fshanhuan/Rsic-v-IM/syn/上板改造说明.md

# v9 上板改造说明（可综合化 / 时序 / 约束）

> 本文档面向「把 v9 真正放到 FPGA 板上跑起来」这一目标。
>
> **状态更新（本次改造后）**：P0 存储时序、P1 时序化 MDU 接入、P2 复位同步释放、
> P3 程序载入、P4 上板可观测性 **都已在 RTL 与 `board/` 里落地**，
> 并用 `sim/` 的 iverilog 回归（`prog` 35/35、`prog_mul` 34/34、`prog_div` 34/34，
> 加 `+no_wbu_force +raw_rf` 同样全过）+ D-Cache 单元测试作为护栏。
> 逐模块 I/O、关键信号与改造清单见 [`../docs/模块说明.md`](../docs/模块说明.md)。
> **仍未完成（本机无条件）**：真实综合/实现（LUT/FF/BRAM/DSP、WNS/TNS/Fmax）、
> BRAM IP 推断、板级实测、以及原 `cdp-tests` 的 47 条全指令表 difftest（缺 verilator/make）。
> 本文 §1 保留改造前的实测数据与踩坑记录，§3 每节都标了现在的状态。

---

## 1. 已完成的改造

### 1.1 综合与时序瓶颈定位

原 `v9/rtl/MDU.sv` 把 RV32M 的乘除法全部实现为**单拍纯组合**逻辑：

- 乘法：3 个 32×32 乘法器各自展开；
- 除法：32 级「左移-试减-回写」恢复余数法组合链。

实测（Yosys + Xilinx 7 系列映射，见 `syn/synth_report.md`）：

| 实现 | LC 估算 | CARRY4 | DSP48E1 | FF |
| --- | --- | --- | --- | --- |
| 原组合版 MDU | **2150** | **419** | 12 | 0 |
| 时序化版 MDU（`experimental/MDU_pipelined.sv`） | **407** | **81** | 12 | 235 |

也就是说：**只改 MDU 一个模块，就把它的逻辑规模压到约 1/5，进位链长度压到约 1/5**。
这是整机时序收敛里性价比最高的一刀。

### 1.2 已交付的工程件

| 文件 | 作用 |
| --- | --- |
| `syn/synth_core.ys` | 厂商无关综合 + 资源报告脚本（Yosys），一条命令出数 |
| `syn/v9.xdc` | Vivado 时序约束模板（主时钟 20ns=50MHz / 复位 / 调试口） |
| `syn/v9.sdc` | 通用 SDC 约束模板（Quartus 等），与 xdc 同为 20ns=50MHz |
| `syn/timing_sweep.tcl` | 时钟周期扫描脚本，用于测出「实际能跑到多少 MHz」 |
| `syn/vivado_50mhz_实测.md` | **Vivado 2025.2 真实综合/实现实测**（资源、WNS、踩坑记录） |
| `syn/ila_使用说明.md` | **ILA 上板调试方案**：EES-331 引脚表、13 根探针、Hardware Manager 用法、实测坑记录 |
| `syn/工程打开是黑的_排查与正确用法.md` | **为什么工程在 GUI 里是灰的**：工程模式 / 非工程模式混用的后果，以及正确用法 |
| `syn/上板验证判据.md` | **上板时怎么判定"正常"**：`prog.hex` 14 条指令的预期写回值表、LED 心跳灯判读、四个单点必查、症状 → 根因速查 |
| `board/board_top_vivado.sv` | Vivado 顶层外壳（引脚引出方案，**已废弃**）：4 个 32 位计数器截成 8 位，省 96 个引脚 |
| `board/board_top_ila.sv` | 上板顶层（MMCM 100→50MHz + CPU + 存储器），引出 3 个引脚和 13 个调试口 |
| `E:\FPGA\v9_vivado_ila\project_src\board_top_gui.sv` | **工程模式顶层**：例化 `board_top_ila` + 标准 ILA IP `u_ila_0` |
| `syn/synth_report.md` | 实测资源报告（本机 Yosys 输出） |
| `experimental/MDU_pipelined.sv` | 时序化 MDU（模块级 4968 向量已验证，**已接入 `EXU`**） |
| `board/sync_mem.sv` / `board/reset_sync.sv` / `board/board_top.sv` | 同步 BRAM 模型（1 拍读延迟）、复位同步释放、上板顶层 |
| `sim/` | 自包含 iverilog 测试台 + 三个程序 + 单元测试（本机唯一可跑的回归） |
| `docs/模块阅读文档.md` | 逐模块 I/O / 关键信号 / 模块间联系 / 改造清单 |

### 1.3 一个已知的仿真陷阱（已在本工程中踩到并修复）

原 `rtl/MDU.sv` 中若写成「在同一个 `always_ff` 里先给 `op_a` 赋值、再用
`op_a` 派生出的连线去装载另一个寄存器」：

```systemverilog
op_a <= d1;
r_rem <= a_abs;      // a_abs = f(op_a) —— 这里读到的是 op_a 的旧值！
```

综合结果本身没错（工具会正确解析），但**仿真会静默出错**。
凡是「同一个时序块内，用刚被赋值的寄存器去驱动另一个寄存器」，都必须改成
直接用输入端口或重新计算。这一条在后续任何改造里都要留意。

---

## 2. 实测综合数据（本机复现）

环境：Yosys 0.33（Ubuntu 包，无需 root，`apt-get download yosys yosys-abc` 解包即可），
映射目标 `synth_xilinx -family xc7`，**未使用器件专用 BRAM/DSP 推断选项**。

```
v9 整机（myCPU，xc7 代表工艺）
  LUT      : 8218
  MUXF7/8  : 1463
  FF       : 5589
  CARRY4   : 521
  DSP48E1  : 12
  RAM 原语 : 128
```

> 说明：这些是**厂商无关的规模估算**，不等于 Vivado/Quartus 的最终数字
> （真实工具会做 BRAM/DSP 推断与更好的资源共享，数字通常更小）。
> 它的价值在于：**可复现、可对比**，用于判断一次 RTL 改动是让设计变大还是变小。

`CARRY4 = 521` 与 `DSP48E1 = 12` 提示两个方向：
- 进位链数量偏高，主要来自 IDU 的立即数/地址加法与 CSR 比较；
- 12 个 DSP 来自 MDU 的 3 个 32×32 乘法器（每个约占 3~4 个 DSP48）。

---

## 3. 上板待办清单（按优先级）

### P0：存储时序（最大的拦路虎）—— **已完成**

**改造前现状**：整机的 IROM 与 DRAM 都假设**零延迟组合读**。

- `rtl/ICache.sv` / `rtl/DCache.sv` 在 miss 时直接「旁路」外部读数据：
  ```systemverilog
  assign cpu_rdata = hit ? data[index] : mem_rdata;   // 假设 mem_rdata 同拍有效
  ```
- `mySoC/miniRV_SoC.v` 里 `IROM` 是 `$readmemh` 组合 ROM，`dram_driver.sv`
  也是组合读。
- `IFU` 的 `valid` 恒为 1，没有任何「等存储」的暂停通路。

**为什么上板必炸**：FPGA 的 Block RAM 是**同步读**（地址打一拍、数据下一拍才出），
分布式 RAM 也至少一拍。也就是说真实存储器不可能同拍返回数据。

**改造完成情况**（对照原步骤）：

1. ✅ `ICache`/`DCache` 改成**同步读握手**：
   - `ICache`：`resp_valid_r`（响应有效）`addr_same_r`（地址仍是当前请求）
     `fetch_align`（本拍返回结果是否属于当前请求）`hold = ~fetch_align | miss`；
   - `DCache`：同样握手 + store 请求寄存成**单拍写脉冲**（一次 store 只写一次，
     否则同步 DRAM 保持使能多拍会重复写）+ MMIO/uncacheable 地址**不经缓存直通**
     （否则读不到外设副作用、写不进外设）；
   - 未命中时返回 `` `NOP `` 并拉高 `hold`，前端/LSU 停拍重试。
2. ✅ miss/hold 引出为暂停请求并**合并**：
   - `myCPU.IFU_stall = IFU_stall_ctrl | icache_hold | dcache_hold`（冻 PC 与 IDU）；
   - `myCPU.IFU_mem_stall = icache_hold | dcache_hold`（参与 `IFU.valid` 与 `EXU_inst_clear`）；
   - `LSU.lsu_freeze = mem_hold | mdu_busy`（整条访存流水**同步冻结**，否则
     `mem_ren_reg_pipe` 会被推走、`DCache.cpu_en` 组合来源随之变化，hold 自己把自己解掉）。
3. ✅ `board/sync_mem.sv` 提供一拍读延迟的同步 BRAM 行为模型，`board_top.sv` 用它
   例化 IROM/DRAM；上板时替换成 `xpm_memory_*`/IP 即可。
4. ✅ 护栏换成 `sim/` 的 iverilog 回归（47 条 difftest 需要 verilator/make，本机没有）。

**改造中暴露并修掉的 4 个真实 RTL 缺陷**（都是"仿真-friendly 假设"的产物，2 态工具看不到）：

| # | 现象 | 根因 | 修法 |
|---|---|---|---|
| 1 | `lw` 后紧跟的 `add` 得到 `0x1005`（= 地址 + 5） | EXU 级若是 load，`EX_result` 是**地址**；`Data_hazard.exu_hit` 只看 `R_Wen`/`rd` 且优先级最高 | `exu_hit` 加 `~EXU_mem_ren`；load 的数据只在 LSU **第三级**（`forward_val_wb`）才是数据 |
| 2 | 第一次重定向后整机死循环（`ecall` 永远到不了 WB） | `bp_mispredict` 是电平信号，EXU 被存储 hold 冻住时会**连环重定向**；且 EXU 的 `valid` 与控制寄存器是两个 `always_ff`，`valid=0` 时残留的 `jump_flag/pred_*` 还在产生重定向 | 加 `bp_redirect_pending` 做**一次性脉冲**；控制事实全部用 `EXU_valid` 限定 |
| 3 | `ecall` 不产生异常（`mepc/mcause` 恒 0） | `EXU_inst_clear` 里含 `system_redirect`，会在 `ecall` 被收下的同一拍把它的 `csr_wen` 清 0 | 从 `EXU_inst_clear` 去掉 `system_redirect`：ecall/mret/fence.i 必须自己流到 WB，只冲掉排在它们**后面**的错路径指令（由 `dnpc_flag`→IDU `flush` 完成） |
| 4 | `add x7,x6,x2` 算出正确的 `0x11` 却写不进 x7 | EXU 的 `valid_next` 在**下游未就绪**（`~ready_next`，即 `lsu_freeze`）那一拍走了最后的 `else` 被清 0，而数据/控制寄存器是冻结保持的 → 指令带着 `valid=0` 进 LSU，写回被 `WBU.R_wen_next = R_wen_reg & valid_reg` 掐掉 | `valid_next` 更新条件里把 `mdu_stall` 改成 `mdu_stall | ~ready_next`（与数据寄存器同口径冻结） |

> 另修两个"4 态仿真才暴露"的问题：`myCPU` 里 `WBU` 的 `.stall` **悬空**
> （`z` → `if(!stall)` 判成 x → 写回永不发生）、`RegisterFile` **没有复位分支**
> （`rf[0]`(x0) 初值为 `x`）。

### P1：把时序化 MDU 接入整机 —— **已完成**

`experimental/MDU_pipelined.sv` 已通过 **4968 条向量**的模块级验证
（边界值 968 条 + 随机 4000 条，覆盖除零、INT_MIN/-1 溢出、符号回正），
并且**已经接到 `EXU` 里**（`alu_opcode_reg[4]` 选择 `mdu_res_reg`）。
实测：`prog_mul`（8 次乘法）与 `prog_div`（4 次除法）在 iverilog 回归里全过 ——
乘法 1 拍完成、`stall=0`；除法多拍由 `mdu_busy` 冻结前端与访存流水。

接入时的关键（本工程实测踩过的坑）：

- **乘法路径天然对齐**：单拍完成，与 ALU 结果同拍，不需要暂停。
- **除法路径需要三件事同时做**，缺一就会出现
  「`debug_wb_pc` 正确但 `debug_wb_value` 慢一拍 / 错位 / 为 0」：
  1. `EXU` 在 `mdu_busy` 期间**冻结自身寄存器**（含 `valid`）；
  2. `LSU` 流水寄存器在 `mdu_busy` 期间**同步冻结**（否则会把 EXU 保持的
     陈旧值一级级推下去）；
  3. `EXU.valid_next` 只在**结果窗口**（`mdu_done`）那一拍放行，且该分支必须
     放在 `always_ff` 的**最前面** —— 因为 `mdu_busy` 期间 `exu_ready` 恒为 0，
     放在后面会被 `EXU_inst_clear` 分支挡住，导致 valid 永远为 0（整机卡死）。
- `Control` 中需要把 `mdu_busy` 并入 `IFU_stall`，并在忙期间屏蔽分支/跳转判定
  （此时 EX 级寄存的是刚发射的 M 指令，其残留标志不可信）。
- ⚠️ 本次补充：`mdu_busy` 只能并进 `IFU_stall`，**不能**并进给 IDU 灌气泡的那一路
  （`load_use_stall`）——后者会打断 M 指令自己的向后 `valid`，乘除结果直接丢失
  （实测 `prog_mul` 从全过变成 1 处不符）。

### P2：复位与时钟 —— **代码已就绪**

**现状**：所有模块使用 `always_ff @(posedge clock) if (reset) ...` 的**同步复位**。
对 FPGA 来说这是好习惯，但需要确认：

- 板卡按键复位是异步的 → 必须**先同步释放**（推荐「异步置位、同步释放」两级同步器），
  否则会出现跨时钟/亚稳态与部分寄存器先复位的问题；
  ✅ 已提供 `board/reset_sync.sv`（`rst_n_async` → `rst_sync`），`board_top` 已例化。
- 若使用全局复位网络，注意复位树 fanout 与布线资源。

**时钟**：整机单时钟域即可，无需跨时钟域处理。上板建议先从 **50MHz** 起，
确认功能后按 `syn/timing_sweep.tcl` 逐步收紧到 100/150MHz。
（本机无 Vivado/yosys，实际 WNS/Fmax 需要你在有工具的机器上测。）

> **已实测（Vivado 2025.2 / xc7z020clg484-1）**：
> - 引脚引出方案（已废弃，工程已删）：`WNS = +5.283ns`、失败端点 0，**Fmax ≈ 67.95MHz**。
> - **当前 ILA 方案**（工程 `E:\FPGA\v9_vivado_ila\v9_ila\v9_ila.xpr`）：
>   `WNS = +4.162ns`、`WHS = +0.011ns`、失败端点 **0 / 27564**，
>   **Fmax ≈ 63.14MHz**（ILA 要采样 288 位调试总线，比无 ILA 版低约 4.8MHz）。
>   50MHz 下余量 4.162ns / 20ns ≈ **26%**。
> - 100MHz 目前收敛不了（存在 >10ns 组合通路，且瓶颈是布线不是逻辑）。
>
> 详见 [`ila_使用说明.md`](../docs/vivado/ila_使用说明.md) §7（当前方案）；
> 引脚方案的历史数据见 [`vivado_50mhz_实测.md`](../docs/vivado/vivado_50mhz_实测.md)。

### P3：启动与程序加载 —— **代码已就绪**

**现状**：程序由 `$readmemh`/`meminit.bin` 在仿真开始时塞进 RAM。

**上板方案**：
- ✅ 最小方案已实现：`board/sync_mem.sv` 支持 `$readmemh` 初值（`board_top` 里对
  IROM/DRAM 各传一个 hex），Vivado 会把 `initial` 推断成 BRAM 初值，复位后从 0 起跑；
  本机回归用的程序就是 `sim/prog*.hex`。
- ⏳ 进阶方案（未做）：Boot ROM + UART 下载器 / SPI Flash 启动，实现在板更新程序。

### P4：可观测性（上板替代波形）—— **骨架已就绪**

仿真里靠 VCD 看结果，上板必须换成：

- ✅ `board_top.sv` 已经把 `debug_wb_have_inst/debug_wb_pc/debug_wb_ena/debug_wb_reg/
  debug_wb_value` 以及 `debug_icache_hit_cnt/miss_cnt`、`debug_dcache_hit_cnt/miss_cnt`
  引出到端口，直接接 7 段数码管/LED 即可；
- ⏳ 未做：具体板卡的 7 段译码模块与 UART 打印模块（需要按板卡引脚写，属于工程层）。

### P5：Cache 一致性策略复核 —— **维持现状（单核无问题）**

`DCache` 目前是**写直达 + 写不分配**，并且对 MMIO/uncacheable 区间**直通不缓存**。
上板后若加入 DMA/多主设备，需要重新评估一致性；当前单核场景没问题。

---

## 4. 建议的实施顺序（状态对照）

```
[已完成] 基线回归（原始 v9 在作者机器上 47/47；本机无 verilator/make，见下方说明）
[已完成] 综合脚本 + 约束模板 + 资源报告
[已完成] 时序化 MDU 模块级验证（4968 向量）
   ↓
1. [已完成] 同步 BRAM 化：ICache/DCache + board/sync_mem.sv，护栏用 sim/ 的 iverilog 回归
2. [已完成] 接入时序化 MDU 的乘法路径（单拍，无侵入）
3. [已完成] 接入除法多周期握手（按 §3 P1 三条），prog_mul/prog_div 全过
4. [部分完成] 板级工程：board/ 的复位同步器 + 调试观测口已就绪；
   引脚约束、数码管/UART 需要按你的板卡补
5. [待你在有工具链的机器上做] 时序收敛：50MHz → 100MHz → 150MHz，记录 WNS 与资源
6. [待补] cdp-tests 47 条全指令表 difftest（本机缺 verilator + make）
```

本机实际跑到的验证（可复现，命令在 `sim/README_iverilog.md`）：

```
[prog]     PASS 35/35     (算术 / mul / store+load / load-use 冒险 / 分支 / jal / ecall)
[prog_mul] PASS 34/34     (8 次乘法)
[prog_div] PASS 34/34     (4 次除法，MDU 多拍)
加 +no_wbu_force +raw_rf（不用测试台兜底）→ 同样 103/103 全过
tb_dcache_unit: miss->fill / 二次命中 / MMIO 不缓存 / 外设副作用  全 PASS
```
