fshanhuan/Rsic-v-IM/v9/docs/README.md

# v9 文档索引

上板改造后的 v9，文档按"**先读结论、再读模块、最后读实现细节**"组织：

| # | 文档 | 讲什么 | 什么时候看 |
| --- | --- | --- | --- |
| 1 | [`模块阅读文档.md`](./模块阅读文档.md) | **主文档**：按流水级组织的模块说明（每个模块的输入表/输出表、它在做什么、关键信号作用、关键代码、与其他模块的联系）+ 上板改造的三个必知机制 + 典型指令走查 + 验证方法 + 已知限制 + 一页速查 | 想搞清"这颗 CPU 长什么样、某个信号是干什么的"时 |
| 2 | [`../syn/上板改造说明.md`](../syn/上板改造说明.md) | 上板障碍清单（P0~P5）、每个障碍的**改造前后对照**、改造中暴露并修掉的 6 个 RTL 缺陷、本机做不到的部分 | 想知道"为什么这么改、改完还差什么"时 |
| 3 | [`../CPU设计说明.pdf`](../CPU设计说明.pdf) | 改造**之前**的设计说明（含数据通路图、立即数生成、扩展建议） | 想看原始设计意图时（其中 ICache/DCache 的组合读写法已过时，以主文档为准） |
| 4 | [`../syn/synth_report.md`](../syn/synth_report.md) | Yosys 实测资源报告（MDU 组合版 vs 流水版的 LC/CARRY4/DSP） | 关心面积/时序瓶颈时 |
| 5 | [`../sim/README_iverilog.md`](../sim/README_iverilog.md) | 本机 iverilog 测试台怎么用、plusargs 有哪些、程序期望表 | 要跑回归时 |
| 6 | [`../experimental/README.md`](../experimental/README.md) | 流水化 MDU 的验证情况（4968 条向量） | 要动乘除时 |
| 7 | [`../README.md`](../README.md) | 工程总览、目录、验证命令、波形 | 第一次打开工程时 |
| 8 | `../改动diff_接管前快照_vs_上板改造后.txt`（打包版在 zip 内） | 逐行改动对照（基线 = 改造开始时的快照） | 想知道"到底改了哪几行"时 |

## 推荐阅读顺序

1. 本工程 `README.md`（3 分钟建立全局印象）；
2. `模块阅读文档.md` §0 一页速查 → §1 的 **4 条握手约定**（不读这个直接看代码容易踩坑）；
3. §2~§8 按 `myCPU → 取指 → 译码 → 执行 → 访存 → 写回 → 冒险处理` 顺序看模块；
4. §9 上板改造的三个机制（load 数据只在 M3 可前递 / 重定向要一次性 / 不能靠拉低 valid 挡指令）；
5. §10 典型指令走查（含 load-use 冒险的逐拍波形）；
6. `syn/上板改造说明.md` 看"改了什么、为什么、还差什么"；
7. 要上手改代码就看 §4 改动清单，再对着 `改动diff` 逐行确认。

## 约定

- **命名风格一律不改**：模块名、信号名、`_next`/`_last` 后缀、`valid`/`ready` 语义都保持原样；
  改造新增的端口/信号（如 `load_use_stall`、`EXU_ctrl_valid`、`bp_redirect_pending`、
  `fetch_align`、`hold`）都带中文注释说明用途。
- **两份说明文档的分工**：`CPU设计说明.pdf` = 改造前；`模块阅读文档.md` = 改造后（权威）。
  两者冲突时以 `模块阅读文档.md` 为准。
- 所有通道（VCD、SVG 时序图）都是**改造后**重新生成的；历史调试波形已清理。
