fshanhuan/Rsic-v-IM/验证报告_独立复核.md

# v9 上板改造交付版 · 独立验证报告

> 验证人：独立复核（非交付方）
> 日期：2026-10-06
> 对象：`v9_上板改造_交付版`（RV32IM 教学核 + 上板改造）
> 结论一句话：**官方回归能复现通过，但它覆盖不到关键路径；独立差分测试发现 4 类真实功能缺陷，且交付文档中若干"PASS"声明与实测不符。**
>
> **更新（同日）**：上述缺陷**已全部修复**，并修掉了修复过程中暴露出的另外 3 个缺陷与
> 3 处验证基础设施缺陷。修复后的验收结果见 [§9 修复记录](#9-修复记录第二轮按验收门禁逐项修)：
> **官方回归 15 项全过 / 单轮 239 项检查、板级自检 33/33 PASS、差分测试 60/60、
> 交叉验证 0 处不一致**。第二轮的 7 个缺陷里，有 3 个（B1/B2/B3）在修复后的
> 自带回归中有了**新的定向程序**（`prog_load_lane`/`prog_load_use`/`prog_loop`/`prog_div_pair`），
> 它们在被修之前是必然失败的。

---

## 0. 结论摘要

| # | 项目 | 交付方声明 | 独立验证结果 |
| --- | --- | --- | --- |
| 1 | `bash sim/run_all.sh` | 7 项全过 / 103/103 | ✅ **复现通过**（7 项，正常+严格模式） |
| 2 | 字节/半字访存（`lb/lh/lbu/lhu`） | 回归覆盖 | ❌ **缺陷 B1**：load 的字节偏移被完全丢弃 |
| 3 | load 数据通路 | 回归覆盖 | ❌ **缺陷 B2**：前一条不是访存指令时，load 取到陈旧值/0；真实 BRAM 上变 `x` |
| 4 | RV32M 除法 | 模块级 4968 向量 + 整机回归通过 | ❌ **缺陷 B3**：多拍 `div/rem` 结果与 rd 错位 |
| 5 | 分支预测 / 重定向 | 回归通过 | ❌ **缺陷 B4**：取指 hold 撞上分支判定拍时，taken 分支的误预测被静默屏蔽，**循环提前退出** |
| 6 | `board/tb_board_top.sv` 冒烟 | `README.md:90/108` 写 PASS | ❌ **实测 FAIL（退出码 1）**，3 次运行结果字节一致 |
| 7 | `syn/` 综合脚本可用 | 报告 + 脚本齐备 | ❌ `synth_core.ys` 无法 elaborate（读 `MDU.sv` 而非 `MDU_pipelined.sv`）；`board/*.sv` 从未被任何综合脚本读过 |
| 8 | 约束文件 | XDC/SDC 模板 | ❌ 端口名 `fpga_clk/fpga_rst` 在全部 `*.sv` 中零命中；三处时钟周期互相矛盾 |
| 9 | 板级实测 | 自述"未做" | ✅ 一致：确实没有比特流/综合产物 |
| 10 | 回归第 7 项：D-Cache 单元测试 | 全 PASS | ❌ 该测试**无 `$fatal`**、退出码恒 0，**不可能失败**；且其中一次 store 都未执行（§2.5 V1） |
| 11 | CI 护栏（"每次 push/PR 都跑"） | 自动回归 | ⚠️ 整机回归确实跑，但**板级测试台只编译、从不运行**（`ci.yml:70-79` 无 `vvp`）→ 它 FAIL 也不会被发现（§2.5 V2） |

**没有发现问题的部分**（这些声明可信，见 §4）：官方回归本身可复现；`sb/sh/sw` 写掩码正确；1 拍 `mul/mulh/mulhu/mulhsu` 正确；前向分支/`jal/jalr`/`auipc`/移位/`x0` 恒零正确；`board/sync_mem.sv`、`board/reset_sync.sv` 行为正确。

---

## 1. 验证方法（先说清可信度从哪来）

### 1.1 环境：本机原本没有**免费/开源** EDA 工具

`iverilog / vvp / yosys / verilator` 在 `C:`、`D:`、`E:` 全盘搜索**零命中**；WSL 里 `sudo` 需要密码。

> 第三轮补充更正：本机其实装有商用 **ModelSim SE-64 10.5**（`E:\FPGA\ModelSim_10.5se`）。
> 前两轮只用了 iverilog；第三轮把它接进来后，**立刻发现 7 处 iverilog 全部放过的问题**（见 §10）。

故采用**非 root 安装**（不改动系统、不污染交付目录）：

```bash
# WSL Ubuntu 24.04，x86_64
apt-get download iverilog                       # 非 root 可下载到当前目录
dpkg -x iverilog_12.0-2build2_amd64.deb $HOME/ivlocal
ln -s ../lib/x86_64-linux-gnu/ivl $HOME/ivlocal/usr/x86_64-linux-gnu/ivl   # 补 FHS 路径
export PATH="$HOME/ivlocal/usr/bin:$PATH"
export LD_LIBRARY_PATH="$HOME/ivlocal/usr/lib/x86_64-linux-gnu:$LD_LIBRARY_PATH"
```
得到 `Icarus Verilog version 12.0`。所有仿真都在 `$HOME/` 下的**副本**里跑（交付目录零改动，`git status` 只多出我新增的 `.verify/`）。

### 1.2 三层验证，互相独立

| 层 | 做法 | 目的 |
| --- | --- | --- |
| L1 | 原样复跑 `v9/sim/run_all.sh` | 确认交付方自己的结论可复现 |
| L2 | **自建差分测试**：自写 RV32IM 汇编器 + 独立参考模型 + 自建测试台，逐寄存器/逐内存字比对 | 抓 L1 覆盖不到的行为 |
| L3 | **交叉验证**：把同一批程序喂给**项目自带**的 `tb_iverilog.sv`，看错值是否复现 | 排除"是我的测试台有问题" |
| L4 | **第二仿真器**：同一批程序再喂给商用 ModelSim SE，两个仿真器的 dump 逐字节比对（见 §10） | 排除"结论只是 iverilog 特有的语义解释"；并用严格工具的编译期检查兜底 |

L2 的独立实现要点（也是它为什么能抓到问题）：

- **参考模型**（`.verify/difftest/rv32.py`）：按 RISC-V 手册独立实现 RV32IM 语义（含除零 → 商 `0xFFFFFFFF`、`INT_MIN/-1` → 商 `INT_MIN`/余 0 等边界），按字节小端寻址，与 RTL 的 `addr[15:2]`/`addr[1:0]` 解码等价。
- **汇编器**（两遍、支持 label）：已用工程里**人工核对过**的 `sim/prog.hex` 逐条校准 —— `lui/addi/add/mul/sw/lw/beq/jal/ori/ecall` 14 条编码**全部一致**，避免"我方编码错误"造成假阳。
- **结束条件**：不用 `ecall`（`ecall` 会把 PC 重定向到 `mtvec=0`=程序入口，程序会重跑；自带测试台靠"ecall 进 ID 后再等 8 拍"取快照，排空窗口是否够取决于 ecall 前那条指令的深度，**本身有截断风险**）。改为程序末尾一条 **magic store**（`sw` 到 `0x3FFC`，值 `0x123`）报完工，后接 `jal x0,0` 自跳（只写 `x0`，架构状态从此冻结）；测试台在总线上看到这笔写后再跑 60 拍，然后导出 **32 个 GPR + 全部非零内存字**（用 `!==` 判断，X 传播不会被漏掉）。
- **用例**：17 个定向（含最小化用例）+ N 个随机（带依赖偏置、前向跳转保证终止、指针寄存器隔离保证地址落在安全窗口）。

L3 的关键对照：**`mulchain`（连续 8 条 1 拍 `mul`）在两套测试台上都 PASS** —— 说明方法本身不是"什么都判失败"。

### 1.3 复现命令

```bash
# 生成 + 跑差分测试（N 为随机用例数）
bash .verify/difftest/run.sh 40
# 只跑指定前缀的用例
bash .verify/difftest/run.sh 0 lane
# 交叉验证：同一批程序在项目自带 tb_iverilog.sv 上跑
bash .verify/difftest/crosscheck.sh
# 逐拍 PC/重定向轨迹（定位缺陷 B4 用的）
bash .verify/difftest/trace.sh 55
```

---

## 2. 缺陷清单

### B1 · 字节/半字 load 完全忽略地址偏移（确定性、100% 复现）

**现象**：`lb/lh/lbu/lhu` 永远返回**字内偏移 0** 的那一（半）字节，`addr[1:0]` 被丢弃。

**最小复现**（定向用例 `lane_min`，`.verify/difftest/gen.py`）：

```asm
li  x1, 0x2000
li  x2, 0xDDCCBBAA
sw  x2, 0(x1)        # 内存字 0x2000 = 0xDDCCBBAA
lb  x3, 0(x1)   # 期望 0xFFFFFFAA   实测 0xFFFFFFAA  ✓
lb  x4, 1(x1)   # 期望 0xFFFFFFBB   实测 0xFFFFFFAA  ✗
lb  x5, 2(x1)   # 期望 0xFFFFFFCC   实测 0xFFFFFFAA  ✗
lb  x6, 3(x1)   # 期望 0xFFFFFFDD   实测 0xFFFFFFAA  ✗
lbu x7, 3(x1)   # 期望 0x000000DD   实测 0x000000AA  ✗
lbu x8, 1(x1)   # 期望 0x000000BB   实测 0x000000AA  ✗
lh  x9, 0(x1)   # 期望 0xFFFFBBAA   实测 0xFFFFBBAA  ✓
lh  x10,2(x1)   # 期望 0xFFFFDDCC   实测 0xFFFFBBAA  ✗
lhu x11,2(x1)   # 期望 0x0000DDCC   实测 0x0000BBAA  ✗
lw  x13,0(x1)   # 期望 0xDDCCBBAA   实测 0xDDCCBBAA  ✓
```

原始输出（我的测试台）：

```
FAIL lane_min  (7 处不一致, magic_cyc=108 total_cyc=167)
   x4 (tp  ): rtl=ffffffaa ref=ffffffbb
   x5 (t0  ): rtl=ffffffaa ref=ffffffcc
   x6 (t1  ): rtl=ffffffaa ref=ffffffdd
   x7 (t2  ): rtl=000000aa ref=000000dd
   x8 (s0  ): rtl=000000aa ref=000000bb
   x10(a0  ): rtl=ffffbbaa ref=ffffddcc
   x11(a1  ): rtl=0000bbaa ref=0000ddcc
```

**L3 交叉验证**（项目自带 `tb_iverilog.sv`，同一程序）：`x4=ffffffaa / x5=ffffffaa / x6=ffffffaa / x7=000000aa / x8=000000aa / x10=ffffbbaa / x11=0000bbaa` —— **错值逐位一致**。

**根因（代码级，`v9/LSU.sv`）**：
```verilog
LSU.sv:287   assign rdata_8u  = {24'd0, rdata[7:0]};        // 固定取第 0 字节
LSU.sv:288   assign rdata_16u = {16'd0, rdata[15:0]};       // 固定取低半字
LSU.sv:295-297  sext_i8  (.data(rdata[0+:8]),  ...)         // 同样只看 bit[7:0]
LSU.sv:303-305  sext_i16 (.data(rdata[0+:16]), ...)
LSU.sv:307-337  写回前 res2 级同样只用 rdata_reg2[7:0]/[15:0]，按 funct3 选择
```
**整条读回路径从未使用 `Ex_result_addr_reg_pipe[1:0]`（字节偏移）**。对比之下：写路径的偏移是正确的（`DCache.sv:259-266` 按 `store2_offset` 选道，`d_storelane` 用例全部 PASS），所以这是**只存在于 load 侧**的缺陷。
另外 `tb_iverilog.sv:96-98` 的注释明确写着"读口返回**原始整字**：字节/半字的抽取由 LSU 在写回前按 funct3 完成" —— 即改造后由 LSU 负责抽取，但 LSU 只按 `funct3` 抽取、没有按偏移移位，**偏移这一环在改造中丢了**。

**为什么原回归没抓到**：`prog_mul.hex`(15 行)、`prog_div.hex`(11 行) **完全没有访存指令**；`prog.hex` 只有 1 条 load，且 `lw`/`sw` 都是字对齐、偏移 0，恰好落在唯一正确的情形上。

**修复方向**：在 LSU 抽取前按偏移移位，例如 `rdata_8u = {24'd0, rdata_shifted[7:0]}`，其中 `rdata_shifted = rdata >> (8*addr[1:0])`（半字用 `addr[1]`）；`reg2` 级需把偏移随流水一起带过去（或在 DCache 返回前完成对齐）。

---

### B2 · load 的读回时序 off-by-one：前一条不是访存指令时取到陈旧值/0

**现象**：紧跟在**非访存指令**（或首条访存指令）之后的 load，拿到的是"上一次总线读的残留值"或 0；紧跟另一条访存指令的 load 反而正确（因为 `hold` 恰好把它多停了一拍）。

**最小复现**（定向用例 `loaduse`）：
```asm
li  x1, 0x2400
li  x2, 0x11223344
sw  x2, 0(x1)
lw  x3, 0(x1)     # 期望 0x11223344  实测 0x11223344 ✓（前面是 sw → hold 生效）
add x4, x3, x2    ✓
sub x5, x4, x3    ✓
lbu x6, 0(x1)     # 期望 0x44        实测 0x00000000 ✗（前面是 ALU → hold 不生效）
lh  x8, 2(x1)     # 期望 0x1122      实测 0x00000000 ✗
lw  x10, 0(x1)    # 期望 0x11223344  实测 0x00000000 ✗（x10 错 → 后续 beq 走错路）
```

原始输出：
```
FAIL loaduse  (10 处不一致, magic_cyc=150 total_cyc=209)
   x6 (t1  ): rtl=00000000 ref=00000044
   x8 (s0  ): rtl=00000000 ref=00001122
   x10(a0  ): rtl=00000000 ref=11223344
   x12(a2  ): rtl=00000bad ref=00000000   ← 由 x10 引出的控制流分歧（下游现象）
   ...
```
**L3**：自带测试台上 `x6=00000000 / x8=00000000 / x10=00000000 / x12=00000bad` —— 完全一致。

**另一条独立证据**（`storeload` 用例）：`lw x10, -4(x1)` 读到**另一个地址**的数据（`0x11223344`，即上一次总线读的返回值），期望为 0：
```
FAIL storeload  (2 处不一致)
   x8 (s0  ): rtl=11223344 ref=22446688    ← 连续两条同址 load，其中一条拿到 0
   x10(a0  ): rtl=11223344 ref=00000000    ← 读到上一条 load 的残留数据
```

**根因（代码级）**：
```verilog
DCache.sv:134   assign mem_en = cache_rd_req;
DCache.sv:156   assign hold   = resp_valid_r & ~cpu_wen_r & ~hit & (~mem_req_r | cache_rd_req);
```
`hold` 在**发出读的那一拍恰好为 0**（`cache_rd_req=1` 时靠 `| cache_rd_req` 把 `hold` 解除），于是 LSU 被放行、在数据还没回来的那一拍就把 `rdata` 采进 `rdata_reg2`（`LSU.sv:243 rdata_reg2 <= rdata`）；真正的数据下一拍才到，却落在一个 `valid=0` 的气泡上。
逐拍探针（板级审计独立复现，`lw x6,0(x1)` @`0x1000`）：
```
cyc=56 resp_v=1 cache_rd_req=0 hold=1 mem_en=0 BRAM rdata=xxxxxxxx
cyc=57 resp_v=0 cache_rd_req=1 hold=0 mem_en=1             ← LSU 被放行，采走 x
cyc=58 mem_req_r=1 access_en=0 cpu_rdata=0000000c          ← 真数据落到 valid=0 的气泡上
```
**为什么自带测试台"看起来没事"**：`tb_iverilog.sv:131-134` 的 DRAM 读口**没有读使能**（自由运行读，`perip_rdata <= dram[dram_word_addr]` 每拍都更新），恰好掩盖了这个 off-by-one；换成 `board/sync_mem.sv` 这种带 `ren` 的真实 BRAM 语义（`board_top.sv:114` 的接法），同一程序直接从"值错"恶化成 **`x`**：
```
[BOARD-TB] x6 = xxxxxxxx  [FAIL] exp=0000000c
[BOARD-TB] x7 = xxxxxxxx  [FAIL] exp=00000011
```
**影响**：这是**上板阻断级**问题。仿真里表现为"偶发取到 0/旧值"，上板后是 `x` 传播或稳定错值。

**修复方向（已被独立复核用实验验证过）**：`hold` 在"请求已发出、数据尚未返回"的整段都应保持有效。复核子任务把 `DCache.sv:156` 换成下面这版后，**`board/tb_board_top.sv` 从 FAIL 变为 `PASS (33/33)`**，且 `DCache hit/miss = 0/1`（缓存第一次真正发生 miss+回填）：
```verilog
hit_now  = ~uncacheable_req & valid[index] & (tag[index] == tag_in);
resp_now = mem_data_vld & (cpu_index_r == index) & (cpu_tag_r == tag_in);
hold     = (cpu_en & ~cpu_wen) & ~(hit_now | resp_now);
```
反证：只把 `(~mem_req_r | cache_rd_req)` 换成 `~mem_data_vld`（保留 `resp_valid_r` 这一项）**仍然 FAIL** → 说明 `resp_valid_r` 门控本身（使能延迟 2 拍、地址只延迟 1 拍的错拍）才是契约破坏点，不是单个 `|cache_rd_req`。
另需同步修 `tb_iverilog.sv:131-134` 的 DRAM 读口（当前不门控、每拍都读），否则测试台会继续掩盖这条缺陷。

> **补充（另一路独立复核的增量观察）**：B2 至少由两条耦合机制组成，修复时要一起看 ——
> (a) 数据/`valid` 的采样对齐（本节的 `hold` off-by-one）；
> (b) 写回侧的 valid 门控：`WBU.sv:126 R_wen_next = R_wen_reg & valid_reg` 会在 `valid` 掉低的拍把已经算对的 load 结果掐掉。该路复核用 `lw` 冷 miss 用例观测到"数据已在 `cpu_rdata` 上、`hold` 同拍撤销、`WBU_valid` 已为 0"，**仅把 `hold` 延长一拍仍读到 0**；而本报告另一路子任务直接改写 `hold` 判定后 `board` 自检由 FAIL 变 `PASS 33/33`。两条结论并不矛盾（改法不同、观测层次不同），但都指向"load 结果的有效窗口与下游采样窗口没对齐"这一根因，建议按上式的 `hold` 契约 + 写回 valid 通路一起修，并用 `lane_min`/`loaduse`/`storeload` + 板级自检共同验证。

---

### B3 · 多拍 `div/rem` 的结果与目标寄存器错位

**现象**：连续的 M 扩展指令中，**多拍除法/取余**的结果会写到"下一条指令的 rd"上；1 拍乘法不受影响。

**最小复现**（定向用例 `div_min`，操作数刻意取成互不相同以便识别错位）：
```asm
li  x1, 100
li  x2, 7
div x3, x1, x2   # 14
div x4, x1, x2   # 14
rem x5, x1, x2   # 2
divu x6, x1, x2  # 14
mul x7, x1, x2   # 700
div x8, x1, x0   # 除零 -> 0xFFFFFFFF
rem x9, x1, x0   # 100
mul x10, x9, x5  # 200
```
实测（两套测试台一致）：
```
FAIL div_min  (5 处不一致)
   x5 (t0  ): rtl=0000000e ref=00000002      ← 拿到上一条 div 的结果
   x6 (t1  ): rtl=00000002 ref=0000000e      ← 拿到上一条 rem 的结果
   x7 (t2  ): rtl=0000000e ref=000002bc      ← 拿到上一条 divu 的结果
   x8 (s0  ): rtl=000002bc ref=ffffffff      ← 拿到上一条 mul 的结果
   x10(a0  ): rtl=00000064 ref=000000c8
```
`div_edge`（含 `0/0`、`INT_MIN/-1`、除零、`mulh/mulhu/mulhsu` 等边界）同样失败，且**除零语义也不符**（`div x10,x1,x1`（0/0）实测 0，RISC-V 规定 `0xFFFFFFFF`）。

**L3**：自带测试台逐值一致（`x5=0000000e / x6=00000002 / x7=0000000e / x8=000002bc / x10=00000064`）。

**触发条件已最小化定位**（两个对照用例）：
```asm
# div_single：一条 div，后面全是非 M 指令        -> PASS ✓
li  x1,100 ; li x2,7 ; div x3,x1,x2 ; add x4,x0,x3 ; sub x5,x4,x3 ; add x6,x5,x3

# div_pair：两条背靠背 div，操作数/结果都不同     -> FAIL ✗
li  x1,100 ; li x2,7
div x3,x1,x2    # 14
div x4,x2,x2    # 期望 1   实测 0x0e(=上一条 div 的结果)
add x5,x4,x3    # 期望 15  实测 0x1c(被 x4 带偏)
rem x6,x1,x2    # 期望 2   实测 1
add x7,x6,x5    # 期望 17  实测 0x1d
```
```
PASS div_single  (magic_cyc=182 total_cyc=241)
FAIL div_pair  (4 处不一致)
   x4 (tp  ): rtl=0000000e ref=00000001
   x5 (t0  ): rtl=0000001c ref=0000000f
   x6 (t1  ): rtl=00000001 ref=00000002
   x7 (t2  ): rtl=0000001d ref=00000011
```
**结论：单独一条多拍除法是正确的；只要"多拍除法/取余之后紧跟另一条 M 扩展指令"就错位**（1 拍 `mul` 之间不会，见 `mulchain` PASS）。

**为什么原回归没抓到**：`prog_mul.hex` 是 8 条 `mul xN, x2, x3`——**操作数完全相同**（故结果都是 35，且都是 1 拍、不冻结流水）；`prog_div.hex` 是 4 条 `div xN, x1, x2`——**操作数也完全相同**（结果都是 14，错位到哪一条都还是 14）。两种构造都对"结果与 rd 错位"**结构性免疫**。

**根因指向（代码级，`v9/EXU.sv`）**：
```verilog
EXU.sv:130   assign mdu_start = (mdu_state == MDU_IDLE) & alu_opcode_reg[4];
EXU.sv:134   assign mdu_stall = (mdu_state == MDU_WAIT) | (mdu_state == MDU_DONE);
EXU.sv:169-173   MDU_WAIT: if (mdu_done_i) mdu_state <= MDU_DONE;
                 default(MDU_DONE):        mdu_state <= MDU_IDLE;   // 只停一拍
EXU.sv:181   if (mdu_done_i) mdu_res_reg <= mdu_res;                // 结果锁存在共享 latch
EXU.sv:270   assign exec_res = alu_opcode_reg[4] ? mdu_res_reg : alu_res;
```
`MDU_DONE` 只保持一拍，随后回到 `IDLE`；而在 `IDLE` 那一拍 `mdu_stall=0`，EX 的寄存器（含 `alu_opcode_reg`/rd）已经**更新成下一条指令**，但 `exec_res` 仍然选中**上一次锁存的 `mdu_res_reg`**（`EXU.sv:270`）。于是：
- 若下一条是 M 指令：它在 `IDLE` 这一拍把**上一条的结果**当成自己的结果提交（写进自己的 rd），同时 `mdu_start` 又为新的一条重新启动 MDU —— 结果与 rd 从此**错开一条指令**，链越长错得越远；
- 若下一条是非 M 指令（`div_single`）：`alu_opcode_reg[4]=0`，`exec_res` 走 `alu_res`，那条 M 指令的结果已经在下游 payload 里，所以看不出问题。

**修复方向**：`MDU_DONE` 之后不要让上游在"结果仍由共享 latch 提供"的那一拍推进；把结果**在结果窗口随流水 payload 一起寄存**（而不是从 `mdu_res_reg` 这把共享 latch 现取），或让 `mdu_stall` 覆盖 `DONE→IDLE` 的过渡拍，使 `alu_opcode_reg` 与 `mdu_res_reg` 始终属于同一条指令。

---

### B4 · 取指 hold 撞上分支判定拍 → taken 分支的误预测被静默屏蔽（循环提前退出）

**现象**：纯 ALU 的**后向分支循环**跑 2 圈就掉出去（前向分支正常）。

**最小复现**（定向用例 `loop_min`，无访存、无 M 扩展）：
```asm
li  x1, 0        # i
li  x2, 0        # acc
li  x3, 10       # n
top:  addi x1, x1, 1
      add  x2, x2, x1
      blt  x1, x3, top
      add  x4, x1, x2
```
期望 `x1=10, x2=55(0x37)`；实测 `x1=2, x2=3` —— **循环只跑了 2 圈**。
```
FAIL loop_min  (3 处不一致, magic_cyc=75 total_cyc=134)
   x1 (ra  ): rtl=00000002 ref=0000000a
   x2 (sp  ): rtl=00000003 ref=00000037
   x4 (tp  ): rtl=00000005 ref=00000041
```
`loop_bne`（`bne` 倒计数循环）同样只跑 2 圈。**L3** 一致（自带测试台 `x1=00000002 / x2=00000003`）。`fwd_branch`（前向分支）**PASS**。

**逐拍轨迹定位（`trace.sh`，决定性证据）**：
```
TRC 35  IFpc=18 dnpc=0c flg=1 mis=1 raw=1 pend=0 pred=0 expt=0 exptgt=00000000 act=1 bflg=1 exv=1 expc=14 exres0=1 ifstall=0 memstall=0 ich=0
        ← 第 1 次执行 blt：判定跳转、预测不跳 → 正确重定向到 0x0C  ✓
TRC 48  IFpc=1c dnpc=00 flg=0 mis=0 raw=0 pend=0 pred=0              expt=0 exptgt=0000000c act=1 bflg=1 exv=1 expc=14 exres0=1 ifstall=1 memstall=1 ich=1
        ← 第 2 次执行同一条 blt：act=1 而 expt=0（预测不跳）、目标也正确，
          本应重定向，但同一拍 memstall=1 / icache_hold=1 → raw 被屏蔽成 0 → 不重定向
TRC 49  ... exv=0 ...  ← 下一拍 EXU_valid 掉 0，判定机会永久丢失
TRC 50+ IFpc 继续 1c→20→24→28...  ← 沿着错误路径一路走到底
```
**根因（代码级，`v9/Control.sv`）**：
```verilog
Control.sv:107-110
  assign bp_mispredict_raw = EXU_ctrl_valid & ~(intr_take | system_redirect | mem_stall) &
                             ((actual_taken != EXU_pred_taken) ||
                              (actual_taken && (actual_target != EXU_pred_target)));
Control.sv:119-125   bp_redirect_pending 只在 raw 为 0 时清零
```
`~mem_stall` 这一项是为解决"同步 BRAM hold 期间连环重定向死锁"而加的（见该行上方注释），但**代价是：只要取指侧的 hold 在分支判定那一拍恰好有效，这条 taken 分支的误预测就永远检测不到**（因为下一拍 `EXU_valid` 已掉 0，机会不再来）。
而同步 I-Cache 的 `icache_hold` 在整个运行中**大约每隔一拍就会拉高一次**（轨迹里 `ich` 在 `1,0,1,0,…` 之间跳），所以这不是罕见角落，而是**高频**：循环能否继续，取决于分支判定拍是否撞上取指 hold。

**影响**：任何包含"后向分支"的程序都可能**静默算错**（不是崩溃、不是超时，是结果错误）——比死锁更危险。
**量化证据（`SUMMARY` 行，本报告的判定依据）**：
```
SUMMARY 判定为真的拍数=2  真正重定向=1  被 mem_stall 吞掉=1
```
`loop_min` 里那条 `blt` 需要重定向 **2 次**：第 1 次（TRC 35）`memstall=0` → 重定向成功；第 2 次（TRC 48）`act=1 / expt=0 / memstall=1` → 被吞掉，循环随即退出。所以 `x1` 只到 2。

> **关于"探针口径"的重要提醒（避免复核时出现假阴性）**：不能用"`bp_mispredict_raw=1` 却被压成 0"来统计这条缺陷 —— `Control.sv:108` 的 `~mem_stall` 就写在 `raw` 的**连续赋值**里，被屏蔽的那一拍 `raw` **本来就直接是 0**，所以这种探针的计数恒为 0（另一路独立审计用该口径得到"0 例"，即此原因）。
> 正确的观测量是**未屏蔽的判定条件**：`EXU_valid & actual_taken & ~EXU_pred_taken` 为真、而同一拍 `mem_stall=1`。本报告的 `SUMMARY` 就是这么统计的。

**修复方向**：`mem_stall` 期间应**挂起（pending）**误预测判定而不是丢弃，等 hold 结束后再补一次重定向；同时 `bp_redirect_pending` 的清零条件不能与 `raw` 的屏蔽耦合（当前 `raw` 被屏蔽成 0 会被当成"没有误预测"，从而既不重定向也不保留待处理状态）。

---

## 2.5 验证基础设施本身的缺陷（"全绿"为什么仍然会漏）

这一类问题不属于 RTL 功能缺陷，但它决定了"回归通过"能不能当作证据。

### V1 · D-Cache 单元测试**永远无法失败**（已亲自核实）

- `sim/tb_dcache_unit.sv` 全文**没有 `$fatal`**（只有 `:167 $finish`），`nfail` 只在最后被打印；`run_all.sh:67-74` 用 `vvp` 的**退出码**判定，而正常结束恒为 0。→ 把期望值故意改坏，`vvp` 仍 `exit 0`，`run_all.sh` 照样计 PASS。
- `run_all.sh` 输出里那行怪异的 `23228598090284490058663670033758753477459`，就是 `tb_dcache_unit.sv:166` 的
  `$display(nfail == 0 ? "DCACHE-UNIT: PASS" : "DCACHE-UNIT: FAIL");` —— **无格式符**，字符串字面量被当作 136 位整数打印。
  我验证过：`"DCACHE-UNIT: PASS"` 作为 136 位大端整数 **正好等于**该数值。
- 该测试里 `wr_seen=0`：一次 store 都没真正发出（测试台在时钟沿用阻塞赋值驱动 `cpu_en/cpu_wen`，与 DUT 内 `DCache.sv:175 store_fire` 的连续赋值同拍竞争；把 TB 改成沿后 1ns 驱动，`wr_seen=1 data=cafe1234` 即恢复）。另外 `hold`/`miss`/`hit_cnt`/`miss_cnt` 在该 TB 里只连线、从未被任何判据使用。
- **结论**：`run_all.sh` 的"7/7"里，第 7 项对 DCache 的正确性**没有任何约束力**。

### V2 · CI 只"编译"板级测试台，从不运行它（已亲自核实）

`.github/workflows/ci.yml:70-79` 只有 `iverilog -g2012 -o sim/build/tb_board.vvp ... board/tb_board_top.sv`，**没有任何 `vvp` 步骤**；`sim/run_all.sh` 也没有 board 项。→ 这个唯一使用"带读使能的真实 BRAM 语义"的测试台**在 CI 里永远是绿的**，而它现在实际是 FAIL 的。

### V3 · 整机回归里缓存其实没参与

交付回归的统计里 `DCache: hit=0 miss=0` —— 因为 `tb_iverilog.sv:131-134` 的读口不门控，load 基本靠"直通"恰好通过，缓存路径（回填、命中、MMIO 绕过）在整机层面**从未被真正执行**。

### V4 · 额外的模块级缺陷（独立复核子任务实跑复现，我标注了可达性）

| 项 | 现象 | 状态 |
| --- | --- | --- |
| 读响应缺地址跟踪 → **跨地址污染** | `DCache.sv:131-132/139-141/250-254` 只有"发过读"标志 `mem_req_r`，不记录地址；请求 A 在途时地址切到 B，回填会把 **A 的数据写进 B 的行**（`resident(0x1000)=1` 却持有 `0x40` 的数据，两种消费模型都失败） | **模块级已复现**；交付的 3 个程序上未触发（`access_en` 全程为 0） |
| 背靠背 store 丢第二个 | `DCache.sv:220-227` 的状态机只看"请求是否存在"，无法区分"同一次 store 被 stall 保持"与"下一条 store" | 模块级已复现（2 次写只出 1 个脉冲）；整机实测两次脉冲相隔 5 拍，**未触发** → 隐患 |
| 一次 MMIO load 读外设 **2 次** | 与"保护外设副作用"的初衷相悖（交付日志 `peripheral reads = 6` 即同源放大） | 模块级已复现 |
| 每个请求起始都多发一次 `mem_en`（命中也会发） | 多花一拍 BRAM 读；地址是当前地址，不会误触 MMIO | 模块级已复现 |

### V5 · ICache/IFU 的性能与文档描述不符（不影响架构状态）

板级模型下 `prog.hex`（13 条指令）跑了 97 拍：`IFU.valid` 共 53 拍，其中 **32 拍交付的是 NOP**；`icache_hold` 占 41 拍。即"`IFU.valid` 等价于本拍命中并交付"（`IFU.sv:53-54` 的注释与 `docs/模块阅读文档.md`）被实测证伪，实际约 **7.5 拍/指令**。好消息是这些 NOP 与 `hold=1` 同拍、且 `IDU.sv:113` 只在 `ready_next && !stall` 时锁存，**提交指令数 = 13 = 程序长度**，没有污染架构状态。

> 说明：V4/V5 属于"模块级/性能"层面的独立复核发现，其中 V1/V2 的关键结论（无 `$fatal`、CI 无 `vvp`、大数=字符串）我已亲自逐条核实。

---

## 3. 交叉验证汇总（同一批程序、两套测试台）

| 用例 | 内容 | 我的测试台 | 项目自带 `tb_iverilog.sv` | 判定 |
| --- | --- | --- | --- | --- |
| `lane_min` | 各宽度/偏移 load | FAIL 7 处 | FAIL 7 处，**值完全相同** | 缺陷 B1 |
| `loaduse` | load-use + 非访存后 load | FAIL 10 处 | FAIL 10 处，值相同 | 缺陷 B2 |
| `storeload` | 相邻 store/load 同址 | FAIL 2 处 | FAIL 2 处，值相同 | 缺陷 B2 |
| `div_min` | 连续 div/rem | FAIL 5 处 | FAIL 5 处，值相同 | 缺陷 B3 |
| `loop_min` / `loop` | 后向分支循环 | FAIL | FAIL，值相同 | 缺陷 B4 |
| `mulchain` | 连续 8 条 1 拍 `mul` | **PASS** | **PASS** | 负对照（方法可信） |
| `storelane` | 只写单字节/半字再整字读 | **PASS** | — | 写路径正确 |
| `auipc` / `shift` / `x0` / `fwd_branch` | — | **PASS** | — | 这些路径正确 |

> 交叉验证的意义：错值在**交付方自己的测试台**上以**逐位相同**的形式复现，因此缺陷在 RTL 中，与我的测试台无关。

### 3.1 随机差分回归（40 用例）统计

```bash
bash .verify/difftest/run.sh 40
# => 差分测试结果: PASS=21  FAIL=36
#    （17 个定向 + 40 个随机 = 57 个用例）
```
- 随机用例单独看：**26/40 与参考模型不一致**（65%）。
- 定向用例：8 通过（`mulchain / x0 / auipc / shift / storelane / fwd_branch` 等）／9 失败。
- 失败原因全部可归入 B1~B4 四类（或它们的下游后果）。

**额外症状：存在不终止的用例。** `rnd008` 在 `+max=20000` 拍内**从未到达结束标记**：
```
DIFFTEST_NO_MAGIC after 20000 cycles
```
机制：分支/跳转被判错方向后，`jabs`（`lui+addi+jalr`）算出的目标地址落在数据区，取指进入全零的 IROM 区域当 NOP 一路走，撞到 16 KB IROM 边界后回卷到 0 重跑程序；此时寄存器初值已变，控制流走成另一条路，于是**永远到不了结尾**。即：同源缺陷在整机层面表现为"静默算错"，在另一部分种子下表现为"跑不完"。这两类都属于"回归跑不出来就以为是环境问题"的高风险形态。

---

## 4. 通过 / 可信的部分（避免"一边倒"）

- **官方回归可复现**：`bash sim/run_all.sh` → `7 项通过, 0 项失败`；`prog` 35/35、`prog_mul` 34/34、`prog_div` 34/34，严格模式 `+no_wbu_force +raw_rf` 同样通过。测试台的 `write-once`、`fetch-align` 两项上板专项断言也 PASS。
- **`sb/sh/sw` 的字节通道与掩码正确**（`storelane` PASS；`board/sync_mem.sv` 的 mask 单元测试全 PASS）。
- **1 拍乘法正确**（`mulchain`、`mul`/`mulh`/`mulhu`/`mulhsu` 大量随机用例）。
- **`x0` 恒零**（`Reg_Stack.sv:49` 把 `rd==0` 的写数据钳成 0；`x0` 用例 PASS）。
- **前向分支、`jal`/`jalr`（含 `lui+addi+jalr` 绝对跳转、带非零立即数）、`auipc`、全部移位/比较/逻辑运算**：定向 + 随机用例中未发现错误。
- **`board/sync_mem.sv` 行为正确**：读延迟恰 1 拍、`ren` 撤销后保持、按 mask 写、同拍同址读写返回**旧值**、无组合读路径 —— 单元测试全 PASS。
- **`board/reset_sync.sv`** 是标准"异步置位/同步释放"，未发现错误。
- 交付方文档里关于**"未做真实综合/未做板级实测/无比特流"**的自述与产物一致（`find` 搜 `*.bit/*.dcp/*.xpr/*.rpt` 零命中）。

---

## 5. 文档与交付物一致性核查

| 位置 | 声明 | 核查结果 |
| --- | --- | --- |
| `README.md:90` | 上板件"✅ 仿真冒烟通过" | ❌ `board/tb_board_top.sv` 实测 **FAIL**（退出码 1，3 次运行 md5 相同） |
| `README.md:108` | "板级顶层冒烟 … PASS" | ❌ 同上 |
| `README.md:9` | "本机 iverilog 回归 103/103 全过" | ✅ 可复现；但**覆盖不足**（三项程序合计仅 1 条 load、0 条字节/半字访存、0 个后向分支循环） |
| `README.md:85` | "RV32M 乘除法 ✅ 模块级 4968 向量 + 整机回归" | ❌ 整机层面 `div/rem` 错位（B3）；模块级向量的构造需复核（见 §2 B3） |
| `交付说明.md:59-60` | write-once / fetch-align 专项检查 PASS | ✅ 可复现（但这两条断言覆盖不到 B1/B2/B3/B4） |
| `syn/synth_core.ys` | 综合脚本 | ❌ 文件清单（`:7-10`）读的是 `MDU.sv`，而 `EXU.sv:302` 例化的是 `MDU_pipelined` → `hierarchy -top myCPU -check` 必失败。**我按该清单逐字复现**：`EXU.sv:302: error: Unknown module type: MDU_pipelined` / `These modules were missing:` / `rc=2`（`bash .verify/syncheck.sh`）。且清单中**从未出现** `board/*.sv` 与 `experimental/MDU_pipelined.sv` |
| `syn/v9.xdc:12,16`、`syn/v9.sdc:7,10`、`syn/timing_sweep.tcl:20` | 时钟/复位约束 | ❌ 端口名 `fpga_clk`/`fpga_rst` 在全部 `*.sv` 中零命中（真名 `sys_clk`/`btn_rst_n`）→ 时钟根本没约束上 |
| `syn/v9.xdc:12` vs `syn/v9.sdc:6-7` | 时钟周期 | ❌ 10 ns(100 MHz) vs 20 ns(50 MHz) 自相矛盾 |
| `README.md:96` | 修掉 6 个真实 RTL 缺陷 | ⚠️ 逐项回退实验（独立复核）：**#4（写回被 valid 掐掉）、#5（WBU `.stall` 悬空）、#6（RegisterFile 无复位）三项回退后确实复现故障，声明成立**；**#1（load 后紧跟指令拿到地址）、#3（`ecall` 无异常）两项回退后无法复现**，声明描述的现象不成立（#3 的因果链在当前架构不成立：`ecall` 的 CSR 写入在译码级 `CSR.sv:137/147` 用 IDU 的 pc，不经过 EXU）；#2 机制部分成立但触发条件与描述不同。**且其中一项（重定向去抖）引入了新缺陷 B4** |
| `README.md:107` | "D-Cache 单元测试 … 全 PASS" | ❌ 该测试**没有 `$fatal`**，退出码恒 0，**不可能失败**；且其中一次 store 都没执行（§2.5 V1） |
| `README.md:113`、`ci.yml:3` | "CI 里每次都跑（严格模式）" | ⚠️ 整机回归确实跑；但**板级测试台在 CI 里只编译、从不运行**（`ci.yml:70-79` 无 `vvp`），所以它 FAIL 也不会被 CI 发现（§2.5 V2） |

---

## 6. 回归覆盖缺口（这是"103/103 全过"却仍有 4 个缺陷的根本原因）

1. **访存指令几乎为零**：`prog.hex` 1 条 load；`prog_mul.hex`、`prog_div.hex` **0 条访存**。
2. **没有任何字节/半字访存**：`lb/lh/lbu/lhu/sb/sh` 全未被覆盖 → B1 隐藏。
3. **没有"首条/非访存后"的 load**：`sim/tb_dcache_unit.sv:93-103` 用 `wait_access` 把 `cpu_en` 长期拉高，不产生"请求刚出现那一拍" → B2 隐藏。
4. **没有后向分支循环**：唯一分支是 `prog.hex` 里一条**不跳**的 `beq` 和一条 `jal` → B4 隐藏。
5. **除法用例操作数全同**（4 条 div 都是 100/7）→ 结果错位不可见 → B3 隐藏。
6. **DRAM 模型与上板语义不一致**：`tb_iverilog.sv` 的读口无读使能（自由运行），掩盖了 DCache 的 off-by-one（B2）。
7. **`board/tb_board_top.sv` 是更接近真实 BRAM 的测试，但它 FAIL 了，而 README 却写 PASS** ——若把它的结论当真，会以为板级路径没问题。

**建议补的用例（最小集）**：
- 全宽度访存矩阵：`{sb,sh,sw} × {lb,lh,lw,lbu,lhu}`，偏移覆盖 0/1/2/3，含**前一条不是访存**的场景；
- 相邻同址 `store→load`、连续 `load→load`（同址与异址）；
- 操作数互不相同的连续 `div/divu/rem/remu`，含除零与 `INT_MIN/-1`；
- 后向分支循环（`blt/bne/bge` 各一），循环体内无访存（隔离控制流）；
- 与参考模型做**随机差分**（本次已提供可复用夹具）。

---

## 7. 附录

### 7.1 交付目录改动情况
本次验证**未修改交付物任何文件**：所有仿真在 `$HOME/` 副本中进行。
最终核对（`git status --porcelain` + 顶层列举）：
```
?? .verify/                                    ← 我新增的验证夹具（可删）
?? 验证报告_独立复核.md                          ← 本报告
```
顶层条目仅：`.git .github .verify v9 .gitattributes .gitignore CONTRIBUTING.md README.md 验证报告_独立复核.md`。
> 排查过一处卫生疑点：有复核过程报告"交付目录里存在误建的 `C:Users14000/board_audit/` 副本"。**实测不成立** —— 该路径在交付目录内不存在（顶层列举无此项，工作区内也没有含 `:` 的条目），应是清理前的过期观察。建议评审前仍按上面两条 `??` 核对一次。

### 7.2 新增文件（全部在 `.verify/` 下）
| 文件 | 作用 |
| --- | --- |
| `.verify/difftest/rv32.py` | RV32IM 汇编器（已用 `prog.hex` 校准）+ 独立参考模型 |
| `.verify/difftest/gen.py` | 定向（17 个）+ 随机用例生成器，输出 `.hex` 与期望 `.exp` |
| `.verify/difftest/tb_difftest.sv` | 自建差分测试台（magic-store 结束条件，导出全量 GPR + 非零内存） |
| `.verify/difftest/compare.py` | 逐寄存器/逐内存字比对 |
| `.verify/difftest/run.sh` | 差分测试驱动（编译一次、跑全部用例） |
| `.verify/difftest/crosscheck.sh` / `crosscheck.py` | 在**项目自带** `tb_iverilog.sv` 上交叉验证 |
| `.verify/difftest/tb_trace.sv` / `trace.sh` | 逐拍 PC/重定向/MDU/分支内部信号轨迹（定位 B4 用） |
| `.verify/install_iverilog.sh` | 非 root 安装 iverilog（可复现环境） |

### 7.3 最小复现清单（按缺陷）
| 缺陷 | 复现命令 | 关键观测 |
| --- | --- | --- |
| B1 | `bash .verify/difftest/run.sh 0 lane_min` | `x4..x8, x10, x11` 全取到偏移 0 的数据 |
| B2 | `bash .verify/difftest/run.sh 0 loaduse` | `x6/x8/x10 = 0`（应为 `0x44/0x1122/0x11223344`） |
| B3 | `bash .verify/difftest/run.sh 0 div_min`；对照 `... 0 div_` | `x5=0x0e`（应为 2）等错位；`div_single` PASS / `div_pair` FAIL 划出触发边界 |
| B4 | `bash .verify/difftest/run.sh 0 loop_min` + `bash .verify/difftest/trace.sh 55` | 循环 2 圈即掉出；TRC 48 `act=1 expt=0 memstall=1 raw=0` |
| 全部交叉验证 | `bash .verify/difftest/crosscheck.sh` | 自带测试台上错值逐位一致 |

---

## 8. 结论与建议

**正确性结论：当前交付版不能认为功能正确。** 官方回归的可复现性没问题，但它验证的是一条极窄的路径：3 个程序合计只有 1 条 load、0 条字节/半字访存、0 个后向分支循环、0 组操作数不同的连续除法 —— 上述 4 类缺陷恰好全部落在盲区里。

**建议的处理顺序**（按"上板阻断程度"）：
1. **B2**（load 读回时序 / 真实 BRAM 上变 `x`）—— 直接阻断上板；同时修正 `tb_iverilog.sv` 的 DRAM 读口使其与 `sync_mem` 语义一致，否则测试台会继续掩盖它。
2. **B4**（taken 分支误预测被屏蔽）—— 静默算错，最危险；把 `mem_stall` 期间的判定改成挂起补发。
3. **B1**（字节/半字 load 偏移）—— 影响面直接、修复局部。
4. **B3**（多拍除法错位）—— 需同时复核 `MDU_pipelined` 的接口契约（是否要求操作数/启动保持、结果有效拍）与 `EXU` 的冻结窗口。
5. 修正 `README.md:90/108` 的 PASS 声明；修 `syn/` 的模块清单与约束端口名；补 §6 的回归用例后再重跑。

> 说明：本报告的每一条"缺陷"都经过**两套独立测试台交叉确认**（我的差分夹具 + 项目自带 `tb_iverilog.sv`），并给出了代码级根因位置；`mulchain` 等 PASS 用例作为负对照，用于证明比对方法本身可靠。

---

## 9. 修复记录（第二轮，按验收门禁逐项修）

### 9.1 验收门禁

修复过程全程用同一套门禁，**四项必须同时通过**：

```bash
bash .verify/verify_all.sh 40     # 1) 官方回归 2) 板级自检 3) 差分测试 4) 交叉验证
```

| 门禁 | 修复前 | 修复后 |
| --- | --- | --- |
| ① 官方回归 `sim/run_all.sh` | 7 项通过（覆盖极窄） | **15 项通过**，单轮 **239/239 项检查**（严格模式同样全过） |
| ② 板级自检 `board/tb_board_top.sv` | **FAIL**（x6/x7 = `x`） | **PASS 33/33**（`DCache hit/miss = 3/1`，说明缓存回填真的发生了） |
| ③ 差分测试（自建参考模型） | PASS 22 / FAIL 37 | **PASS 60 / FAIL 0** |
| ④ 交叉验证（自带测试台逐位比对） | 31 处不一致 | **0 处不一致** |

### 9.2 修掉的 7 个 RTL 缺陷与改动位置

| # | 缺陷 | 改动文件与要点 |
| --- | --- | --- |
| B1 | 字节/半字 load 丢弃地址偏移 | `LSU.sv`（reg/reg2 两级都按 `addr[1:0]` 选道，半字按 `addr[1]`）、`WBU.sv`（新增 `offset_in`，写回拍同样选道）、`myCPU.sv`（把偏移随流水引到 WBU） |
| B2 | DCache 读握手 off-by-one | `DCache.sv`：`hit_now`（当前地址组合命中）+ `resp_for_now`（本拍返回的是当前地址的读），`hold = (cpu_en&~cpu_wen) & ~(hit_now\|resp_for_now)`；计数器口径同步更新 |
| B5 | `lw→sw` 数据相关时 store 写旧值 | `Data_hazard.sv`：`mem_hit/pipe_hit` 补 `valid` 检查、把 load 排除出 MEM/MEM_PIPE 级（load 数据固定在 MEM2 前递）、`Control.sv` 补 `MEM_PIPE_mem_ren` 端口 |
| B4 | 后向分支循环提前退出/失控 | `Control.sv`（判定挂起 `bp_misp_pend` + 方向/目标一起锁存 + 挂起优先 + 去抖清零条件改为"判定彻底消失" + `EXU_inst_clear` 的 `mem_stall` 项不再作用于分支/跳转 + 新增 `bp_hold_exu`）、`IFU.sv`（真实重定向不再用 `inst_valid` 门控；投机拨 PC 与"本拍确实接收"同一条件）、`EXU.sv`（新增 `bp_pend`，挂起期间不接收新指令）、`myCPU.sv`（连线） |
| B3 | 背靠背 `div/rem` 结果与 rd 错位 | `EXU.sv`：MDU 握手改为"每条 M 指令只发射一次"（`mdu_issued`）+ 冻结条件改为"EX 级是 M 指令且自己的结果未锁存"（`mdu_res_vld`）+ 状态机简化为 IDLE/WAIT + `mdu_busy = mdu_stall`（让 LSU 与 EXU 同口径冻结） |
| B6 | EXU 级前递对 jump/CSR 取错值 | `Control.sv`（新增 `EXU_forward_val` 输入）、`myCPU.sv`（`(jump_flag\|csr_wen) ? rd_value : Ex_result`） |
| B7 | 补发重定向当拍错路径指令已提交 | `Control.sv` 的 `bp_hold_exu` + `EXU.sv` 在两个接受点（控制寄存器、数据/载荷寄存器）都加 `~bp_pend` |

### 9.3 修掉的 3 处验证基础设施缺陷

| 缺陷 | 改动 |
| --- | --- |
| 回归测试台的 DRAM 读口**没有读使能**（自由运行读），掩盖了 B2 | 给 `myCPU` 增加顶层端口 `perip_ren`（= DCache 的 `mem_en`）；`sim/tb_iverilog.sv`、`board/board_top.sv`、差分测试台都改成**按 `ren` 门控**的同步读（与 `board/sync_mem.sv` 同语义）；`board_top` 不再用层次化引用穿进 `myCPU` |
| D-Cache 单元测试**没有 `$fatal`**，退出码恒 0 → **永远不可能失败**；且 `$display` 直接打印字符串字面量（日志里的 `23228598090284490058663670033758753477459` 就是 `"DCACHE-UNIT: PASS"` 当 136 位整数）；测试台在时钟沿用阻塞赋值驱动，导致**一次 store 都没发出去**（`wr_seen=0`） | `sim/tb_dcache_unit.sv`：加 `$fatal`、改成明确打印、store 激励改为**沿后 1ns** 驱动，并把"写直达落盘""store 后读回"两条升级为**真正的判据** |
| CI **只编译**板级测试台、从不运行 → 它 FAIL 也不会被发现 | `.github/workflows/ci.yml`：新增"运行板级顶层自检"步骤（`vvp sim/build/tb_board.vvp +prog=sim/prog.hex`） |

### 9.4 新增的回归程序（自带测试台）

| 程序 | 覆盖 | 修复前 |
| --- | --- | --- |
| `sim/prog_load_lane.hex` | `lb/lh/lbu/lhu` 在偏移 0/1/2/3 上选道 | 7 处错值 |
| `sim/prog_load_use.hex` | load-use 冒险、非访存指令后的 load、`lw→sw` 数据相关 | 10 处错值 |
| `sim/prog_loop.hex` | 后向分支循环（`blt` 累加 1..10） | 循环只跑 2 圈 |
| `sim/prog_div_pair.hex` | 背靠背 `div/div/rem`（操作数与结果互不相同） | 4 处错位 |

期望值由独立参考模型算出（不是一个个人手算），`sim/run_all.sh` 里 4 个程序各跑正常/严格两种模式。

### 9.5 同步修正的文档/脚本/约束

- `README.md`：回归项数与检查数（7 项/103 → **15 项/239**）、上板件状态、新增第二轮 7 个缺陷的对照表。
- `v9/sim/README_iverilog.md`、`v9/docs/模块阅读文档.md`（新增 §9.2b 机制说明与 §11 验证表）、`v9/sim/run_iverilog.sh`/`.bat`（新程序的 `prog_id` 映射）。
- `v9/syn/synth_core.ys`：模块清单从 `MDU.sv` 改为 `experimental/MDU_pipelined.sv`（否则 `hierarchy -check` 直接报 `Unknown module type`），并把 `board/*.sv` 纳入、`-top` 改为 `board_top`。
- `v9/syn/v9.xdc` / `v9.sdc`：端口名改为真实端口 `sys_clk`/`btn_rst_n`（原来写的 `fpga_clk`/`fpga_rst` 在全工程 `*.sv` 里零命中 → 时钟根本没约束上）、统一时钟周期为 10ns、补齐 4 个性能计数器的 `false_path`。

### 9.6 复现方式

```bash
# 全部四道门禁（推荐）
bash .verify/verify_all.sh 40
# 单看缺陷复现（修复前的判据）：每个用例都能单独跑
bash .verify/difftest/run.sh 0 lane_min     # B1
bash .verify/difftest/run.sh 0 loaduse      # B2/B5
bash .verify/difftest/run.sh 0 loop_min     # B4
bash .verify/difftest/run.sh 0 div_pair     # B3
# 逐指令与参考模型比对（定位分歧点）
bash .verify/difftest/rtldiff.sh rnd034
```

> 遗留（未在本次修复范围内，见 §2.5 V4/V5）：DCache 读响应缺地址跟踪导致的跨地址污染、
> 背靠背 store 只发一个脉冲（模块级复现、整机未触发）、一次 MMIO load 触发多次外设读
> （与测试台长时间保持请求有关）、IFU 交付的 `valid` 拍里有较多 NOP（性能，7.5 拍/指令）。
> 这几项已定位但没有改，避免在缺少整机触发用例的情况下引入新风险。

---

## 10. 第三轮：接入 ModelSim —— 严格性核查与第二仿真器交叉验证

### 10.1 动机

前两轮的**全部**结论都建立在 iverilog 上。iverilog 是宽容的：它对 Verilog 的
隐式网络（implicit net）规则不报错。而商用工具的编译期规则严格得多。
本机装有 `ModelSim SE-64 10.5`（`E:\FPGA\ModelSim_10.5se`），于是接进来当**第二仿真器**。

### 10.2 结果：ModelSim 直接拒绝编译这份 RTL（5 处硬错误）

`vlog` 对 19 个 RTL 文件报出 5 处 `vlog-2730 Undefined variable`，并且**不可压制**
（实测 `-suppress 2730` 返回 `Cannot suppress or change severity level of message number 2730`）。
也就是说：**在修掉之前，这份 RTL 在 ModelSim 上一行都跑不起来。**

根因全部是同一类：**先用后声明**。按 Verilog 隐式网络规则，被使用时尚未声明的标识符
会先被当成 **1 位隐式 wire** 建网；随后同一作用域里的显式声明就成了"重复声明"
（`vlog-2388`，可压制）：

| # | 位置（首次使用） | 标识符 | 声明处 | 位宽 | 影响面 |
| --- | --- | --- | --- | --- | --- |
| C1 | `myCPU.sv:152` | `icache_hold` / `dcache_hold` | 183 / 196 | 1 | IFU 停拍请求合流 |
| C2 | `IDU.sv:174` | `is_SYS` | 193 | 1 | CSR 写使能位图 |
| **C3** | **`EXU.sv:206`** | **`mdu_res`** | **291** | **32** | **乘除法结果总线** |
| C4 | `DCache.sv:128` | `mem_req_r` | 130 | 1 | 读请求一次性判据（正是 B2 的修复点） |
| C5 | `Control.sv:129` | `system_redirect` | 192 | 1 | 误预测判定 |
| C6 | `sim/tb_iverilog.sv:147` | `dram` 被 `always_ff` 与 `initial` 双重驱动 | — | — | 官方回归测试台 |
| C7 | `.verify/difftest/tb_difftest.sv:85` | 同上（同一写法） | — | — | 差分测试台 |
| C8 | `Control.sv:141` | `bp_mispredict_raw` | **从未声明** | 1 | 误预测判定（**ModelSim 也没报**，见下） |

**C8 是"门禁 0"抓出来的，ModelSim 并没有报它** —— 因为一个从未声明的标识符一旦出现在
连续赋值（`assign`）左边，Verilog 就**合法地**为它创建一个隐式网并驱动它，所以工具
不会认为有错。但它的宽度仍然由工具决定（这里是 1 位），性质与 C1–C5 相同：
代码的正确性依赖于"隐式网络的默认规则"，而不是显式的声明。C8 已补上显式声明。

**C3 是最需要警惕的一处。** 它是 32 位的乘除法结果，却先被当作 1 位隐式 wire 使用。
iverilog 宽容地把两者合并成了同一个 32 位对象（所以此前 mul/div 全部通过 —— 也正因如此
它**不会**在上板前暴露），但这是**依赖工具宽容度**的行为：语义正确性取决于编译器的
实现细节而不是代码本身。换成严格工具、或按 LRM 处理的综合工具，乘除法结果会整体失真。

### 10.3 修法（零逻辑改动）

只调整声明顺序，把 5 个标识符的声明移到首次使用之前；两个测试台的 `dram` 写口把
`always_ff` 改为 `always @(posedge clk)`（`dram` 还要在 `initial` 里清零，而 SV LRM
禁止 `always_ff` 驱动过的变量再被其它进程驱动）。

### 10.4 一个值得记住的坑：vlog 报 Error 的模块**不会入库**

C6 的 `vlog-7061` 是 **Error 级**。vlog 虽然打印了 `-- Compiling module tb_difftest`，
却**没有把它写进 `work` 库**，于是 `vsim` 报：

```
** Error: (vopt-13130) Failed to find design unit tb_difftest.
```

现象是"编译日志说编好了，仿真说找不到模块"——很容易被误判成环境/路径问题。
正确的排查手段是 `vdir -lib work` 列出库里**实际**有什么；这一步才看出
`tb_difftest` 根本不在列表里（18 个 RTL 模块都在，只有它被丢掉了）。

### 10.5 第五道门禁：`run_modelsim.sh`

把同一套差分测试同时喂给两个仿真器，做三方比对：

```bash
bash .verify/difftest/run_modelsim.sh 40
```

实测结果（60 用例 = 20 定向 + 40 随机）：

| 比对 | 结果 |
| --- | --- |
| ModelSim 编译（严格） | `vlog rc=0`，硬错误 0、可压制 0、警告 0 |
| (a) ModelSim vs 独立参考模型 | **PASS 60 / FAIL 0** |
| (b) iverilog vs 独立参考模型 | **PASS 60 / FAIL 0** |
| (c) 两仿真器 dump 逐字节（32 GPR + 全部非零内存字 + 周期数） | **60/60 一致，0 处分歧** |

(c) 的意义在于：此前的功能结论**与仿真器无关**，不是 iverilog 语义的产物。

### 10.6 门禁 0：把这一类问题变成 iverilog 也能抓的硬错误

只靠 ModelSim 有个现实问题：CI（GitHub Actions）跑不了商用工具。所以补了一道
**不依赖 ModelSim 的等价检查** —— `.verify/netcheck.sh`：

> 把交付目录的每个 `.sv` 复制一份，在最顶上插入 `` `default_nettype none ``，
> 再用 iverilog 编译。任何"未声明就使用"的标识符都会变成硬错误。

因为 ModelSim 默认逐文件编译，所以指令要加在**每一个**文件上（脚本用
`find -name '*.sv'` 自动做）。实测结果：

| 编译集合 | 结果 |
| --- | --- |
| 核心 RTL + 官方回归测试台 | `[OK]` |
| 核心 RTL + 差分测试台 | `[OK]` |
| 板级顶层 + 板级自检台 | `[OK]` |
| D-Cache 单元测试台 | `[OK]` |

这道检查已作为**门禁 0** 接入 `verify_all.sh`（详见 `.verify/README.md`），
从此 C1–C8 这一类问题在 iverilog 上就会直接编译失败，不再依赖"有没有装商用工具"。

### 10.7 结论

**ModelSim 对这次验证是有效的，而且 C1–C7 只能靠它发现。** 更深一层的教训是：
一份"在免费仿真器上全绿"的设计，未必在主流商用工具下能编译 ——
iverilog 的宽容度本身就是一个盲区，这次只是恰好被第二个仿真器照出来了。

ModelSim 还能做 iverilog **完全不支持**的两件事（本轮未做，建议后续补上）：

- **SystemVerilog 断言（SVA）**：把握手契约写成硬性检查，例如
  "`MEM_valid` 拉高后 N 拍内必须出现 `MEM_ready`"。§2.5 V4 里那些"整机没触发、
  只能靠推理"的模块级疑点，正好适合用断言穷举。
- **功能覆盖率（`covergroup`）**：量化"测试到底覆盖了没有"。本次"官方回归全绿却漏掉
  4 类缺陷"的根因就是覆盖率缺口（§6），而覆盖率正是回答这个问题的标准工具。
