fshanhuan/Rsic-v-IM/docs/地址表.md

# SoC 地址表

> **自动生成，不要手改。** 来源 `rtl/soc_map.sv`，生成脚本 `tools/gen_soc_map.py`。
> `_diag/regress.ps1` 里的 `socmap` 用例会用 `--check` 比对这份文件与头文件。

## 数据口地址空间（哈佛：取指口另有一套）

| 名字 | 值 | 说明 |
|---|---|---|
| `SOC_DRAM_BASE` | `32'h0000_0000` |  |
| `SOC_DRAM_BYTES` | `32'h0002_0000` | 128 KB |
| `SOC_CODEWIN_BASE` | `32'h0002_0000` |  |
| `SOC_CODEWIN_BYTES` | `32'h0001_0000` | 64 KB |
| `SOC_MMIO_BASE` | `32'h1000_0000` |  |
| `SOC_MMIO_BYTES` | `32'h0000_8000` | 32 KB |
| `SOC_CODE_BASE` | `32'h0000_0000` | 取指口 |
| `SOC_CODE_BYTES` | `32'h0001_0000` | 64 KB |
| `SOC_IMEM_WORDS` | `16384` |  |
| `SOC_DRAM_WORDS` | `32768` |  |
| `SOC_IRQ_UART_RX` | `0` | RX FIFO 非空（电平） |
| `SOC_IRQ_UART_OVF` | `1` | RX 溢出（电平） |
| `SOC_IRQ_TIMER` | `2` | 定时器（A3 接 CLINT） |
| `SOC_IRQ_SW` | `3` | 软件自触发（写 0x1000_002C） |
| `SOC_IRQ_PS` | `4` | PS 发来的事件（AXI 控制寄存器 bit1，电平） |

## MMIO 寄存器（基址 `SOC_MMIO_BASE` + idx×4）

| 地址 | 名字 | 说明 |
|---|---|---|
| `0x10000000` | `SOC_MMIO_IDX_TXDATA` | 0x00 WO  写 → 串口发送 |
| `0x10000004` | `SOC_MMIO_IDX_TXSTAT` | 0x04 RO  bit0 = 发送器忙 |
| `0x10000008` | `SOC_MMIO_IDX_RXDATA` | 0x08 RO  队头字节（不弹） |
| `0x1000000C` | `SOC_MMIO_IDX_RXSTAT` | 0x0C RO  bit0 = FIFO 非空, bit1 = 溢出过 |
| `0x10000010` | `SOC_MMIO_IDX_LED` | 0x10 RW  低 7 位驱动 LED |
| `0x10000014` | `SOC_MMIO_IDX_BOOTREQ` | 0x14 WO  写 1 → 重新引导 |
| `0x10000018` | `SOC_MMIO_IDX_RXPOP` | 0x18 WO  写 1 → 弹出队头 |
| `0x1000001C` | `SOC_MMIO_IDX_CTL` | 0x1C RW  控制（见上：无效/irq_ps/alive） |
| `0x10000020` | `SOC_MMIO_IDX_IRQPEND` | 0x20 RW  读=待处理位图；写 1s = claim（清位） |
| `0x10000024` | `SOC_MMIO_IDX_IRQEN` | 0x24 RW  使能位图 |
| `0x10000028` | `SOC_MMIO_IDX_IRQID` | 0x28 RO  最高优先级的待处理源号（0 = 无） |
| `0x1000002C` | `SOC_MMIO_IDX_IRQSW` | 0x2C WO  写 1 → 触发软件中断源（src[3]，自测用） |
| `0x10000030` | `SOC_MMIO_IDX_MTIME` | 0x30 RW  mtime 低 32 位 |
| `0x10000034` | `SOC_MMIO_IDX_MTIMEH` | 0x34 RO  恒 0（本设计 mtime 只有 32 位） |
| `0x10000038` | `SOC_MMIO_IDX_MTIMECMP` | 0x38 RW  mtimecmp 低 32 位 |
| `0x1000003C` | `SOC_MMIO_IDX_MTIMECMPH` | 0x3C RO  恒 0（写忽略） |
