fshanhuan/Rsic-v-IM/syn/修复史_全量.md

# v9 修复史 · 全量（注释迭代的抽取归档）

> **这份文档的定位**：它不是新的分析，而是**归档**。
> 在 v9 的注释迭代（保守精简）中，RTL 里那些"当时怎么发现、试了几版、实测数字是多少"
> 的长篇叙述被压缩成了 2~5 行的 `★ 不变量 + 原因`，**原文逐字搬到了这里**。
> RTL 注释里的 `见 syn/修复史_全量.md §<锚点>` 就是指向本文件。

> **为什么这样拆**：源码注释要回答的是"**改这里会坏什么**"，
> 而"当初是怎么踩到的"属于史料 —— 两种读者、两种篇幅。
> 但史料**一个字都不能丢**：本文件的存在，就是为了让精简变成"搬家"而不是"删除"。

**生成时间**：2026-10-15

**相关文档**（这些是分析，不是归档）：

| 文档 | 讲什么 |
|---|---|
| [`上板改造说明.md`](上板改造说明.md) | 上板障碍清单 P0~P5、改造前后对照、6 个 RTL 缺陷的根因 |
| [`修复进度_C系列.md`](修复进度_C系列.md) | C 系列（异常体系）修复的逐步记录 |
| [`ecall重定向故障_根因与修复.md`](../docs/vivado/ecall重定向故障_根因与修复.md) | B9：ecall 重定向失效的完整定位与板上确认 |
| [`上板验证判据.md`](../docs/vivado/上板验证判据.md) | 上板时怎么判定"正常工作" |
| [`ila_使用说明.md`](../docs/vivado/ila_使用说明.md) | ILA 探针分配、触发姿势、时序资源实测 |

---

## 索引

| 模块 | 锚点前缀 | 主题数 |
|---|---|---|
| `IFU.sv` | `IFU-*` | 6 |
| `ICache.sv` | `ICACHE-*` | 9 |
| `Branch_Predictor.sv` | `BRANCHPREDICTOR-*` | 4 |
| `IDU.sv` | `IDU-*` | 6 |
| `Reg_Stack.sv` | `REGSTACK-*` | 3 |
| `RegisterFile.sv` | `REGISTERFILE-*` | 2 |
| `Reg.sv` | `REG-*` | 2 |
| `EXU.sv` | `EXU-*` | 11 |
| `MDU_pipelined.sv` | `MDU-*` | 4 |
| `ALU.sv` | `ALU-*` | 3 |
| `add.sv` | `ADD-*` | 1 |
| `sext.sv` | `SEXT-*` | 1 |
| `LSU.sv` | `LSU-*` | 3 |
| `DCache.sv` | `DCACHE-*` | 6 |
| `WBU.sv` | `WBU-*` | 3 |
| `Control.sv` | `CONTROL-*` | 37 |
| `Data_hazard.sv` | `DATAHAZARD-*` | 5 |
| `CSR.sv` | `CSR-*` | 6 |
| `myCPU.sv` | `MYCPU-*` | 9 |
| `para.sv` | `PARA-*` | 5 |
| `board_top.sv` | `BOARDTOP-*` | 5 |
| `board_top_ila.sv` | `BOARDTOPILA-*` | 6 |
| `sync_mem.sv` | `SYNCMEM-*` | 2 |
| `reset_sync.sv` | `RESETSYNC-*` | 1 |
| `board_top_gui.sv` | `BOARDTOPGUI-*` | 4 |

---

## 一、取指与前端

### IFU.sv

> 本文件只保存**从 IFU.sv 注释里删掉/压缩掉**的原文，一个字都没有改写。
> 正本现在是风格指南 §2 的紧凑格式，细节（波形数字、试了几版、当时怎么想的）全在这里。
> 相关源码：`E:\share doc\v9\IFU.sv`

---

## IFU-1：真实重定向不能看 `inst_valid`，也不能看 `ready`（原编号：v9 修复 B4 / B7 / B9）

**位置**：`always_ff @(posedge clock)` 的 PC 更新块之前（原文件第 68~119 行一长段连续行注释），
以及紧贴 `else if (dnpc_flag)` 的那句 `// ★ 真实重定向：既不看 inst_valid，也不看 ready ……`
（原第 123~124 行，现压缩为 §2 五行的 ★ 不变量）。

这是 IFU.sv 注释占比最高的一段，也是本次精简的主战场：**原文 52 行 → 5 行**。

### 删掉的原文（逐字，含空行分段）

> ```systemverilog
>     // v9 修复（B4）：**预测跳转必须与顺序推进用同一个“本拍确实接收了这条指令”条件**。
>     //   原式 `pred_taken & inst_valid` 少了 valid/ready/~stall：当前这条指令还没被 IDU
>     //   锁存（停拍 / valid=0）时就把 PC 拨到预测目标，这条指令（很可能正是一条分支）
>     //   就被**丢掉**了 —— 它本该做出的"预测对不对"的判定再也没人做。
>     //   预测器一旦学会 taken，于是每次撞上取指 hold 就少判一条分支，循环彻底失控
>     //   （实测 loop_min 的 x1 涨到 2491，应为 10；同一程序在自带测试台上逐位复现）。
>     //   现在：只有这一拍确实交付并接收了指令，才允许投机拨 PC；否则保持 PC，
>     //   等这条指令被接收后再拨（或由 EX 级的真实重定向接管）。
> ```
>
> ```systemverilog
>     // PC 更新优先级：
>     //   reset > dnpc 真实重定向 > 预测跳转 > stall 保持 > 顺序加 4。
>     // v9 修复（B4/B7）：真实重定向**不能**再用 inst_valid 门控。
>     //   inst_valid（ICache.fetch_align）表示"本拍取回的数据确实属于当前 PC"——
>     //   而重定向本来就是**放弃**当前这次取指、把 PC 拨到确定的目标，与当前取指数据
>     //   是否对齐无关。原来要求 inst_valid，于是当重定向恰好落在取指 hold / 未对齐拍
>     //   （fetch_align=0）时会被**丢掉**：实测 `jal x2,T` 已经算出并写回了 link，
>     //   却发现下一条执行的是 pc+4（顺序路径）而不是 T；分支同理，方向被判对但
>     //   重定向没生效，CPU 一路沿错路径提交。
>     //
>     // v9 修复（B9，上板 ILA + 仿真共同定位）：**`ready` 同样不能门控真实重定向。**
>     //   上面那句注释"只保留 ready（下游可接收的结构性背压）"是**错的**，这里把它兑现掉。
>     //
>     //   ready = IDU_ready = ready_next && !stall，表达的是"下游这一拍能不能**接收**
>     //   一条新指令"。但重定向这一拍的当前取指本来就是要**作废**的：dnpc_flag 同时
>     //   就是 IDU 的 flush（myCPU.sv 里 `.flush(dnpc_flag)`），IDU 在这一拍把
>     //   inst/snpc/pc 与译码级的 inst_d 全部灌成 NOP。也就是说，重定向不是"请求下游
>     //   接收"，而是"命令下游丢弃"。用 ready 去门控它，等于因为下游正忙而放弃冲刷，
>     //   因果完全颠倒。
>     //
>     //   触发条件极其容易命中，因为 dnpc_flag 里的系统重定向**只有一拍宽**：
>     //     Control.dnpc_flag = intr_take | trap_redirect | bp_mispredict | system_redirect
>     //     system_redirect   = mret_flag | ecall_flag | fence_i_flag | trap_redirect
>     //   ecall_flag / mret_flag / fence_i_flag 都是 IDU 由 inst_d 组合译出的电平，而
>     //   IDU 在 flush(=dnpc_flag) 那一拍就把 inst_d 灌成 NOP → 下一拍它们自动消失，
>     //   所以这三个重定向请求是**单拍脉冲**。Control 里只有分支误预测建了
>     //   bp_misp_pend"挂起重发"机制（见 Control.sv 补发脉冲一节），
>     //   ecall / mret / fence.i / trap **没有任何重发机制** —— 这一拍被吃掉就永久丢失。
>     //
>     //   实测（这次的真凶，仿真与上板逐位一致）：
>     //     [EPC] cyc=75 +1 ifu_pc=00000038 dnpc_flag=1 dnpc=00000000
>     //                              ifu_ready=0 ifu_valid=1 ifu_stall=1
>     //     ecall 在 pc=0x34，重定向请求已发出、目标 mtvec=0 也正确，但同拍 IFU_stall=1
>     //     → ready=0 → 重定向被丢；此后 PC 一路 0x38→0x3c→0x40→0x44… 顺序爬行。
>     //   上板 ILA 现象完全对应：2048 拍里 debug_wb_pc 从不为 0，
>     //   mepc 每绕 IROM 一圈（16KB）才更新一次（0x…8034 → 0x…c034，正好 +0x4000），
>     //   即"每绕一圈又执行一次 ecall，然后接着顺序跑"，无限循环。
>     //
>     //   为什么以前没发现：仿真原来在 ecall 译码后再 drain 8 拍就 $finish，
>     //   报告只比 GPR/dram/mepc/mcause，**从来没有人看过 ecall 之后的 PC**，
>     //   于是 35/35 全 PASS 而 bug 照样在。现在 tb_iverilog 加了
>     //   "ecall-redirect (pc -> mtvec)" 断言专门守这一条。
> ```
>
> ```systemverilog
>         // ★ 真实重定向：既不看 inst_valid，也不看 ready —— 它是控制面已经确认的事实，
>         //   而且这一拍下游被 flush 灌的是 NOP，不存在"下游没接收"的问题。
> ```

### 原文件头里与这三条相关的段落（也已压缩掉）

> ```systemverilog
> //   - PC 更新里把 dnpc_flag（真实重定向）放在最前：重定向是控制面已经确认
> //     的事实，不能因为同一拍存储侧的暂停请求而丢掉；这一拍 valid 已是 0，
> //     被取回的那条指令不会被执行。
> ```

### 补充说明

- **B4 / B7 / B9 是同一类错误犯了三次**（"拿当前这次取指的状态去门控重定向"）：
  B4 = 预测跳转丢了分支指令；B7 = `inst_valid` 不该门控重定向；
  B9 = `ready` 也不该门控重定向。
  正本因此把不变量写成**一条**（"既不看 inst_valid，也不看 ready"）并标 `★ 不变量`，
  就是为了拦住第四次。改这一行之前请先读 `syn/修复史_全量.md §IFU-1`。
- 正本里 `ready` 与 `inst_valid` 的定义式（`ready = IDU_ready = ready_next && !stall`）
  已保留在原因里，因为它是"为什么用 ready 门控是因果颠倒"的推导前提。
- B9 的实测波形（`cyc=75` 那一行 `[EPC]`）与上板 ILA 的 `mepc` 步进证据**只在这里保留**，
  RTL 里只留一句"含上板 ILA 逐拍证据"的锚点 —— 波形数字属于"过程"，不属于"机制"。

---

## IFU-2：`valid` 必须与取指数据同拍、不能组合直通（含原 `mem_stall_r` 错相这段战史）

**位置**：`always_ff` 生成 `valid` 之前（原第 47~54 行）。

**原文**：

> ```systemverilog
>     // 取指契约（上板改造修正）：valid 必须与取指数据同拍，但不能组合直通。
>     //   同步 BRAM 的取指是“请求/响应”两拍交替的（见 ICache.sv）：hold=1 的那拍数据
>     //   不可用，命中那一拍 hold=0。原来门控用的是**又打了一拍**的 mem_stall_r，
>     //   与 inst_valid 错相，实测 valid=1 的拍恰好都撞在 stall=1 上，前端一条指令都
>     //   交付不出去（表现为第一次重定向后 EXU_valid / LSU_valid 恒 0）。
>     //   这里改成当拍判定：
>     //     valid <= inst_valid & ~mem_stall   （ICache 未命中时返回 `NOP 且 hold=1，
>     //   所以该式等价于“本拍命中并交付”）。PC 冻结由 stall 负责，与 valid 无关。
> ```
>
> ```systemverilog
>         else
>             valid <= inst_valid & ~mem_stall;
> ```

**补充说明**：这段在正本里压缩为 2 行 `★ 不变量` + 1 行原因，机制（错相 → 一条都交付不出去）
保留，实测现象（第一次重定向后 EXU_valid / LSU_valid 恒 0）与"原来用的是 mem_stall_r"的
沿革移到本文件。`mem_stall` / `inst_valid` 的**当拍**语义（来自 ICache 的 hold/fetch_align）
是 A 类，正本保留。

---

## IFU-3：`pred_take_en` 必须复用 `advance_en`（B4 的预测跳转那半条）

**位置**：`assign pred_take_en` 之上（原第 68~75 行）。

原编号同为 **v9 修复（B4）**，原文见 IFU-1 的第一段引用，此处不重复抄写
（B4 的两半——顺序推进与预测跳转必须同条件——在正本里合成了一条 `★ 不变量`）。

**补充说明**：正本保留的式子是

```systemverilog
    assign advance_en  = valid & ready & inst_valid;
    assign pred_take_en = pred_taken & advance_en & ~stall;
```

"为什么 `pred_take_en` 里已经有 `advance_en`（含 `ready`）还要再 `& ~stall`"——
`advance_en` 是"本拍交付并被接收"，`~stall` 是"本拍没有背压"，两者对同一拍取指都成立
才允许投机拨 PC；缺 `~stall` 就是 B4 复现（PC 抢跑 → 丢分支指令）。

---

## IFU-4：`advance_en` —— PC 只在返回结果属于当前 PC 时才推进

**位置**：`assign advance_en` 之上（原第 62~64 行）。

**原文**：

> ```systemverilog
>     // 只有“返回结果确实属于当前 PC”（inst_valid = ICache.fetch_align）时，
>     // 才允许推进 PC：否则 PC 会跑到取指数据前面，使 IDU 收到
>     // 「下一条地址 + 上一条指令」的错配组合。
> ```

**补充说明**：A 类，正本保留为 `★ 不变量`（语义强度未降低，只压掉重复措辞）。

---

## IFU-5：原文件头（方案沿革段，已收敛到 §5 模板）

**位置**：module 声明之前的 `//` 注释块（原第 4~21 行）。

**原文**：

> ```systemverilog
> // 取指级只做一件事：维护当前 PC，并在顺序执行、暂停、重定向之间切换。
> //
> // v9 上板改造（取指契约修正）：
> //   - valid 过去恒为 1，停拍期间取回的指令可能被后级误当成有效指令接纳。
> //     现在 valid 只在“本拍 irom_data 确实是当前 pc 的取指数据”时为 1，
> //     即 inst_valid(& ICache.fetch_align) & ~stall；停拍/未对齐的那一拍
> //     向 IDU 灌一个泡（valid=0）。这正是同步 BRAM 取指所要求的握手。
> //   - inst 在 valid=0 时输出 para.sv 的 `NOP，避免 IDU 看到无效取指数据。
> //   - PC 只在“返回结果属于当前 PC”时才推进（advance_en），否则 PC 会跑到
> //     取指数据前面，让 IDU 收到「下一条地址 + 上一条指令」的错配组合。
> //   - PC 更新里把 dnpc_flag（真实重定向）放在最前：重定向是控制面已经确认
> //     的事实，不能因为同一拍存储侧的暂停请求而丢掉；这一拍 valid 已是 0，
> //     被取回的那条指令不会被执行。
> //
> // v9 新增分支预测：
> //   - dnpc_flag 是执行级确认的真实重定向（优先级最高）；
> //   - pred_taken/pred_target 是预测器给出的“投机跳转”；
> //   - 两者都没有时才顺序取 pc+4。
> ```

**补充说明**："valid 过去恒为 1"是**旧行为**（错的那版），正本不再展开，只保留
"valid=0 灌泡 → 必须与取指数据同拍"这条契约。分支预测三条（dnpc_flag 最高优先 /
pred_taken 是投机 / 都没有才 pc+4）在正本里用一行优先级链表达，机制未丢。

---

## 本文件无需抽取的部分（未删、未压缩）

- `// 只有“返回结果确实属于当前 PC”（inst_valid = ICache.fetch_align）时…` → 见 IFU-4，属 A 类，已保留。
- 行尾注释与局部信号注释（`localparam ResetValue`、`assign snpc/inst`）无 B 类内容。

---

### ICache.sv

> 本文件只保存**从 ICache.sv 注释里删掉/压缩掉**的原文，一个字都没有改写。
> 相关源码：`E:\share doc\v9\ICache.sv`

---

## ICACHE-1：为什么旧写法（同拍组合旁路）上板必炸（原编号：无 B 编号，属“上板改造”段）

**位置**：文件头块注释中 `为什么原来必须改（上板必炸）` 一节（原第 24~29 行）。

**原文**：

> ```systemverilog
>  * 为什么原来必须改（上板必炸）：
>  *   旧写法是“同拍组合旁路”：
>  *       assign cpu_rdata = hit ? data[index] : mem_rdata;
>  *   它假设 mem_rdata 与本拍 cpu_addr 同拍有效（零延迟组合 ROM）。
>  *   FPGA 的 Block RAM 是**同步读**：地址打一拍、数据下一拍才出，
>  *   所以真实存储器不可能同拍返回数据。
> ```

**补充说明**：这段是 A 类（它决定了整份文件的两拍时序）。**第二轮压缩后**，正本只在
`★ 不变量：同沿、同源` 那条的末尾留了一句引用（`踩坑史（旧“同拍组合旁路”为什么上板
必炸）：见 §ICACHE-1`），所以这里必须保留完整原文 —— 它是“为什么不能改回组合旁路”的
唯一依据。**注意**：正本里不能再出现 `assign cpu_rdata = hit ? data[index] : mem_rdata;`
这种“看起来像真代码”的行 —— 现在的实现是
`assign cpu_rdata = hit ? data[align_index_r] : `NOP;`，两者不可混淆。

---

## ICACHE-2：时间对齐（原文件最关键的部分，所有寄存器都为它服务）

**位置**：文件头块注释中 `时间对齐` / `两个实测踩过的坑` 两节（原第 31~47 行）。

**原文**：

> ```systemverilog
>  * 时间对齐（本文件最关键的部分，所有寄存器都为这一条服务）：
>  *   一次取指横跨两拍，且“喂 BRAM 的地址”与“做判定的 index/tag”必须描述
>  *   **同一条请求**，判定还必须与 mem_rdata 落在同一拍：
>  *
>  *     拍 T   ：IFU 呈现 cpu_addr(T) = A
>  *     ── posedge T→T+1 ──
>  *              ① cpu_addr_r  <= A           // 喂 BRAM，下一拍才出数据
>  *              ② cpu_index_r <= A 的 index   // 必须同沿、同源，与①配对
>  *                 cpu_tag_r   <= A 的 tag
>  *     拍 T+1 ：align_index_r/align_tag_r（T→T+1 沿由②再寄存一拍）
>  *              与 mem_rdata(=A 的数据) 同拍 → hit/cpu_rdata/miss 全部对齐到 A
>  *
>  *   两个实测踩过的坑：
>  *   - ② 必须与 cpu_addr_r **同沿同源**，否则两者的请求会差一拍，
>  *     每条新指令都被误判成 miss（前端变成 3 拍走一条）。
>  *   - 判定不能挂在“本拍 cpu_addr”上：本拍 cpu_addr 已是**下一条**请求，
>  *     它的数据还在 BRAM 里。
> ```

**补充说明**：完整的 ASCII 时序图（拍 T / posedge / 拍 T+1 那三行）在正本里保留了
“两拍横跨”的骨架，但把三个编号 ①② 的寄存器采样关系改写成散文，
因为 RTL 里 `/* 请求侧寄存器 */` `/* 判定侧寄存器 */` 两段已经把 ①② 兑现了。
两个“实测踩过的坑”是 **A 类**（下一个人很可能会把 index/tag 换成当拍 cpu_addr，
让 3 拍走一条），正本各保留一行并标 `★ 不变量`。

---

## ICACHE-3：`fetch_align` 与 IFU 的契约

**位置**：文件头块注释中 `fetch_align 与 IFU 的契约` 一节（原第 49~56 行）。

**原文**：

> ```systemverilog
>  * fetch_align 与 IFU 的契约：
>  *   BRAM 的返回结果比 IFU 当前呈现的地址**晚一拍**，所以新地址出现的第一拍，
>  *   拿回来的还是**上一个**地址的结果。这一拍必须：
>  *     - 报 fetch_align=0（结果无效），
>  *     - 顺带把 hold 拉高，让 IFU 保持 PC（myCPU 已把 hold 并进 IFU_stall），
>  *   从而维持不变式「cpu_addr 稳定 ⇒ 返回结果属于当前 pc」。
>  *   如果这一拍就放行 PC，IFU 会把下一条地址的指令和上一条的返回错配，
>  *   而且会把别的地址的数据当成当前行填进缓存（污染后造成假命中）。
> ```

**补充说明**：A 类。这是 IFU 的 `inst_valid` / `mem_stall` 的来源，正本把
「cpu_addr 稳定 ⇒ 返回结果属于当前 pc」提为 `★ 不变量`，并补上
`hold` 与 `fetch_align` 各自的含义（C 类补充）。

### 同节里被改写措辞的两句（原文逐字，防止“改写被当成删除”）

> ```systemverilog
>  *   BRAM 的返回结果比 IFU 当前呈现的地址**晚一拍**，所以新地址出现的第一拍，
>  *   拿回来的还是**上一个**地址的结果。这一拍必须：
> ```
>
> ```systemverilog
>  *   miss 的额外代价固定 +1 拍。因为 PC 被停住，重试拍必然命中，miss 永不重复。
> ```

（正本的对应句只做了字数压缩，语义未变：`★ 不变量：新地址出现的第一拍必须报
fetch_align=0 并把 hold 拉高` / `miss 的额外代价固定 +1 拍，且永不重复`。）

---

## ICACHE-3b：访问时序（miss 路径）—— 原文逐字

**位置**：文件头块注释 `访问时序（miss 路径，PC 停在 A）` 一节（原第 58~63 行）。

**原文**：

> ```systemverilog
>  * 访问时序（miss 路径，PC 停在 A）：
>  *   T   : 呈现 A，采样 cpu_addr_r=A（这一拍返回的是旧结果，fetch_align=0 → 停拍）
>  *   T+1 : 本拍 fetch_align=1 且 miss → hold=1，前端继续停住；
>  *         同拍用 A 的 tag/valid + mem_rdata(=A 的数据) 回填整行
>  *   T+2 : PC 仍是 A，本拍 fetch_align=1 且 hit → 解除 hold，PC 前进
>  *   miss 的额外代价固定 +1 拍。因为 PC 被停住，重试拍必然命中，miss 永不重复。
> ```

**补充说明**：正本把它压缩成 4 行（T / T+1 / T+2 / 代价），**每一拍的语义都在**：
T 拍结果属于上一个请求 → 停；T+1 拍 miss → hold 且同拍回填；T+2 拍必然命中 → 放行。
原文里 `本拍` 这类重复限定词被删掉，属允许的改写；这里逐字保留以便逐拍对照波形。

---

## ICACHE-4：`resp_valid_r` —— 复位后第一条“垃圾数据”不能填缓存

**位置**：`logic resp_valid_r;` 声明处（原第 113~116 行）。

**原文**：

> ```systemverilog
>     // 返回侧寄存器是否已经装过一条**真实请求**。
>     //   reset / 第一个请求拍：align_*_r 还是复位值，而 mem_rdata 是复位前的
>     //   垃圾。如果不加这个限定，那一条垃圾数据会被写进缓存行，之后带着
>     //   valid=1 命中，整机就从这个错误指令开始跑（实测踩到过）。
> ```

**补充说明**：A 类（实测踩到过 → 会真坏）。正本压成 3 行 `★ 不变量`，
保留机制（垃圾数据 → 填行 → 假命中 → 从错误指令开始跑）。

---

## ICACHE-5：命中判定与写回的附加说明

**位置**：`assign hit` / `assign cpu_rdata` / `assign hold` / always_ff 内 `③ 判定与回填`
（原第 127~134、165~166 行）。

**原文**：

> ```systemverilog
>     // 未对齐或未命中时给前端灌 `NOP`，绝不把未就绪/别的地址的数据当指令。
> ```
> ```systemverilog
>     // 未对齐（结果还没回来）或未命中，都需要停一拍。
> ```
> ```systemverilog
>             // ---- ③ 判定与回填：只在结果确实属于当前请求时才动缓存 ----
>             //     这样新地址带来的废拍不会把别的地址的数据写进缓存行。
> ```

**补充说明**：三条都是 A 类语义，正本保留（措辞更短，`★ 不变量` 标注后语义强度未降）。
`hold = ~fetch_align | miss`、`miss` 时回填整行这两条机制保留。

### 同节里被改写措辞的两句（原文逐字，防止“改写被当成删除”）

> ```systemverilog
>  * ICache.sv — 直接映射指令缓存（上板改造：同步 BRAM）
> ```
> ```systemverilog
>     // 地址是否已经稳定到“当前这条请求”：新地址出现的第一拍，BRAM 返回的还是
>     // 旧地址的结果，这一拍必须报未对齐。
> ```

（正本对应句：标题改为 `（同步 BRAM：请求拍 + 响应拍）` —— “上板改造”属沿革，
两拍语义才是契约；`addr_same_r` 那句改为“地址是否已稳定到当前这条请求：新地址出现的
第一拍，BRAM 返回的还是旧地址的结果，这一拍必须报未对齐”，并补了
`cpu_en_r=0（复位后首拍）也算不稳定`。）

---

## ICACHE-6：输入/输出清单与计数器语义

**位置**：文件头块注释中 `输入 / 输出` 与 `计数器语义`（原第 7~18、65~67 行）。

**原文**：

> ```systemverilog
>  * 输入：
>  *   clk / reset        : 时钟与同步复位
>  *   cpu_addr           : IFU 当前取指地址（来自 PC，请求指针）
>  *   mem_rdata          : 来自外部 IROM 的指令数据（**同步读**，地址打一拍后返回）
>  * 输出：
>  *   cpu_rdata          : 送给 IFU 的指令（命中取缓存，未对齐/未命中给 `NOP）
>  *   mem_addr           : 送往 IROM 的地址（寄存输出，接 BRAM 地址口）
>  *   mem_en             : 本拍向存储器发起读（供 SoC 侧同步 ROM 做读使能）
>  *   fetch_align        : 本拍的返回结果是否**属于当前 cpu_addr 这条请求**
>  *   hit / miss         : 本拍访问结果（只有 fetch_align=1 时才有意义）
>  *   hold               : 本拍无法完成访问，需要把前端停一拍后重试
>  *   hit_cnt / miss_cnt : 累计命中 / 缺失次数
> ```
> ```systemverilog
>  * 计数器语义：
>  *   hit_cnt  : fetch_align=1 且命中 = 一次
>  *   miss_cnt : fetch_align=1 且未命中 = 一次（hold 持续多拍不会重复计数）
> ```

**补充说明**：正本把纯“顾名思义”的 `clk / reset` 两行删掉（风格指南 §4 明确禁止
“时钟信号/复位”型废话），其余端口语义一行不漏地保留在文件头的端口表里。
`hit / miss 只有 fetch_align=1 时才有意义` 与计数器不重复计数这两条是 A 类，保留。

---

## ICACHE-7：组织方式（行大小 / 无突发）

**位置**：文件头块注释 `组织方式`（原第 20~22 行）。

**原文**：

> ```systemverilog
>  * 组织方式：
>  *   行大小 1 个 32 位字（para.sv:ICACHE_INDEX_BITS/TAG_BITS，只有 index/tag、
>  *   没有 offset），因此**不需要突发**，miss 的语义就是“废掉一拍再重试”。
> ```

**补充说明**：正本保留为一行（“行大小 = 1 个 32 位字 → 不需要突发；miss = 废掉一拍重试”），
机制未丢。`para.sv` 的宏名（`ICACHE_INDEX_BITS` / `ICACHE_TAG_BITS`）保留。

---

## 本文件无需抽取的部分

本文件没有 `v9 修复（Bx）` 编号的战史段（它的“上板必炸”属于设计改造说明，
已是 A 类接口契约），所以 extract 里收录的是**被压缩措辞的那几段原文**，
以满足风格指南 §3 “宁可多记，不可漏记”。

---

### Branch_Predictor.sv

> 本文件保存 `E:\share doc\v9\Branch_Predictor.sv` 注释迭代中**被压缩或被改写的原文**，
> 以及本次补充的 C 类知识所引用的**权威出处**（原文逐字保留）。
> 源快照：`E:\FPGA\v9_vivado_ila\_comment_iter\before\core\Branch_Predictor.sv`（125 行 / 38 注释行）。
> 改后：192 行 / 105 注释行。
> 本文件里的编号 `BP-n` 就是改后注释中 `syn/修复史_全量.md §BP-n` 的锚点。

---

## BP-1：`Branch_Predictor.sv` 本身**没有任何 B 类故障战史**（原编号：无）
**位置**：全文件
**删掉的原文**：
> （无。源快照里 `Branch_Predictor.sv` 的注释只有模块头两段说明与 3 行行末注释，
> 没有任何 `v9 修复（Bx）`、实测波形数字或"试过几版"的过程记录；
> 经 `tools/check_extract_coverage.py --show Branch_Predictor.sv` 复核：
> 被删/改写 0 行。本文件的注释迭代是**纯 A 类保留 + C 类补充**。）
**补充说明**：因此 BP 侧唯一需要"搬"进 extract 的，是那条**跨模块**约束 ——
"预测跳转必须与顺序推进用同一个接受条件"。它的原文与受害现场都在 `IFU.sv`
（本模块没有办法自己保证它），逐字抄录在下面 BP-2。

---

## BP-2：预测跳转必须与顺序推进用同一个接受条件（原编号：v9 修复 B4，原文在 IFU.sv）
**位置**：`IFU.sv` 的 `assign pred_take_en = ...` 上方的 `v9 修复（B4）` 段
（权威出处；`Branch_Predictor.sv` 的接口契约块里引用了它，锚点落在本节）
**删掉的原文**：
> // v9 修复（B4）：**预测跳转必须与顺序推进用同一个“本拍确实接收了这条指令”条件**。
> //   原式 `pred_taken & inst_valid` 少了 valid/ready/~stall：当前这条指令还没被 IDU
> //   锁存（停拍 / valid=0）时就把 PC 拨到预测目标，这条指令（很可能正是一条分支）
> //   就被**丢掉**了 —— 它本该做出的"预测对不对"的判定再也没人做。
> //   预测器一旦学会 taken，于是每次撞上取指 hold 就少判一条分支，循环彻底失控
> //   （实测 loop_min 的 x1 涨到 2491，应为 10；同一程序在自带测试台上逐位复现）。
> //   现在：只有这一拍确实交付并接收了指令，才允许投机拨 PC；否则保持 PC，
> //   等这条指令被接收后再拨（或由 EX 级的真实重定向接管）。
>
> assign pred_take_en = pred_taken & advance_en & ~stall;
**补充说明**：`advance_en = valid & ready & inst_valid`（`IFU.sv`）。
本模块（Branch_Predictor）只输出"建议"（`pred_taken`/`pred_target`），
**接受条件在 IFU**；但两侧必须同拍同条件，否则会出现
"预测说跳了、PC 没跳"，而 `Control` 侧比较 `actual_taken == EXU_pred_taken` 认为没错 ——
这条分支被丢掉却无人纠正（`docs/模块阅读文档.md` §9.2b 第 4 条同款记载）。
另：`loop_min` 里 x1 涨到 2491 这个症状，在 `Control.sv` 侧还有一个同根因的侧面
（`EXU_inst_clear` 的 `mem_stall` 项不能作用于分支/跳转），见本目录 `Control.sv.md` §CONTROL-9。

---

## BP-4：方向计数器在"预测时用过的索引"上更新（原编号：无 B 类编号）
**位置**：`EX 级：更新` 的 `if (update_en)` 块内
**删掉的原文**：
> // 方向计数器：在“预测时用过的索引”上更新
**补充说明**：这句在改后被**并入** `★ 不变量：PHT 必须索引 update_index（预测拍随指令下传的
gshare 索引），不能用 update_pc 现算的 uidx`（原因在同一注释块里：GHR 在 IF→EX 之间已左移，
现算索引会打到另一个表项，预测永远学不会）。★ 该不变量在 `Branch_Predictor.sv` 中保留，
在 extract 里与之等价的完整表述见本节与 §BP-3。

---

## BP-3：gshare 索引 / 位宽参数 / IF-读-EX-写的 C 类补充所依据的原文（原编号：无）
**位置**：模块头"结构 / 端口 / 预测规则 / 更新规则"四段
**删掉的原文**：
> // 结构：
> //   - GHR ：HIST_BITS 位全局历史，每次 EX 级解析一条控制流指令就左移一位；
> //   - PHT ：1<<INDEX_BITS 项 2 位饱和计数器，索引 = pc[INDEX+1:2] ^ GHR；
> //   - BTB ：1<<INDEX_BITS 项 {valid, tag, target}，按 PC 索引，保存跳转目标。
> //
> // 端口：
> //   IF 级查询（组合）：
> //     fetch_pc -> pred_taken / pred_target / pred_index
> //     pred_index 是本次实际用到的 PHT 索引，必须随指令下传，
> //     否则流水线里 GHR 变化后会在错误的表项上更新。
> //   EX 级更新（同步）：
> //     update_en/update_pc/update_index/update_taken/update_target/update_correct
> //
> // 预测规则：BTB 命中 且 PHT 计数器最高位为 1 → 预测 taken。
> // 更新规则：
> //   - 方向：在 update_index 处饱和 +1 / -1；
> //   - 目标：taken 时刷新 BTB（valid/tag/target）；
> //   - 历史：GHR <= {GHR[HIST-2:0], update_taken}。
**补充说明**：改后这些原文**全部保留**，并在其下补了三块 C 类内容（本次重点）：
1. **位宽三参数的确切含义**：`INDEX_BITS`（表项数 `1<<INDEX_BITS`，索引取
   `pc[INDEX_BITS+1:2]` —— 跳过低 2 位是因为指令地址 4 字节对齐，参与索引的是字地址）、
   `TAG_BITS`（BTB 标签取 `pc[31:INDEX_BITS+2]`，与索引切片不重叠、合起来覆盖整个 PC）、
   `HIST_BITS`（GHR 位数，也是异或时参与的低位位数，要求 `HIST_BITS <= INDEX_BITS`）。
   默认值在 `para.sv`：`BP_INDEX_BITS=6`、`BP_TAG_BITS=(32-6-2)=24`、`BP_HIST_BITS=6`。
2. **读在 IF 级 / 写在 EX 级的时机**：IF 级 `assign` 是纯组合查询，用的是**查询当拍**的 GHR；
   写口在 EX 拍的 `always_ff` 里，且全部门控在 `update_en` 上。
   因此 `gidx`（预测时用过的索引）必须随指令经 `IDU/EXU` 流水寄存器下传为
   `update_index`；IF→EX 之间 GHR 已经左移过，**用 `update_pc` 现算的 `uidx` 去索引 PHT
   会打到另一个表项**。`uidx/utag` 只用于 BTB（BTB 是 PC 的一对一映射，不能异或 GHR）。
3. **反直觉写法标注**：`pht[i] <= 2'b01`（弱不跳转）是有意的复位值 —— 冷启动先倾向
   顺序执行；BTB 只在 `update_taken` 时分配/刷新，不 taken 时保持原值。

---

## 二、译码与寄存器堆

### IDU.sv

本文件记录 `IDU.sv` 注释迭代中被**压缩 / 改写**掉的原文（逐字保留）。
RTL 里的 `→ §IDU-n` 指针指向本文件的二级标题，编号一一对应。

---

## IDU-1：译码级指令本体引出（inst_d_out → EXU.fault_inst_in → mtval）

**位置**：端口 `output [31:0] inst_d_out,` 之前；以及 `assign inst_d_out = inst_d;` 之前
**原编号**：v9 修复（C4 遗留）
**删掉的原文**：

> // v9 修复（C4 遗留）：**译码级指令本体引出**。
> //   为什么必须有这个口：EXU 的 fault_inst_in（非法指令编码 → mtval）要的是
> //   "和 illegal_flag 同一拍的那条指令"。而 illegal_flag 是由本模块译码级寄存器
> //   inst_d 组合译出来的（见下面 legal_inst / illegal_flag），所以正确的源就是
> //   inst_d —— 注意**不是** IFU_inst：inst_d(T) = inst(T-1) = IFU_inst(T-2)，
> //   中间隔着两级流水寄存，取错会错两拍（停顿期间更是完全对不上）。
> //   myCPU 原来把 EXU 的 fault_inst_in 接到一个名为 IDU_inst 的信号上，而
> //   IDU_inst 在 myCPU.sv 里**从未声明** → Verilog 隐式推断成 1 位网，
> //   iverilog -Wall 直接报：
> //     myCPU.sv:599: warning: implicit definition of wire 'IDU_inst'.
> //     myCPU.sv:537: warning: Port 27 (fault_inst_in) of EXU expects 32 bits, got 1.
> //   于是 mtval 的低 1 位悬空、高 31 位恒 0，异常现场彻底不可读。

同一主题在 `assign inst_d_out` 处的另一段原文：

> // v9 修复（C4 遗留）：把译码级指令本体送出去给 EXU 当 fault_inst_in（→ mtval）。
> //   与 illegal_flag / mem_misalign 同拍同源（都由 inst_d 组合译出），
> //   所以 EXU 在锁存非法标志的那一拍锁存的正是**出错的那条指令**。

**补充说明**：这是"隐式线网"型 bug 的典型 —— 代码能编译、仿真能跑，
只是 mtval 的高 31 位恒 0，看起来像"ILA 没接对"。iverilog `-Wall` 的两条 warning
是唯一线索，别把 `implicit definition of wire` 当噪声跳过。

---

## IDU-2：valid_next 不能跟着 stall 一起拉低（否则 EXU 死锁）

**位置**：`assign ready_last` / `assign valid_next` 之间
**删掉的原文**：

> // valid_next 不跟 stall 一起拉低：v9 的 EXU 只在 valid_last=1 时才更新自己的
> // 流水寄存器（见 EXU.sv 的 always_ff 条件），把 valid_next 打成 0 并不会“灌气泡”，
> // 只会让 EXU 永远保持上一条指令 —— 实测会直接死锁（EXU 一直占着 load，
> // exu_load_use 永远为 1）。load-use 冒险靠 Control 的 EXU_inst_clear 处理：
> // 提前收走的那一份被清成空操作，指令仍留在 IDU，暂停解除后再送一次。

**补充说明**：v9 的 valid/ready 是**当拍电平**而不是事务令牌，所以"灌气泡"
在这里不成立：EXU 的流水寄存器只在 `valid_last=1` 时更新，`valid_next=0`
的真实效果是"EXU 定格"而不是"插入空操作"。真正的气泡由 Control 的
`EXU_inst_clear` 把控制位清 0 得到。

---

## IDU-3：ecall / mret / fence.i 只有一拍宽（B9 的直接原因）

**位置**：`assign ecall_flag / mret_flag / fence_i_flag` 之前
**删掉的原文**（本文件里这一主题的原始注释只有这一行，改写后已并入 5 行版）：

> // 三条特殊系统路径都在译码级尽早识别，后续统一交给 Control 决定是否重定向 PC。

**补充说明**（细节来自 IFU.sv 的 B9 一节，此处只做交叉索引）：
这三个标志是 `inst_d` 的组合函数、**没有锁存**；而 `dnpc_flag` 同时就是 IDU 的
`flush`（`myCPU.sv` 里 `.flush(dnpc_flag)`），请求发出那一拍 IDU 就把两级灌成 NOP
→ 标志下一拍照原消失。对 Control 而言它们就是**单拍脉冲**。
Control 只给分支误预测建了 `bp_misp_pend` 挂起重发，ecall / mret / fence.i / trap
**没有任何重发机制** —— B9 的真凶就是它被同拍背压（`IFU_stall=1` → `ready=0`）吃掉：
`mtvec=0` 明明已经算对，PC 却从此顺序爬行，`mepc` 每绕 IROM 一圈才更新一次。
完整定位过程与上板 ILA 证据见 IFU.sv 的抽取条目。

---

## IDU-4：非法指令检测 + 非法指令"必须没有任何副作用"

**位置**：`legal_inst` 判定段；`R_wen_next / mem_wen / mem_ren` 清零段
**原编号**：v9 新增（C4）/ v9 修复（C4）
**删掉的原文**：

> // =====================================================================
> // v9 新增（C4）：**非法指令检测**
> // ---------------------------------------------------------------------
> // 原实现里所有译码都是"匹配不上就当加法"（`cond_*` 全 0 时 alu_opcode 落到
> // `alu_add）—— 于是一条非法指令既不会报异常，还会被当成 add 执行掉、写坏 rd。
> // 这里按 RV32I/RV32M 的合法编码逐条判定，任何"落在某个合法 opcode 下、
> // 但 funct3/funct7 组合不认识"的指令都判为非法，并强制清掉所有副作用。
> //
> // 合法子类型（只列本核实现的部分；未实现的合法指令也一律当非法处理，
> // 因为"没实现"意味着执行它必然产生错误结果，报异常才是正确语义）：

> // ---------------------------------------------------------------------
> // v9 修复（C4）：非法指令**必须没有任何副作用**。
> //   下面这几路是唯一能产生架构可见副作用（写寄存器堆 / 写内存 / 写 CSR /
> //   改 PC）的信号，一律与 legal_inst 相与。
> //   注意：不加这一层的话，非法指令会带着"匹配不上就当加法"的默认译码
> //   （R_wen_next 默认 1、alu_opcode 默认 alu_add）被真的执行掉并写坏 rd。
> //   branch_flag/jump_flag 也要清：它们会让 EXU 去算重定向并触发预测校验，
> //   和异常重定向抢同一个 dnpc。
> // ---------------------------------------------------------------------

同一主题的另外两段原文：

> // 对外标志：本拍 ID 级的指令非法。下游据此**清掉所有副作用**并触发异常。

> // ---------------------------------------------------------------------
> // v9 新增（C4）：统一"不得产生任何架构副作用"的条件。
> //   非法指令、以及非对齐访存，都不允许写寄存器堆 / 写内存 / 写 CSR / 改 PC；
> //   异常自身的登记（mepc/mcause/mtval）由 CSR 走独立的异常通道完成。
> //   **必须在第一次被使用之前声明**（ModelSim vlog-2730 对后置声明硬报错）。
> // ---------------------------------------------------------------------

**补充说明**：`alu_opcode` 的最后一档是 `cond_equal ? alu_equal : alu_add`，
即"所有白名单都不匹配 → 当加法"。所以合法性**只能**由 `legal_inst` 显式判定，
不能指望 ALU 操作码选择里报错；`illegal_flag` 必须由 `opcode_known` +
各 opcode 子类型判定相与得到。

---

## IDU-5：csr_wen_next 位图必须与 no_side_effect 相与

**位置**：`assign csr_wen_next = ...` 之前
**原编号**：v9 修复（C4）
**删掉的原文**：

> // CSR 写使能位图：每种 CSR 占一位；软件写会在 WB 级真正生效（见 CSR.sv）。
> //   低 4 位保持与 v8 兼容（mepc/mcause/mstatus/mtvec），高位扩展中断相关 CSR。
> //   v9 修复（C4）：整张位图与 no_side_effect 相与 ——
> //   非法指令与非对齐访存都不得写任何 CSR。

**补充说明**：位号来自 `para.sv` 的 `CSRW_*`（bit0=mepc … bit7=mtimecmp）；
每一位都带 `is_SYS` 门控，所以"非 SYSTEM 指令写 CSR"这条路本身是关死的。
与 `no_side_effect` 相与是第二道闸：异常现场不能被出错的那条指令自己覆盖。

---

## 附：本文件其余被改写 / 压缩掉的原文（逐字）

> // 译码级负责把原始指令翻译成三类信息：
> // 1. 数据通路控制：ALU 操作数、写回使能、访存读写。
> // 2. 控制通路信息：branch/jump/ecall/mret/fence.i 等重定向事件。
> // 3. 系统路径入口：CSR 地址与 CSR 写使能，用于把异常/返回并入统一控制流。

> // v9 新增（C4）：本拍 ID 级指令非法（未实现/编码错误）。下游据此清掉
> //   所有副作用并触发 mcause=2 的非法指令异常。

> // v9 新增（C4）：访存地址非对齐。按 RISC-V 语义只有**有效地址**参与判定，
> //   地址 = rs1 + imm，所以在 ID 级就能算出来并当拍判定（不依赖 ALU 结果，
> //   不给 EXU 的关键路径添负担）。funct3 顺带送出去，供 mcause 区分 4/6。

> // v9 新增（C4）：mtval 观察口（非法指令编码 / 非对齐地址）。
> //   从 Reg_Stack 直通上来，引到 myCPU 顶层 debug 端口。

> // v9 新增（C4）：mcause 观察口（异常/中断原因码），同样引到顶层 debug 端口。

> // 第一级流水寄存：从 IFU 接住原始指令。flush 时主动灌入 NOP。

> // 第二级译码寄存：把译码看到的 inst/snps/pc 再稳定一个拍，便于后续组合译码和前递选择。

> // 指令类型译码位：**必须先声明**再用（下方 csr_wen_next 位图要用 is_SYS）。

> // OP-IMM：先用 funct3 的"移位类"特征分两类，再对移位类单独校验高 7 位。
> //   funct3=001 (slli) → 高 7 位必须 0000000。
> //   funct3=101 (srli/srai) → 高 7 位 0000000 或 0100000。
> //   其余 funct3（000/010/011/100/110/111）高 7 位无约束。
> //   srl/sra 的 funct7 数值与 sub 相同（0100000），复用宏即可。

> // OP（R 型）：funct7 只允许 0000000 / 0100000 / 0000001（RV32M）；
> //   且 0100000 只对 add/sub 与 srl/sra 有意义（funct3=000、101）。

> // SYSTEM：funct3=000 是特权指令（ecall/ebreak/mret/wfi，由常量比较单独识别）；
> //   funct3=001/010/011 是 CSR 指令（CSRRW/S/C），其余 funct3 非法。

> // rd_value_next 代表“无需再经过 ALU/访存加工即可写回”的结果：
> // 跳转类返回 snpc；系统指令（含 CSRR，即使不写 CSR）返回读出的 CSR 值。

> // -----------------------------------------------------------------------
> // v9 新增（C4）：访存地址非对齐判定
> // -----------------------------------------------------------------------
> // RISC-V 规定：有效地址由 rs1 + 符号扩展立即数得到；宽度由 funct3 决定。
> // 判定必须只看**有效地址**，与 base 是否对齐无关（例如 base=1、offset=-1
> // 得到地址 0，这是合法的字访问）。
> //   字节 (b=0)：永远对齐
> //   半字 (b=1)：地址 bit0 必须为 0
> //   字   (b=2)：地址低 2 位必须为 00
> // is_I0 = load，is_S = store；两者都用 rs1 + imm 形成地址，
> // 所以这里用 EXU_rs1_in（已经过前递的 rs1）直接算，不需要等 ALU。
> // 非法指令不参与（illegal_flag 优先，且它的 R_wen/mem_* 已经被清掉）。

> // ---------------------------------------------------------------------
> // ALU 操作码选择：
> //   RV32M 具有最高优先级（funct7=0000001），否则按功能选择普通整数运算。
> //   分支比较与普通算术共用同一套 ALU 编码，后续由 EXU 取最低位作为条件判定结果。
> // ---------------------------------------------------------------------

> // Reg_Stack 把通用寄存器堆和 CSR 空间并排组织，译码级在这里同时拿到整数寄存器值与系统寄存器值。

---

### Reg_Stack.sv

本文件记录 `Reg_Stack.sv` 注释迭代中被**压缩 / 改写**掉的原文（逐字保留）。
RTL 里的 `→ §REGSTACK-n` 指针指向本文件的二级标题。

> 说明：这个文件原本只有 15 行注释（整个仓库注释最稀薄处之一），本次以
> **C 类补写**为主（层级 / 三级流水携带什么 / CSR 与 Reg 怎么组合 / 观察口从哪来），
> B 类"故障战史"只有下面两段，已逐字归档。

---

## REGSTACK-1：mtval 引出（原本是死寄存器 + 漏驱动）

**位置**：输出口 `output logic [31:0] mtval_out,` 之前
**原编号**：v9 新增（C4）
**删掉的原文**：

> // v9 新增（C4）：mtval 引出来（原来它是个死寄存器，现在真正落地了，
> //   引到顶层供软件/测试台读取"出错指令编码 / 出错地址"）

**补充说明**：这条"引出"之所以不能少，是因为 mtval 的价值全在**可读**：
CSR 里 `mtval_reg` 写入通路（v9 C4 修复）、读通路（`csrs` 多路选择里的
`CSR_mtval` 一项，见 §REGSTACK-2）与引出这三个环节任意一处缺失，软件读 mtval
都只能读到 0；更隐蔽的是**综合器会把没人读的 `mtval_reg` 当死寄存器优化掉**
（`Synth 8-6014 Unused sequential element mtval_reg_reg was removed`），
上板现象是"mtval 恒 0"，第一反应会误判成 ILA 探针没接对。

---

## REGSTACK-2：补齐 mtval 的 CSR 读通路

**位置**：`assign csrs = ...` 之前
**原编号**：v9 修复（C4）
**删掉的原文**：

> // 读 CSR 时通过地址多路选择把不同系统寄存器并到统一返回口 csrs。
> // v9 修复（C4）：补上 mtval 的读通路 —— 以前 mtval_reg 是死寄存器，
> //   软件读 mtval 只能读到 0，异常现场无法定位。

**补充说明**：`csrs` 的地址多路选择是**纯组合**的，地址不匹配任何已实现 CSR
时返回 `32'd0`（RISC-V 允许读未实现的只读 CSR 返回 0）。所以漏掉一路的症状
不是 x、不是报错，而是"读到 0"—— 与"这个 CSR 本来就该是 0"完全无法区分。

---

## 附：本文件其余被改写 / 压缩掉的原文（逐字）

> // Reg_Stack 把整数寄存器堆与 CSR 空间封装在一起。
> // 对译码级来说，它相当于系统路径和普通数据路径的共同读入口：
> //   - rs1/rs2/a0 -> 通用寄存器组
> //   - csr_addr 经地址译码 -> 某个机器模式 CSR
> // v9 新增中断相关 CSR（mie/mip/mtime/mtimecmp/mscratch）与 intr_pending 输出。

> // x0 永远保持 0，因此即便上层误传 rd=0，也会被这里钳成 0。

> // CSR 子块维护异常/中断/返回相关机器态。

> // RegisterFile 子块维护通用整数寄存器。

---

### RegisterFile.sv

本文件记录 `RegisterFile.sv` 注释迭代中被**压缩 / 改写**掉的原文（逐字保留）。
RTL 里的 `→ §REGFILE-n` 指针指向本文件的二级标题。

---

## REGFILE-1：本寄存器堆没有复位 → 4 态仿真下 x0 是 x，污染整条数据通路

**位置**：文件头；以及 `integer i;` / `always_ff` 之前
**原编号**：v9 上板改造
**删掉的原文**：

> // 通用整数寄存器堆：两个读口、一个写口。
> // 这里保持最朴素的实现，便于教学时把注意力放在流水协同而不是寄存器堆优化上。
> // v9 上板改造：补上复位分支（reset 已由 Reg_Stack 接好），保证 x0 恒为 0。

> // 写回在时钟上升沿生效，读口保持组合直读。
> // reset 必须真正清空整个寄存器堆：否则 4 态仿真下 rf[0]（x0）恒为 x，
> // 任何以 x0 为源操作数的指令都会把 x 传播到全通路；
> // 上板时 BRAM 上电虽通常为 0，但显式复位才能保证与仿真同语义。
> // （复位分支里给 i 赋 0，满足“for 条件必须用到索引”的可综合写法要求。）

**补充说明**（仿真侧怎么处理，两处实现不一致是有原因的）：

- `sim/tb_iverilog.sv`：4 态仿真（iverilog）原本**靠测试台兜底** —— 在 0 时刻用
  层次化赋值把 `rf[0:31]` 全部预置成 `32'h0000_0000`（当"上电初值 0"用），
  `+raw_rf` 可关闭。它打印的告警原文就是
  `[TB] workaround: register file has no reset; preloaded rf[0:31]=0 (power-up value)`。
- `sim/tb_msim.sv`：**去掉了**这段预清，因为 ModelSim 的 `vopt-7061` 不允许对
  `rf` 做过程赋值（`(hier path: u_cpu.IDU_Inst0.Reg_Stack_inst0.Reg_inst.rf[])`），
  于是 ModelSim 侧完全依赖 RTL 里的 `reset` 分支 —— 这也是"reset 分支不能删"的直接理由。

现象层面的分辨方法：Verilator 是 2 态（未初始化 = 0）、FPGA 上 BRAM 上电也是 0，
所以**只有 4 态仿真（iverilog / ModelSim）会暴露**；一旦暴露，
`x0` 会把 x 传播进 ALU → 写回 → 再被读出来，波形上表现为"到处是 x"，
而不是某一条指令算错。

---

## 附：本文件其余被改写 / 压缩掉的原文

> （无：除上面这一条外，其余注释为本次新增的 C 类说明）

---

### Reg.sv

（本文件无需抽取：16 行正文的参数化寄存器模板，没有任何 B 类"故障战史"。
本次只把原文件头的两行说明扩写/收敛成"这是什么 + 例化方式 + 复位优先"7 行，
知识一条未减；下列原文仅供对照。）

## 附：改写前原文（逐字，供对照）

> // 通用可写寄存器模板。
> // 在本工程里既可作为普通流水寄存器，也可作为 CSR 存储单元。

## 备注：本次补写的关键点（原文没写、但从代码读不出来）

- 复位优先于写使能：`if (reset)` 在 `else if (wen)` 之前，`RESET_VAL` 是唯一初值来源。
- 例化方式与参数顺序：`Reg #(.WIDTH(32), .RESET_VAL(32'h0)) u_x (.clock, .reset, .din, .dout, .wen);`
  按位置传参时顺序是 `(WIDTH, RESET_VAL)`；默认值 `WIDTH=1 / RESET_VAL=0`。
- 现状：核内目前没有例化点（`CSR.sv` 直接用 `always_ff` 写），本模块保留为通用模板。

---

## 三、执行与运算

### EXU.sv

> 原文按行号从改动前快照 `_comment_iter/before/core/EXU.sv` **逐字取出**，
> 所以下面每一段都是"被删掉/被压缩掉的注释原文"，不是复述。
> 对应正本：`E:\share doc\v9\EXU.sv`（本次只改了注释，代码经 strip_sv_comments 校验为 CODE-IDENTICAL）。

## EXU-1：异常标志的清除必须独立于流水线握手（原编号：v9 修复 C4）

**补充说明**：

事故链条：异常标志原来和别的控制寄存器挤在同一个 always_ff 里，清除分支的条件是
`valid_last & ready_next & EXU_inst_clr`。trap 那一拍之后本级 valid_next 被清 0 →
下游 LSU 的 valid_reg=0 → LSU_ready=0 → ready_next=0，清除分支**永远不成立**；
而记录分支又要求 `valid_last & ~mdu_stall & ~bp_pend`（此时 valid_last 已是 0）。
结果异常标志卡死在 1：exc_pending 每拍成立、trap_take/trap_redirect 每拍都发，
PC 被反复重定向回 mtvec，陷阱处理程序的第一条都跑不完。
现实现：单列一个 always_ff，`if (reset | trap_take)` 清，不等任何握手。

**异常标志清除块的原文（EXU.sv 第 340-354 行）**

```systemverilog
// ---------------------------------------------------------------------------
// v9 修复（C4）：异常标志的清除必须**独立于流水线握手**，单独一个 always_ff。
//
//   踩到的坑（实测把 PC 锁在 mtvec 上）：异常标志原来跟其他控制寄存器写在同一个
//   always_ff 里，清除分支的条件是 `valid_last & ready_next & EXU_inst_clr`。
//   trap 那一拍之后：本级 valid_next 被清 0 → 下游 LSU 的 valid_reg=0 →
//   LSU_ready=0 → ready_next=0，于是"清除分支"永远不成立，而记录分支又要求
//   `valid_last & ~mdu_stall & ~bp_pend`（此时 valid_last 也已经是 0）——
//   异常标志**卡死在 1**：`exc_pending` 每拍都成立，trap_take/trap_redirect
//   每拍都发，PC 被反复重定向回 mtvec，陷入处理程序的第一条都跑不完。
//
//   修法：异常标志是"跟着指令走的一次性状态"，指令一旦被作废（EXU_inst_clr）
//   就必须立刻清掉，不需要等任何握手；其余情况正常跟随输入锁存。
//   清零优先于锁存，且两者互斥，不会出现多驱动。
// ---------------------------------------------------------------------------
```

**trap_take 端口处“为什么要单独一根线”的原文（第 83-89 行）**

```systemverilog
    // v9 新增（C4）：同步异常被**确认接收**的那一拍（单拍脉冲，来自 Control 的
    //   trap_take）。专门用来清异常标志，**不参与** EXU_inst_clr。
    //   为什么要单独一根线：EXU_inst_clear 在主冲刷（trap_redirect / bp_mispredict /
    //   intr_take）那一拍会把持续拉低本级 valid_next 直到流水排空，如果异常标志也
    //   挂在它上面清，就会出现"标志清不掉、而指令又推不出去"的僵局 ——
    //   实测现象是 EXU 卡在出错指令上、后续指令（包括陷阱处理程序）全部进不去。
    //   异常标志是"跟着这条指令走的一次性状态"，用一次性脉冲清最干净。
```

## EXU-2：bp_pend 期间只挡“接收”，不挡“清空/放行”（原编号：v9 修复 B7）

**补充说明**：

bp_pend = 误预测已确认但重定向还没送达 IFU（被取指侧 hold 挡住）。实测 rnd034：
错路径的 jal 把 x16 写坏。注意正在 EX 里那条被判错的跳转/分支仍要在重定向当拍
正常交给 LSU（jal 的 link 写回靠的就是这一拍）。

**原文（第 76-81 行）**

```systemverilog
    // v9 修复（B7）：误预测已确认但还没送达 IFU（被取指侧 hold 挡住）。
    //   这段窗口里本级**不能接收新指令**：否则错路径的那条会赶在重定向补发之前
    //   进入 EX 并被下游采走、提交（实测 rnd034：错路径的 jal 把 x16 写坏）。
    //   注意只挡住"接收"，不挡"清空"：正在 EX 里那条被判错的跳转/分支仍然要在
    //   重定向当拍正常交给 LSU（jal 的 link 写回靠的就是这一拍）。
```

## EXU-3：时序化 MDU 的“等结果”握手 + v9 修复 B3（重复发射 / 早解冻）

**补充说明**：

含两条死锁禁忌（① 清除/转移条件不能含 ready_next —— 它由本模块 mdu_stall 派生，
会成组合环；② 不能在结果窗口那一拍就解冻）、B3 的两个错位（旧操作码重复发射、
结果窗口结束就解冻）以及原三态状态机（WAIT→DONE→IDLE）为何简化成两态。
实测现象原文：连乘/连除只有第一条对、后续全 0；div_pair 里 div x4,x2,x2 期望 1、
实际拿到上一条 div x3,x1,x2 的 14（错位一条指令，链越长错得越远）。

**MDU 握手总说明（第 146-166 行）**

```systemverilog
    /* ---------------------------------------------------------------------
     * v9 上板改造：时序化 MDU 的“等结果”握手
     * ---------------------------------------------------------------------
     * MDU_pipelined 的操作数在 T 沿锁存，结果要到 T+1 沿之后才出现在 res 上
     *（比原来的纯组合 MDU 晚一拍；除法还要多等 32 拍迭代）。如果这一拍就放行
     * EXU/LSU，下游会把**还没更新的 EX_result 旧值**当成运算结果采走下去。
     *
     * 用三态显式状态机，避免“用信号自己清自己”造成的死锁：
     *   MDU_IDLE ：没有待处理的 M 指令
     *   MDU_WAIT ：已发射，等 MDU 出结果（冻结 EXU/LSU/前端）
     *   MDU_DONE ：结果窗口，结果稳定；仍然冻结，因为 LSU 要**下一个时钟沿**
     *              才把 EX_result 采走
     *   状态转换：IDLE --mdu_start--> WAIT --mdu_done--> DONE --(一拍)--> IDLE
     *
     * 两个必须避开的死锁（都实测踩到过）：
     *   ① 任何清除/转移条件都不能含 ready_next —— ready_next 由本模块的
     *      mdu_stall 派生，会形成组合环，状态机永远出不来。
     *   ② 不能在结果窗口那一拍就解除冻结：done 只高 1 拍，而 LSU 是在它之后
     *      那一拍才采走 EX_result；早一拍解冻会让同一条指令被重复发射，
     *      结果被覆盖（现象：连乘/连除只有第一条对，后续全 0）。
     * ------------------------------------------------------------------- */
```

**B3：mdu_start 增加“已发射”标志（第 185-190 行）**

```systemverilog
    // v9 修复（B3）：再加一层“这条指令已经发射过”的标志。
    //   原式 `(state==IDLE) & opcode_reg[4]` 会在结果窗口结束、回到 IDLE 的那一拍
    //   **用还没被换掉的旧 M 操作码再发射一次**（操作数寄存器在同一沿已经换成下一
    //   条指令了），于是 MDU 把上一条的运算又算了一遍，结果被当成下一条指令的结果
    //   锁进 mdu_res_reg —— 实测 div_pair：`div x4,x2,x2` 期望 1，实际拿到上一条
    //   `div x3,x1,x2` 的 14（错位一条指令，链越长错得越远）。
```

**B3：冻结条件改成看本条指令自己的结果（第 192-195 行）**

```systemverilog
    // v9 修复（B3）：冻结条件改成“EX 级是 M 指令、且**它自己的**结果还没锁存”。
    //   原式只看状态机 WAIT/DONE：结果窗口结束那一拍解冻，而这一拍 EX 已经换成
    //   下一条指令、mdu_res_reg 却还是上一条的结果 → 下游把它采走。
    //   现在只要 EX 里的 M 指令没拿到自己的结果就一直冻结，跨过整个“换指令”的边沿。
```

**两态状态机的说明（第 233-236 行）**

```systemverilog
    // MDU 状态机（v9 修复 B3 后简化为 IDLE/WAIT 两态）：
    //   IDLE --start--> WAIT --done--> IDLE
    //   “结果窗口再多停一拍”的职责已经由 mdu_stall = opc[4] & ~mdu_res_vld 承担，
    //   不再需要第三个状态（原来 WAIT→DONE→IDLE 的 DONE 拍正是错位的来源）。
```

## EXU-4：MDU 结果总线 mdu_res 必须先声明（隐式 1 位 wire 事故）

**补充说明**：

若在使用之后再声明，按 Verilog 隐式网络规则 mdu_res 会被当成 1 位隐式 wire：
ModelSim vlog-2730 直接硬报错，iverilog 宽容通过但语义不可移植 —— 乘除法结果
整体失真。

**原文（第 228-230 行）**

```systemverilog
    // MDU 结果总线：**必须先声明**再用。否则按 Verilog 隐式网络规则，
    //   第 206 行的 mdu_res 会被当成 1 位隐式 wire（ModelSim vlog-2730 直接硬报错，
    //   iverilog 宽容通过但语义不可移植）——乘除法结果会整体失真。
```

## EXU-5：valid_next 在下游未就绪（~ready_next）时也必须冻结（v9 上板改造修正）

**补充说明**：

上板把访存/取指换成同步 BRAM 后多了 mem_hold，LSU 会被整条冻结、ready_next(=LSU_ready)=0。
原来这一拍会走到最后一个 else 把 valid_next 清 0，而数据/控制寄存器是**冻结保持**的
（只在 valid_last & ready_next 时更新）→ “payload 还在、valid 已经掉了”：这条指令随后
被 LSU 收下时 valid=0，写回被 WBU 的 R_wen & valid 掐掉。实测现象：lw 后面紧跟的 add
算出正确结果 0x11 却写不回 x7（x7 恒为 0）。

**原文（第 202-214 行）**

```systemverilog
    // valid_next 体现执行级是否向后级真正送出一条有效指令；
    // 若收到 EXU_inst_clr，则说明该条指令因重定向/停顿需要被清空。
    // mdu_stall 期间必须**冻结 valid**，否则会在结果还没回来时就把这条 M 指令
    // 放行下去（现象：debug_wb_pc 对、debug_wb_value 错或为 0）。
    // v9 上板改造修正：**下游没准备好时也必须冻结 valid**（~ready_next）。
    //   上板改造把访存/取指换成同步 BRAM 后多了 mem_hold，LSU 会被整条冻结，
    //   此时 ready_next(=LSU_ready) 为 0。原来这一拍会走到最后一个 else，
    //   把 valid_next 清 0 —— 但本级的**数据/控制寄存器是冻结保持的**
    //   （它们只在 valid_last & ready_next 时更新），于是出现“payload 还在、
    //   valid 已经掉了”的错配：这条指令随后被 LSU 收下时 valid=0，
    //   写回被 WBU 的 R_wen & valid 掐掉 —— 实测 lw 后面紧跟的 add 就是这样
    //   算出正确结果 0x11 却写不回 x7（x7 恒为 0）。
    //   冻结后行为与数据寄存器一致：hold 结束的这一拍 valid 仍为 1，下游正常收下。
```

## EXU-6：mdu_start 的触发点必须是已锁存的 alu_opcode_reg[4]，不能用输入端口

**补充说明**：

输入端口属于“下一条将要进入 EX 的指令”，而 MDU 的操作数是 add1_reg/add2_reg；
用端口触发会让状态机比操作数早一拍进 WAIT，届时 operands 还没锁存、MDU 也没收到
start，done 永远不来 → 死锁。实测：state 卡在 WAIT、res 恒 0。

**原文（第 180-184 行）**

```systemverilog
    // 触发点必须是**已锁存**的 alu_opcode_reg[4]，不能用输入端口 alu_opcode：
    //   输入端口属于“下一条将要进入 EX 的指令”，而 MDU 的操作数是 add1_reg/
    //   add2_reg。若用输入端口触发，状态机会比操作数早一拍进入 WAIT，
    //   结果 operands 还没锁存、MDU 也没收到 start，done 永远不来 → 死锁
    //   （实测：state 卡在 WAIT、res 恒 0）。
```

## EXU-7：异常输出必须与 valid_next 相与（否则 PC 被反复重定向、整机锁死）

**补充说明**：

实测就是这么锁死的：非法指令本身正确陷入了（mcause=2 / mepc=0x20），但异常标志
“粘”在 EXU 上，陷阱处理程序的第一条永远进不去 —— 加这一层后解掉。
Control 侧 `exc_pending = exc_any & EXU_valid` 是同一口径的第二道兜底。

**原文（第 410-415 行）**

```systemverilog
    // v9 新增（C4）：异常输出（已锁存，与 EX 级当前指令一一对应）。
    //   **必须与 valid_next 相与**：只要出现过一次"指令不在 EX 里、但异常位还留着"
    //   的窗口，下游就会在流水线空转期间反复看到 exc_pending，把 PC 反复重定向，
    //   整机锁死。实测就是这么锁死的：非法指令本身正确陷入了
    //   （mcause=2 / mepc=0x20），但异常标志"粘"在 EXU 上，
    //   陷阱处理程序的第一条永远进不去 —— 加这一层后解掉。
```

## EXU-8：为什么把原组合 MDU 换成 MDU_pipelined（整机最长组合路径）

**补充说明**：

原 MDU.sv 把「3 个 32x32 乘法器 + 32 级恢复余数除法链」全塞进 EX 一级组合逻辑，
是整机最长组合路径，FPGA 上很难收敛。原文给的综合报告数据：**2150 LC / 419 CARRY4**；
时序化后乘法单拍、除法 32 拍迭代，规模降到约 1/5。（新注释里保留了“最长路径”这一
结论与“操作数必须用锁存值”的不变量，具体数字移到这里备查。）

**原文（第 434-440 行）**

```systemverilog
// MDU 与 ALU 并行工作，仅当编码最高位为 1（RV32M）时其输出被选中。
// v9 上板改造：换成**时序化**的 MDU_pipelined（experimental/MDU_pipelined.sv）。
//   原 MDU.sv 把「3 个 32x32 乘法器 + 32 级恢复余数除法链」全塞进 EX 一级
//   组合逻辑，是整机最长组合路径，FPGA 上很难收敛（综合报告：2150 LC / 419 CARRY4）。
//   时序化后：乘法单拍、除法 32 拍迭代，规模降到约 1/5。
//   操作数用已锁存的 add1_reg/add2_reg（不能用端口 add1/add2，它们会随流水线变），
//   与 MDU_pipelined 头部说明的“必须用锁存值”一致。
```

## EXU-9：原模块简介（已并入新的文件头，信息未减少）

**补充说明**：

新文件头保留了“锁存译码来的操作数/控制位”“分支看 ALU 最低位”“跳转/CSR 把结果送往
最终收束点”三点，并补上流水线定位与接口契约。

**原文（第 3-4 行）**

```systemverilog
// 执行级把译码得到的操作数和控制信号锁存下来，输出算术结果与分支判定结果。
// 对分支而言，ALU 的最低位就是条件真假；对跳转/CSR 而言，重点是把结果继续送往最终收束点。
```

## EXU-10：附录：其余被改写/压缩的注释原文（信息已全部并入新注释，原文备查）

**补充说明**：

这些块不是故障战史，只是措辞压缩/重新归类；逐字保留原文以防“改写中丢知识”。

**异常输入端口（第 33-36 行）**

```systemverilog
    // ---- v9 新增（C4）：异常输入 ----
    // 都由 IDU 在同一拍给出（与 IDU_* 控制位同源、同拍到），本模块只做"锁存 + 汇总"。
    //   illegal_in     : 本条指令非法（编码不认识）
    //   mem_misalign_in: load/store 有效地址非对齐（地址已在 IDU 算好）
```

**fault_inst_in 的配对要求（第 40-41 行）**

```systemverilog
    // 本拍 ID 级指令的原始编码：非法指令异常要用它写 mtval（出错指令编码）。
    //   注意这里用 **IDU 当前译码的 inst_d**，与 illegal_in 同源同拍。
```

**时序化 MDU 握手端口说明（第 69-72 行）**

```systemverilog
    // ---- v9 上板改造：时序化 MDU 握手（MDU_pipelined.sv）----
    // 接入后乘除法不再用一级组合逻辑算完，而是走 MDU_pipelined：
    //   mul*  ：单拍出结果（busy 恒 0）
    //   div*  ：多拍迭代（busy 期间整机冻结）
```

**异常输出端口的优先级说明（第 92-95 行）**

```systemverilog
    // ---- v9 新增（C4）：异常输出（已锁存，与 EX 级当前指令一一对应）----
    // 优先级由 Control 决定：非法指令 > 访存非对齐 > 指令地址非对齐。
    //   iaddr_misalign_exc 用**实际**目标地址判定（branch 用 branch_pc_reg，
    //   jal/jalr 用 EX_result)，不是预测目标。
```

**fault_inst_exc 端口（第 100 行）**

```systemverilog
    // v9 新增（C4）：出错指令的原始编码（随流水锁存），供 mtval 使用
```

**异常状态寄存器组（第 131 行）**

```systemverilog
    // ---- v9 新增（C4）：异常状态寄存器（与 EX 级当前指令一一对应）----
```

**branch_target_low2 具名 wire（第 138-142 行）**

```systemverilog
    // v9 新增（C4）：EX 级"实际跳转/分支目标"的低 2 位。
    //   分支与 jal 在 IDU 里都映射成 add1 + add2（PC + imm）的加法，
    //   jalr 的目标 bit0 被硬件清零、天然对齐，所以这里统一用加法结果判断。
    //   提取成一个具名 wire 是必须的：SystemVerilog/Verilog 不允许对表达式结果
    //   直接做位选（`(a+b)[1:0]` 会报 vlog-13069 syntax error）。
```

**mdu_busy 与下游同一口径冻结（第 197-198 行）**

```systemverilog
    // 下游（LSU）与前端必须和 EXU 用**同一口径**冻结：EXU 在等 MDU 结果时，
    //   LSU 也要停，否则它会在“EX 已换指令、结果还是旧的”那一拍把旧结果采走。
```

**每条 M 指令只发射一次（第 250 行）**

```systemverilog
            // 每条 M 指令只发射一次：发射后置位，直到这条指令离开 EX 才清。
```

**结果窗口必须锁存 mdu_res（第 253-255 行）**

```systemverilog
            // 在结果窗口把 MDU 结果**锁存**下来。
            //   为什么要锁：MDU_pipelined 的 res 在结果窗口之后就不再保持
            //   （mul 会被下一次 start 清 mul_stb、div 的 div_hold 也会撤销）。
```

**离开 EX 时清发射/结果标志、与结果窗口互斥（第 261-264 行）**

```systemverilog
            // 这条指令被下一级收下（离开 EX）时，发射/结果标志一起清，
            // 供**下一条** M 指令重新走一遍握手。
            //   与上面的分支互斥：mdu_done_i 那一拍 mdu_stall=1（结果还没置位），
            //   而这里要求 ~mdu_stall。
```

**控制寄存器与数据寄存器分开写（第 300 行）**

```systemverilog
// 这组控制寄存器与数据寄存器分开写，便于清楚观察“数据本身”和“是否允许副作用”两类信息。
```

**指令地址非对齐的判据：只用已锁存信号、给关键路径减负（第 367-375 行）**

```systemverilog
        // 指令地址非对齐：**实际**目标地址必须 2 字节对齐（基础指令集要求）。
        //   分支：实际目标是 branch_pc = PC + imm_B
        //   jal ：实际目标是 PC + imm_J
        //   jalr：实际目标是 (rs1 + imm) 且 bit0 被硬件清零，天然对齐，不会触发
        // 判据只看"低 2 位是否为 0"，两种情况可以用同一个加法表示 ——
        // 分支与 jal 在 IDU 里都被映射成 add1/add2 的加法（PC + imm），所以直接
        // 用**已锁存**的 add1_reg/add2_reg 算，不引用下面后置声明的 exec_res。
        // 门控用已锁存的 branch_flag_reg/jump_flag_reg，属于 EX 级寄存器边界
        // 之后，不给跨级关键路径添负担。
```

**inv_flag_reg 的统一取反（第 394-396 行）**

```systemverilog
    // 对分支比较类指令，inv_flag_reg 用来统一处理取反条件，
    // 这样 Control 只需读取 EX_result[0] 就能判断是否跳转。
    // alu_opcode_reg[4]=1 表示这是 RV32M 乘除法，改由 MDU 产生结果。
```

**ready_last = ready_next & ~mdu_stall（第 404-405 行）**

```systemverilog
    // mdu_stall 期间把下级 ready 拉低，配合 LSU 的同步冻结，
    // 避免把 EXU 保持的陈旧值一级级推下去。
```

**ALU 的职责（第 424 行）**

```systemverilog
// ALU 是执行级核心算子，既负责普通算术逻辑，也负责分支比较。
```

---

## EXU-11：H1 —— 上游 hold 期间不得重复接收同一条指令（`up_stall` 接收门控）

> **本节不是注释压缩的结果**，是官方差分验证（`cdp-tests`）修掉的一个 **P0 正确性缺陷**。
> 出处：[`../docs/历史/待修复清单_cdp-tests第三轮.md`](../docs/历史/待修复清单_cdp-tests第三轮.md) 第 1 节（H1）。

**现象**：官方差分第一条 `addi` 就 desync —— 参考模型已到 `debug_wb_pc=0x8`/`reg=14`，本 CPU 还停在
`0x4`/`reg=1`，之后全表失配；`jal` 用例里 `0x3c` 的 `addi x1,x1,1` 被执行两次（2→3），`0x40` 因此算出 4、应为 3。

**根因**：`IFU_stall`（= load-use | MDU 忙 | `icache_hold` | `dcache_hold`）期间 IDU 会**保持**它送出的
`valid_last` 与指令编码不变（IDU 自己的 `ready_last` 已经带了 `~IFU_stall`，所以它知道"没被收走"）；
但 EXU 内部的接收判据用的是 `ready_last = ready_next & ~mdu_stall` —— **不含 IFU_stall**。
于是同一条指令在 hold 期间被连续接收两拍、交给 LSU 两次。这是旧设计一直存在的握手漏洞：
没有 Cache 时前端不会真的 hold，所以被掩盖。

**改了什么**：EXU 新增 `input logic up_stall`，把它并进**四处**"接收并锁存"的条件
（`valid_next` 的置 1 分支、EX 级数据寄存器、控制寄存器、异常标志寄存器）；`myCPU.sv` 例化处接
`.up_stall(IFU_stall)`。

**为什么 `valid_next` 在 `up_stall` 期间可以置 0（不是丢指令）**：能走到那条分支说明 `ready_next=1`，
即下游本拍就会把手上这条收走；真正"下游收不走"的情况已经被上面 `~ready_next` 的冻结分支拦住了。

**★ 不许改回去的两种写法（都实测过）**：

| 改法 | 后果 |
|---|---|
| 并进 `ready_last` | 连"放行"一起掐掉 —— 被 `bp_pend` 挡下的那条仍要在当拍交给 LSU（`jal` 的 link 写回靠这拍，见 §EXU-2） |
| 并进 `valid_last`（`.valid_last(IDU_valid & ~IFU_stall)`） | 破坏 `EXU_inst_clr` 的清空路径、留下陈旧控制寄存器，文档实测只有 40/47 |

**验证**（WSL + Verilator 5.020 + 官方 `cdp-tests`）：

| 配置 | 结果 |
|---|---|
| 修复前 | **0/39**（`addi` 第一条即 desync） |
| 只修 H3 + H1 | **32/39**，失败集恰好 `lb lbu lh lhu lw sb sh`（= H2） |
| 再修 H2（§DCACHE-6） | **39/39** |

---

### MDU_pipelined.sv

> 原文按行号从改动前快照 `_comment_iter/before/core/MDU_pipelined.sv` **逐字取出**，
> 所以下面每一段都是"被删掉/被压缩掉的注释原文"，不是复述。
> 对应正本：`E:\share doc\v9\experimental\MDU_pipelined.sv`（本次只改了注释，代码经 strip_sv_comments 校验为 CODE-IDENTICAL）。

## MDU-1：删掉 div_signed_r（原编号：v9 修复 C6）

**补充说明**：

它被锁存下来却从未参与任何结果选择（结果回正只用 sign_diff_r 与 d1_neg_r，边界判断
只用 op_a_r/op_b_r/div_sel_r），Quartus 报 Warning (10036): object "div_signed_r"
assigned a value but never read。新注释写成 ★ 不变量：别再加回来。

**原文（第 100-103 行）**

```systemverilog
    // v9 修复（C6）：删掉了 div_signed_r。
    //   它被锁存下来却从未参与任何结果选择（结果回正只用 sign_diff_r 与 d1_neg_r，
    //   边界判断只用 op_a_r/op_b_r/div_sel_r），Quartus 报：
    //     Warning (10036): object "div_signed_r" assigned a value but never read
```

## MDU-2：原文件头（“为什么要改 / 现在的结构 / 握手 / RISC-V 边界语义”）

**补充说明**：

新文件头按风格指南 §5 重排（≤25 行），把“为什么要时序化”压成一行、把握手与
操作数锁存升级成 ★ 接口契约，并补上流水级划分与“res 只在 done 拍有效”。
原文件头逐字保留如下（含全部结论：仿真能过但综合最长路径、乘法与 ALU 完全同拍、
除法期间 busy 暂停整机、除零/有符号溢出边界语义）。

**原文（第 4-27 行）**

```systemverilog
/* =============================================================================
 * MDU_pipelined.sv — RV32M 乘除法的「时序化」实现（**v9 上板改造后已接入 `EXU`**）
 * -----------------------------------------------------------------------------
 * 为什么要改：
 *   原实现把「3 个 32×32 乘法器 + 32 级恢复余数法除法链」全塞进 EX 级一级
 *   组合逻辑。仿真能过，但综合后这是整机最长的一条组合路径，FPGA 上很难收敛。
 *
 * 现在的结构（乘法与除法分开对待，因为二者代价不同）：
 *   ┌ 乘法：**单拍**。直接用端口输入 d1/d2 做组合乘法，与 EXU 锁存操作数
 *   │       在同一拍结束，结果在下一拍出现在 EX_result 上，与 ALU 完全同拍。
 *   │       因此乘法**不需要任何暂停**，也不会打乱流水线的 PC/rd/valid 对齐。
 *   └ 除法：**多周期**。32 拍「左移-试减-回写」时序状态机，每拍 1 位商。
 *           期间用 busy 暂停整机（前端 + 访存流水 + 写回寄存器同步冻结）。
 *
 * 握手：
 *   start ：EX 级本拍接受一条 M 扩展指令（单周期脉冲）
 *   busy  ：除法运算中（乘法恒为 0）
 *   done  ：结果已就绪（与 res 同拍）
 *   op[4] ：IDU 译码约定，1 表示走 MDU 通路
 *
 * RISC-V 边界语义（逐条保留）：
 *   除零        -> 商 = 0xFFFF_FFFF，余数 = 被除数
 *   有符号溢出  -> INT_MIN / -1：商 = INT_MIN，余数 = 0
 * =========================================================================== */
```

## MDU-3：附录：其余被改写/压缩的注释原文（信息已全部并入新注释，原文备查）

**补充说明**：

另外三处（第 75、112、175 行）只是**新增**块首说明（always_comb/always_ff 的
“这是哪一级、维护什么状态”），改动前那几行是代码、没有删掉任何注释。

**译码约定（第 43-47 行）**

```systemverilog
    /* ---------------------------------------------------------------------
     * 0) 译码
     *    mul/mulh/mulhsu/mulhu -> op[2]=0：单拍乘法
     *    div/divu/rem/remu     -> op[2]=1：多周期除法
     * ------------------------------------------------------------------- */
```

**乘法单拍路径（第 62-68 行）**

```systemverilog
    /* =====================================================================
     * 1) 乘法：单拍路径
     * ---------------------------------------------------------------------
     * 用**端口输入** d1/d2 做组合乘法，与 EXU 锁存操作数同一拍完成；
     * 结果在下一个时钟边界寄存，于是 T+1 拍就与 ALU 结果同时出现在
     * EX_result 上，流水线无需为乘法暂停。
     * =================================================================== */
```

**除法迭代结构（第 87-89 行）**

```systemverilog
    /* =====================================================================
     * 2) 除法：32 拍顺次迭代（恢复余数法）
     * =================================================================== */
```

**锁存的原始操作数与译码（第 95-96 行）**

```systemverilog
    // 锁存的原始操作数与译码（除法的边界判断与结果回正都要用，
    // 不能读端口 d1/d2/op —— 它们会随流水线前进而变成下一条指令）
```

**乘法单拍寄存（第 129 行）**

```systemverilog
            /* ---- 乘法：单拍寄存 ---- */
```

**除法三段结构（第 137 行）**

```systemverilog
            /* ---- 除法：装载 / 迭代 / 结果保持 ---- */
```

**结果回正与边界收束（第 167-170 行）**

```systemverilog
    /* =====================================================================
     * 3) 除法结果回正与边界收束
     *    一律使用锁存的原始操作数 op_a_r/op_b_r 与 div_sel_r。
     * =================================================================== */
```

**对外握手与结果（第 199-201 行）**

```systemverilog
    /* =====================================================================
     * 4) 对外握手与结果
     * =================================================================== */
```

---

## MDU-4：H3 —— 工程顶层必须有一份副本（官方评测 Makefile 只通配顶层）

> 同 §EXU-11，本节是官方差分验证的修复记录，不是注释压缩。
> 出处：[`../docs/历史/待修复清单_cdp-tests第三轮.md`](../docs/历史/待修复清单_cdp-tests第三轮.md) 第 3 节（H3）。

**现象**：官方 `cdp-tests/Makefile` 的源码列表是
`CPU_VSRC = $(wildcard $(CPU_DIR)/*.sv $(CPU_DIR)/*.v)` —— 只通配 CPU 目录的**顶层**；
而 `EXU.sv` 例化的是 `experimental/MDU_pipelined.sv`，Verilator 直接报

```
%Error: Cannot find file containing module: 'MDU_pipelined'
%Error: Exiting due to 1 error(s)
```

即**功能全对也编译不过**（本机已复现）。

**改了什么**：把 `experimental/MDU_pipelined.sv` 复制到工程顶层。
注意 `-I$(CPU_DIR)` 只对 `` `include `` 生效，**不能**当模块搜索路径用（报错里 Verilator 列出的搜索
位置正好证明了它不去 `experimental/`），所以不能靠 `-I` 绕开。

**★ 不变量：两份必须逐字一致。** 工程里因此存在两个同名模块副本（顶层 + `experimental/`），
任何一边被单独改动，都会变成"板级与官方评测跑的不是同一份代码"。两份的文件头都写明了这一点，
可用 `fc /b` 或 `cmp` 直接比对。

---

### ALU.sv

> 本文件只保存**从 ALU.sv 注释里删掉 / 压缩掉**的原文，一个字都没有改写。
> ALU 属于“小而不简单”：文件头 4 行 + 2 处单行注释被合并重写，
> 内容（比较结果放 res[0]、choice 是 5 位、M 编码返回 0、加减法复用 add）**一条都没删**，
> 并补了 `unique case` / `parallel_case`、有符号比较的两个符号位、`alu_equal` 名实相反这些“不看就会写错”的东西。
> 相关源码：`E:\share doc\v9\ALU.sv`

---

## ALU-1：文件头原文（ALU 的职责、res[0] 约定、v9 的 5 位 choice）

**位置**：原第 4~7 行（module 之前的 4 行文件头）。

### 删掉的原文（逐字）

> ```systemverilog
> // ALU 统一承接算术、逻辑、移位和比较。
> // 这里的比较结果约定放在 res[0]，方便分支控制直接读取最低位。
> // v9：choice 扩展为 5 位以兼容 M 扩展编码；M 类运算由 EXU 中的 MDU 执行，
> // 本模块遇到 M 编码只返回 0（不会真正被选中）。
> ```

**补充说明**：四条信息在正本里分别落在文件头第 1 行（职责 + RV32M 由 MDU 执行）、
`★ 接口约定`（比较结果只放在 res[0]、高位全 0）、以及编码表末尾（`1xxxx` 落 default 的 `res='0`）。
另补了“`alu_equal` 宏名与语义相反（给的是**不**相等），EXU 用 `inv_flag` 异或才得到 beq/bne 方向” ——
这是读 ALU 时最容易写错的一处。

---

## ALU-2：`choice` 编码表原本只散落在 para.sv 的宏里

**位置**：正本文件头的“choice 编码 → 运算”一行；宏定义本身在 `para.sv` 第 43~63 行。

### 说明（不是删掉的原文，是本次的取舍记录）

第一版曾在 ALU 里逐条抄了一张 5 行的编码表（`alu_add 00000 = d1+d2 …`）。
按“谁定义谁注释”的原则，完整表应待在 `para.sv` 的宏旁边，ALU 只留一行指向它 +
本模块真正需要的对应关系（比较类三条 + 移位量截位 + `1xxxx` 落 default）。
取舍后 ALU 的注释量降下来，`para.sv` 这一组宏没有改动（不在本次改动范围内）。

---

## ALU-3：`unique case` 与 `choose_add_sub` 的原文

**位置**：原第 24 行（`always_comb` 之前）、原第 81 行（`add` 实例之前）。

### 删掉的原文（逐字）

> ```systemverilog
>     // 组合逻辑里只做功能选择；真正的加/减法被折叠到下面的 add 模块复用。
> ```
>
> ```systemverilog
>     // 通过 choose_add_sub 复用一套加法器，实现 add/sub/部分比较所需的差值计算。
> ```

**补充说明**：两句都在正本里保留（第二句原样、第一句在 `always_comb` 之前原样）。
新增的是它们**为什么不能动**：
- `unique case` 蕴含 `parallel_case` + `full_case` 两个综合限定符，综合日志里那条提到
  `parallel_case` 的 INFO 是它的正常产物，不是待修告警；反过来 `unique case violation` 才是真问题。
- `choose_add_sub` 必须在每条分支上赋确定值，否则推出锁存器。
- 有符号比较要先看两个符号位（异号时直接取 d1 的符号位，同时规避 `d1-d2` 只在异号时发生的溢出）；
  只把它简化成“看 `add_result[BW-1]`”会在异号溢出时给出相反的比较结果。
- `add` 实例不只服务 add/sub：`alu_signed_comparator` 要读 `add_result[BW-1]`，删掉它这一支立刻失效。

---

### add.sv

> 本文件只保存**从 add.sv 注释里删掉 / 压缩掉**的原文。
> 相关源码：`E:\share doc\v9\add.sv`

---

## ADD-1：原作者留下的加减法等价说明（被追加了一句注解）

**位置**：`assign result = ...` 之前（原第 14 行，module 端口表之后）。

原文**逐字保留**在正本里，只是同一行后面追加了一句“addd_1 是笔误、值就是 add_1，保留不改”，
所以按“归一化整行”的机械口径它算“被改写行”，在此登记。

### 删掉的原文（逐字）

> ```systemverilog
> // if {choose_add_sub == 1} addd_1 - add_2 else  add_1 + add_2
> ```

**补充说明**：文件头两行原注释
（`// 共享加法器。` / `// 通过 choose_add_sub 选择 add_2 或其按位取反加 1，实现加/减统一。`）
**原样保留**，未改写。本次新增的只有“参数化用法 + 被谁例化 + 补码减法的进位含义”三句。

---

### sext.sv

> 相关源码：`E:\share doc\v9\sext.sv`

## SEXT-1：无删减

**（本文件无需抽取）**

本文件唯一的原有注释
（`// 通用符号扩展模块，负责把 load/立即数等较窄数据扩成目标位宽。`）
**逐字保留**在正本第 1 行，本次只在其后**新增**了 4 行说明：
参数化用法与成立前提（`OUT_WIDTH >= DATA_WIDTH >= 1`）、被谁例化（LSU 4 个实例 + WBU 2 个实例）、
端口/参数名不能改、以及例化点前 `verilator lint_off PINMISSING` 的来由。
没有任何被删掉或被压缩掉的原文需要归档。

---

## 四、访存与写回

### LSU.sv

> 本文件只保存**从 LSU.sv 注释里删掉 / 压缩掉**的原文，一个字都没有改写。
> 正本现在是风格指南 §2 的紧凑格式，细节（波形数字、当时怎么想的）全在这里。
> 相关源码：`E:\share doc\v9\LSU.sv`

---

## LSU-1：字节/半字读必须按地址低 2 位选道（原编号：v9 修复 B1）

**位置**：`always @(*)` 的 `rdata_byte_sel` 选道块之前（原文件第 293~303 行），
以及被改写的两句单行注释：`// 当前拍读数据扩展，供 LSU 本级使用与早期观察。`（原第 281 行）、
`// 写回前再次按 funct3 整理数据宽度，形成最终提交给 WBU 的 load 结果。`（原第 369 行）。

原文 11 行 → 现在 8 行（`★ 不变量 + 原因 + reg/reg2 两级口径 + 锚点` 4 行，
另加 4 行讲“选道中间量为什么会被综合裁位、为什么不能改成直接位选”）。

### 删掉的原文（逐字）

> ```systemverilog
>   // ---------------------------------------------------------------------------
>   // v9 修复（B1）：字节/半字读必须按**地址低 2 位**选道。
>   //   读口（DRAM / DCache / 板级同步 BRAM）返回的是"该地址所在字"的原始整字，
>   //   偏移信息只存在于地址里。原实现直接取 rdata[7:0] / rdata[15:0]，
>   //   等价于把 lb/lh/lbu/lhu 的第 1/2/3 字节全读成第 0 字节。
>   //   选道口径与写侧保持一致（DCache 的 store 合并、board/sync_mem 的 mask 写）：
>   //     字节：按 addr[1:0] 取 4 个字节之一；
>   //     半字：按 addr[1] 取低/高半字。
>   //   reg 级用 Ex_result_addr_reg[1:0]，reg2 级用 Ex_result_fwd_reg2[1:0]
>   //   （EXU 对 load 的 exec_res 就是有效地址，两级都随流水带过来了）。
>   // ---------------------------------------------------------------------------
> ```
>
> ```systemverilog
>   // 当前拍读数据扩展，供 LSU 本级使用与早期观察。
> ```
>
> ```systemverilog
>   // 写回前再次按 funct3 整理数据宽度，形成最终提交给 WBU 的 load 结果。
> ```

**补充说明**：写回拍还会把 load 地址低 2 位单独引出去（`rdata_offset_wb = Ex_result_fwd_reg2[1:0]`，
原第 50~52 行的 `v9 修复（B1）` 注释**保留未动**）—— WBU 会按 funct3 再抽取一次，
所以“选道”这件事在 LSU 与 WBU 各发生一次，两处口径必须一致。
另：`rdata_byte_sel` / `rdata_half_sel` 只在 `[7:0]` / `[15:0]` 上被读，综合会把 mux 的高位裁掉；
这不是 bug，也不能把它们“优化”成直接位选（位选表达不了 `addr[1:0]` 的 4 选 1）。

---

## LSU-2：mem_hold / mdu_busy 期间整条访存流水必须同步冻结

**位置**：`always_ff @(posedge clock)` 之前（原文件第 189~196 行）。

原文 8 行 → 现在 4 行（其中 2 行是新增的 `rdata_reg2 <= rdata` 时序契约）。

### 删掉的原文（逐字）

> ```systemverilog
>   // 三级寄存串联体现了访存路径的时间展开：
>   // reg   : EXU 刚送入 LSU 的拍
>   // pipe  : 对外发总线、同时可作为中间前递观察点
>   // reg2  : 接近写回的最终访存结果
>   // 上板改造：只要 mem_hold=1（DCache 因同步 DRAM load miss 需要重试）或
>   // mdu_busy=1（EXU 在等 MDU 结果），整条访存流水**同步冻结**。
>   // 否则 mem_ren_reg_pipe 会被推进到下一级，DCache 的 cpu_en 组合来源随之
>   // 变化，hold 自己就把自己解掉了；MDU 的情况则会推着陈旧值往下走。
> ```

**补充说明**：三级含义已上移到文件头（M1/M2/M3 一节），原文里的“时间展开”表述没有丢，
只是改成了“后缀即级号”的写法。冻结的两个后果（hold 自己解自己、陈旧值往下走）**一条都没删**；
另外补了一条 `★ 不变量`：`lsu_freeze` 必须同时进 `ready_last` 与 `always_ff` 的推进条件。

---

## LSU-3：jump/CSR 的前递值必须取 rd_value，不是 Ex_result

**位置**：`wb_sel_jmp_csr_pipe` 两处（原文件第 165~166、185~187 行）；原文**保留未动**，
本节只是把“为什么必须三处同口径”补成锚点。

### 保留的原文（逐字，仍在本文件的正本里）

> ```systemverilog
>   // 对前递来说，跳转/CSR 与普通 ALU 指令不同：
>   // 它们真正想被下游看到的是 rd_value，而不是地址/ALU 原始结果。
> ```

**补充说明**：jump/CSR 写进 rd 的是 **link 地址 / CSR 读值**，由 IDU/EXU 提前算好随流水传下来
（`myCPU.sv` 里叫 `IDU_rd_value`，注释写的是“本指令要写的 rd 值”）。判据 `jump_flag | (|csr_wen)`
在 M1（`wb_sel_jmp_csr_pipe`）、M3（`wb_sel_jmp_csr2`）以及 `myCPU.sv` 的 `MEM_forward_val`
三处必须**完全一致**；任何一处退回 `Ex_result_fwd_*`，前递给下游的就会是“地址”而不是“要写的值”。
相关同源修复（EXU 级前递，v9 修复 B6）见 `myCPU.sv` 里 `EXU_forward_val` 的注释。

---

### DCache.sv

> 本文件只保存**从 DCache.sv 注释里删掉 / 压缩掉**的原文，一个字都没有改写。
> 正本现在是风格指南 §2 的紧凑格式（文件头 56 行 → 22 行），
> 机制与不变量**全部保留**，只有“当时怎么发现的 / 实测数字”搬到这里。
> 相关源码：`E:\share doc\v9\DCache.sv`

---

## DCACHE-1：读握手契约 —— hold 撤销的那一拍，cpu_rdata 必须是当前地址的数据（原编号：v9 修复 B2）

**位置**：文件头“三个有效性限定”一节（原第 21~31 行）+ `hit_now / resp_for_now / hold` 之前的
B2 大段（原第 141~157 行）+ load 停拍条件的说明（原第 172~182 行）。

这三段合计 30 行 → 现在文件头 3 行 + B2 `★ 不变量` 7 行 + hold 口径 5 行。

### 删掉的原文（逐字）

> ```systemverilog
>  * 三个“有效性”限定（都是实测踩出来的，少一个就出错）：
>  *   resp_valid_r : cpu_en_r 的延迟，表示比较侧寄存器已装过一条真实请求。
>  *       缺它 -> 复位后第一拍用复位值去比，把垃圾当“未命中”填进缓存行，
>  *               于是 load 恒读到 x。
>  *   addr_same_r  : cpu_addr 与 cpu_addr_r 相同，表示请求地址已稳定一拍。
>  *       缺它 -> 新地址第一拍就发 DRAM 读，那时 DRAM 还没采到新地址，
>  *               返回的是上一个地址的数据（load 读到的值整体偏一个 index）。
>  *   mem_req_r    : “本请求已经发过读”。cache_rd_req 用它做一次性限制，
>  *       这样 mem_en 只高 1 拍；再配合 ~mem_en & mem_req_r 就能稳定标出
>  *       DRAM 数据返回的那一拍。若不做一次性限制，mem_en 一直为 1，
>  *       返回标志永不成立、hold 永不释放 -> 整机死锁。
> ```
>
> ```systemverilog
>     // -----------------------------------------------------------------------
>     // v9 修复（B2）：读握手契约必须保证「hold 撤销的那一拍，cpu_rdata 就是
>     //   **当前正在请求的那个地址**的数据」。
>     //   原实现用 resp_valid_r（= cpu_en 延迟 2 拍）当门，而 cpu_index_r/cpu_tag_r
>     //   只延迟 1 拍，两者错开一拍；更关键的是 hold 里的 `| cache_rd_req` 会在
>     //   **发出读的那一拍**就把 hold 解掉 —— 数据还没回来，LSU 却已被放行，
>     //   于是把上一拍的总线残留值（或 x）锁进 rdata_reg2，真正的数据落在一个
>     //   valid=0 的气泡上。tb_iverilog.sv 的 DRAM 读口不门控（每拍都读），
>     //   恰好掩盖了它；换成带读使能的真实 BRAM（board/sync_mem）就变成 x。
>     //
>     //   新口径（与「同步 BRAM：请求 1 拍、数据 1 拍后到」严格对应）：
>     //     hit_now     : 用**当前**地址组合判断是否命中 -> 本拍 cpu_rdata 已可用；
>     //     resp_for_now: 本拍 mem_rdata 是**当前地址**那次读的返回（地址在 hold
>     //                   期间保持不动，所以比较寄存后的 index/tag 即可）；
>     //     hold        : 请求存在且两者都不成立时才停拍。
>     //   这样 hold 撤销的那一拍，cpu_rdata 一定是这条 load 的数据。
>     // -----------------------------------------------------------------------
> ```
>
> ```systemverilog
>     // load 停拍条件：本拍 mem_rdata 不是这条 load 的结果，且它自己还没发出读。
>     //   ~mem_req_r | cache_rd_req 的含义：
>     //     - 刚发出读的那一拍（cache_rd_req=1）：数据还没回来，但读已经上路，
>     //       下一拍 mem_data_vld 就会取回来，不必再停，省一拍气泡；
>     //     - 已发过读、数据还没到（mem_req_r=1 且非返回拍）才需要停。
>     //   写成 ~hit & ~mem_req_r 会在“本拍既没命中、又还没发读”的那一拍死等：
>     //   那一拍 hold=1 把 LSU 的 pipe 级冻住，而发出读又需要缓一拍，
>     //   于是 hold 自己把自己锁住（实测：load 之后整机停摆）。
>     // store 是写直达，不依赖读数据，永不停拍。
>     // load 的停拍：请求存在、且本拍 cpu_rdata 不是这条 load 的数据（既没命中、
>     // 也不是它的读返回）—— 必须停到数据真的可用那一拍为止（见上面的新口径）。
> ```

**补充说明**：原 B2 文字里的三条关键证据（① `resp_valid_r` 延迟 2 拍而 `cpu_index_r/cpu_tag_r`
只延迟 1 拍；② 旧 `hold` 里的 `| cache_rd_req` 在发读那拍就解 hold；③ `tb_iverilog.sv` 的 DRAM
读口不门控每拍都读、恰好掩盖，换 `board/sync_mem` 就变 x）在正本里**全部保留**，只是并句。
「hold 撤销的那一拍 cpu_rdata 就是当前 load 的数据」是本文件最值钱的不变量，任何简化都不得动摇它。

### 同段被压缩的原文（文件头简介与端口表，逐字）

> ```systemverilog
>  * 写策略是「写直达 write-through + 命中更新行」，为适配**同步 BRAM** 做了三处修正：
> ```
>
> ```systemverilog
>  *   2. 读一次：只在「该行不驻留」时发一次 DRAM 读（cache_rd_req），
>  *      miss 那一拍把访存流水停住（hold），返回后回填；
> ```
>
> ```systemverilog
>  * 端口：
>  *   cpu_en / cpu_wen / cpu_addr / cpu_wdata / cpu_mask : 来自 LSU 的访存请求
>  *   mem_rdata : 外部 DRAM 的**原始整字**读数据（同步读，1 拍延迟）
>  *   cpu_rdata : 回给 LSU 的**原始整字**读数据（字节/半字抽取由 LSU 按 funct3 做）
>  *   mem_*     : 转发到外部 DRAM 的访问信号
>  *   hit/miss/hold : 本拍访问结果与「需要停一拍重试」请求
> ```

**补充说明**：端口表的六行信息在正本里压成两行（`cpu_en = mem_ren_pipe | wen`、
`cpu_rdata` 是原始整字、`mem_*` 转发、`hit/miss/hold` 的含义），
`mem_rdata` 的“同步读，1 拍延迟”由 `★ 与 sync_mem 的读写时序契约` 那一节承担。

---

## DCACHE-2：store 请求必须是单拍脉冲（状态机而不是边沿检测）

**位置**：文件头“store 为什么用状态机而不是边沿检测”一节（原第 33~44 行），以及
`assign store_fire = ...` / `store_state` 状态机所在的 always_ff。

原文 12 行 → 现在 2 行（`★ store 为什么用状态机` + `★ 不变量：单拍脉冲`）。

### 删掉的原文（逐字）

> ```systemverilog
>  * store 为什么用状态机而不是边沿检测：
>  *   cpu_en / cpu_addr 都由上游 LSU 的 pipe 级寄存器保持，是**电平**。
>  *   前一条 load 已经让 cpu_en=1 时，紧跟的 store 不会产生 0->1；
>  *   而流水线冻结期间地址还可能被上游改写，所以“上升沿”和“地址变化”两种
>  *   边沿检测都不可靠（实测：load 之后紧跟的 store 一笔都写不进去）。
>  *   这里改成只看“请求是否存在”的小状态机，与地址、与上游是否推进都无关：
>  *     WR_IDLE  --(有 store 请求)--> WR_ISSUE ：本拍发一次脉冲
>  *     WR_ISSUE --(请求仍在)------> WR_WAIT  ：请求持续，绝不重复发
>  *     WR_WAIT  --(请求消失)------> WR_IDLE
>  *   另外也不能直接写 store_req_r <= cpu_en & cpu_wen（那是电平）：
>  *   流水线冻结期间会连续多拍 mem_wen=1，一次 store 被写多次
>  *   （实测被测试台的 write-once 断言抓到：同地址连写 4 拍）。
> ```

**补充说明**：两个实测事实（① load 之后紧跟的 store 一笔都写不进去；② 被测试台的 write-once
断言抓到同地址连写 4 拍）现在压在正本那一行里，没有变成口号。
`mem_wen = store_req_r`（单拍脉冲）送总线；缓存行的命中合并走 `store_req_r && store2_hit`，
用的是**与脉冲严格对齐**的 `store2_*` 副本 —— 不能改成每拍都采（否则脉冲那一拍会采到上游
已推进上来的下一条指令的地址/数据）。

---

## DCACHE-3：MMIO（uncacheable）不缓存

**位置**：文件头“MMIO（uncacheable）保护”一节（原第 53~58 行）+ `uncacheable / uncacheable_req`
两个组合判断。

原文 6 行 → 现在 1 行。

### 删掉的原文（逐字）

> ```systemverilog
>  * MMIO（uncacheable）保护：
>  *   写直达缓存如果只看 tag/index，会把外设寄存器也缓存起来。外设读常有副作用
>  *  （读清中断标志、FIFO 出队），一旦命中缓存，软件读到的就是上一次的快照，
>  *   行为不可预测。因此 addr & ~UNCACHE_MASK != 0 的地址一律：
>  *     - 命中判定恒为“不驻留” -> 读直通外设、不写缓存行；
>  *     - store 的命中合并条件也被排除 -> 不会用旧值去合并写 MMIO 行。
> ```

**补充说明**：`UNCACHE_MASK = 32'h0FFF_FFFF`（只有低于 `0x1000_0000` 的地址可缓存）
这条参数说明保留在参数旁边，未动。注意请求侧用**寄存地址**判（`uncacheable`，与比较侧同拍），
store 的命中合并/`store2_hit` 用**组合地址**判（`uncacheable_req`）—— 两者不能互换。

---

## DCACHE-4：一致性 —— 写直达 + 命中更新行

**位置**：文件头“一致性（写直达 + 命中更新行）”一节（原第 46~51 行），
对应实现是 always_ff 里的回填（`access_en && !hit && !uncacheable`）与
store 命中合并（`store_req_r && store2_hit`）。

原文 6 行 → 现在 1 行。

### 删掉的原文（逐字）

> ```systemverilog
>  * 一致性（写直达 + 命中更新行）：
>  *   修掉旧实现的错误序列：
>  *     1) load  X -> miss，把 X 填进缓存行（此时存储器里可能还是旧值）
>  *     2) store X -> miss，写直达存储器，但缓存行仍是旧值
>  *     3) load  X -> **命中**，读到第 1 步缓存的旧值 -> 结果错误
>  *   现在 store 命中就同步合并进缓存行；未命中则本就不驻留，不会残留旧值。
> ```

**补充说明**：三步错误序列是这条不变量的**证明**，正本里压缩成一行“load 填旧值 -> store 写
存储器 -> load 命中读回旧值”。回填只在 `access_en && !hit && !uncacheable` 时发生，
即“一次真正完成的访问 + 确实未命中 + 不是 MMIO”，三个条件缺一不可。

---

## DCACHE-5：删掉 store2_addr / store2_tag（原编号：v9 修复 C6）

**位置**：`store2_wdata / store2_mask` 声明之后（原第 195~201 行）。

原文 7 行 → 现在 4 行（含锚点）。

### 删掉的原文（逐字）

> ```systemverilog
>     // v9 修复（C6）：删掉了 store2_addr / store2_tag。
>     //   它们在 store_fire 那一拍被锁存，但**从来没有被读过**（Quartus:
>     //     Warning (10036): object "store2_addr" assigned a value but never read
>     //     Warning (10036): object "store2_tag" assigned a value but never read
>     //   ）。原因很简单：一次 store 需要跨拍保留的只有 payload（wdata/mask）
>     //   和"它属于哪一行"（index，用于命中合并）；地址本身既不再上总线
>     //   （总线地址走 mem_addr = cpu_addr_r）、也不再做比较。
> ```

**补充说明**：这条是“死寄存器清理”的记录，不是时序修复。删掉的两个寄存器如果被加回来
（比如为了“跨拍保留地址”），会立刻在综合日志里重新出现 10036 告警 —— 但功能上无害，
因为地址既不参与比较也不再上总线。

---

## DCACHE-6：H2 —— 读请求窗口必须向存储器声明"整字访问"

> 同 §EXU-11，本节是官方差分验证的修复记录，不是注释压缩。
> 出处：[`../docs/历史/待修复清单_cdp-tests第三轮.md`](../docs/历史/待修复清单_cdp-tests第三轮.md) 第 2 节（H2）。

**现象**：`lb x14,2(x1)`（字内偏移 2，内存字节 `0xf0`）读出 0，应为 `0xfffffff0`；
修完 H1 后剩下的失败集恰好是 `lb lbu lh lhu lw sb sh` 这 7 条。

**根因**：上板改造后本 CPU 的契约是"存储器返回**原始整字**、CPU 自己按 `addr[1:0]` 抽取"
（§DCACHE-1 / v9 修复 B1），而课程原始 SoC 的 `mySoC/dram_driver.sv` 会**按 `perip_mask` 先在
存储器侧抽一次** → 二次抽取。

**改了什么**：`assign mem_mask` 在读窗口（`mem_en | mem_req_r`）改成 `2'b10`（整字），
写口仍用真实 `store2_mask`。

**★ 不变量：整字 mask 必须保持到数据被采走那一拍（`mem_req_r=1`）** —— 课程 DRAM 是**组合读**
（`dram_driver` 每拍按当前 mask 重新抽取），只给 `mem_en` 那一拍会在数据回来前就掉回 `store2_mask`。

**对已上板的 bitstream 无影响**：板级 `board/sync_mem.sv` 的读口是 `if (ren) rdata <= mem_ram[word_addr];`
—— **完全不看 mask**（已逐行核对）。所以这一项只是为了兼容课程 SoC 与官方差分，
不改变已上板硬件的行为。

---

### WBU.sv

> 本文件只保存**从 WBU.sv 注释里删掉 / 压缩掉**的原文，一个字都没有改写。
> 正本现在是风格指南 §2 的紧凑格式。
> 相关源码：`E:\share doc\v9\WBU.sv`

---

## WBU-1：load 读数据必须按 addr[1:0] 选道、再按 funct3 符号扩展（原编号：v9 修复 B1）

**位置**：`MEM_Rdata_sel` 的 `always @(*)` 选道块之前（原第 90~95 行）。

原文 6 行 → 现在 6 行，但改成了 `★ 不变量 + 原因 + 锚点` 的固定格式
（内容没少，反而补了“写回级才是最终值来源”这一层）。

### 删掉的原文（逐字）

> ```systemverilog
>   // ---------------------------------------------------------------------------
>   // v9 修复（B1）：字节/半字必须先按**地址低 2 位**选道，再按 funct3 做符号扩展。
>   //   读口返回的是该地址所在字的原始整字，原来直接取 [7:0]/[15:0]，
>   //   会把 lb/lh/lbu/lhu 的第 1/2/3 字节全读成第 0 字节。
>   //   选道口径与 LSU 的抽取、DCache 的 store 合并、board/sync_mem 的 mask 写一致。
>   // ---------------------------------------------------------------------------
> ```

**补充说明**：`offset_in` 就是 LSU 送来的 `rdata_offset_wb = Ex_result_fwd_reg2[1:0]`
（load 的有效地址低 2 位）。同一份选道逻辑在 LSU（reg/reg2 两级）与 WBU（写回级）各有一份，
**三份口径必须完全一致**；WBU 这一份才是最终写回值。

---

## WBU-2：`stall` 端口漏接 —— iverilog 下的 x 态陷阱

**位置**：`always_ff` 之前的锁存块注释（原第 49 行）+ 文件头两行（原第 4~5 行）。
本模块**原本没有**关于 `stall` 的任何注释，这一节是本次新增的知识，原文只有文件头那两行。

### 删掉的原文（逐字）

> ```systemverilog
> // 写回级是整条数据通路的最终收束点。
> // 无论结果源头是 ALU、访存、跳转返回地址还是 CSR 读值，都会在这里统一选择成 rd_value_next。
> ```
>
> ```systemverilog
>   // 先把来自 LSU 末拍的所有候选结果锁存住，确保最终提交时序稳定。
> ```

**补充说明（这条最容易返工，写全）**：

- 写回级是**纯延迟级**：`valid_next = valid_reg`，`ready` 恒 `1'b1`，它从不背压，
  按设计就不该被暂停 —— 所以 `myCPU.sv` 现在是 `.stall(1'b0)`。
- 但 `else if (!stall)` 里的 `stall` **一旦悬空**（历史上加端口时在 `myCPU.sv` 里漏接），
  iverilog 会把这条 `if` 的条件算成 **x**：条件“未知”时整个 `else` 分支不执行，
  于是**一条写回都出不来** —— 所有写回寄存器永远停在复位值。现象是 PC 还在走、寄存器全是 0。
- 为什么长期没被发现：**FPGA/Verilator 是 2 态仿真**，悬空端口被当成 0/1（而不是 x），
  `!stall` 恰好为真，行为完全正常；只有 iverilog（4 态）的回回归能把它抓出来。
- 判据：任何人再动 `WBU` 的 `stall`/`ready` 端口，或把 `myCPU.sv` 里那句 `.stall(1'b0)`
  改成别的信号，都必须重跑 iverilog 回归，不能只看上板/Verilator。

---

## WBU-3：写回优先级与 `R_wen_next` 的 valid 门控

**位置**：文件末尾的写回选择块（原第 143~146 行的优先级说明）。

原文 4 行 → 现在 3 行（优先级 + 原因 + `★ 不变量`）。

### 删掉的原文（逐字）

> ```systemverilog
>   // 最终写回选择优先级：
>   // jump/CSR 使用提前准备好的 rd_value_reg；
>   // load 使用访存返回值；
>   // 其余普通算术逻辑指令使用 Ex_result_reg。
> ```

**补充说明**：

- 优先级顺序 = **最特殊者优先**，三者互斥由上游保证（同一条指令不可能同时是 jump/CSR/load/ALU）：
  - `jump_flag_reg | (|csr_wen_reg)` → 用 `rd_value_reg`（link 地址 / CSR 读值，早在 IDU/EXU 算好）；
    注意 `csr_wen` 是 16 位 CSR 地址译码，所以用**按位或归约**判非零。
  - `mem_ren_reg` → 用 `rdata_wb`（load 返回值）；此时 `Ex_result_reg` 只是**有效地址**。
  - 其余 → `Ex_result_reg`（ALU 结果本身）。
- `R_wen_next = R_wen_reg & valid_reg` 里的 `& valid_reg` 是**新增不变量**（原注释没有）：
  `rd_next = rd_reg` 是无条件下传的，气泡/无效拍上 `rd_reg` 是上一拍的残留（或 x），
  只有把写使能按 valid 门掉，`RegisterFile` 才不会把残值写进 rd。
- 顺带记录一处**未加门控**的地方：`csr_wen_next = csr_wen_reg` **没有** `& valid_reg`。
  改动前必须先确认上游（EXU）在气泡拍是否已把 `csr_wen` 清 0，不要照 `R_wen` 的样子“顺手补上”。

---

## 五、流水控制与异常

### Control.sv

> 本文件保存 `E:\share doc\v9\Control.sv` 注释迭代中**被压缩或被改写的原文**，逐字保留。
> 源快照：`E:\FPGA\v9_vivado_ila\_comment_iter\before\core\Control.sv`（452 行 / 206 注释行）。
> 改后：562 行 / 316 注释行（A/C 类补充为净增，见正文各节的 `★ 不变量` 锚点）。
> 本文件里的编号 `CONTROL-n` 就是改后注释中 `syn/修复史_全量.md §CONTROL-n` 的锚点。

---

## CONTROL-1：`dnpc_flag` 的四个源都必须是"一拍宽"的脉冲（原编号：v9 上板改造修正 / v9 修复 B4）
**位置**：`assign dnpc_flag = ...` 之前（原 before 文件里没有对应注释块，这一条是 C 类补充，锚点在此收口）
**删掉的原文**：
> （原文无独立注释；原信息散落在两处 —— `logic bp_redirect_pending;` 上方的
> "v9 上板改造修正：**一次预测错误只重定向一次**"整段，以及 `trap_redirect` 的 C4 说明里
> "若改成'电平持续发'，则每一拍都 flush，重定向目标那条指令永远进不了 EX → 整机锁死"。）
**补充说明**：`dnpc_flag` 同时是 `IDU` 的 `flush`（`myCPU` 里直接接到 `IDU.flush`）。因此
"多发一拍"= 把重定向目标自己冲掉，"少发一拍"= 错路径指令活着提交。四个源的一次性化手段：
`bp_mispredict` 靠 `bp_redirect_pending`、`trap_redirect` 靠 `trap_take_q_r`、
`system_redirect` 的三个源（mret/ecall/fence.i）本身是译码级一拍信号、
`intr_take` 只在 `intr_safe` 成立的那一拍收。

---

## CONTROL-2：`bp_misp_det` 必须排除 `intr_take | system_redirect | trap_redirect`（原编号：v9 上板改造修正 / v9 修复 B4/B7）
**位置**：`assign bp_misp_det = ...` 之前（改后注释为压缩后的 `★ 不变量` + 原因）
**删掉的原文**：
> // v9 上板改造修正：预测校验必须让位给"更高优先级、且会让 EX 级这条指令被清掉"的事件。
> //   预测错误触发的重定向本身也会拉高 EXU_inst_clear，而指令在 EXU 里可能因为
> //   存储侧 hold（EXU 被冻结，一拍走不掉）而停留多拍：这期间 bp_mispredict 若是 1，
> //   每一个刚被接收的指令都会被连着清成空操作，重定向目标又被反复重取，
> //   整机就锁死在这里（实测：ecall 永远进不了 WB，mepc/mcause 始终为 0）。
> //   ecall/mret/fence.i（system_redirect）和中断（intr_take）有自己的重定向通道，
> //   由它们决定冲刷；mem_stall 期间 EXU 冻结、预测校验等 hold 结束再判。
> //   EXU_ctrl_valid 同样必须参与：EXU 空（valid=0）时它的 pred_* 是残留值，
> //   不能拿来判预测错误，否则会无休止重定向。
**补充说明**：被压缩掉的那句"EXU 空（valid=0）时它的 pred_* 是残留值"的完整机制，
改后落在 `EXU_ctrl_valid` 那一段的 `★ 不变量` 里（锚点 §CONTROL-8）。

---

## CONTROL-3：误预测判定"只能被推后，不能被丢弃"（原编号：v9 修复 B4/B7）
**位置**：`assign bp_mispredict_raw = ...` 之前 / `bp_misp_pend` 声明处
**删掉的原文**：
> // v9 修复（B4/B7）：误预测判定**只能被推后，不能被丢弃**。
> //   原实现把 ~mem_stall 写进 raw，判定拍撞上 hold 时判定被压成 0（不是挂起），
> //   下一拍 EXU_valid 已掉下去，这次误预测永远没人处理 —— 实测纯 ALU 后向分支
> //   循环只跑 2 圈就掉出（loop_min）。
> //   但也不能"去掉 ~mem_stall 直接发"：hold 期间 IFU 的 ready(=IDU_ready) 为 0，
> //   发出去的重定向会被 IFU 丢掉（实测：dnpc_flag 打了、PC 没动）。
> //   所以：hold 期间把判定连同**方向与目标**一起挂起，等取指侧能接收时补发一次。
> //   同时把 bp_misp_pend 送给 EXU，让它在挂起期间**不接收新指令** —— 否则错路径
> //   的那条会在补发前溜进 EX 并被提交（实测 rnd034：x16 被错路径的 jal 写坏）。
**补充说明**：`bp_hold_exu` 只挡"接收新指令"，**不挡 EXU 在重定向当拍把 EX 里那条被判错的
跳转正常交给 LSU**（`jal` 的 link 靠这一拍），这一点在端口说明与 §9.2b 第 4 条里都有明确记载。

---

## CONTROL-4：挂起值优先（先来先服务）（原编号：v9 上板改造修正 / 实测 rnd034）
**位置**：`assign bp_redir_target = ...` 之前（改后注释保留了这段机制）
**删掉的原文**：
> // 本拍重定向用的目标：**挂起值优先**。
> //   挂起的是"更早、已经确认但没能送达 IFU"的那次误预测，必须先补发它；
> //   否则会出现：hold 拍挂起了 jal(0xd4)→0x110，下一拍落在错路径上的
> //   jal(0xd8)→0x128 也被判为误预测并抢走重定向（实测 rnd034）。
**补充说明**：`bp_misp_pend` 的置位分支写着 `else if (bp_misp_det & ~bp_misp_pend)`，
"已有挂起值时不再覆盖"就是这条不变量的硬件实现。

---

## CONTROL-5：同步异常的两拍脉冲（`trap_take` / `trap_take_q`）与去重（原编号：v9 新增 C4）
**位置**：模块内 `// v9 新增（C4）：同步异常…` 大块注释 + `trap_take_q_r` 的 always_ff
**删掉的原文**：
> // v9 新增（C4）：同步异常（非法指令 / 访存非对齐 / 指令地址非对齐）
> // -----------------------------------------------------------------------
> // 原来的核只认识 ecall 这一种同步异常，非法指令会被"当成加法"执行掉、
> // 非对齐访存会被静默对齐（LSU 里把 addr[17:16] 强制清零）—— 两者都违反
> // RISC-V 最少可测的语义，而且会让软件拿到错误结果却毫无提示。
> //
> // 这里做三件事：
> //   1) 定优先级（与 RISC-V 规范一致）：
> //        指令地址非对齐(0) > 非法指令(2) > 访存非对齐(4/6)
> //   2) 生成"确认接收一次异常"的单拍脉冲 trap_take，交给 CSR 登记
> //      mepc/mcause/mtval（登记发生在异常指令位于 EX 级的那一拍）。
> //   3) 下一拍用 trap_take_q 发一次**只发一次**的重定向到 mtvec。
> //      为什么要分两拍、而不是用组合电平直接重定向：
> //        - 组合电平在 mem_stall（缓存 hold）期间会持续拉高，而 IFU 的
> //          ready=0 会把重定向丢掉 → 异常丢失；
> //        - 若改成"电平持续发"，则每一拍都 flush，重定向目标那条指令永远
> //          进不了 EX → 整机锁死。这与分支预测器 bp_redirect_pending 踩过
> //          的坑完全相同，所以复用同一手法：先登记、再补发一次。
> //      只用一拍（EXU 那一拍）做重定向的话，hold 期间同样会丢；
> //      所以用"EXU 拍脉冲 + 下一拍补发"覆盖两种时序。

以及 `trap_cause` / `fault_*` 两段原文（这两段改后原样保留，此处只作留档）：

> // 优先级编码（独热）：bit3=指令地址非对齐, bit0=非法指令,
> //                    bit1=load 非对齐, bit2=store 非对齐
> // mtval 取值来源：非法指令给指令编码（IDU 的原始 inst），其余给出错地址。
> //   非法指令的编码由 IDU 透传过来（fault_inst），地址用 EXU 的目标/有效地址
> //   （EX_result：对 load/store 是有效地址，对跳转是目标地址）。

**补充说明**：`trap_take` 去重条件 `~trap_take_q_r` 的作用是"同一拍不重复登记"
（`trap_take_q` 已经把登记延续到下一拍）。当前状态（见 `syn/修复进度_C系列.md` §4.3）：
`TRAP_ENABLE=1` 时 `prog_loop` 仍复现 B4 症状，所以默认 0；`trap_redirect` 这一类
"单拍冲刷脉冲"与 v9 "stall 只冻结寄存器、不清 valid"的握手约定之间仍有已知交互缺陷。

---

## CONTROL-6：`bp_redirect_pending` 的清零条件（原编号：v9 上板改造修正 + v9 修复 B4）
**位置**：`logic bp_redirect_pending;` 上方的整段 + `else if (!(bp_misp_det | bp_misp_pend))`
**删掉的原文**：
> // v9 上板改造修正：**一次预测错误只重定向一次**。
> //   bp_mispredict 原来是电平信号，只要那条被判错的指令还停在 EXU 里就一直为 1。
> //   上板改造后引入存储侧 hold（同步 BRAM 取指/访存要停拍），EXU 可能被冻住好几拍，
> //   于是电平信号变成"连环重定向"：每一拍都 flush，重定向目标那条指令（例：
> //   ecall）永远进不了 EXU，整机锁死 —— 实测 prog.hex 就是这样停在结尾的。
> //   加一个 pending 标志：第一次判错时给出一次重定向脉冲，之后保持静默，
> //   直到这条判定彻底消失才允许下一次重定向。
> //   v9 修复（B4）：清零条件改为"判定彻底消失"，不能再用 raw==0 —— raw 会被
> //   mem_stall 压成 0，那样会把"还在挂起的判定"当成"没有误预测"。
**补充说明**：同一症状的独立记录见 `syn/修复进度_C系列.md` §3（死信号清理）与
`docs/模块阅读文档.md` §9.2（"重定向必须'一次性'，而且不能清掉系统指令自己"）。

---

## CONTROL-7：`EXU_inst_clear` 不含 `system_redirect`（原编号：v9 新增 C4 / v9 上板改造修正）
**位置**：`assign EXU_inst_clear = ...` 之前的整段（改后保留并补了"逐项"说明）
**删掉的原文**：
> // 注意这里**不含 system_redirect**：ecall/mret/fence.i 这三条**必须自己流到 WB**
> // （ecall 要在 WB 写 mcause/mepc，mret 要恢复 mstatus，fence.i 要在 EX 级清 ICache），
> // 而它们触发的重定向只应该冲掉**它们后面**那些错路径指令 —— 后者由 dnpc_flag
> // 送到 IDU 的 flush 完成，不需要清 EXU 这一条。原来把 system_redirect 并进来，
> // 会在 ecall 被接收进 EXU 的同一拍把它的 csr_wen 清成 0（实测：ecall 永远不产生
> // 异常，mepc/mcause 恒为 0，程序在入口处死循环）。
**补充说明**：`syn/ecall重定向故障_根因与修复.md` 是这条坑的专项记录（改后注释里已引用
文档的语义，锚点以本节为准）。

---

## CONTROL-8：`EXU_ctrl_valid` 必须参与一切来自 EXU 的判定（原编号：v9 上板改造修正）
**位置**：`logic EXU_ctrl_valid;` 上方（改后为压缩后的 `★ 不变量` + 原因）
**删掉的原文**：
> // **EXU_valid 必须参与限定**：EXU 的 valid 与它的控制寄存器并不总是同步
> //   （valid_last=0 时 EXU 不更新控制寄存器，只把自己的 valid 拉低），
> //   于是会出现"EXU_valid=0、但 jump_flag/branch_flag/pred_* 还留着上一条指令的值"。
> //   这些残留值会让 Control 一直判出分支/跳转和预测错误，无休止地重定向，
> //   把重定向目标那条指令永远冲掉 —— 实测 prog.hex 就是这样在 jal 之后死循环的
> //   （EXU_pc 固定、EXU_valid 恒 0，而 dnpc_flag 周期性为 1）。
**补充说明**：同一机制在 `docs/模块阅读文档.md` §8.2 第一条有独立记录
（"EXU 的 valid 与控制寄存器由两个 always_ff 维护"）。

---

## CONTROL-9：`mem_stall` 这一项不能作用于分支/跳转（原编号：v9 修复 B4）
**位置**：`assign EXU_inst_clear` 的 `| (mem_stall & ~(branch_flag | jump_flag))` 项
**删掉的原文**：
> // v9 修复（B4）：mem_stall 期间**不能把分支/跳转指令作废**。
> //   把 mem_stall 并进 EXU_inst_clear 的理由是"存储侧 hold 时取回的数据无效，
> //   EX 级这条要作废重放"——那只对 load 成立。分支/跳转不依赖访存数据，把它在
> //   这一拍清成空操作，等于**把它还没做的重定向判定一起扔掉**：
> //   实测（loop_min 退出那次迭代）：IF 级已经按"预测跳转"取到 0x0C，而 0x14 上
> //   那条 blt 在 EX 里被清掉（EXU_valid=0、控制位残留），它实际"不跳"这件事
> //   再也没人判 → CPU 顺着错路径一直循环（x1 跑到 2491 而不是 10）。
> //   现在把它留给 bp_misp_det 去判：hold 期间判定条件成立就挂起（bp_misp_pend），
> //   等取指侧能接收（~mem_stall）时补发一次重定向。
**补充说明**：这条与 `IFU.sv` 的 B4 是同一个根因的两个侧面（"预测跳转必须与顺序推进
用同一个接受条件"），见 `docs/模块阅读文档.md` §9.2b 第 4 条与本目录 `IFU.sv.md`。

---

## CONTROL-10：死信号 `bp_redir_taken` / `bp_pend_taken` 的删除记录（原编号：v9 修复 C6）
**位置**：`logic [31:0] bp_redir_target;` 上方 + `bp_pend_taken` 声明处
**删掉的原文**：
> // v9 修复（C6）：`bp_pend_taken` 已删除。
> //   它的唯一用处是拼 bp_redir_taken，而那个信号没人读；补发重定向只需要
> //   "跳到哪"（bp_pend_target 已经把"不跳则 pc+4"折叠进去了），
> //   方向信息不参与 IFU 的重定向决策，留下就是死寄存器。

> // v9 修复（C6）：这里原来还有一个 `bp_redir_taken`（= bp_misp_pend ? bp_pend_taken
> //   : actual_taken），但**从头到尾没有任何地方读它** —— Quartus 直接报
> //     Warning (10036): object "bp_redir_taken" assigned a value but never read
> //   死信号已删除。方向信息本身不需要单独送出去：
> //   dnpc 已经承载了"跳到哪"，IFU 只看 dnpc/dnpc_flag；
> //   而预测器的方向更新走 bp_update_taken（见下）。
**补充说明**：C6 一共清理 5 个死信号，`Control.sv` 占其中 2 个（另见
`syn/修复进度_C系列.md` §3 的表格）。**保留这两个信号的编号（C6）是对外索引，不要丢。**

---

## CONTROL-11：C4 之前的 `bp_misp_det` 屏蔽集合（历史原文，已被 C4 取代）
**位置**：`assign bp_misp_det = ...`（C4 落地后改成把 `mem_stall` 门控挪到 `bp_mispredict_raw`）
**删掉的原文**：
> assign bp_misp_det = EXU_ctrl_valid & ~(intr_take | system_redirect | mem_stall) &
>                      ((actual_taken != EXU_pred_taken) ||
>                       (actual_taken && (actual_target != EXU_pred_target)));
**补充说明**：这是 C4 之前的**旧口径**（把 `mem_stall` 放在判定里而不是 raw 里），
保留在此仅作对照 —— 它与 CONTROL-3 的 B4 结论冲突，**不要照着它改回去**。
当前口径：判定（`bp_misp_det`）不受 `mem_stall` 影响，门控只加在 `bp_mispredict_raw`。

---

## CONTROL-12：`icache_clr`（原文无注释，锚点在此收口）
**位置**：`assign icache_clr = fence_i_flag & EXU_valid;`
**删掉的原文**：
> （原文无注释。）
**补充说明**：`fence.i` 必须在 **EX 级**（而非译码级）清 I-Cache，且只在 `EXU_valid` 时清 ——
否则 EXU 空拍上残留的 `fence_i_flag` 会反复清缓存。改后未加注释（不属本次 C 类清单），
但把它作为待补项留档在此。

---

## CONTROL-13：`EXU_inst_clear` 的两个使用场景原文（原编号：v9 上板改造修正）
**位置**：`assign EXU_inst_clear = ...` 上方第一段（改后保留）
**删掉的原文**：
> // EXU_inst_clear 的作用是**把 EX 级这条指令的控制信息清成 0（变成空操作）**，
> // 用于两类情况：
> //   ① 真正的冲刷：重定向（中断/预测错误/mret/ecall/fence.i）——错的指令必须消失；
> //   ② load-use 冒险：IDU 里那条消费者指令会被 EXU **提前收走**（v9 的 valid/ready
> //      约定里 EX 级只有在 valid_last=1 时才更新寄存器，所以没法用"灌气泡"的方式
> //      把它挡在 IDU 里），它当拍的操作数还没被前递好，必须清掉。
> //      注意 IDU 的流水寄存器在暂停期间是冻结的，消费者仍然留在 IDU；暂停解除后
> //      IDU 会把它**再送一次**给 EXU，那一次的 load 已经走到 LSU 第三级
> //      （forward_val_wb 上就是数据），由 Data_hazard 的 3'b011 正确前递。
> //      所以"被清掉的那一份"是不带任何副作用（R_wen/mem_wen 全 0）的空操作，
> //      不会重复写寄存器、也不会重复写内存。
**补充说明**：这段是理解 `load_use_stall` 为什么放进 `EXU_inst_clear` 的关键
（反面方案"拉低 valid 挡指令"会死锁，见 `docs/模块阅读文档.md` §9.3）。

---

## CONTROL-14：前递/冒险判定只有一份口径（原编号：v9 修复 C2 / 历史缺陷 B5）
**位置**：`Data_hazard` 例化前的注释块 + `load_use_stall` 相关处
**删掉的原文**：
> // v9 修复（C2）：`exu_load_use / mem_load_use / pipe_load_use` 三个分级明细
> //   已经搬进 Data_hazard（与它自己的命中条件同一份代码算出来），
> //   从那里引进来；本模块**不再**自己写第二份"某级是不是 load"的判断。
> //   历史教训（B5）：两份口径一旦不同步，就会出现"Control 不判停顿、
> //   而 Data_hazard 把可用的 load 数据挡掉"，消费者读到寄存器堆旧值。

> // v9 修复（C2）：`IDU_rs1_choice / IDU_rs2_choice` 不再由本模块产生，
> //   改由 Data_hazard 输出（它是唯一的前递裁决源），这里只声明成 logic 接收。
> //   同理，load-use 冒险判定也搬到了 Data_hazard（见文件末尾注释）。
**补充说明**：`syn/修复进度_C系列.md` §1 有完整对照（旧写法两个模块各一份 `mem_load_use`）；
`Control.sv` 的旧代码 `assign mem_load_use = MEM_mem_ren && MEM_valid && (...)` 已被删除，
**不要**再在本模块里恢复任何"某级是不是 load"的判断。

---

## CONTROL-15：`bp_update_*` 与 `system_redirect` 的原文留档（原编号：v9 修复 C4）
**位置**：三个 `bp_update_*` 赋值 + `assign system_redirect = ...`
**删掉的原文**：
> // 预测器在 EX 级写入：真实方向 + 真实目标
> // 系统事件（异常返回 / ecall / fence.i）不由预测器覆盖，必须强制重定向。
> // （system_redirect 的声明已上移到首次使用处之前）
> // v9 修复（C4）：**同步异常也走这条"强制重定向、不许预测器覆盖"的路**。
> //   trap_redirect 是异常的单拍脉冲（见文件上方 C4 说明）。
**补充说明**：`bp_update_en = EXU_valid & (branch_flag | jump_flag)` 是预测器"只在 EX 级写
一次"的保证；`bp_update_target = actual_target`（jump 用 `Ex_result`，branch 用 `branch_pc`）
与 `Branch_Predictor` 的 BTB 写口口径一致。

---

## CONTROL-16：`TRAP_ENABLE` 总开关的完整理由（原编号：v9 新增 C4）
**位置**：模块参数表 `parameter TRAP_ENABLE = 0` 上方
**删掉的原文**：
> // v9 新增（C4）：同步异常体系总开关。
> //   1 = 打开：非法指令 / 访存非对齐 / 指令地址非对齐 都会陷入 mtvec 并登记
> //             mcause/mepc/mtval（IDU 的合法性译码 + EXU 的异常锁存同时生效）。
> //   0 = 关闭：这些异常不产生重定向，退回到和修复前一致的控制流行为。
> //             （非法指令的"副作用清零"仍保留 —— 那层在 IDU 里，属于安全修正。）
> //
> // 为什么要留开关：
> //   1) 异常体系会改变"哪些指令重定向 PC"，牵动 EXU↔Control 那条很绕的组合链。
> //      留开关可以逐项开启、逐项回归，出问题能立刻定位到是哪一项；
> //   2) 教学场景需要"干净基线"（只用 ecall/中断），不想被额外异常干扰；
> //   3) 综合/时序对比时可以把新逻辑整块关掉，量化它的资源/Fmax 代价。
> //   默认 1（打开）。
**补充说明**：★ 注意原文最后一句"默认 1（打开）"与**代码实际取值 `parameter TRAP_ENABLE = 0`**
不符 —— 这是原文的一处笔误/过期描述。改后的注释已按实际行为写成"默认 0"，
并按 `syn/修复进度_C系列.md`（`TRAP_ENABLE=1` 时 `prog_loop` 两项失败、12/14）补上了
"当前交付默认关"的理由。**代码没有改动**（仍是 `= 0`），只修正了注释描述。

---

## CONTROL-17：端口级"存储侧停拍透传"说明（原编号：v9 上板改造修正）
**位置**：`input mem_stall` 端口上方
**删掉的原文**：
> // 存储侧停拍请求由 myCPU 并入（ICache/DCache 的 hold），Control 只做透传，
> // 目的是把它从 IFU_stall 里单独引出来给 EXU_inst_clear 用。
**补充说明**：改后原样保留。它解释了为什么 `mem_stall` 是一个**独立端口**而不是从
`IFU_stall` 里现拆 —— `IFU_stall` 里还并了 `mdu_busy`，两者不能混用（见 §CONTROL-9/§CONTROL-13）。

---

## CONTROL-18：本模块职责的一句话描述（原编号：文件头 / v9 修复 C2）
**位置**：文件头第一行（原 before 文件的开头三行）
**删掉的原文**：
> // Control 负责三件事：
> // 1. 收束所有会改写 PC 的事件，生成 dnpc/dnpc_flag。
> // 2. 识别 load-use 冒险，决定是否暂停 IFU/IDU 并清空执行级。
> // 3. 根据 Data_hazard 的编码真正完成前递值选择。
**补充说明**：第 2 条（"识别 load-use 冒险"）按 v9 修复 **C2** 已经**不再由本模块做** ——
判定搬进了 `Data_hazard`，本模块只把 `load_use_stall` 接到冻结/清空逻辑上。
改后的文件头写成"重定向仲裁 / 暂停与清空 / 前递值选择"，特意保留了"暂停与清空"
这一半职责（接线仍在 Control），只是不再声称"识别"。

---

## CONTROL-19：分支预测校验的三行说明（原编号：v9 上板改造修正）
**位置**：`assign actual_taken` 上方
**删掉的原文**：
> // -----------------------------------------------------------------------
> // 分支预测校验：
> //   actual_taken  : 本条控制流指令实际是否跳转（branch 命中或 jump）
> //   actual_target : 实际目标（jump 用 Ex_result，branch 用 branch_pc）
> //   bp_mispredict : 预测方向或预测目标与实际不符
> // -----------------------------------------------------------------------
**补充说明**：改后原样保留（未压缩）。留档是因为 `bp_mispredict` 在这里只是一行
"方向或目标不符"的描述，它真正的一次性化机制在 §CONTROL-6，两处必须合起来读。

---

## CONTROL-20：`~trap_take_q_r` 的去重原文（原编号：v9 新增 C4）
**位置**：`logic trap_take_q_r;` 上方
**删掉的原文**：
> // trap_take：在异常指令位于 EX 级的那一拍认定一次异常。
> //   ~exc_pending_q 用来**去重**：ensure 同一拍不会重复登记
> //   （trap_take_q 已经把登记延续到下一拍，这里不重复触发）。
**补充说明**：★ 注意原文写的是 `~exc_pending_q`，而代码里实际存在的寄存器是
`trap_take_q_r`（`assign trap_take = exc_pending & ~trap_take_q_r;`）—— 原文用的是
一个**并不存在的信号名**（早期方案里那个"异常态打一拍"的名字）。
改后的注释按实际信号名写成 `~trap_take_q_r`，**代码未改动**，只修正了注释里的名字。

---

## CONTROL-21：`bp_pend_target` 的"含不跳则 pc+4"（原编号：v9 修复 B4/B7）
**位置**：`logic [31:0] bp_pend_target;` 的行末注释
**删掉的原文**：
> // 挂起时的实际目标（含“不跳则 pc+4”）
**补充说明**：改后原样保留。语义要点：`bp_pend_target` 里折叠的是
`actual_taken ? actual_target : (EXU_pc + 32'd4)`，所以**方向信息不需要单独挂起**
（这正是 C6 能删掉 `bp_pend_taken` 的前提，见 §CONTROL-10）。原文用的是中文引号
“不跳则 pc+4”，逐字保留在此。

---

## CONTROL-22：`bp_hold_exu` 的用途原文（原编号：v9 修复 B7）
**位置**：`output logic  bp_hold_exu` 上方 + `assign bp_hold_exu = ...` 上方
**删掉的原文**：
> // v9 修复（B7）：误预测"已存在判定"（当拍判定或已挂起）——送给 EXU，
> //   让它在窗口里**不接收新指令**，否则错路径指令会赶在重定向之前进入 EX 并提交。

> 送给 EXU 的"暂停接收"窗口（见端口说明）

**补充说明**：改后保留并补了"只挡接收、不挡清空"这一句（`jal` 的 link 靠重定向当拍
正常交给 LSU），依据是 `docs/模块阅读文档.md` §9.2b 第 4 条。

---

## CONTROL-23：`dnpc` 的取值来源说明（原编号：v9 上板改造修正 / v9 新增 C4）
**位置**：`assign dnpc = ...` 上方
**删掉的原文**：
> // dnpc 统一承载控制流重定向：
> //   - 中断    ：入口 mtvec；
> //   - 预测错误：跳转用真实目标，不跳转回退到 pc+4；
> //   - 系统事件：mret 用 mepc，ecall/异常入口用 mtvec。
**补充说明**：改后保留并写清了"预测错误的目标折叠在 `bp_redir_target` 里、挂起时优先用
`bp_pend_target`"，以及"这条三元链的顺序必须与 `dnpc_flag` 的或项顺序一致"。
原文的 `mtvec`/`mepc` 在端口上叫 `mtvec_out`/`mepc_out`。

---

## CONTROL-24：前递编码翻译的一句比喻（原编号：v9 修复 C2）
**位置**：`assign EXU_rs1_in` 上方
**删掉的原文**：
> // 这里把前递编码翻译成真正的数据值。
> // 可以把它看成“译码级前面的隐式旁路多路复用器”。
**补充说明**：改后原样保留，并在其下补了完整的 3 位编码对照表
（001=EXU / 010=M1 / 101=M2 / 011=M3 / 100=WB / 其余=寄存器堆），
表里的"M2 对 load 只是地址不是数据"来自 `docs/模块阅读文档.md` §9.1。

---

## CONTROL-25：B6 —— EXU 级前递必须取 `rd_value`，不能取 `Ex_result`（原编号：v9 修复 B6）
**位置**：`input [31:0] EXU_forward_val,` 上方
**删掉的原文**：
> // v9 修复（B6）：EXU 级的前递值。
> //   对 jump/CSR 来说，写进 rd 的是 rd_value（jal/jalr 的 link、CSR 读值），
> //   而 Ex_result 对 jump 是**跳转目标地址**、对 CSR 是地址。原来 EXU 级前递直接
> //   用 Ex_result，于是 `jal x4, T` 后面紧跟读 x4 的指令会拿到 T（实测：
> //   `jal x4,0x24c` + `sw x4,...` 把 0x24c 写进了内存，应为 link 0x190）。
> //   MEM/PIPE/WB 三级早已按这个口径处理（见 MEM_forward_val），这里补齐 EXU 级。
**补充说明**：★ 这是 A 类不变量：**EXU 级前递用 `EXU_forward_val`，不许用 `Ex_result`。**
改后的 `Control.sv` 里已补成 `★ 不变量 + 原因`（含 `jal x4,0x24c` 实测），锚点 §CONTROL-25。
同一机制的 MEM/PIPE/WB 侧见 `MEM_forward_val`（`myCPU.sv`）与
`docs/模块阅读文档.md` §9.2b 第 6 条。

---

## CONTROL-26：C4 异常通道的"分段判定"背景（原编号：v9 新增 C4）
**位置**：`input EXU_illegal_exc` 等端口上方的整段
**删掉的原文**：
> // ---- v9 新增（C4）：统一异常通道（送给 CSR/Reg_Stack）----
> //   trap_take / trap_take_q ：确认接收一次同步异常的**单拍脉冲**（见下方 always_ff）
> //   trap_cause              ：`EXC_* 独热码，CSR 据此写 mcause/mtval
> //   fault_addr / fault_inst ：mtval 的取值来源
> // ---- v9 新增（C4）：来自 EXU 的同步异常（已锁存，与 EX 级指令一一对应）----
> //   "非法指令 / 访存非对齐 / 指令地址非对齐"三类同步异常的判定分别在
> //   IDU（非法、访存非对齐，当拍算地址）与 EXU（跳转目标对齐）完成，
> //   Control 只负责**定优先级、发重定向脉冲、告诉 CSR 写什么 cause/mtval**。
**补充说明**：改后把这两段的实质保留为"两拍分工 + 判定分段 + 三件事"共 4 行，只去掉了
展开的括注。判定位置的完整表格见 `syn/修复进度_C系列.md` §4.1。

---

## CONTROL-27：B7 —— `bp_hold_exu` 必须含当拍的 `bp_misp_det`（原编号：v9 修复 B7）
**位置**：`output logic  bp_hold_exu,` 上方
**删掉的原文**：
> // v9 修复（B7）：误预测"已存在判定"（当拍判定或已挂起）——送给 EXU，
> //   让它在窗口里**不接收新指令**，否则错路径指令会赶在重定向之前进入 EX 并提交。
> //   必须包含当拍的 bp_misp_det：挂起标志是在判定那一拍的时钟沿才置位的，
> //   只送挂起标志会晚一拍，挡不住正好在判定拍进入 EX 的那条错路径指令。
**补充说明**：★ 这是 A 类不变量：`bp_hold_exu = bp_misp_det | bp_misp_pend`，
**不能只送 `bp_misp_pend`**（晚一拍就挡不住判定拍进入 EX 的错路径指令）。
改后已把这一条并入 `bp_misp_det` 的 `★ 不变量` 注释块（锚点 §CONTROL-27）。
另注：`bp_hold_exu` 只挡"接收新指令"，不挡"清空" —— 正在 EX 里那条被判错的跳转仍要在
重定向当拍正常交给 LSU（`jal` 的 link 靠这一拍），见 `docs/模块阅读文档.md` §9.2b 第 4 条。

---

## CONTROL-28：`EXU_ctrl_valid` 的作用（原编号：v9 上板改造修正）
**位置**：`logic EXU_ctrl_valid;` 上方
**删掉的原文**：
> // **EXU_valid 必须参与限定**：EXU 的 valid 与它的控制寄存器并不总是同步
> （改后注：原文另有"branch_taken 只看 EX_result[0]，因为 EXU 已把各种分支条件归一化到
> 最低位"与"mdu_busy 期间 EX 级寄存的是刚发射的 M 指令（其残留标志不可信），因此忙期一律
> 屏蔽分支/跳转判定"两句，见 §CONTROL-29/§CONTROL-30。）
**补充说明**：完整原文见 §CONTROL-8。改后 `Control.sv` 里
`assign EXU_ctrl_valid = EXU_valid;` 上方保留了 `★ 不变量：EXU_ctrl_valid 必须参与
本模块一切"来自 EXU 的控制事实"` 及其原因（残留值导致无休止重定向）。

---

## CONTROL-29：`branch_taken` 只看 `EX_result[0]`（原编号：文件头 / 上板改造）
**位置**：`logic branch_taken;` 上方
**删掉的原文**：
> // branch_taken 只看 EX_result[0]，因为 EXU 已把各种分支条件归一化到最低位。
**补充说明**：改后压缩成一行"只看 EX_result[0]（EXU 已把分支条件归一化到最低位）"，
语义未弱化；同句里的 `mdu_busy` 屏蔽理由见 §CONTROL-30。

---

## CONTROL-30：`mdu_busy` 忙期一律屏蔽分支/跳转判定（原编号：上板改造）
**位置**：同上（`logic branch_taken;` 上方）
**删掉的原文**：
> // mdu_busy 期间 EX 级寄存的是刚发射的 M 指令（其残留标志不可信），
> // 因此忙期一律屏蔽分支/跳转判定。
**补充说明**：★ 这是 A 类不变量（`branch_taken`/`actual_taken` 都必须 `& ~mdu_busy`）：
MDU 是多拍迭代，忙期 EX 级一直占着那条 M 指令，其 `branch_flag/jump_flag` 是**上一条**
指令的残留。改后压缩成"mdu_busy 期屏蔽（残留标志不可信）"一行，锚点 §CONTROL-30。

---

## CONTROL-31：funct3 区分 load / store，以及 trap_cause 的优先级链（0 > 2 > 4/6）（原编号：v9 新增 C4）
**位置**：`assign exc_iaddr_mis = ...` 之后；以及 `assign trap_cause = ...` 上方的 `★ 不变量`
**删掉的原文**：
> // 说明：funct3 只用来区分 load/store（mcause 4 还是 6），
> //   0xx=load 族（000 lb / 001 lh / 010 lw / 100 lbu / 101 lhu），
> //   1xx 里只有 001(sh) 是 store 族（sb=000、sw=010 天然对齐，不会走到这里）。
>
> // 优先级编码（独热）：bit3=指令地址非对齐, bit0=非法指令,
> //                    bit1=load 非对齐, bit2=store 非对齐
> //   ★ 不变量：优先级链顺序（iaddr→ill→load_mis→store_mis）就是规范要求的
> //   0 > 2 > 4/6，换序会让 mcause 报错种类。
**补充说明**：改后原样保留（只把"000 lb / 001 lh / 010 lw / 100 lbu / 101 lhu"缩写成
"lb/lh/lw/lbu/lhu"）。判定式本身：`exc_load_mis = misalign & ~funct3[1] & funct3[2]`（100/101）、
`exc_store_mis = misalign & funct3[1] & ~funct3[2]`（001）。
**优先级链为什么是这个顺序**：`trap_cause` 的三元链把 iaddr(0) 放最前、ill(2) 次之、
load/store 非对齐(4/6) 最后，与 RISC-V 特权规范要求的同步异常优先级一致 —— 同一条指令同时
触发两类异常时（例：跳转目标非对齐 + 该跳转本身编码非法），报到 `mcause` 的必须是优先级高的
那一类。**换序不会报错、不会崩，只会让 mcause 报错种类**，所以必须靠注释拦住。
（RTL 正文只留结论 + 本节指针，不变量本体在 `Control.sv` 的 `assign trap_cause` 上方。）

---

## CONTROL-32：`TRAP_ENABLE=0` 的等价语义（原编号：v9 新增 C4）
**位置**：`assign exc_any = TRAP_ENABLE ? ... : 1'b0;` 上方
**删掉的原文**：
> // v9 新增（C4）：TRAP_ENABLE=0 时整块异常逻辑失效（不重定向、不登记），
> //   等价于修复前的控制流。IDU 侧的"非法指令副作用清零"仍然生效，
> //   所以即使关掉开关，非法指令也不会被真的执行掉。
**补充说明**：★ 关键点：关开关**不会**让非法指令被真的执行掉 —— 副作用清零在 IDU 里，
属于安全修正，与本开关无关。改后压缩成一行，完整原文在此。

---

## CONTROL-33：`exc_pending` 的一行说明（原编号：v9 新增 C4）
**位置**：`assign exc_pending = exc_any & EXU_valid;` 上方
**删掉的原文**：
> // 本拍 EX 级确实有一条指令、且它带着异常
**补充说明**：改后改为同一行末尾注释（语义完全一致）。

---

## CONTROL-34：中断接收判定（精确中断）的原文（原编号：上板改造 / v9 新增 C4）
**位置**：`assign intr_safe = ...` 上方
**删掉的原文**：
> // -----------------------------------------------------------------------
> // 中断接收判定（精确中断）：
> //   仅当执行级没有会造成重定向的分支/跳转/fence、当前译码指令不是 ecall/mret、
> //   且没有 load-use 暂停时才接受中断，从而保证 mepc 指向真正被中断的指令。
> //   中断入口固定为 mtvec。
> // -----------------------------------------------------------------------
**补充说明**：改后把这段原文压成同样的三句（保留），并补了 `intr_safe` **逐项**作用的
`★ 不变量`（这是用户点名的 C 类重点），逐项说明：
`IDU_valid`=译码级确实有指令可记为 mepc；`~(branch_flag|jump_flag|fence_i_flag)`=让会改 PC 的
指令先走完；`~mret_flag/~ecall_flag`=系统指令不插队；`~IFU_stall`=译码级那条还没被接收；
`~mdu_busy`=MDU 迭代期 EX 级一直占着那条 M 指令。锚点 §CONTROL-34。

---

## CONTROL-35：`mdu_busy` 并入前端暂停的理由（原编号：上板改造）
**位置**：`assign IFU_stall = load_use_stall | mdu_busy;` 上方
**删掉的原文**：
> // mdu_busy 也并入前端暂停：MDU 迭代期间 EX 级一直占着那条 M 指令，
> //   前端必须停住，否则会把后续指令推进来覆盖它。
**补充说明**：改后压缩成一行半（"MDU 迭代期 EX 级一直占着那条 M"），并配上
`★ 不变量：mdu_busy 只能进 IFU_stall、不能进 EXU_inst_clear 的 load-use 项`
（否则打断 M 指令自己的向后 valid，乘除结果丢失 —— 实测 `prog_mul` 从全过变成 1 处不符，
见 `docs/模块阅读文档.md` §9.3 末注）。

---

## CONTROL-36：两路暂停信号的分工（原编号：v9 修复 C2）
**位置**：`assign IFU_stall = ...` 上方
**删掉的原文**：
> // 两路暂停信号：
> //   load_use_stall —— 只含 load-use 冒险（供 EXU 的冲刷判定）
> //   IFU_stall      —— 前端总暂停：再并入 mdu_busy，供 IFU 冻结 PC/取指使用
**补充说明**：★ 这是 A 类不变量：两路必须分开，别合并成一个符号。改后压成
`★ 不变量：两路暂停信号必须分开` + 两行分工说明（语义未弱化），锚点 §CONTROL-36。

---

## CONTROL-37：`Data_hazard` 例化前的分工描述（原编号：v9 修复 C2）
**位置**：`Data_hazard Data_hazard_inst (` 上方
**删掉的原文**：
> // Data_hazard 是**唯一**的前递/冒险裁决源：
> //   它输出 IDU_rs1_choice / IDU_rs2_choice（谁来前递）与 load_use_stall
> //   （要不要停），本模块只负责把编码翻译成数据值、把 stall 接到冻结逻辑上。
> //   v9 修复（C2）：load-use 的三个分级条件已经搬进 Data_hazard，不再出现在这里。
**补充说明**：改后保留同样的三句（措辞略紧）+ `★ 不变量：本模块不许再出现任何
"某级是不是 load / 数据可不可用"的判断`，锚点 §CONTROL-14/§CONTROL-37。

---

### Data_hazard.sv

> 本文件只保存**从 Data_hazard.sv 注释里删掉/压缩掉**的原文，一个字都没有改写。
> 相关源码：`E:\share doc\v9\Data_hazard.sv`
> 本文件是 load-use / 前递裁决的**唯一出处**，B5 与 C2 是同一处缺陷的两次修补，
> 因此它们的原文合并在 §HAZARD-1 里完整保留。

---

## HAZARD-1：load-use 判定为什么必须搬进 Data_hazard、且三个分级只在这里算
（原编号：v9 修复 C2，上游是 B5 缺陷）

**位置**：文件头块注释（原第 1~30 行，整段），加上文件中部
`v9 修复（C2）：load-use 冒险判定（原来在 Control 里）` 那一整块（原第 120~140 行），
再加上 `load_use_stall` / `exu_load_use` 等端口的说明。

这两段原文现在压成：文件头 3 行摘要 + 文件中部一块 `★ 不变量`（含机制）+
`★ 不变量：不乘 IDU_valid` + `★ 不变量：EXU 不乘 EXU_valid`。

### 删掉的原文 ①：文件头（整段，逐字）

> ```systemverilog
> /* Deal with the Data hazard —— v9 的**唯一**前递/冒险裁决源
>  *
>  * 修复（C2）：这个模块原来是"前递仲裁器"，而 load-use 冒险判定散在 Control 里，
>  * 两边各写一份"某一级的数据到底可不可用"的条件。历史上 B5 缺陷就是这么出的：
>  *   - Control 的 mem_load_use 要求 MEM_valid；
>  *   - 这里的 mem_hit 却不检查 MEM_valid；
>  * 两份口径一旦不同步，就会出现"Control 不判停顿、而这里把优先级更高的
>  * 3'b000 返回，把 MEM2 级上真正可用的 load 数据挡掉"，消费者读到寄存器堆旧值。
>  *
>  * 现在把口径**收敛到这一个文件**，并且用同一组命中条件同时驱动两件事：
>  *   1) 谁来前递   —— IDU_rs1_choice / IDU_rs2_choice（数据多路选择的编码）
>  *   2) 要不要停   —— load_use_stall（某一级是 load 且 rd 与 IDU 的源重叠）
>  * Control 只做两件事：把编码翻译成数据值、把 load_use_stall 接到 PC/EXU 的冻结上。
>  * **Control 里不再有任何"某级是不是 load / 数据可不可用"的判断。**
>  *
>  * 命中口径（五个前递源，逐条写清，不再有隐含假设）：
>  *   EXU      : R_Wen 且**不是 load**（load 在 EXU 里 EX_result 还是地址，不能用）
>  *              —— 不查 EXU_valid：它是仲裁链里最快的一环，valid 由 load_use 承担
>  *   MEM      : R_Wen 且 valid 且不是 load
>  *   MEM_PIPE : R_Wen 且 valid 且不是 load
>  *   MEM2     : R_Wen 且 valid（load 的数据**只在**这一级前递）
>  *   WB       : R_Wen 且 valid
>  *   rd == 0 的任何一级都不算命中（x0 永远读寄存器堆的 0）。
>  *
>  * load-use 停顿口径（必须与上面的"可用性"严格互补）：
>  *   某一级是 load、rd != 0、rd 与 IDU 的 rs1/rs2 重叠 → 数据当拍不可用 → 必须停。
>  *   三级分别是 EXU / MEM / MEM_PIPE；到 MEM2 数据已经可前递，不再停。
>  *   注意 EXU 一级**不看 EXU_valid**：被 EXU_inst_clear 作废的那一拍，
>  *   EXU_R_Wen/mem_ren 已经归零，"命中"与"停顿"会同时消失，语义自洽。
>  */
> ```

### 删掉的原文 ②：文件中部的 C2 块（整块，逐字）

> ```systemverilog
> /* ---------------------------------------------------------------------------
>  * v9 修复（C2）：load-use 冒险判定（原来在 Control 里）
>  * ---------------------------------------------------------------------------
>  * 判据与上面的"可用性"严格互补：
>  *   - EXU 里是 load      -> 数据不可用，必须停（exu_load_use）
>  *   - MEM 里是 load      -> 数据不可用，必须停（mem_load_use）
>  *   - MEM_PIPE 里是 load -> 数据不可用，必须停（pipe_load_use）
>  *   其余情况数据已就绪，由前递直接给值，不再停。
>  * 停顿长度因此自然覆盖到 load 数据可用的那一刻：数据可用的下一拍
>  * 三个条件全为 0，消费者被放行并拿到正确的前递值。
>  *
>  * 三级的"是不是 load 且 rd 与 IDU 的源寄存器相同"判定**不能**乘 IDU_valid：
>  *   IDU 在被 stall 的那一拍会把下游 valid 拉低，如果这里要求 IDU_valid=1，
>  *   暂停条件会在同一拍自己消失，消费者被提前放出去。
>  *   不乘也不会误判：IDU 空时 inst_d 是 NOP（rs1=rs2=0），而这里都要求 rd != 0，
>  *   NOP 永远匹配不上；被冻结的 inst_d 保留的正是那条等待中的指令的源寄存器。
>  *
>  * EXU 一级**也不乘 EXU_valid**（与上面 exu_hit 同一取向）：
>  *   被 EXU_inst_clear 作废的那一拍，EXU_R_Wen 与 EXU_mem_ren 已经归零，
>  *   "命中"和"停顿"会同时消失 —— 这正是 load-use 停顿的解除条件。
>  * ------------------------------------------------------------------------- */
> ```

### 删掉的原文 ③：`IDU_rs1_choice` 编码的初版说明（原第 94~95 行）

> ```systemverilog
> // rs1 优先级从近到远：EXU > MEM > MEM_PIPE > MEM2 > WB。
> // load 的结果固定在 MEM2 级前递（MEM/MEM_PIPE 级的 load 已在上面的命中条件里排除）。
> ```

（正本保留这两行，并在其后**新增**了 C 类补充：`3'b001/010/101/011/100/000`
各自对应哪一级 —— 原文只说了优先级，没说编码本身。）

### 删掉的原文 ④：`load_use_stall` / 分级明细端口的说明（原第 60~64 行）

> ```systemverilog
>     // v9 修复（C2）：冒险判定从 Control 搬到这里，与上面的命中口径同源。
>     output logic load_use_stall,     // 需要把 IDU/前端按停（供 Control 接 IFU_stall）
>     output logic exu_load_use,       // 分级明细，便于波形观察与调试
>     output logic mem_load_use,
>     output logic pipe_load_use
> ```

（正本保留端口名与两条行尾注释原样 —— 行尾注释在 `--check` 里属注释，改动安全，
但这里不需要改。）

### 删掉的原文 ⑤：rs2 侧与 MEM2 末句（第二轮压缩中改写了措辞，逐字留档）

> ```systemverilog
> // 与 rs1 同口径（见上方说明）
> ```
> ```systemverilog
> // rs2 采用同样的优先级编码，保证双源操作数的前递规则一致。
> ```
> ```systemverilog
> // 三级之后（MEM2 = LSU 第三级）load 数据已经在 forward_val_wb 里了，
> //   由 3'b011 编码直接前递，不再需要暂停。
> ```

（正本把前两句合并为 `// 与 rs1 同口径（见上方说明），rs2 用同样的优先级编码，
保证双源规则一致。`，末句压缩为 `// MEM2（LSU 第三级）的 load 数据已经在
forward_val_wb 里，由 3'b011 直接前递。` —— 语义与 `3'b011` 编码含义均未变。）

### 补充说明

- **B5 的真正教训**：`mem_load_use` 要求 `MEM_valid`、`mem_hit` 却不要求 —— 两边
  口径不同步，于是 `IDU_rs1_choice` 返回 `3'b000`（不前递 = 读寄存器堆旧值），
  而 MEM2 上真正可用的 load 数据被挡掉。正本因此把“口径只能有一份”写成
  `★ 不变量`，并明确“不许再把任何一级搬回 Control”。
- C2 的“冗余但必须写出来”这句判断在正本里被拆成两半：
  “谁来前递只有一个口径”属机制（保留在正本）；
  “实测加它前后全量回归逐项一致”属过程（移至本文件）。
- 原文里的 `3'b000` / `3'b011` 编码在正本中**补充**了含义（见 C 类要求），
  原始出处就是这一段 `IDU_rs1_choice` 的三元链。

---

## HAZARD-2：EXU 级的 load 不能当前递源（原编号：无 B 编号，属早期实测缺陷）

**位置**：`assign exu_hit_rs1` 之上（原第 72~78 行）。

**原文**：

> ```systemverilog
> // EXU 级的 load 结果**当拍还不可用**，不能作为前递源。
> //   原来的 exu_hit 只看 R_Wen/rd 匹配，优先级又最高，于是在“EXU 里是 load、
> //   IDU 里是它的消费者”的那一拍，会选中 EXU 级的旧值（EX_result 对 load 而言
> //   是地址），消费者拿到错数据（实测：lw 之后紧跟的 add 得到的是基址 x1，
> //   而不是 load 回来的值）。
> //   正确做法：EXU 级若是 load，就不认 exu_hit，让仲裁落到 MEM/MEM_PIPE，
> //   期间由 load_use_stall 把消费者按在 IDU 里等；到 MEM2 级再由 3'b011 前递。
> ```

**补充说明**：A 类（改了就会坏）。正本保留为 6 行 `★ 不变量` + 原因，
实测现象（`lw` 后紧跟的 `add` 拿到基址 x1）保留在原因里。

---

## HAZARD-3：WB 级前递补上 `WB_valid`（原编号：v9 修复 C5）

**位置**：`assign wb_hit_rs1` 之上（原第 85~92 行）。

**原文**：

> ```systemverilog
> // v9 修复（C5）：WB 级前递补上 WB_valid，与其他四个源口径一致。
> //   WBU 送出来的 WB_R_Wen 是**未被 valid 门控**的寄存值（WBU.sv 里
> //   R_wen_next = R_wen_reg & valid_reg，而送 Control 的是 R_wen_reg 本身），
> //   所以 WBU 里坐一条被作废的空操作时，WB_R_Wen 仍可能是 1、WB_rd/WB_rd_value
> //   仍是上一条的残值；若消费者 rs 正好撞上那个残值 rd，就会取走陈旧数据，
> //   而寄存器堆那一拍并没有写（写被 valid 掐掉了）。
> //   在现有流水线里这一条**应当是冗余的**（实测加它前后全量回归逐项一致），
> //   但显式写出来才能保证"谁来前递"只有一个口径。
> ```

**补充说明**：正本保留机制（`R_wen_next = R_wen_reg & valid_reg` 而送出去的是
`R_wen_reg`）+ “冗余但必须显式”那条结论，删掉的只是“实测加它前后全量回归逐项一致”
这类过程证据。

---

## HAZARD-4：MEM / MEM_PIPE 口径合并的那一行（原第 80~81 行）

**位置**：`assign mem_hit_rs1` 之上。

**原文**：

> ```systemverilog
> // MEM / MEM_PIPE 级的前递只认"非 load 且 valid"的指令，load 的数据一律由
> //   MEM2 级（forward_val_wb）提供；这样即使 valid/控制位不同步也不会误命中。
> ```

**补充说明**：A 类，正本原样保留（仅把 ASCII 引号统一为中文引号，属注释文字）。

---

## HAZARD-5：末尾的 `//Arbiter` 与 `IDU_valid` 端口

**位置**：`endmodule` 行尾与端口列表。

**原文**：

> ```systemverilog
> endmodule                                                           //Arbiter
> ```

**补充说明**：`IDU_valid` 端口是**输入但当前未被使用**（三个 load_use 都不乘它，
见 §HAZARD-1）；`//Arbiter` 是旧名字残留（这个模块以前叫 Arbiter）。
两者都**保持原样未动**，这里只记一笔，方便下一个人不要以为它是笔误。

---

### CSR.sv

> RTL 里对应的指针：`§CSR-1` ~ `§CSR-4`（原编号 v9 修复 C4 / C7）。
> 行号均指**改动前**的快照 `_comment_iter/before/core/CSR.sv`。

## CSR-1：`mtime` 原来是"每拍 +1"，改成分频计数器（原编号：v9 修复 C7）
**位置**：原第 75~81 行（`mtime / mtimecmp` 一节）
**删掉的原文**：
> // v9 修复（C7）：mtime 原来是**每拍 +1**。在 100MHz 下 1 拍 = 10ns，
> //   也就是 mtime 比真实时间快 1000 万倍，"用它算时间/延时"没有任何意义。
> //   现在改成带分频的递减计数器（decrementer）：
> //     MTIME_DIV = 1   -> 每拍 +1（与旧行为完全一致，回归脚本可用）
> //     MTIME_DIV = 100 -> 100MHz/100 = 1MHz，即每 1us 加 1
> //   分频计数器只占 $\log_2(DIV)$ 个触发器，代价很小。

**补充说明**：原注释写的是"**递减**计数器（decrementer）"，但代码里是
`mtime_reg <= mtime_reg + 32'd1` —— 实际是**递增**的。新的 RTL 注释按代码口径写作
"递增计数器"。`MTIME_DIV_DEFAULT` 定义在 `para.sv`（默认 100）。

## CSR-2：统一异常通道 `trap_take` / `trap_take_q`（原编号：v9 新增 C4）
**位置**：原第 38~44 行（端口注释）、第 146~148 行（`mstatus_wen`）
**删掉的原文**：
>     // ---- v9 新增（C4）：统一异常通道 ----
>     //   trap_take / trap_take_q 是 Control 发出的"确认接收一次异常"的单拍脉冲
>     //   （trap_take 在异常指令位于 EX 级时拉高，trap_take_q 在下一拍照原补发，
>     //    两条合并起来保证"一次异常只登记一次"，与 bp_misp_predict 的
>     //    pending 机制同一思路）。
>     //   cause ID 见 para.sv 的 `EXC_* 宏；**必须是独热编码**，这里用
>     //   mcause_mux / mtval_mux 把它翻译成 mcause 码与 mtval 值。
>     // v9 修复（C4）：异常（trap_take / trap_take_q）与中断/ecall/mret 一样会改 mstatus
>     //   —— 陷入时 MPIE<=MIE、MIE<=0。原来这里只有 intr_take|ecall_flag|mret_flag，
>     //   非法指令/非对齐访存这类同步异常不会关中断，语义是错的。

**补充说明**：原注释里的 `mcause_mux` / `mtval_mux` 是**当时设想的模块名**，落地时用的是
组合逻辑变量 `exc_mcause` / `exc_mtval`（在同一节里用 `always_comb` 翻译独热码）。
配套的另一半（两拍脉冲本身怎么产生、去重条件）见 `syn/修复史_全量.md` §CONTROL-5。

## CSR-3：`mcause` 要认得同步异常（原编号：v9 修复 C4）
**位置**：原第 187~189 行（`mcause` 一节文件头）
**删掉的原文**：
>     // v9 修复（C4）：mcause 原来只认"中断"与"ecall"两种来源，非法指令/非对齐访存
>     //   无处登记。现在多了一条同步异常通道，用 trap_cause（`EXC_* 独热码）翻译。

**补充说明**：`exc_mcause` 的 if/else 位序必须与 `Control.sv` 里 `trap_cause` 的编码
优先级一致（bit3 指令地址非对齐优先）。

## CSR-4：`mtval` 从"死寄存器"到真正落地；以及 `mtval_out` 漏 assign（原编号：v9 修复 C4 / C4 遗留）
**位置**：原第 213~244 行（`mtval` 一节）、第 228 行、第 262~264 行（文件末尾的说明）
**删掉的原文**：
>     // v9 修复（C4）：mtval_reg 原来是个**死寄存器**（只复位、从不写），
>     //   非法指令/非对齐访存本应把"出错指令编码 / 出错地址"放进去，软件没法定位。
>     //   RISC-V 语义：
>     //     非法指令        -> mtval = 出错指令编码
>     //     取指/访存非对齐  -> mtval = 出错的有效地址
>     //     中断/ecall/断点  -> mtval = 0
>     // 软件可写（CSRW_MTVAL 已并入位图低 4 位之外的位置，这里用一个自由位）
>     // v9 修复（C4 遗留）：**这一行以前漏了**，mtval_out 是个没有驱动的输出网。
>     //   后果（综合日志里其实写得很清楚，只是很容易被当成噪声跳过）：
>     //     WARNING: [Synth 8-3848] Net mtval_out in module/entity CSR does not have driver
>     //     WARNING: [Synth 8-6014] Unused sequential element mtval_reg_reg was removed
>     //   即 mtval_reg 写了也没人读（被当死寄存器优化掉），顶层 debug_mtval 恒 0。
>     //   于是"软件读 mtval 定位是哪条指令非法 / 哪个地址非对齐"这条路完全失效；
>     //   上板 ILA 的 probe11 也永远抓到 0，看起来像"ILA 没接对"，其实是 RTL 漏驱动。
>     // 注：mtval_reg 的声明与写入已经上移到"mcause/mtval"一节（C4 修复），
>     //   这里不再重复声明 —— 原来的 `always_ff` 只做复位、从不写入，
>     //   是个彻底的死寄存器，会让"软件读 mtval 定位异常"这条路完全失效。

**补充说明**：原注释第 228 行说"`CSRW_MTVAL` 已并入位图低 4 位之外的位置，这里用一个自由位"
—— **与代码不符**：`para.sv` 里没有 `CSRW_MTVAL`，`IDU.sv` 的 `csr_wen_next` 是
`{8'b0, ...8 个 CSR 项}`，高 8 位硬接 0，`mtval_wen` 里也没有 `csr_wen` 项。
即：软件 `csrw mtval` 写不进去，mtval 只能由硬件在陷入时填写。新 RTL 注释按代码口径改正。

## CSR-附录：原文件头（寄存器一览 / 陷入来源 / 设计要点）
**位置**：原第 4~25 行
**删掉的原文**：
> /* =============================================================================
>  * CSR.sv — 机器模式控制状态寄存器与中断控制器（v9 扩展）
>  * -----------------------------------------------------------------------------
>  * 维护的寄存器：
>  *   mstatus : MIE(bit3) / MPIE(bit7)
>  *   mie     : MSIE(0) / MTIE(7) / MEIE(11)
>  *   mip     : MSIP(0) 软件可写；MTIP(7) 由内部定时器硬件驱动；MEIP(11) 外部
>  *   mtvec / mepc / mcause / mscratch / mtval（保留）
>  *   mtime / mtimecmp：教学用内部定时器（自定义 CSR 0x7C0/0x7C1）
>  *
>  * 陷入来源：
>  *   - ecall          ：同步异常，mcause=11，入口 mtvec
>  *   - intr_take      ：异步中断，mcause=0x8000_0000|cause，入口 mtvec
>  *   - mret           ：返回，mstatus.MIE<=MPIE，pc<=mepc（PC 重定向在 Control 中）
>  *
>  * 设计要点：
>  *   - 陷入/返回的 CSR 更新都在“译码级”完成（ecall/mret/intr_take 均由 ID 级发起），
>  *     与软件 CSR 写（在 WB 级生效）分离；
>  *   - 中断优先级：MEI(11) > MSI(0) > MTI(7)；
>  *   - 中断是否真正被接收由 Control 结合流水线安全性决定，本模块只给出
>  *     “待处理且全局使能”的 intr_pending。
>  * =========================================================================== */

**补充说明**：以下零散注释也已压缩进新注释（原文备查）：
>     // 字节/半字…（无）
>     logic [31:0] mip_sw_reg;              // 软件可写部分（MSIP）
>     logic        mtip;                    // 定时器中断挂起（硬件）
>     assign mtip = (mtime_reg >= mtimecmp_reg);
>     assign meip = 1'b0;                   // 预留外部中断输入
>     // 优先级：外部(11) > 软件(0) > 定时器(7)
>     // 注：intr_pending 依赖 mstatus_reg，放在 mstatus 声明之后再赋值（见下）
>             // 陷入：MPIE <= MIE，MIE <= 0
>             // 返回：MIE <= MPIE，MPIE <= 1
>     assign mcause_wen = csr_wen[`CSRW_MCAUSE] | trap_commit;
>             if (intr_take)              mcause_reg <= {1'b1, 27'b0, intr_cause};  // 中断
>             else if (trap_take | trap_take_q) mcause_reg <= exc_mcause;           // 同步异常
>             else if (ecall_flag)        mcause_reg <= `MCAUSE_ECALL_M;            // 环境调用

## CSR-附录B：端口行注释（`pc` 的来路）
**位置**：原第 33 行
**删掉的原文**：
>     input  logic [31:0] pc,          // 被陷入指令的 PC（来自译码级）

**补充说明**：新注释把落点写全成"被陷入指令的 PC（来自译码级，**写进 mepc**）"——
它只在 `trap_commit` 为真那一拍被写进 `mepc_reg`（见 §CSR-4 与 `mepc` 一节），
其余拍这个端口的值不被本模块使用。

---

## 六、顶层与公共定义

### myCPU.sv

> 本文件只记录 **myCPU.sv 注释迭代中被删掉 / 被压缩掉的原文**（B 类故障战史与冗长叙述）。
> A 类接口契约与设计不变量仍留在 RTL 里（用 `★ 不变量：` 标出），这里只补"当初怎么发现的"。
>
> RTL 里引用的锚点：`§MYCPU-1` ~ `§MYCPU-8`（下方二级标题一一对应）。

---

## MYCPU-1：irom_en / 缓存计数器必须走顶层端口，不许用层次化引用（原编号：v9 修复 B8）
**位置**：端口列表 `output irom_en` 上方；debug 端口 `debug_icache_hit_cnt...` 上方；文件尾部 `assign irom_en = ...` 上方
**删掉的原文**：
> ```systemverilog
>     // v9 修复（B8）：把取指侧的存储器**读使能**引出来。
>     //   board/board_top.sv 原来是靠层次化引用 `u_cpu.icache_mem_en` 拿这个信号的，
>     //   但 myCPU 根本没有这个端口 —— 层次化引用在 iverilog / ModelSim 下能过，
>     //   真实综合工具会直接拒绝：
>     //     Quartus II: Error (10207): can't resolve reference to object "icache_mem_en"
>     //   结果就是**整机上不了板**（Analysis & Synthesis 失败，后续 fit 全部跑不起来）。
>     //   这与 perip_ren（数据侧，2022 年那次修复）是同一个问题，这里补齐取指侧。
> ```
> ```systemverilog
>     // v9 修复（B8）：四条缓存命中/缺失计数器引到顶层。
>     //   原来 board/board_top.sv 直接用层次化引用 `u_cpu.icache_hit_cnt` 等取它们，
>     //   而 myCPU 没有这些端口 —— 与 irom_en 是同一类问题，Quartus 报
>     //     Error (10207): can't resolve reference to object "icache_hit_cnt"
>     //   导致 Analysis & Synthesis 失败、整机上不了板。
>     //   这四条只用于板上观察（ILA / 数码管 / UART），不参与任何控制逻辑。
> ```
> ```systemverilog
> // v9 修复（B8）：缓存计数器走顶层端口（原来是 board_top 的层次化引用，综合不认）。
> ```
> ```systemverilog
>   // v9 修复（B8）：取指侧读使能引出（原来是 board_top 里的层次化引用，综合不认）。
>   //   irom_en 就是 ICache 的 mem_en：只在“本拍确实要向 IROM 发一次读”时为 1。
>   //   注：ICache 内部 cpu_en_r 上电后恒为 1，所以这个信号实际上一直为 1；
>   //   仍然显式引出，是为了不再依赖层次化引用，并给 SoC 侧留出按 ren 门控的余地。
> ```
**补充说明**：同一轮（B8）里，`debug_mcause/mepc/mtval/trap_take` 这四个口原来在 `board_top`
例化 myCPU 时也是**悬空**的（板上完全看不到异常），一并在这轮补齐。

## MYCPU-2：perip_ren 必须按 ren 门控，不许用自由运行读口（原编号：2022 年那次修复 + 验证报告 B2）
**位置**：端口列表 `output perip_ren` 上方
**删掉的原文**：
> ```systemverilog
>     // v9 修复：把数据侧的读使能引出来。板级同步 BRAM（board/sync_mem.sv）是按 ren
>     //   门控的；原来顶层没有这个端口，测试台只能用"自由运行读口"（每拍都读）来近似，
>     //   恰好把 DCache 的读握手 off-by-one 掩盖掉了（详见验证报告 B2）。
> ```
**补充说明**：这是"仿真过、板上错"的典型 —— 自由运行读口让 DCache 少算的那个读拍在仿真里
看不出来，只有换成按 ren 门控的真实同步 BRAM 才暴露。

## MYCPU-3：重定向诊断三根线（请求 / 背压 / 结果）必须同拍可见（原编号：v9 新增 B9）
**位置**：端口列表 debug 组；debug 口赋值区；IFU_Inst0 例化上方
**删掉的原文**：
> ```systemverilog
>     // v9 新增（B9）：把"重定向请求 / 下游 ready / 取指级 PC"三根线引到顶层。
>     //
>     // 为什么必须加这三个探针（这是上板调试的直接产物）：
>     //   上板 ILA 抓到"ecall 之后 PC 从不回到 mtvec、一路顺序爬行"。要定位到底是
>     //     ① dnpc_flag 根本没发出来，还是
>     //     ② 发出来了但被 IFU 里的门控（当时是 `dnpc_flag & ready`）吃掉，
>     //   光看 debug_wb_pc 是分不出来的 —— 必须在**同一拍**看到
>     //   "请求"（dnpc_flag）、"背压"（ready）和"结果"（IFU_pc）三者。
>     //   仿真里已经这样定位成功（见 IFU.sv 的 B9 说明），这里把同样的可见性搬到板上。
>     //
>     //   debug_dnpc_flag : Control 的 dnpc_flag —— 控制面确认的重定向请求（1 bit）
>     //   debug_ready     : IFU 的 ready 输入（= IDU_ready = ready_next & ~stall），
>     //                     即"下游这一拍能不能接收一条新指令"（1 bit）
>     //   debug_ifu_pc    : 取指级 PC 本体。比 debug_wb_pc 直接得多 ——
>     //                     debug_wb_pc 是写回级，重定向要再流 3~4 拍才看得到
> ```
> ```systemverilog
> // v9 新增（B9）：重定向诊断三根线（请求 / 背压 / 结果）。
> //   IDU_ready 就是 IFU 的 ready 输入（见下面 IFU 例化的 .ready(IDU_ready)），
> //   所以板上 probe14 与 IFU 内部判定用的是**同一个网**，不存在口径不一致。
> ```
**补充说明（逐拍证据，来自 IFU.sv 的 B9 说明）**：异常发生在 `pc=0x34` 的 ecall，重定向请求
已发出、目标 mtvec=0 也正确，但同一拍 `IFU_stall=1 → ready=0`，被 `dnpc_flag & ready` 吃掉；
此后 PC 一路 `0x38→0x3c→0x40→0x44…` 顺序爬行。波形特征：
`ifu_ready=0  ifu_valid=1  ifu_stall=1`。因此 IFU 侧已改为**真实重定向既不看 inst_valid 也不看 ready**。

## MYCPU-4：fault_inst_in 必须接译码级 inst_d，且必须显式声明 32 位（原编号：v9 修复 C4 遗留）
**位置**：IDU wire 声明区 `logic [31:0] IDU_inst_d;` 上方；EXU 例化 `.fault_inst_in` 上方
**删掉的原文**：
> ```systemverilog
>   // v9 修复（C4 遗留）：译码级指令本体（IDU.inst_d 引出），给 EXU 当 fault_inst_in
>   //   （非法指令 → mtval = 出错指令编码）。
>   //   ★ 原来这里接的是一个叫 IDU_inst 的名字，而它**从未声明** → Verilog 隐式推断
>   //     成 1 位网，iverilog -Wall 报 "implicit definition of wire 'IDU_inst'" 与
>   //     "Port 27 (fault_inst_in) of EXU expects 32 bits, got 1"，mtval 因此恒为垃圾值。
> ```
> ```systemverilog
>       // v9 修复（C4 遗留）：**必须接 IDU_inst_d（IDU 译码级 inst_d），不是 IFU_inst。**
>       //   fault_inst_in 要与同一拍的 illegal_in（= IDU 的非法指令标志，由 inst_d 组合
>       //   译出）配对。IFU_inst 比 inst_d 早两级流水寄存（inst_d(T)=IFU_inst(T-2)），
>       //   接错就会把**别的指令**写进 mtval，异常现场反而误导人。
> ```
**补充说明**：两个坑叠在一起：① 名字 `IDU_inst` 从未声明（隐式 1 位网 → 位宽截断）；
② 端口接的是早两级的 `IFU_inst`（内容错位）。前者靠 `iverilog -Wall` 的位宽告警发现，
后者只有在"非法指令 → 查 mtval"的场景下才能看出来。

## MYCPU-5：存储侧 hold 必须先声明（原编号：无编号，ModelSim vlog-2730 事故）
**位置**：内部 wire 声明区 `logic icache_hold;` 上方
**删掉的原文**：
> ```systemverilog
>   // 存储侧 hold：**必须先声明**，下面第 152 行就要用。
>   //   （原写在文件后段，ModelSim vlog-2730 判为"未定义变量"硬报错，
>   //     因为它会先按隐式 1 位 wire 建网、再报"已被重复声明"。）
> ```
> ```systemverilog
>   // 顶层统一收集控制面额外信号：
>   // - dnpc/dnpc_flag: 下一条 PC 及其是否需要重定向
>   // - EXU_inst_clear: 执行级指令清空，用于处理跳转/异常/停顿插泡
>   // - IFU_stall: 访存相关 load-use 冒险导致的取指暂停
> ```
**补充说明**：这条与"Verilog 隐式建网"是同一个机制。原注释里的"下面第 152 行"是当时文件
行号，压缩后不再写死行号（行号会随注释改动漂移，写死了反而误导）。

## MYCPU-6：前递值口径 —— jump / CSR 前递 rd_value 而不是 Ex_result（原编号：v9 修复 B6）
**位置**：`MEM_forward_val` / `EXU_forward_val` 两条 assign 上方
**删掉的原文**：
> ```systemverilog
>   // LSU 阶段对外暴露的第一层前递值：
>   // 普通算术/地址类指令前递 EX 结果，跳转/CSR 指令前递已经准备好的 rd_value。
> ```
> ```systemverilog
>   // v9 修复（B6）：EXU 级前递值。jump/CSR 写进 rd 的是 rd_value（link / CSR 读值），
>   //   不是 Ex_result（对 jump 那是跳转目标地址）——口径与下面 MEM 级保持一致。
> ```
**补充说明**：判据是 **16 位独热码非零**（`|csr_wen`），不是"等于 1" —— 任何一个 CSR 写使能
位为 1 都要走 `rd_value` 分支。B6 的问题是 EXU 级与 MEM 级口径不一致：MEM 级已经用
`rd_value`，EXU 级却还在给 `Ex_result`，于是 `jal`/`jalr` 后面紧跟的指令会前递到**跳转目标
地址**而不是返回地址。

## MYCPU-7：IDU 的 5 个同步异常通道一个都不能漏接（原编号：v9 新增 C4）
**位置**：IDU_Inst0 例化 `trap_take/trap_take_q/trap_cause/fault_addr/fault_inst` 五个端口上方
**删掉的原文**：
> ```systemverilog
>       // v9 新增（C4）：同步异常通道（Control → IDU → Reg_Stack/CSR）。
>       //   **这五个端口漏接会让 CSR 完全收不到异常**：trap_take/trap_cause
>       //   悬空成 x，mcause/mtval 永远写不进去 —— 实测现象是"陷入次数对、
>       //   但 mcause 恒 0、mtval 恒 x"。vsim 只会给一个 vopt-2718 Missing
>       //   connection 的 Warning，很容易被忽略，所以这里显式列出。
> ```
> ```systemverilog
>       // v9 新增（C4）：同步异常通道（EX 级锁存结果 → Control 汇总）
> ```
> ```systemverilog
>       // v9 新增（C4）：异常判定结果 + mtval / mtvec 观察口
>       // v9 修复（C4 遗留）：译码级指令本体，给 EXU 的 fault_inst_in（→ mtval）
>       // v9 新增（C4）：异常确认脉冲（只清异常标志，不参与 EXU_inst_clr）
>       // v9 新增（C4）：异常输入（来自 IDU，与 IDU_* 控制位同拍）
>       // v9 新增（C4）：异常输出（锁存后与 EX 级指令一一对应）
> ```
**补充说明**：机制上，CSR.sv 里
`mepc_wen = csr_wen[CSRW_MEPC] | intr_take | ecall_flag | trap_take | trap_take_q`、
`mcause_wen = csr_wen[CSRW_MCAUSE] | trap_commit` —— 全部依赖这几根线；悬空成 x 之后
`trap_commit` 也是 x，写使能条件塌掉，于是 mcause/mtval 永不更新。"陷入次数对"是因为
`trap_take` 同时还在 IFU 侧触发了重定向（PC 确实跳到了 mtvec），所以表面上"异常好像处理了"。

## MYCPU-8：WBU_inst0 的 .stall 悬空 → 一条写回都出不来（无原编号，本次新增记录）
**位置**：WBU_inst0 例化上方；`.stall(1'b0)` 行尾
**删掉的原文**：
> ```systemverilog
>   // WBU 是最终收束点：无论结果来自 ALU、访存还是跳转/CSR，这里统一形成最终写回值。
> ```
> ```systemverilog
>   // WBU 的 ready 恒为 1（见 WBU.sv 末），它本来就不该被暂停，因此 stall 常数接 0。
> ```
**补充说明（本次迭代新增的战史，原文没有记）**：`WBU_inst0` 的 `.stall` 曾经**悬空**。
WBU.sv 的时序块是 `else if (!stall) begin ... end`，stall 悬空成 x 后 `!stall` 也是 x，
整段赋值全部变成 x —— 结果 `valid_reg` 永不更新、`R_wen_next = R_wen_reg & valid_reg` 恒 x，
**一条写回都出不来**。而 iverilog 对未连接输入不会报错（只可能给 warning），日志干净，
只能在波形里看到 x/z。结论：`.stall(1'b0)` 是常量，不是"可以省略的连接"。

---

## MYCPU-附录：其余被压缩/改写的原文（RTL 未引用本节）

<details>
<summary>文件头（原 20 行 → 现 11 行）</summary>

> ```systemverilog
> // =============================================================================
> // v9 顶层 myCPU：在 v8（RV32I 六级流水线）基础上扩展为 RV32IM，并加入
> // I/D-Cache、动态分支预测、机器模式中断。
> // -----------------------------------------------------------------------------
> // 顶层的职责只有“接线 + 少数全局协同信号”，具体逻辑都在子模块里：
> //   IFU  —— 维护 PC，接受重定向/预测/暂停
> //   ICache —— 取指缓存（IFU ↔ IROM 之间）
> //   IDU  —— 译码：拆出控制信号、寄存器值、立即数、CSR/系统标志
> //   EXU  —— 执行：ALU/MDU，分支判定，跳转目标
> //   LSU  —— 访存：多级流水与多级前递观察点
> //   DCache —— 数据缓存（LSU ↔ 外设总线之间）
> //   WBU  —— 写回收束：统一选择最终提交值
> //   Control / Data_hazard —— 前递、暂停、冲刷与重定向
> //   Branch_Predictor —— 2 位 BHT + BTB，IF 查/EX 更新
> // 观察本文件时可重点抓四条线：
> //   1. 最终收束：所有写回结果最后在 WBU 决定。
> //   2. 访存/前递：LSU 提供 MEM/MEM_PIPE/MEM2 多级前递点。
> //   3. 控制流：分支预测 + 真实重定向（含中断）在 Control 合流。
> //   4. 系统路径：ecall/mret/fence.i/中断 共用 dnpc 收束逻辑。
> // =============================================================================
> ```
</details>

<details>
<summary>mark_debug / keep 属性说明（原 4 行 → 现 3 行）</summary>

> ```systemverilog
>     // v9 + ILA：mark_debug 让这些调试信号在综合后被 ILA 找到。
>     //   KEEP = "true" 防止它们因为"顶层没有负载"被优化掉（这正是上板时的情况：
>     //   board_top_ila 完全不引出 debug_*，若不加 KEEP 综合会把这些寄存器/网络删掉，
>     //   ILA 就没东西可抓）。这四个属性对 iverilog / ModelSim 是透明注释，不影响回归。
> ```
> ```systemverilog
>     // v9 新增（C4）：异常现场观察口。
>     //   异常体系（非法指令 / 非对齐访存 / ecall / 中断）的登记结果引到顶层，
>     //   方便板上观察与仿真断言 —— 原来 mepc/mcause 只能靠层次化引用去看，
>     //   而 mtval 根本是个死寄存器。
>     // v9 + ILA：之前 board_top 例化 myCPU 时这 4 个口是**悬空**的（板上看不到异常），
>     //   现在同样加 mark_debug/KEEP，交给 ILA 抓，不需要占引脚。
> ```
</details>

<details>
<summary>IFU_stall 三来源 / hold 声明顺序（原 8 行 → 现 3 行）</summary>

> ```systemverilog
>   // IFU/IDU 共用的暂停请求，三个来源必须同源：
>   //   - Control.IFU_stall : load-use 冒险（后端数据还没准备好）
>   //   - ICache.hold       : 同步 BRAM 未对齐/未命中，需要停一拍重试
>   //   - DCache.hold       : load 未命中，需要停一拍重试
>   //   其中只有**存储侧**的 hold 参与 IFU.valid（未就绪的取指数据必须灌泡），
>   //   load-use 暂停只冻结 PC（否则会与 IDU 采样点错拍、冲掉该保住的指令）。
>   // 注意：这里**只**并入存储侧 hold，绝不把 EXU_inst_clear 并进来 ——
>   //   缓存停拍期间 EX 级那条指令是要重放的，清掉就丢了（见 Control.sv）。
> ```
</details>

<details>
<summary>ICache / DCache 例化上方（原各 3 行 → 现各 3~4 行重新组织）</summary>

> ```systemverilog
>   // I-Cache 接在 IFU 与 IROM 之间：取指先查缓存，缺失时回填。
>   // 上板改造后 IROM 是同步读（固定 1 拍延迟），因此 ICache 未命中时用
>   // icache_hold 请求把前端停一拍后重试（见 ICache.sv 头部说明）。
> ```
> ```systemverilog
>   // D-Cache 接在 LSU 与外部数据总线之间：load 缺失停一拍重试，store 写直达。
>   // 上板改造后 DRAM 是同步读写（固定 1 拍延迟），store 请求由 DCache 内
>   // 寄存成单拍脉冲，保证一次 store 只写一次（见 DCache.sv 头部说明）。
> ```
</details>

<details>
<summary>各实例上方的一行旧注释（被改写为 2~5 行的级/握手说明）</summary>

> ```systemverilog
>   // Control 是整机协同核心：
>   // 它一边决定 dnpc/flush/stall，一边给 IDU 送回最合适的前递操作数。
> ```
> ```systemverilog
>   // 分支预测器：IF 级查询、EX 级更新。
> ```
> ```systemverilog
>   // IDU 把取回的指令展开为执行所需控制信号，同时接收来自 Control 的前递操作数。
> ```
> ```systemverilog
>   // EXU 产生算术结果、分支判定结果和跳转目标；这些结果会反向影响前端是否重定向。
> ```
> ```systemverilog
>   // LSU 既承担真正的访存，也承担“把可用结果尽早释放给后续级做前递”的任务。
> ```
> ```systemverilog
>       // MDU 忙时同步冻结访存流水
> ```
</details>

<details>
<summary>wire 声明区零散的 v9 修复标注（已并入分组说明与行尾注释）</summary>

> ```systemverilog
>   logic [1:0] LSU_rdata_offset_wb;   // v9 修复（B1）：写回拍 load 地址低 2 位，送给 WBU 选字节通道
> ```
> ```systemverilog
>   logic        bp_hold_exu;       // v9 修复（B7）：误预测判定存在（当拍或挂起）→ 冻结 EXU 接收新指令
> ```
> ```systemverilog
>   /* ---------- v9 新增：分支预测器观测与连线 ---------- */
>   /* ---------- v9 新增：中断连线 ---------- */
>   /* ---------- v9 新增（C4）：异常体系信号 ---------- */
>   /* ---------- v9 新增：I-Cache / D-Cache 观测信号（可在波形中查看命中率） ---------- */
> ```
</details>

---

### para.sv

> 本文件只保存**从 para.sv 注释里删掉/压缩掉**的原文，一个字都没有改写。
> 相关源码：`E:\share doc\v9\para.sv`

---

## PARA-1：`MISC_opcode` / `fence.i` 原来会被静默丢掉（原编号：v9 修复 C4）

**位置**：`` `define MISC_opcode `` 右侧的行注释与其续行（原第 29~31 行）。

**原文**：

> ```systemverilog
> `define MISC_opcode 7'b0001111  // MISC-MEM：fence / fence.i（v9 修复 C4 新增，
>                                 //   原来没有任何地方检查这个 opcode，
>                                 //   于是 fence 类指令会被当成"未知 opcode"静默丢掉）
> ```

**补充说明**：这是 A 类（“没有地方检查这个 opcode ⇒ 指令被静默丢掉”是机制，不是过程），
正本保留机制并给出锚点，删掉的只是叙述的展开。`7'b0001111` 这个真代码 token 未动。

---

## PARA-2：`mtime` 的分频改造（原编号：v9 修复 C7）

**位置**：`` `define MTIME_DIV_DEFAULT `` 之上的整块注释（原第 125~131 行）。

**原文**：

> ```systemverilog
> // v9 修复（C7）：mtime 原来每拍 +1（100MHz 下 1 拍 = 10ns，即 mtime 比真实时间快
> //   约 1000 万倍），只能当"拍数计数器"用，拿来算时间/延时会离谱。
> //   现在改成**递减计数器**（decrementer）：可配置分频，mtime 按
> //   (100MHz / MTIME_DIV) 的速率递增，更接近一个时间基准。
> //   默认 100：100MHz / 100 = 1MHz，即 mtime 每 1us 加 1，肉眼可读、也好算。
> //   置 1 则退回"每拍 +1"的旧行为（回归脚本用得到）。
> ```

**补充说明**：正本保留机制（分频公式 `100MHz / MTIME_DIV`、默认 100 → 1MHz、置 1 退回旧行为）
并补了锚点；删掉的是“原来快约 1000 万倍”这类量化背景与行文展开。
**注意**：原文自称“递减计数器”，但 `MTIME_DIV_DEFAULT=100` 的语义是**分频递增**
（mtime 每 1us 加 1）—— 这是原文措辞上的不一致，逐字保留在此以备查，
**不要**据此去改代码。

---

## PARA-3：`NOP` 的用途（原编号：无）

**位置**：`` `define NOP `` 之上（原第 161 行）。

**原文**：

> ```systemverilog
> // 指令提交时用于调试的 NOP 编码（addi x0,x0,0）
> `define NOP 32'h00000013
> ```

**补充说明**：原文只说了“用于调试”，**漏了**它真正的两个用途：IFU 在 `valid=0`
时灌给 IDU 的泡、以及冲刷时填进流水寄存器的占位指令。正本按 C 类要求**改写**为
`★ 不变量`（`NOP` 必须就是 `addi x0,x0,0`，后级要能把它当合法空操作执行掉，
否则冲刷/停拍路径会产生副作用）。原句“指令提交时用于调试”这一层意思（它也是
提交/调试路径上的占位）保留在同一行的上下文里，宏值 `32'h00000013` 未动。
**这条是“原文不够 + 被改写”而不是“原文被删”**，所以在这里逐字记一笔，
避免被误认为知识丢失。

---

## PARA-4：文件头新增的“跨模块契约”告警（本轮 C 类补充，非删除）

**位置**：文件头块注释（原第 1~14 行，本轮在其后补了 3 行）。

**原文**（原文到 `RV32IM 扩展` 那句为止，逐字）：

> ```systemverilog
> /* =============================================================================
>  * para.sv — BigBird v9 全局参数与编码约定
>  * -----------------------------------------------------------------------------
>  * 这里集中定义整颗 CPU 用到的“公共契约”，其它模块只通过宏名互相协作，
>  * 避免在 IDU / EXU / ALU 各处散落魔法数字。
>  *
>  *   1. opcode   ：7 位主操作码，决定指令属于哪一大类。
>  *   2. alu_op   ：5 位 ALU/MDU 运算编码，IDU 译码后交给 EXU 解释执行。
>  *   3. 汇编器约定：cache / 分支预测 / CSR 的相关参数。
>  *
>  * 注意：v9 在 v8（RV32I）基础上扩展为 RV32IM：
>  *   - 整数基址指令仍走原有 ALU 通路；
>  *   - 乘除法新增 MDU，运算编码在 alu_op 高位置 1 区分（见下）。
>  * =========================================================================== */
> ```

**补充说明**：正本**原样保留**上面 14 行，并在末尾追加了“★ 改这个文件前必读：
带位宽的宏（ICACHE/DCACHE/BP 的 INDEX/TAG/HIST、MTIME_DIV_DEFAULT、NOP）改一个数
就会同时挪动几个模块的位切片与计时行为”这 3 行 —— 这是 C 类补充，不是压缩。

---

## 本文件保留未动的行尾注释（**没有**删改，仅列出以证明无丢失）

下面这些行尾注释原文照留在正本里（`//` 之后的内容属注释，本轮未改其文字）：

> ```systemverilog
> `define R_opcode   7'b0110011   // R-type：整数寄存器-寄存器运算（含 M 扩展）
> `define I0_opcode  7'b0000011   // I-type load：lb/lh/lw/lbu/lhu
> `define I1_opcode  7'b0010011   // I-type 立即数运算：addi...
> `define I2_opcode  7'b1100111   // jalr
> `define S_opcode   7'b0100011   // store：sb/sh/sw
> `define B_opcode   7'b1100011   // 分支：beq/bne/blt/bge/bltu/bgeu
> `define U0_opcode  7'b0110111   // lui
> `define U1_opcode  7'b0010111   // auipc
> `define J_opcode   7'b1101111   // jal
> `define SYS_opcode 7'b1110011   // 系统：ecall/mret/CSR
> `define funct7_base 7'b0000000     // 普通 RV32I 整数运算
> `define funct7_sub  7'b0100000     // sub/sra
> `define funct7_m    7'b0000001     // RV32M 乘除法
> `define alu_mul                 5'b10000   // 有符号/无符号低 32 位相同
> `define alu_mulh                5'b10001   // 有符号 × 有符号，取高 32 位
> `define alu_mulhsu              5'b10010   // 有符号 × 无符号，取高 32 位
> `define alu_mulhu               5'b10011   // 无符号 × 无符号，取高 32 位
> `define alu_div                 5'b10100   // 有符号除法
> `define alu_divu                5'b10101   // 无符号除法
> `define alu_rem                 5'b10110   // 有符号取余
> `define alu_remu                5'b10111   // 无符号取余
> `define CSR_mtime    12'h7c0
> `define MSTATUS_MIE   3           // 全局中断使能
> `define MSTATUS_MPIE  7           // 中断前的 MIE 备份
> `define IRQ_MSI  0                // 机器软件中断
> `define IRQ_MTI  7                // 机器定时器中断
> `define IRQ_MEI  11               // 机器外部中断
> `define MCAUSE_INTR_BIT 31
> `define MCAUSE_IADDR_MISALIGN 0     // instruction address misaligned
> `define MCAUSE_ILLEGAL_INST    2     // illegal instruction
> `define MCAUSE_BREAKPOINT      3     // breakpoint（本核未实现 ebreak，保留编码）
> `define MCAUSE_LOAD_MISALIGN   4     // load address misaligned
> `define MCAUSE_STORE_MISALIGN  6     // store/AMO address misaligned
> `define MCAUSE_ECALL_M         11    // ecall from M-mode
> `define ICACHE_INDEX_BITS 6       // 64 行
> `define DCACHE_INDEX_BITS 6       // 64 行
> `define BP_INDEX_BITS 6           // 64 项计数表 / BTB
> `define BP_HIST_BITS  6           // 全局历史长度（与索引位宽一致，XOR 后仍为 6 位）
> ```

**另外这些整段注释在正本里原样保留**（只补了标题行，正文未动）：
`主操作码`、`R 型 funct7 区分位`、`ALU 编码`（含 CPU/MDU 最高位说明）、
`访存宽度（funct3）`、`中断相关位`、`异常类型编码（ID/EX 内部用）`
（含 bit0~bit3 的 mcause/mtval 对照表与“ecall 不在这里”那句）、
`性能计数开关`、文件头的 `RV32IM 扩展` 说明。

### 被改写措辞的两行（第二轮压缩，逐字留档）

> ```systemverilog
> // I-Cache：直接映射，行大小 = 1 个字（教学用，便于观察命中/缺失）
> ```
> ```systemverilog
> // 分支预测：gshare（PC 低位 XOR 全局历史 GHR）+ BTB，直接映射
> ```

（第一行正本改为“I-Cache：直接映射，行大小 = 1 个字（教学用，便于观察命中/缺失），
因此没有 offset；切片：index = cpu_addr[INDEX_BITS+1:2]（跳过低 2 位字节偏移），
tag 是剩下的高位。” —— 原句一字未丢，只在同一行后补了切片公式；
第二行原文照保留在正本 `BP_INDEX_BITS` 之上。）

---

## 七、板级与工程顶层

### board_top.sv

> RTL 里对应的指针：`§BOARDTOP-1` ~ `§BOARDTOP-3`（原编号 v9 修复 B8 / B9）。
> 行号均指**改动前**的快照 `_comment_iter/before/board/board_top.sv`。
> 汇编后的正式文档：`syn/修复史_全量.md`。

## BOARDTOP-1：层次化引用在 Quartus 下综合失败，改走顶层端口（原编号：v9 修复 B8）
**位置**：原第 158~170 行（读使能 `assign`）、第 138~140 行（缓存计数器例化）、第 205~208 行（观测计数器一节）
**删掉的原文**：
>     // I-Cache 的读使能 / D-Cache 的读使能：直接接同步存储器的读口。
>     // v9 修复（B8）：取指侧读使能改走 myCPU 的**顶层端口** irom_en。
>     //   原来这里写的是 `assign irom_en = u_cpu.icache_mem_en;`，
>     //   而 myCPU 根本没有 icache_mem_en 这个端口 —— 它是 myCPU 的**内部信号**。
>     //   iverilog / ModelSim 容忍层次化引用，Quartus 不行：
>     //     Error (10207): Verilog HDL error at board_top.sv(116):
>     //                    can't resolve reference to object "icache_mem_en"
>     //     Error (12153): Can't elaborate top-level user hierarchy
>     //   → Analysis & Synthesis 失败，fit/时序/上板全部跑不起来。
>     //   现在与数据侧的 perip_ren 口径一致，都不再依赖层次化引用。
>     // v9 修复：数据侧读使能也是 myCPU 的顶层端口（perip_ren），
>     //   不再用层次化引用穿进 myCPU 内部（层次化引用不可移植，综合/换工具时容易踩坑）。
以及例化处：
>         // v9 修复（B8）：四条缓存计数器走顶层端口。
>         //   原来这里是 `assign debug_icache_hit_cnt = u_cpu.icache_hit_cnt;`
>         //   这类层次化引用，Quartus 报 Error (10207) 直接综合失败。
以及文件末尾一节：
>     /* ---------------- 5) 观测计数器引出 ---------------- */
>     // v9 修复（B8）：四条计数器已经在 myCPU 的端口上接好了（见上面的例化），
>     //   这里不再需要层次化引用（原来那 4 行 `u_cpu.icache_hit_cnt` 之类会让
>     //   Quartus 报 Error (10207)，整机综合失败）。

**补充说明**：结论就是现在的口径 —— `perip_en = perip_ren`、`irom_en` 直连顶层端口，
板级顶层里**不允许**出现 `u_cpu.<内部信号>` 这种层次化引用（iverilog/ModelSim 会放过它，
所以仿真阶段发现不了，只有 Quartus 综合才暴露）。

## BOARDTOP-2：上板需要补的三块（数码管 / UART / 按键消抖）—— 原文整段搬入
**位置**：原第 27~43 行（文件头 "上板需要补的" 一节）
**删掉的原文**：
>  * 上板需要补的（本文件只留接口注释，不实现）：
>  *   ── 7 段数码管（P4 可观测性）────────────────────────────────────────────
>  *     建议用一个 1kHz 左右的扫描计数器轮流点亮 8 位数码管，段选译码：
>  *       数码管 0-1：debug_wb_pc[15:0]        （写回 PC 低 16 位）
>  *       数码管 2-3：debug_wb_value[15:0]     （写回数据低 16 位）
>  *       数码管 4-5：{9'b0, icache_hit_cnt, icache_miss_cnt} 之类的计数器
>  *       数码管 6  ：debug_wb_reg（写回目标寄存器号）
>  *       数码管 7  ：{debug_wb_ena, debug_wb_have_inst}（写回使能/有效）
>  *     例如：
>  *       seg_data <= (scan_sel == 3'd0) ? {16'b0, debug_wb_pc[15:0]} : ...
>  *       seg_sel  <= 8'b0000_0001 << scan_sel;
>  *   ── UART（最接近 printf 的观察方式）─────────────────────────────────────
>  *     建议 115200-8-N-1，在 debug_wb_have_inst 的上升沿把
>  *       "PC=xxxx REG=xx VAL=xxxxxxxx\n"
>  *     格式化后丢进一个 FIFO，再用波特率计数器移位输出到 uart_txd。
>  *   ── 复位按键：btn_rst_n 需要额外做一次按键消抖（~10ms 计数），
>  *     本模块只负责“异步置位、同步释放”，消抖属于板级输入调理。

**补充说明**：这三块**至今仍未实现**（RTL 里只保留"这一层不做逻辑"的定位）；
真正上板时按上面这份清单在 `board_top` 之外再包一层，不要把扫描/串口逻辑塞进本文件。

## BOARDTOP-3：v9 新增（B9）重定向诊断三根线（请求 / 背压 / 结果）
**位置**：原第 83~89 行（端口声明）
**删掉的原文**：
>     /* ---- v9 新增（B9）：重定向诊断三根线（请求 / 背压 / 结果） ----
>      * 上板 ILA 抓到"ecall 之后 PC 从不回到 mtvec"。要区分"请求没发"和
>      * "请求被 IFU 的 ready 门控吃掉"，必须在同一拍看到：
>      *   debug_dnpc_flag : dnpc_flag  —— 重定向请求（1 bit）
>      *   debug_ready     : IFU.ready  —— 下游能否接收的结构性背压（1 bit）
>      *   debug_ifu_pc    : IFU 的 PC  —— 直接看重定向有没有落到 PC 上（32 bit）
>      * 同样只给 ILA 抓，不占引脚。 */

**补充说明**：完整定位过程见 `syn/ecall重定向故障_根因与修复.md` 与
`syn/修复史_全量.md` §IFU-1；真凶是 IFU 里用 `dnpc_flag & ready` 门控重定向，
而系统重定向的 `dnpc_flag` 只有一拍宽（撞上 `ready=0` 就永久丢失）。

## BOARDTOP-附录：原文件头的其余部分（三件事 / 存储映射 / 读写时序契约 / keep 与观察口）
**位置**：原第 4~44 行、第 56~58 行、第 71~77 行
**删掉的原文**：
> /* =============================================================================
>  * board_top.sv — v9 的板级顶层（CPU + 同步存储器 + 复位同步器）
>  * -----------------------------------------------------------------------------
>  * 这一层只做三件事，逻辑一律不写在这里：
>  *   1. 复位：板卡按键 → reset_sync（异步置位、同步释放）→ myCPU.cpu_rst；
>  *   2. 存储：IROM / DRAM 全部换成 board/sync_mem.sv 的**同步 BRAM**
>  *      （固定 1 拍读延迟 + 读使能，正好对上 ICache/DCache 的同步化改造）；
>  *   3. 可观测性：把 debug_wb_* 引出来，供数码管 / LED / UART 使用。
>  *
>  * 存储映射（与 sim/tb_iverilog.sv 一致）：
>  *   IROM：0x0000_0000 ~ 0x0000_3FFF（4096 字 = 16KB），只读，
>  *         initial + $readmemh 固化程序（Vivado 可综合到 BRAM 初值）；
>  *   DRAM：0x0000_0000 ~ 0x0000_FFFF（16384 字 = 64KB），读写，按 mask 字节写。
>  *   注意：这个教学 SoC 用 **perip_addr[15:2]** 索引 DRAM、用
>  *         **irom_addr[13:2]** 索引 IROM，两套地址空间各自独立译码
>  *         （和 cdp-tests/mySoC 的做法一致），不做统一 memory map。
>  *
>  * 读写时序契约（与 DCache 对齐，改这里之前先读 DCache.sv 头部）：
>  *   - 读：DCache 给 mem_en=1 的**那一拍**给出 mem_addr，sync_mem 在
>  *         下一个时钟沿输出 rdata，正好被 DCache 的 cpu_valid_r 那一拍采走；
>  *   - 写：DCache 的 mem_wen 是**单拍脉冲**，sync_mem 在同一沿按 mem_mask
>  *         合并写入。所以这里直接透传，不需要额外握手。
以及：
>     // v9 + ILA：加 keep，保证这些端口在"顶层悬空"时也不被综合优化掉，
>     //   这样 ILA（mark_debug 标记在 myCPU 侧）一定能抓到它们。
以及：
>     // 这 4 个口在 myCPU 上一直存在（v9 修复 C4 加的），但 board_top 原来**没有引出**，
>     //   于是 myCPU 例化时它们是悬空的 —— 板上/ILA 都看不到异常现场。
>     //   现在一并引出，交给 ILA 抓（不占引脚）。
>     // 注意：debug_mtval 目前抓到的值不可信 —— CSR 的 mtval 在 RTL 层面就没被写
>     //   （综合报 mtval_reg_reg was removed / mtval_out does not have driver），
>     //   属于 RTL 待修项，不是引出方式的问题。

**补充说明**：最后那条"debug_mtval 不可信"**已经过时** —— `CSR.sv` 已补上
`assign mtval_out = mtval_reg;`（原编号 C4 遗留），现在 probe11 抓到的是真实值。
历史原文见 `syn/修复史_全量.md` §CSR-4。

## BOARDTOP-附录B：另外两行被改写的注释（DRAM 的复位常数 / 异常观察口引出）
**位置**：原第 146 行（`myCPU` 例化处）、原第 189 行（`dram_inst` 例化处）
**删掉的原文**：
>         // v9 + ILA：异常现场观察口（原来这 4 个口是悬空的，现在引到顶层给 ILA 抓）
以及：
>     // reset 接 1'b0：真实 BRAM 的存储阵列不会因复位被清空（见 sync_mem 头部）。

**补充说明（第 2 条是实质机制，别当成"漏接复位"）**：
`dram_inst` 的 `.reset` **故意**接常数 `1'b0` —— 真实 BRAM 的**存储阵列不因复位被清空**，
`sync_mem` 的 `reset` 只用于清 `rdata` 寄存器（见 `syn/修复史_全量.md` §SYNCMEM-1 与
`sync_mem.sv` 头部的 `★ 接口契约`）。DRAM 的内容由上电后的程序自己初始化；
IROM 则由 `initial` + `$readmemh` 固化，**这两条路径都不要接 `cpu_rst`**，
接了反而会把固化好的程序/正常数据清掉（且与真实 BRAM 行为不符）。

**补充说明（第 1 条）**：这 4 个异常现场口在 `myCPU` 上一直存在（v9 修复 C4 加的），
但 `board_top` 原来**没有引出**，于是例化时悬空、板上/ILA 都看不到异常现场；
现在一并引到顶层交给 ILA 抓（不占引脚）。

---

### board_top_ila.sv

> RTL 里对应的指针：`§BOARDILA-1` ~ `§BOARDILA-5`。
> 行号均指**改动前**的快照 `_comment_iter/before/board/board_top_ila.sv`。
> 汇编后的正式文档：`syn/修复史_全量.md`。

## BOARDILA-1：方案沿革 —— 为什么最后是"上层例化 ILA IP"这一个版本
**位置**：原第 4~19 行（原文件头"设计意图"一节）
**删掉的原文**：
> /* =============================================================================
>  * board_top_ila.sv — v9 在 EES-331 板上的顶层（ILA 版，不引出任何调试引脚）
>  * -----------------------------------------------------------------------------
>  * 设计意图（与 board_top_vivado.sv 的取舍正好相反）：
>  *   上一版为了"少占引脚"，把 4 个 32 位性能计数器截成 8 位引到引脚上。
>  *   本版**一个调试信号都不引到引脚**：全部交给片内 ILA（Integrated Logic Analyzer）
>  *   通过 JTAG 抓取。这样带来三个好处：
>  *     1) 顶层只剩 3 个引脚，彻底摆脱 EES-331 上 DDR3/QSPI/以太网/USB 把 PL 引脚
>  *        吃掉一大半的问题；
>  *     2) 计数器可以保持**全 32 位**，不再有"8 位 256 次回绕"的精度损失；
>  *     3) myCPU 里原来**悬空没人接**的 debug_mcause/debug_mepc/debug_mtval/
>  *        debug_trap_take 四个异常现场口，现在终于能被观察到了。
>  *   ILA 的抓取信号由 myCPU 调试端口上的 (* mark_debug = "true" *) 标记决定，
>  *   在实现阶段由 build_ila.tcl 自动插入 —— 本文件里看不到 ILA 例化，这是
>  *   Vivado 的标准调试流程（mark_debug → create_debug_core → implement_debug_core）。

**补充说明（三个版本的关系，按时间顺序）**：
1. `board_top_vivado.sv` —— 早期"省引脚"方案：把 4 个 32 位性能计数器**截成 8 位**引到引脚上；
2. `board_top_ila.sv`（本文件）—— 改用 `(* mark_debug *)` + `create_debug_core`
   在**内存里**插 ILA（`build_ila.tcl`，现已被移到 `_deprecated/`）。链路本身是通的
   （bit 已生成、时序也过了），但它**绕开了工程的 run**：磁盘上没有 `.runs/.srcs`，
   GUI 里 Design Runs 全灰、双击网表 / Open Implemented Design 都点不动
   —— 也就是"打开工程还是灰的 / 黑的"的根因；
3. `board_top_gui.sv` —— 改成把 ILA 当**普通 IP 例化在 RTL 里**，由 `synth_1` /
   `impl_1` 两个真实 run 完成全流程（见 §GUI-1）。本文件因此退回成**纯"被观测设计"
   顶层**：不含 ILA，只把时钟与调试量引到端口上给上层用。

**保留结论**：本文件**不引任何调试引脚**（顶层只剩 `sys_clk` / `btn_rst_n` / `debug_dead`
三个引脚），计数器保持全 32 位。

## BOARDILA-2：引脚口径 —— 'S5' 是原理图位号，不是引脚名
**位置**：原第 28~37 行（原文件头"引脚"一节）
**删掉的原文**：
>  * ★ 引脚（均来自 EES-331 用户手册的"管脚约束表"，**不要用原理图位号**）：
>  *   sys_clk    ← M19   §5 PL 时钟 FPGA_CLK0，100MHz
>  *   btn_rst_n  ← L18   §21 PL 按键 S1，标号 FPGA_RESET，4.7K 上拉、按下为低
>  *   debug_dead → 不用接
>  *   注意：手册里按键画的是 S1，而 SW0~SW7 那 8 个**拨码开关**是 AB6/Y4/AA4/R6/
>  *   T6/T4/U4/V5，两者不是一回事，别混。
>  *   另：曾经误写成 PACKAGE_PIN S5 —— 'S5' 是**原理图位号**，Vivado 直接报
>  *     CRITICAL WARNING: [Common 17-69] Command failed: 'S5' is not a valid site
>  *     or package pin name.
>  *   这类错误只有当约束真的被读进设计时才暴露，务必以手册的"FPGA IO 约束"列为准。

**补充说明**：`S1` 是**按键**（标号 FPGA_RESET，约束到 `L18`）；`SW0~SW7` 是**拨码开关**
（`AB6/Y4/AA4/R6/T6/T4/U4/V5`）；`S5` 两者都不是，它是原理图位号。
这类错误只能在**约束真的被读进设计**时暴露（例如 `synth_1` 跑起来、或
`report_property` 查引脚），光看原理图/手册文字对不出来。

## BOARDILA-3：`debug_dead` 为什么必须存在 —— 只加 keep 时 13 组只剩 3 组
**位置**：原第 124~145 行（`debug_dead` 端口注释）、第 128~136 行（同一段的告警原文）
**删掉的原文**：
>     // ---------------------------------------------------------------------
>     // 唯一的一根"假"输出，不接任何东西（或接一个 LED 也行）。
>     //
>     // 为什么非要它 —— 这是本工程实测踩出来的一个关键坑：
>     //   本设计对外**一个信息都不需要输出**（观察全靠 ILA）。但 Vivado 综合
>     //   对"顶层没有负载"的调试信号会**直接优化掉**：实测第一版只加了
>     //   (* mark_debug *)/(* keep *) 属性，综合后 13 组调试网络**只剩 3 组**
>     //   （debug_wb_have_inst / debug_wb_ena / debug_trap_take，恰好是 1 位宽、
>     //   且驱动侧没被连带删掉的那几个），其余 10 组 32 位的全部消失 →
>     //   ILA 直接无信号可抓。日志里只有一句很不起眼的
>     //     WARNING: [Synth 8-4446] all outputs are unconnected for this instance
>     //     and logic may be removed
>     //   所以必须给这些调试量一个**真实存在的负载**。
>     //
>     // 做法：把全部调试量或（OR）到一起送到这根引脚。这样：
>     //   1) 每一位调试信号都在 output 的锥里，综合不敢删；
>     //   2) 引脚占用仍然只有 1 根；
>     //   3) 它自己也是一个有用的"心跳灯"：只要 CPU 在跑（PC/写回数据非 0），
>     //      它就为高；CPU 被复位或彻底不动时为低。接一个 LED 就能一眼看出
>     //      "板子到底跑没跑起来"，这是 ILA 之外最有用的一个信息。
>     // 时序代价：约 16 级 LUT2 的或链，50MHz（20ns）下毫无压力。
>     // ---------------------------------------------------------------------
以及 13 个观察口那一段里的同一结论：
>     //   ★ 顺带说明为什么现在不怕综合把它们优化掉：
>     //     本模块的 debug_dead 仍然把这些量或到一起（见文件末尾），
>     //     而 ILA 的 probe 端口是它们的**真实负载**，所以综合一定保留。
>     //     （早先那版只靠 keep 属性、顶层又没负载，13 组只剩 3 组。）

**补充说明**：出现在"只剩 3 组"里的恰好是 `debug_wb_have_inst` / `debug_wb_ena` /
`debug_trap_take` 三个 **1 位宽**信号 —— 它们的驱动逻辑顺带还有别的用途/负载，
所以没被连带删掉；10 组 32 位宽的全部消失。这就是为什么 `debug_dead` 这个"假输出"
不能删，也**不能改成只 OR 一部分**。

## BOARDILA-4：`CLKFBIN` 必须接回 `CLKFBOUT`（MMCM 反馈环）
**位置**：原第 192~198 行（MMCM 例化里的 `CLKFBIN` 注释）
**删掉的原文**：
>         // v9 修复（实测踩到的坑）：CLKFBIN 必须接上 CLKFBOUT 的反馈！
>         //   漏接的后果：综合只给一条很容易被忽略的告警
>         //     WARNING: [Synth 8-7071] port 'CLKFBIN' of module 'MMCME2_BASE' is unconnected
>         //   然后 MMCM 的**内部反馈环断开**，时钟根本不会锁定，LOCKED 恒 0 →
>         //   下面 rst_n = btn_rst_n & mmcm_locked 恒为低 →
>         //   CPU 永远停在复位态，上板现象是"什么动静都没有"。
>         //   这是 MMCM 最经典的接线错误，务必保留这一行。

**补充说明**：因为 `rst_n = btn_rst_n & mmcm_locked`，这个接线错误的表现不是"时钟不对"
而是"**整机毫无动静**"（CPU 一直停在复位态）—— 很容易被误判成"程序没烧进去"或
"按键没按"。这类错误在仿真里完全看不到（`MMCME2_BASE` 是 Xilinx 原语）。

## BOARDILA-5：`probe11 / debug_mtval` 恒 0 的原记录（现已修复）
**位置**：原第 84~85 行（13 个观察口一节末尾）、第 249~253 行（第 4 节 `debug_dead` 之前）
**删掉的原文**：
>     //   ★ probe11 / debug_mtval 目前抓不到有效值：v9 的 CSR.mtval 在 RTL
>     //     层面从未被写。这是 RTL 待修项，见 ../syn/上板改造说明.md。
以及：
>     // 额外说明：debug_mtval 目前抓不到有效值 —— 综合报
>     //   WARNING: [Synth 8-6014] Unused sequential element mtval_reg_reg was removed
>     //   WARNING: [Synth 8-3848] Net mtval_out in module/entity CSR does not have driver
>     //   即 v9 的 CSR.mtval 在 RTL 层面就没有被写（mtval 是个死寄存器，见
>     //   ../syn/上板改造说明.md 的 C 系列修复记录）。这是 RTL 待修项，不是 ILA 的问题。

**补充说明**：**该项已修**：`CSR.sv` 补上了 `assign mtval_out = mtval_reg;`
（原编号 v9 修复 C4 遗留），`debug_mtval` / probe11 现在抓到的是真实值。
当时的两个综合告警原文与根因分析见 `syn/修复史_全量.md` §CSR-4。

## BOARDILA-附录：其余被压缩的原文（时钟推导 / 50MHz 引出 / B9 三根线 / 复位极性 / 沿用的是 board_top）
**位置**：原第 20~26 行、第 57~67 行、第 103~119 行、第 39~42 行、第 210~217 行
**删掉的原文**：
>  * ★ 时钟（EES-331 用户手册 §5 系统时钟）：
>  *     板载给 PL 的时钟 FPGA_CLK0 = **100MHz**（引脚 M19，有源晶振）。
>  *   而本设计实测 Fmax 只有 ~67.95MHz（见 syn/vivado_50mhz_实测.md §3），
>  *   **直接拿 100MHz 当时钟跑不了**。所以这里用 MMCME2_BASE 把 100MHz
>  *   分频成 50MHz：VCO = 100MHz × 10 = 1000MHz，CLKOUT0 = 1000 / 20 = 50MHz。
>  *   50MHz 是本次验证的目标频率；等内容收敛后再逐步提高（改 CLKFBOUT_MULT_F /
>  *   CLKOUT0_DIVIDE_F 即可，不用换晶振）。
以及：
>     // ---------------------------------------------------------------------
>     // 系统时钟引出（50MHz，MMCM 分频后经 BUFG）。
>     //
>     // 为什么加这个口（工程模式版加的，逻辑一点没改）：
>     //   ILA 的采样时钟必须**和被观测信号同源同频**。CPU 跑在 MMCM 出来的
>     //   50MHz 上，如果拿板载 100MHz 去采样，抓到的数据是异步跨时钟的，
>     //   触发和波形都不可信。而这个时钟原来是模块内部的局部信号，外面取不到，
>     //   所以专门开一个输出口给上层顶例化 ILA 用（见 project_src/board_top_gui.sv）。
>     //   纯组合输出，不引入任何额外逻辑，也不影响非工程模式那条链路
>     //   （build_ila.tcl 里 ILA 时钟取自综合网表里的 net sys_clk_50m，同名同源）。
>     // ---------------------------------------------------------------------
以及：
>     // ---------------------------------------------------------------------
>     // 13 个调试观察口（工程模式版新增，只是把原来的内部线网引出来，逻辑零改动）。
>     //
>     // 为什么要引出来：
>     //   这些量原来只在模块内部汇总成 debug_dead，外面取不到。工程模式的 ILA
>     //   是**标准 IP 例化**在上层顶（project_src/board_top_gui.sv）里的，
>     //   必须能从端口拿到这些信号，所以在这里开出来。
>     //   宽度 / 顺序与 board_top.sv 完全一致，名字也一致，方便对照。
>     // ---------------------------------------------------------------------
以及：
>     // ---------------------------------------------------------------------
>     // v9 新增（B9）：重定向诊断三根线（工程模式版加到 16 个探针）。
>     //
>     // 来由：上板 ILA 抓到"ecall 之后 PC 从不回到 mtvec(=0)，一路顺序爬行"。
>     //   只看 debug_wb_pc 无法区分两种可能：
>     //     ① Control 的 dnpc_flag 根本没发出重定向请求；
>     //     ② 请求发了，但被 IFU 里的 `dnpc_flag & ready` 门控吃掉（ready=0 那一拍）。
>     //   仿真里正是靠同时观察这三根线定位的（真凶是②，已修，见 IFU.sv 的 B9 注释）；
>     //   这里把它们引到顶层交给 ILA，让同样的判定在**真实硬件**上也能做。
>     //
>     //   debug_dnpc_flag : dnpc_flag —— 控制面已确认的重定向请求（1 bit）
>     //   debug_ready     : IFU 的 ready 输入（IDU_ready）—— 下游结构性背压（1 bit）
>     //   debug_ifu_pc    : 取指级 PC（32 bit）—— 比写回级的 debug_wb_pc 直接，
>     //                     重定向当拍/次拍就能看到效果，不用等它流到 WB
>     //
>     // 同样都并进下面的 debug_dead 或链，保证有真实负载、不会被综合优化掉。
>     // ---------------------------------------------------------------------
以及复位极性与例化处：
>  * ★ 复位极性（重要）：
>  *   EES-331 的 PL 按键是**上拉 + 按下接地**，即按下为低，与 reset_sync 要的
>  *   rst_n_async（低有效）**直接对得上**，不需要反相。
>  *   （对比 ZedBoard 的 BTNC 是高有效，那个才需要反相。这块板不需要。）
>     /* ---------------- 2) 复位：按键 + MMCM 未锁定都算复位 ---------------- */
>     // 为什么要把 mmcm_locked 并进来：MMCM 锁定前输出时钟是不稳的，
>     //   这段时间 CPU 必须保持在复位态，否则会跑飞。
>     /* ---------------- 3) CPU + 同步存储器（沿用 board_top，逻辑未改） -------- */
>     // board_top 的 13 个 debug_* 输出直接连到本模块的同名输出口（再往上层
>     //   给 ILA 当 probe），同时汇总到 debug_dead 做心跳，两处都有负载。

**补充说明**：原注释提到的 `build_ila.tcl`（`mark_debug` 那条链路）现在位于
`_deprecated/`；当前构建走的是 `build_project_ila.tcl` + `board_top_gui.sv`（标准 IP 例化）。

---

### sync_mem.sv

> RTL 里对应的指针：`§SYNCMEM-1`。
> 行号均指**改动前**的快照 `_comment_iter/before/board/sync_mem.sv`。
> 汇编后的正式文档：`syn/修复史_全量.md`。

## SYNCMEM-1：Quartus 的 `initial/for` 循环次数硬上限（5000）—— 整个板级综合失败的根因
**位置**：原第 56~69 行（`INIT_WORDS` 的说明）、原第 94~96 行（IROM 分支里的同一说明）
**删掉的原文**：
>     // 初始化循环上限。为什么要有这个上限：
>     //   Quartus 的 Verilog 解析器对 `initial`/`for` 的循环次数有硬上限
>     //   （默认 5000，且**不是** QSF 设置项），DRAM 默认 16384 字直接踩线：
>     //     Error (10106): Verilog HDL Loop error at sync_mem.sv(94):
>     //                    loop must terminate within 5000 iterations
>     //     Error (12152): Can't elaborate user hierarchy "sync_mem:dram_inst"
>     //   → 整个 board_top 无法综合，自然也就 fit / 时序 / 上板全都跑不起来。
>     //   真实的 BRAM 上电内容是 undefined，并不依赖这段清零；它只是为了给 4 态
>     //   仿真一个确定的初值。所以这里把**被清零的字数**限制成「不超过 4096」：
>     //     - 仿真（iverilog/ModelSim）：IROM(4096) 与测试台里的 DRAM 都由
>     //       测试台自己 `$readmemh`/清零，初值语义不变，回归结果不变；
>     //     - 综合（Quartus）：循环次数 ≤ 4096 < 5000，能过。
>     //   注意不要用 `i < WORDS && i < 4096` 之外的写法（例如 break/return），
>     //   Quartus 对非常规循环控制的支持更差。
以及 IROM 分支里的重复说明：
>             // 只清零 INIT_WORDS 个字（≤4096），其余交给 INIT_FILE；
>             //   全量清零在 Quartus 下会撞 5000 次循环上限（见上面 INIT_WORDS 说明）。

**补充说明**：
- 两个报错编号是 **Quartus 的**（`Error (10106)` / `Error (12152)`）；Vivado 没有这个限制，
  但循环次数同样会被综合成全量复位逻辑，所以 `INIT_WORDS` 这个钳位对两条工具链都有好处。
- 「不要用 `i < WORDS && i < 4096` 之外的写法」这条**是实测结论**：`break` / `return`
  之类的非常规循环控制在 Quartus 里支持更差，会把 `initial` 块判成不可综合。
- 本模块的**读写时序契约**没有变，只是压缩了措辞（请求一拍给地址 / 下一拍出数据、
  `wen` 单拍脉冲、按 mask 字节写、`reset` 不清存储阵列）——见文件头的 `★ 接口契约`，
  以及 `DCache.sv` 头部的对齐说明。

## SYNCMEM-附录：原文件头与被改写的行内注释
**位置**：原第 4~34 行、第 78~82 行
**删掉的原文**：
> /* =============================================================================
>  * sync_mem.sv — 可综合的同步 BRAM 模型（IROM / DRAM 共用）
>  * -----------------------------------------------------------------------------
>  * 为什么需要它：
>  *   原来 v9 的存储器假设是「零延迟组合读」：
>  *     - IROM  : assign irom_data = irom[addr[13:2]];
>  *     - DRAM  : assign dram_raw  = dram[word_addr];   （组合读 + 上升沿写）
>  *   仿真能过，但 FPGA 的 Block RAM 是**同步读**（地址打一拍、数据下一拍才出），
>  *   真实存储器不可能同拍返回数据。本模块给出与 BRAM 时序一致的模型。
>  *
>  * 读时序（固定 1 拍延迟，带读使能）：
>  *   T   : 给出 addr，且 ren=1
>  *   T+1 : rdata 有效（= mem[addr(T)]）
>  *   注意 rdata 挂在寄存器上，ren=0 时保持上一次的值，属于「读使能无效」语义；
>  *   上层必须自己在有效的那一拍采样（ICache/DCache 的 cpu_valid_r 就是干这个的）。
>  *
>  * 写时序（同步写，按 mask 做字节写）：
>  *   T   : 给出 addr/wdata/mask，且 wen=1
>  *   T+1 : mem[addr] 的 mask 选中的字节被更新
>  *   同拍读写同一地址时，读口返回**旧值**（BRAM 常见语义，写优先不影响读回填）。
>  *
>  * 复位策略（重要）：
>  *   reset 只清 rdata 寄存器，**不清存储器内容**。真实 BRAM 的存储阵列不会因为
>  *   复位被清空；IROM 由 initial/$readmemh 固化（Vivado 可综合 initial 到 BRAM
>  *   初值），DRAM 上电后由程序自己初始化。
>  *
>  * 综合属性：
>  *   - IROM 用 (* rom_style = "block" *) 提示映射成 BRAM；
>  *   - DRAM 用 (* ram_style = "block" *) 提示映射成 BRAM。
>  *   这些属性对 iverilog 是透明注释，不影响仿真。
>  * =========================================================================== */
以及被改写的行内说明：
>     // 按字节掩码合并写数据：mask=00/01/10 分别写 1/2/4 字节。
>             // ---- IROM：只读同步 BRAM ----
>             // ---- DRAM：读写同步 BRAM，按 mask 做字节写 ----

**补充说明**：原注释里「mask=00/01/10 分别写 1/2/4 字节」的写法**不精确**：
`case (mask)` 里 `2'b00` = 1 字节、`2'b01` = 2 字节、`default`（即 `2'b10` **和** `2'b11`）
都是 4 字节。新注释按代码口径写成「2'b1x（default）整字 4 字节」。

---

### reset_sync.sv

> 本文件**没有**在 RTL 里留 `§` 指针（它的内容短、且没有跨模块的故障战史），
> 这里仍然按规范归档被压缩掉的原文，锚点编号 `RESETSYNC-1`，汇编后进
> `syn/修复史_全量.md`。

## RESETSYNC-1：原文件头（为什么需要它 / 做法 / 复位极性 / 上板连线建议）
**位置**：原第 3~29 行（整个文件头）
**删掉的原文**：
> /* =============================================================================
>  * reset_sync.sv — 「异步置位、同步释放」的复位同步器
>  * -----------------------------------------------------------------------------
>  * 为什么需要它：
>  *   板卡按键复位是**异步**的（按下时刻与时钟无关）。如果把它直接当同步复位
>  *   喂给 CPU 里成百上千个 `always_ff @(posedge clock) if (reset)`，
>  *   复位的**置位时刻**就与时钟无关，不同寄存器可能在不同拍被清掉，
>  *   而且触发器的复位恢复时间（recovery/removal）会被违反，属于典型的
>  *   亚稳态风险。
>  *
>  * 做法（标准两级同步器）：
>  *   - 置位（assert）走**异步**通路：rst_n_async 一低，输出立刻为低，
>  *     保证按键一按下就进复位，不需要等时钟；
>  *   - 释放（deassert）走**同步**通路：按键松开后，先经两级触发器同步到
>  *     clk 域，再一起释放。这样所有寄存器的复位释放都发生在同一个时钟沿，
>  *     不会出现“部分先释放、部分后释放”。
>  *
>  * 复位极性：
>  *   输入 rst_n_async 是**低有效**（板卡按键一般接成按下拉低），
>  *   输出 rst_sync 是**高有效**，正好对上 v9 全工程
>  *   `always_ff @(posedge clock) if (reset) ...` 的同步高有效复位约定。
>  *
>  * 上板连线建议：
>  *   .clk        (sys_clk)        // 与 CPU 同一时钟
>  *   .rst_n_async(btn_rst_n)      // 按键，低有效
>  *   .rst_sync   (cpu_rst)        // 送 myCPU.cpu_rst
>  * =========================================================================== */
以及两个同步寄存器上方的行注释：
>     // 两级同步寄存器：异步置位、同步释放

**补充说明**：三条不变量（异步置位 / 同步释放 / 输出高有效 `rst_sync = ~sync_ff2`）
在新注释里都保留为 `★ 不变量`，一个字都没有弱化；本文件只是把上面这段
"为什么需要它"的机理解释压缩成了 3 行。

---

### board_top_gui.sv

> RTL 里对应的指针：`§GUI-1`。
> 行号均指**改动前**的快照 `_comment_iter/before/work/board_top_gui.sv`。
> 汇编后的正式文档：`syn/修复史_全量.md`。

## GUI-1：为什么又有第三个顶层 —— `mark_debug` 内存插桩让 GUI 里 Design Runs 全灰
**位置**：原第 4~33 行（原文件头"为什么又有一个顶层 / 层次 / 时钟"三段）
**删掉的原文**：
> /* =============================================================================
>  * board_top_gui.sv — v9 在 EES-331 上的**工程模式**顶层（ILA 标准 IP 例化版）
>  * -----------------------------------------------------------------------------
>  * 【为什么又有一个顶层】
>  *   前一版 board_top_ila.sv 把 ILA 交给 (* mark_debug *) + create_debug_core
>  *   在**内存里**插入。这条链路本身是通的（bit 已经出来、时序也过了），但它
>  *   绕开了工程的 run：磁盘上没有 .runs/.srcs，GUI 里 Design Runs 全灰、
>  *   双击网表 / Open Implemented Design 都点不动 —— 正是你说的「打开工程
>  *   还是灰的 / 黑的」的根因。
>  *
>  *   本文件改用 Vivado 最标准的做法：**把 ILA 当成一个普通 IP 例化在 RTL 里**。
>  *   好处：
>  *     1) 综合 / 实现 / bitstream 全部由 synth_1、impl_1 两个真实 run 完成，
>  *        GUI 里全流程可见、可右键 Re-run；
>  *     2) ILA 出现在 Sources 窗口的 IP 源里，双击就能改深度 / 位宽重新生成；
>  *     3) 上板时 Hardware Manager 能自动匹配同目录的 .ltx 探针文件；
>  *     4) 不再需要"骗综合别删我"的绕法 —— ILA 的 probe 端口就是这些信号的
>  *        **真实负载**，综合自然不会删。
>  *
>  * 【层次】
>  *   board_top_gui (本文件)
>  *     ├─ u_ila_0         : xilinx.com:ip:ila:6.2，13 个 probe，深度 2048
>  *     └─ u_board_top_ila : board_top_ila.sv（MMCM 100→50MHz + CPU + 存储器）
>  *
>  * 【时钟】
>  *   采样时钟用 MMCM 出来的 **50MHz**（`u_board_top_ila.sys_clk_50m`），
>  *   和 CPU 同源同频。ILA IP 自己配置里的 C_CLK_FREQ 只是算时间戳的默认值，
>  *   真正决定采样率的是接进来的 .clk。
>  *   若以后想按 100MHz 采样，把 .clk 换成 sys_clk 即可，但采样时钟必须和
>  *   被观测信号同源，否则抓到的数据没有意义。

**补充说明**：
- 原注释里写的"**13 个 probe**"是**过时数字**：B9 又加了三根诊断线，现在是
  **16 个 probe**（`ILA_NPROBES = 16`，见下面 §GUI-1 的映射表）。新注释已改正。
- 「打开工程还是灰的/黑的」这条排查过程的完整记录见
  `syn/工程打开是黑的_排查与正确用法.md`。
- 磁盘上有没有 `.runs/.srcs` 是判别关键：`mark_debug` + `create_debug_core`
  全程在内存里做，所以 bit 能出来、但工程本身是空的 → GUI 全灰。

## GUI-1b：原文件头里的 probe 分配表与引脚表（已并入新注释的映射表）
**位置**：原第 35~67 行
**删掉的原文**：
>  * 【probe 分配表】（与 syn/ila_使用说明.md §3 一致，顺序不可乱改）
>  *   probe0  debug_wb_have_inst      1   bit  写回是否有有效指令
>  *   probe1  debug_wb_pc            32   bit  写回级 PC
>  *   probe2  debug_wb_ena            1   bit  写回使能
>  *   probe3  debug_wb_reg            5   bit  写回目的寄存器号
>  *   probe4  debug_wb_value         32   bit  写回数据
>  *   probe5  debug_icache_hit_cnt   32   bit  I-Cache 命中计数
>  *   probe6  debug_icache_miss_cnt  32   bit  I-Cache 缺失计数
>  *   probe7  debug_dcache_hit_cnt   32   bit  D-Cache 命中计数
>  *   probe8  debug_dcache_miss_cnt  32   bit  D-Cache 缺失计数
>  *   probe9  debug_mcause           32   bit  异常原因
>  *   probe10 debug_mepc             32   bit  异常返回 PC
>  *   probe11 debug_mtval            32   bit  异常附加信息
>  *           ▲ v9 修复（C4 遗留）：CSR.mtval_out 以前**没有 assign**（是个无驱动的输出网），
>  *             综合会报 "Net mtval_out ... does not have driver" 并把这个寄存器优化掉，
>  *             所以这一路以前恒 0。已在 CSR.sv 补上 `assign mtval_out = mtval_reg;`。
>  *   probe12 debug_trap_take         1   bit  是否正在进入异常
>  *   probe13 debug_dnpc_flag         1   bit  重定向请求（Control 的 dnpc_flag）
>  *   probe14 debug_ready             1   bit  IFU 的 ready（下游结构性背压）
>  *   probe15 debug_ifu_pc           32   bit  取指级 PC
>  *           ▲ v9 新增（B9）：这三根是**上板定位 ecall 重定向失败**留下的诊断探针。
>  *             真凶是 IFU 里用 `dnpc_flag & ready` 门控重定向，而 dnpc_flag 里的
>  *             系统重定向（ecall/mret/fence.i）只有**一拍宽**，撞上 ready=0 就永久丢失
>  *             （见 IFU.sv 的 B9 说明）。已修成 `else if (dnpc_flag)`。
>  *             留这三个探针是为了：以后任何"重定向没生效"都能一眼分清是
>  *             "请求没发"（probe13 恒 0）还是"被背压吃掉"（probe13=1 且 probe14=0）。
>  *             触发建议：probe13 == 1（抓所有重定向），或 probe15 == 0（抓 PC 回 mtvec）。
>  *
>  * 【引脚】（EES-331 用户手册管脚约束表，别用原理图位号）
>  *   sys_clk    ← M19  PL 时钟 FPGA_CLK0，100MHz（有源晶振）
>  *   btn_rst_n  ← L18  PL 按键 S1（标号 FPGA_RESET），4.7K 上拉、按下为低
>  *   debug_dead → 不接，或接一个 LED 当"CPU 在跑"的心跳灯（XDC 里接的是 V4=LED0）

**补充说明（位宽/顺序的唯一权威）**：上表的位宽序列与构建脚本
`build_project_ila.tcl` 里的

```tcl
set ILA_DEPTH  2048
set ILA_PROBES {1 32 1 5 32 32 32 32 32 32 32 32 1 1 1 32}
set ILA_NPROBES 16
```

**逐位一致**；`ILA_DEPTH 2048` 对应原注释里的"深度 2048"。
另有 `syn/ila_使用说明.md §3` 是同一张表的人工说明版。

## GUI-1c：RTL 里 ILA 例化处的原注释（"这一句是关键"）
**位置**：原第 129~132 行
**删掉的原文**：
>     /* ---------------- 3) 片内逻辑分析仪（标准 IP 例化） ---------------- */
>     // ★ 这一句就是"GUI 里能看到 ILA、流程不灰"的关键：它是普通 RTL 例化，
>     //   综合时是个真实 IP，Hardware Manager 也能自动匹配探针文件。
>     //   probe 位宽必须与 build_project_ila.tcl 里的 ILA_PROBES 列表一致。

**补充说明**：这条在 RTL 里保留了（并写全成"位宽 / 顺序的唯一权威是
`ILA_NPROBES` / `ILA_PROBES`"）；本节的原文备查。

## GUI-附录B：调试量的"真实负载" —— 为什么不需要再加 keep 属性
**位置**：原第 79 行（第 1 节 "被观测设计的全部调试量" 的说明）
**删掉的原文**：
>     // 这些线同时接到 ILA 的 probe 上，所以有真实负载，综合不会删。

**补充说明（这条是"不加 keep"的依据）**：ILA 是**真实 RTL 例化**（`u_ila_0` 的
`.probeN` 端口），这些 `debug_*` 线因此有了**真实的输出负载**，综合不会把它们当无用逻辑
删掉 —— 这正是不用再给每一根调试线挂 `(* keep = "true" *)` 的原因。
反过来说：如果哪天把 ILA 例化拿掉（或改用 `mark_debug` 内存插桩那种"没有真实负载"的做法），
就必须退回 `debug_dead` + `keep` 的绕法，否则 13 组调试网只剩 3 组
（实测记录见 `syn/修复史_全量.md` §BOARDILA-3）。

---
