fshanhuan/Rsic-v-IM/docs/IMPLEMENTATION_v10.md

# v10 改造实施报告：前端解耦 / MDU radix‑4 / 异常体系 / 实现策略

本文是 `docs/CPU优化评审_汇总.md`（评审）的**实施篇**：那篇列了 13 项优化，本文只记录
本轮**确定动手的 5 项**——每一项都给出「问题（带 file:line）→ 改法 → 实测证据」，
以及**没做什么、为什么**。所有数字都是本仓库里跑出来的，可复现命令见文末 §7。

> 一句话结论：7 个整机程序**全部通过**，周期数从 84/88/253/215/242/288/330 降到
> 36/42/94/55/83/110/97（**几何平均 2.80×**，IPC 0.14~0.20 → 0.33~0.75）；
> 3 个异常专项程序从"一项都过不了"变成 **20/20 全过**；整机零回归。
>
> **v10.1 补充**：本节 5 项改动后来又在 WSL 下用 **Verilator 5.020** 做了一轮独立验证
> （交叉仿真 / 覆盖率 / 随机差分对拍黄金模型 / 变异测试），五项全部通过，并**顺带测出一个
> 真实功能缺陷**（DCache 背靠背 store 丢数据，见 §10）。验证报告单独成文：
> `docs/验证报告_v10_Verilator交叉仿真.md`。
>
> **v10.2 补充（§11）**：把那轮验证"点名说从来没跑过"的系统指令区补上（CSR 六种形式 /
> 中断 / `fence.i` / `ebreak`），**又抓出 4 个真缺陷并修掉**，用例从 18 项扩到 22 项，
> 交叉验证仍 22/22 等价、随机差分仍 1000 程序 0 失败、7 个定向变异全部被抓到。
> 面积 **+134 LUT / +28 FF**；WNS 3.553 → 2.203 ns，但**关键路径换成了 MDU 的
> `|a|·|b|` 归一链（本轮一行没动）**，两轮实现的同一条路径差 0.83 ns —— 归因与
> "下一步怎么改"见 §11.9。

---

## 0. 一览表

| # | 项 | 位置 | 结果 |
|---|---|---|---|
| 1 | **前端解耦**（取指队列 + ICache 全流水） | `rtl/IFU.sv`（重写）`rtl/ICache.sv`（重写）`rtl/myCPU.sv` | 取指节拍 **3 拍/条 → 1 拍/条**；`IFU_stall` 在 `prog_loop` 上 110→0 |
| 2 | **IROM 读使能门控** | `rtl/ICache.sv` 的 `mem_en` | `irom_en` 占空比 **≈100% → 24~96%（均值 68%）**，且计数器不再重复计 |
| 3 | **MDU：乘法器合一 + 除法 radix‑4** | `rtl/MDU_pipelined.sv`（+ `experimental/` 同步） | 32×32 乘法器 **3 → 1**（DSP 12→4）；除法 busy **33 拍 → 17 拍** |
| 4 | **异常体系补全** | `rtl/Control.sv` `CSR.sv` `EXU.sv` `Reg_Stack.sv` `IDU.sv` `myCPU.sv` | `TRAP_ENABLE` 默认 **0→1**；`tb_exc` **3/3 程序、20/20 断言全过**（原来 0 项过） |
| 5 | **布局约束 / 实现策略** | `build_project_ila.tcl` | directive + `phys_opt` + 可选 Pblock，全部开关化；见 §6 |

---

## 1. 前端解耦（本次最大收益项）

### 1.1 问题：不是"预测器不准"，是取指前端被结构限速在 3 拍/条

旧 `ICache` 的地址是**再寄存一拍**的（`mem_addr = cpu_addr_r`），然后用
`addr_same_r = (cpu_addr == cpu_addr_r)` 去判「返回的数据属不属于当前请求」。
同步 BRAM 本来就是"请求拍给地址、下一拍出数据"，再加这一拍寄存，实际延迟变成 2 拍，
于是 PC 必须**连续稳定 2 拍**才敢交付一条指令：

```
新 PC 出现 → 第 1 拍 hold（addr_same_r=0）→ 第 2 拍仍在途 → 第 3 拍才交付
            ⇒ 稳态 3 拍/条，0.33 IPC 上限
```

实测（改造前，本仓库 `_diag/tb_base.sv` + `_baseline_v9/rtl`）：

| 程序 | 周期 | 交付条数 | 交付占拍比 | `IFU_stall` 拍数 |
|---|---|---|---|---|
| `prog` | 84 | 12 | 14% | 36 |
| `prog_loop` | 288 | 58 | 20% | **110** |
| `prog_load_lane` | 215 | 40 | 19% | 87 |

`prog_loop` 的 110 拍停拍**全部来自 `icache_hold`**（load-use 0 拍、MDU 忙 0 拍）——
即前端自己卡自己，和后端一点关系都没有。

### 1.2 改法：地址组合直通 + 未命中旁路 + 4 项取指队列

`rtl/ICache.sv` 重写成**全流水、无停顿**：

* `mem_addr = cpu_addr`（**组合直通** BRAM）：BRAM 在 `cpu_req` 那拍采地址，下一拍
  `mem_rdata` 就是 `mem[addr(T)]`，**1 级延迟**。地址来自 IFU 的 PC 寄存器，本来
  就有一整拍余量，那额外一拍纯属自找。
* `resp_valid(T+1) = cpu_req(T)`；`idx_r/tag_r` 与 BRAM 地址**同一沿、同一源**采样，
  所以"返回的数据"和"做比较的 index/tag"结构上不可能错相。
* **未命中不停顿**：miss 那拍数据已经在 `mem_rdata` 上，直接**旁路**出去，同一沿把行填好
  ⇒ miss 的时序代价 **0 拍**。旧的 `hold`/重试机制整体删除（它正是 3 拍节拍的成因）。
* 计数器语义修正：`hit_cnt + miss_cnt` 现在**恰好等于取指次数**（旧实现在 PC 冻结的
  多拍里会重复计数）。

`rtl/IFU.sv` 重写成「PC 生成器 + 4 项队列」：

```
pc ──组合──> ICache（1 拍）──> [4 项队列] ──> IDU
 ▲                                 │
 └── pred / dnpc 决定下一拍 ────────┘（只在队列有空间时才发请求）
```

* **生产者**：队列有空间就每拍发一次请求，PC 每拍 `+4` 或跳预测目标。**不再看
  `ready`/`stall`** —— 这是解耦的全部意义。
* **消费者**：`valid = 队头有效`，`pop = valid & ready`（`ready` 里已含 `~stall`），
  和旧 IFU 的 `advance_en` 语义一一对应。
* **`pred_*` 跟着指令走**：`pred_taken/pred_target/pred_index` 与 `pc` 一起入队出队。
  这一条是**硬不变量**：旧结构里 IDU 是"在出队那拍现查预测器"，前端流水化后
  `fetch_pc` 早已是两条指令之后的地址，现查就会把别人的预测当成这条指令的
  （静默错，无任何报错）。所以 `Branch_Predictor.fetch_pc` 改接 `IFU.fetch_pc`，
  IDU 的 `pred_*_in` 改接 `IFU.pred_*_out`。
* **重定向**：`dnpc_flag` 当拍清空队列 + 清空在途请求 + `pc <= dnpc`，**不看
  `ready`/`valid`/队列深度**（旧 §IFU-1 不变量保留原样）。因为队列是缓冲，
  "发出即被接收"，预测跳转可以在发请求那拍就改 PC —— 旧的不变量在新结构下由构造保证。
* 队列深度取 **4**：够吸收 load-use(1 拍)/D-Cache 未命中(2 拍)的抖动；
  实测 `qmax` 在 `prog_loop` 只到 **1**（后端根本追得上前端了），
  在 `prog`/`prog_div` 这类短程序到 4（流量小、靠预取填）。

`rtl/myCPU.sv` 相应改动：

* `IFU_stall = IFU_stall_ctrl | dcache_hold`（**`icache_hold` 这根线整体消失**）；
  `IFU_mem_stall = dcache_hold`。
* `ICache.cpu_addr/cpu_req` 接 `IFU.ic_addr/ic_req`；`resp_valid` 接 `IFU.inst_valid`；
  `clr` 接 `icache_clr`（**这一根以前是悬空的**：`Control.icache_clr` 有输出、
  `myCPU` 也声明了网，但没接到 ICache —— fence.i 从来没清过 I-Cache，属于顺手修掉的漏接）。
* `Branch_Predictor.fetch_pc` / `IDU.pred_*_in` 改接 IFU 的对应输出（见上）。

### 1.3 实测

同一套测试台、同一批程序（改造后）：

| 程序 | 周期 | 交付条数 | 交付占拍比 | `IFU_stall` | 队列最大深度 |
|---|---|---|---|---|---|
| `prog` | 36 | 23 | 64% | 7 | 4 |
| `prog_mul` | 42 | 22 | 52% | 16 | 4 |
| `prog_div` | 94 | 18 | 19% | 72 | 4 |
| `prog_load_lane` | 55 | 48 | **87%** | 3 | 4 |
| `prog_load_use` | 83 | 55 | 66% | 22 | 4 |
| `prog_loop` | 110 | 90 | **82%** | **0** | 1 |
| `prog_div_pair` | 97 | 39 | 40% | 54 | 4 |

`prog_loop` 的 `IFU_stall` 从 110 降到 **0**，交付占拍比 20% → 82%。
剩下的停拍只有 `prog_div`/`prog_div_pair` 的 **MDU 多拍忙**（72/54 拍）——
那已经是另一项（§3）的账。

---

## 2. IROM 读使能门控（省电 + 修计数器）

**问题**：旧 `ICache` 把 `mem_en` 直接接 `cpu_en_r`，而 `cpu_en_r` 复位后恒为 1
（`ICache.sv` 原文 `cpu_en_r <= 1'b1;`），所以板上 `sync_mem` 的 `ren` **一直是 1**：
* 每拍都读一次 BRAM（PC 冻结、重定向、空转时照读）→ 白烧动态功耗；
* 同一次取指在 PC 冻结的多拍里被 `hit_cnt`/`miss_cnt` 重复累加 → 命中率统计不可信。

**改法**：`mem_en = cpu_req`（`ICache.sv`）。`cpu_req` 只在 IFU 真发一次取指那拍为 1；
队列满、重定向、复位期间都是 0。`sync_mem` 的契约本来就是「`ren=0` 时 `rdata` 保持
旧值」，因此消费侧必须只看 `resp_valid=1` 的拍 —— 新 ICache 正好就是这么写的。

**实测 `irom_en` 占空比**（`irom_en=1` 拍数 / 总周期）：

| 程序 | 改造前 | 改造后 |
|---|---|---|
| `prog` | 99% | 81% |
| `prog_mul` | 99% | 64% |
| `prog_div` | 100% | **24%** |
| `prog_load_lane` | 100% | 96% |
| `prog_load_use` | 100% | 76% |
| `prog_loop` | 100% | 92% |
| `prog_div_pair` | 100% | **45%** |

**诚实结论**：占空比均值 ≈ **68%**，省的是 **BRAM 读动态功耗的约 1/3**，不是数量级。
真正的价值在**第二半**：计数器现在一次取指只记一次，命中率/缺失率终于可用了
（`hit_cnt + miss_cnt == 取指次数`）。占用率高的用例（`prog_load_lane` 96%）说明
"每拍都发请求"本来就是高效前端的常态 —— 门控省的是**空转那部分**，不是常态那部分。

---

## 3. MDU：乘法器合一 + 除法 radix‑4

### 3.1 乘法器 3 → 1

旧实现为了"三种带符号组合都能选"，同时算三个 32×32 积（`prod_ss/prod_su/prod_uu`）：
* 32×32 无符号乘在 7 系列上一只要 4 个 DSP48E1 ⇒ **12 个 DSP**。

改法：只用**一个**无符号 32×32 乘，加符号修正：
```
mul_a/mul_b = 按 op_sel 选幅值（mul/mulhu 原值；mulh 双 abs；mulhsu 只 abs(d1)）
mul_neg     = 结果的符号（mulh: d1[31]^d2[31]；mulhsu: d1[31]；其余 0）
prod_mag    = {32'b0,mul_a} * {32'b0,mul_b}
prod_signed = mul_neg ? (~prod_mag + 64'd1) : prod_mag
```
正确性靠"64 位截断 + 取反恒等于真二补数积"：`|a|≤2^31`、`|b|≤2^32-1` ⇒ 积 < 2^63，
不溢出；`abs32(INT_MIN)=0x8000_0000` 恰好就是幅值 2^31，`INT_MIN*INT_MIN=2^62` 也不溢出。

**DSP 12 → 4**，代价是 2 个 32 位 abs 取负器 + 1 个 64 位条件取负器 + 两组 32 位输入
二选一（约 +230 LUT 量级）。

### 3.2 除法 radix‑4（一位商/拍 → 两位商/拍）

旧实现是 32 拍「左移-试减-回写」恢复余数法 + 1 拍结果窗口 = **33 拍 busy**。
改法：**两级 radix‑2 组合展开**（每个时钟做两位商），迭代 16 拍 + 1 拍窗口：

```
shifted1 = {r_rem[30:0], r_a[31]}      → rem1, ge1
shifted2 = {rem1[30:0], r_a[30]}       → rem2, ge2
q_nxt    = {r_q[29:0], ge1, ge2}
r_a     <= {r_a[29:0], 2'b00}
```
只改迭代支路那三行；`abs32` 幅值化、`sign_diff_r`/`d1_neg_r` 回正、
`div_res` 的除零/`INT_MIN÷-1` 边界 `unique case`、`busy=div_run|div_hold`、
`done=mul_stb|div_hold`、`res=div_active?div_res:mul_res_reg`、唯一 `always_ff`、
14 个状态寄存器的复位覆盖 —— 全部逐字保留。

**busy 拍数：33 → 17**（含发射拍 34 → 18）；6059 次除法全部恰好 17 拍。

代价：迭代组合深度从 1 个 32 位减法变成 **2 个串联的 32 位减法 + 2 个比较器**
（radix‑4 展开的固有代价）。这是 MDU 内部新的最长路径，上板看时序时值得单独确认。

### 3.3 验证

`_diag/mdu_verify/`（独立自检台，只编 `rtl/MDU_pipelined.sv` + `para.sv`，与整机 RTL 解耦）：
* 金标准在 TB 里用 64 位算术自算，除零与 `INT_MIN/-1` 显式特判（不依赖 Verilog `/` 的
  未定义行为）；negedge 采样避 NBA 竞争。
* **12107 条检查（mul 6048 / div 6059），errors=0**。5 个相位：8 操作 × 10×10 边界；
  3000 随机轮转；乘法角点 4×32×32；除法角点 4×32×32；back-to-back 连发 19 条
  （对应整机 `prog_div_pair`）。
* **变异测试**：注入 8 个典型 bug（mulh 取无符号高字 / mulhsu 符号反 / 缺 64 位取负 /
  `abs32(INT_MIN)` 错 / radix‑4 第 2 级丢被除数位 / 余数不回正 / 只迭代 15 拍 /
  `div_hold` 不置位）→ **8/8 全被检出**，证明测试台不是空转。
* 整机旁证：`prog_div` 253 → 94 拍、`prog_div_pair` 330 → 97 拍（两项改造叠加后）。

---

## 4. 异常体系补全

原来 `Control.sv` 的 `TRAP_ENABLE` 默认 0，注释写着"=1 时 `prog_loop` 仍复现 B4 症状，
故交付默认关"。本轮把整条通路真正打通，`TRAP_ENABLE` 默认改成 **1**，并且
`sim/tb_exc.sv` 的 3 个程序 **20 条断言全过**（改造前：一次陷入都产生不了）。

改造过程中一共挖出 **6 个真 bug**，全部是"不报错、只是现场错"的那一类：

### 4.1 B4 的真因：两拍补发把刚写好的现场冲成 0（C8 附带）

旧实现把同步异常做成「`trap_take`（登记）+ `trap_take_q`（下一拍补发重定向）」两拍对，
并要求所有登记条件都含这两根。问题：**补发那一拍 EX 级已经没有异常了**，
`trap_cause` 退化成 `0000`、ID 级 `pc` 也已经换成重定向后的值，于是把刚写对的
`mepc/mcause` 覆盖成 0。实测 `exc_illegal`：

```
cyc14 : mcause=2  mepc=0x1c   ← 第一次登记是对的
cyc15 : mcause=0  mepc=0x00   ← 补发拍把它冲成 0，mret 回到 0，无限重启
```

补发机制存在的唯一理由是「旧前端在 `ready=0` 时会丢掉重定向脉冲」。v10 的 IFU 里
`if (dnpc_flag) pc <= dnpc;` 是**无条件**的，所以补发不但没必要、还有害 ⇒
整体删除，`trap_redirect = trap_take`（单拍），`exc_pending` 天然只有一拍宽
（EXU 在 `trap_take` 那拍就把异常标志清掉，见 `EXU.sv` 的 `if (reset | trap_take)`）。
`dbg_mcause` / `dbg_mepc` 的观察口也因此不再是"每拍被冲一次"的。

### 4.2 `mepc` 写错了一条指令（C9）

`CSR.sv` 原来 `mepc_reg <= trap_commit ? pc : csrd;`，而 `pc` 是 **译码级** PC。
但同步异常是在 **EX 级**判出来的，两者差两条指令：

```
出错指令在 0x1c → 写进 mepc 的是 0x20 → 处理程序 mepc+4=0x24 → 正好跳过错指令
                                        或直接跑飞
```
改：新增 `Control.fault_pc = EXU_pc`（EX 级 PC），`mepc` 按来源三选一：
`trap_take → fault_pc`、`intr_take/ecall → pc`（这两个本来就在 ID 级判定，是对的）、
其余 → `csrd`（软件写）。

### 4.3 条件分支的 `mtval` 是"比较结果"而不是目标（C9b）

`fault_addr = Ex_result`。对 `jal/jalr`，`Ex_result` 就是目标地址；但对**条件分支**，
`Ex_result` 是**比较结果**（bit0 为方向）。改：
`fault_addr = (branch_flag|jump_flag) ? actual_target : Ex_result`，
`actual_target` 正好是 `jump_flag ? Ex_result : branch_pc` —— 对 load/store 仍取有效地址。

### 4.4 指令地址非对齐：晚一条指令 + 把分支操作数当目标（C11 / C11b）

`EXU.sv` 原来 `iaddr_misalign_reg <= ((branch_flag_reg|jump_flag_reg) & ((add1_reg+add2_reg)&3))`。
两个错：

1. **用的是 `*_reg`**，即"上一条"指令的现场 —— 于是这个异常永远**晚一条指令**触发。
   实测 `exc_jal_misalign` 里 `jal x5,+2`（目标 0x1e）**一次都没陷入**（trap=0）。
   改成用端口 `add1/add2/branch_flag/jump_flag`（= 本拍正在接收的那条），与
   `illegal_in`/`mem_misalign_in` 同源同拍。
2. **`add1+add2` 对条件分支根本不是目标**：`jal` 是 `PC+imm`、`jalr` 是 `rs1+imm`
   （bit0 由硬件清零），而**条件分支**是 `rs1+rs2`（比较操作数！），目标是
   `branch_pc = PC+imm_B`（IDU 早就算好）。原来一律相加，于是 `blt x1,x3,-8` 被算成
   `1+10=11`（低 2 位 `11`）→ **每轮凭空陷入一次**。实测 `prog_loop` 每 11 拍重启一次、
   `x1` 永远到不了 10。改后按 `jump_flag ? {1'b0,(add1[1:0]+add2[1:0])[1]} : branch_pc[1:0]`
   区分两者（低 2 位求和只要 2 位加法器）。

### 4.5 load / store 非对齐分不清（C12）

`trap_cause` 原来用 `funct3` 猜"这是 load 还是 store"：
```
exc_load_mis  = mem_misalign_exc & ~funct3[1] &  funct3[2]   // 只有 1xx（lbu/lhu）
exc_store_mis = mem_misalign_exc &  funct3[1] & ~funct3[2]   // 只有 001（sh）
```
但 **`lw` 和 `sw` 的 funct3 都是 010**、`lh` 和 `sh` 都是 001 —— funct3 里没有
"读还是写"这一位。于是 `lw` 非对齐被判成 **store** 非对齐（mcause 报 6，应为 4）。
实测 `exc_misalign`：`lw` @0x24 报 mcause=6，测试期望 4。
改：直接看**出错指令编码**的 `opcode[6:0]` 是不是 `S_opcode`（`fault_inst` 本来就在手，
与异常标志同拍锁存），既准确又不需要新增端口。

### 4.6 中断与异常可以同拍成立（C8）

`intr_safe` 少了 `~trap_redirect`，于是"同步异常"与"中断"能同拍都成立：
`trap_take` 让 CSR 登记 `mcause=异常码/mepc=异常指令`，而 `dnpc_flag` 的仲裁优先级
`intr_take > trap_redirect` 又把 PC 送去了 mtvec —— 两者目标恰好都是 mtvec，
所以现象**不是跑飞**，而是 `mepc` 被中断覆盖成错的 PC（`mret` 回不到出错指令），
或者 `mepc` 被同拍写两次。这类"目标相同、现场被踩"的 bug 只有异常嵌套时才暴露。
改：`intr_safe` 补 `& ~trap_redirect`。

### 4.7 CSR 写后读没有前递（C10）

CSR 写是**精确提交**的（走到 WB 级才落寄存器），而 `mret` 在**译码级**就要读 `mepc`
去改 PC —— 两者相隔 5 级，中间没有任何前递。而典型的陷入返回序列就是紧挨着的：

```
csrw mepc, x21      ; 处理程序把 mepc 改成"出错指令+4"
mret                ; 紧隔一条
```
于是 `mret` 读到**旧** `mepc`。实测 `exc_illegal`：处理程序明明写好了 0x20，
`mret` 还是回到 0x1c 的非法指令 → 23 次/400 拍无限陷入。

改：在 `Control.sv` 加一条 **4 深 CSR 写影子流水**（`csrwen_sh/csrval_sh`），
把 EX 级的 CSR 写事件（地址位图 + 写数据）往后打，在译码级做前递：
```
优先级（新→旧）：EX 级本体 > sh[0]=M1 > sh[1]=M2 > sh[2]=M3 > sh[3]=WB > 寄存器本体
```
写数据在流水里就是各级的 `Ex_result`（`csrrw` → `rs1+0`；`csrrs` → `csrs|rs1`），
所以不需要新数据通路。**EX 级本体必须参与前递**——这是距离 1 的那一档
（`mret` 在译码级时，它前面那条 `csrw` 正好在 EX 级），只前递影子链会漏掉它。
★ 不变量：只在 `EXU_valid & ~EXU_inst_clear` 那拍吸收 —— 被冲刷的指令不会真的写 CSR。

### 4.8 顺手修掉的漏接

`Control.icache_clr`（= `fence_i_flag & EXU_valid`）在 `myCPU` 里声明了、也接了
`Control` 的输出，但**从来没接到 ICache** —— `fence.i` 一次都没清过 I-Cache。
v10 把它接到新 `ICache.clr`。

### 4.9 `tb_exc.sv` 的三处采样时序错误（测试台 bug，非 RTL）

这三处是**测试台自己的**问题，此前从未暴露（因为 RTL 一次陷入都产生不了），
本轮一并修正，并在文件里写清了原因：

1. `trap_take` 上升沿那一拍读 `dbg_mcause` 读到的是**陷当前**的旧值 ——
   CSRs 在那一拍的时钟沿才落盘。改为下一拍采（`trap_edge` 打一拍）。
2. "看到 `x10=1` 写回后再等 12 拍取现场"—— 旧前端 3 拍/条时恰好赶在 ecall 的处理程序
   落地之前；前端快了 3 倍后就赶不上了（`ecall` 的 `mcause` 写发生在**译码级**，
   比它自己的写回早 5 拍）。改为**在 `x10=1` 写回那一拍立即取现场**。
3. `jal_misalign` 的 `x24 != 0xDE` 判据自相矛盾：处理程序统一做 `mepc += 4` 后 `mret`，
   对 0x1c 的非对齐 `jal` 来说 `mepc+4` 正好落在 0x20 那条 `addi x24,x0,0xDE` 上，
   所以**陷入处理完之后它本来就会合法执行**。判据改成"陷入那一刻 `x24` 还没被写"
   （`trap_r24`），这才是这句话真正想验的东西。

### 4.10 实测

```
exc_illegal      : trap=1  mcause=2  mepc=0x1c  mtval=0     handler cnt=1   recovered x24=0x55   → 7/7 PASS
exc_misalign     : trap=2  先 4(mtval=0x402) 后 6(mtval=0x403)  handler cnt=2  recovered x26=0x99 → 8/8 PASS
exc_jal_misalign : trap=1  mcause=0  mepc=0x1c  mtval=0x1e  handler cnt=1                          → 5/5 PASS
```

---

## 5. 整机回归（18 项全过）

命令：`powershell -NoProfile -ExecutionPolicy Bypass -File _diag\regress.ps1`
（替代失效的 `sim/run_all.sh`：7 程序 × {普通, 严格} + D-Cache 单元 + `tb_exc` × 3）

```
prog 36 / prog_mul 42 / prog_div 94 / prog_load_lane 55 / prog_load_use 83 /
prog_loop 110 / prog_div_pair 97    （普通与严格两种模式周期完全一致）
tb_dcache_unit PASS   tb_exc illegal/misalign/jal_misalign 全 PASS
==== [REGRESSION] ALL PASS (18 runs) ====
```

### 改造前后对照（同一测试台、同一程序、同一统计口径）

| 程序 | 周期 前 → 后 | 加速 | 提交条数 | IPC 前 → 后 | `irom_en` 前 → 后 |
|---|---|---|---|---|---|
| `prog` | 84 → **36** | 2.33× | 13 | 0.143 → **0.361** | 99% → 81% |
| `prog_mul` | 88 → **42** | 2.10× | 15 | 0.159 → **0.357** | 99% → 64% |
| `prog_div` | 253 → **94** | 2.69× | 11 | 0.040 → **0.117** | 100% → 24% |
| `prog_load_lane` | 215 → **55** | **3.91×** | 41 | 0.186 → **0.745** | 100% → 96% |
| `prog_load_use` | 242 → **83** | 2.92× | 45 | 0.182 → **0.542** | 100% → 76% |
| `prog_loop` | 288 → **110** | 2.62× | 59 | 0.201 → **0.536** | 100% → 92% |
| `prog_div_pair` | 330 → **97** | **3.40×** | 32 | 0.094 → **0.330** | 100% → 45% |

**几何平均加速 2.80×**。改造前的 IPC 与 `docs/CPU优化评审_汇总.md` / `teach/log` 里
记录的 0.17 / 0.05 / 0.114 / 0.187 / 0.183 / 0.202 一致（差异只来自"提交条数"的
统计口径），说明基线是同一套口径量的，对照可信。

### 5.1 面积代价（Vivado 2025.2 综合后，同一工程同一 flow，`project_src/util_post_synth*.rpt`）

| 资源 | 改造前 | 改造后 | Δ |
|---|---|---|---|
| LUT as Logic | 11939 | 12337 | **+398**（+3.3%） |
| LUT as Memory | 914 | 914 | 0 |
| Slice Registers | 14072 | 14659 | **+587**（+4.2%） |
| F7 Muxes | 1651 | 1653 | +2 |
| F8 Muxes | 638 | 639 | +1 |
| Block RAM Tile | 38.5 | 38.5 | 0 |
| **DSPs** | **12** | **4** | **−8**（−67%） |

代价构成（对得上）：
* 取指队列 4 × (32 pc + 32 inst + 1 + 32 target + 6 index) = **412 FF** + 在途元数据 **103 FF**
  = 515 FF；再减掉旧 ICache 里被删掉的 `cpu_addr_r(32) + align_*_r(30) + resp_valid_r`
  ≈ −63 FF，以及旧 IFU 的 `valid` 寄存器等 ⇒ 净约 +430 FF。
* CSR 写影子流水 4 × (16 + 32) = **192 FF**。
* LUT +398：ICache 的旁路 mux、IFU 队列移位/落点选择、`fault_addr` 的 `actual_target` 选择、
  2 位目标低 2 位加法器、MDU 的符号修正（2 个 32 位 abs + 1 个 64 位条件取负）。

**一句话**：用 **+398 LUT / +587 FF**（占 7z020 的 0.75% / 0.55%）换 **2.80× 性能**、
**−8 个 DSP**、以及一套真正能用的异常体系。面积从来不是这颗核的瓶颈（总量仍只占
23% LUT / 14% FF）。

### 加速从哪来（分解）

* **前端解耦**贡献最大且普适：所有程序都在 2.1×~3.9× 区间。
* **MDU radix‑4** 只在 `prog_div` / `prog_div_pair` 上叠加：若只做 radix‑4 不做前端，
  `prog_div` 预期 253−4×16 = 189 拍；只做前端不做 radix‑4 预期 94+4×16 = 158 拍；
  两者都做 = **94** 拍（实测），与叠加模型吻合。
* **异常体系**对这三个"正确程序"没有性能影响（它们不陷入），收益是**正确性**。

---

## 6. 布局约束 / 实现策略

改的是 `build_project_ila.tcl`（**没有动 `v9_board_ila.xdc` 的时序/引脚约束**，
以便两种模式共用同一份 XDC、报告可比）。

### 6.0 顺手发现的一处 RTL 侧时序回退（已修）

第一次跑 no-ILA 时序时，最差路径的**端点**变了：

```
起点: u_cpu/EXU_Inst0/add1_reg_reg[0]/C            ← 老路径的同一源
终点: u_board_top/irom_inst/g_rom.rdata_reg_*/ENARDEN          ← IROM 读使能!
      u_cpu/IFU_Inst0/g_queue[2].q_ptg_reg[*]/CE              ← 队列槽时钟使能!
```

也就是说：**我新加的"读使能门控 + 队列清空"把 `dnpc_flag` 这条长组合链
（`EXU add1_reg → ALU → Control 误预测判定`）接到了一个全新的、扇出很大的负载上。**
这属于"优化 A 把优化 B 的最差路径拉长了"，必须承认并修掉：

* `ICache.mem_en` 是 `ic_req`；`ic_req` 原来带 `~flush` ⇒ 把 `dnpc_flag` 直接拖到 BRAM 使能。
  **去掉 `~flush`**：正确性由"flush 优先级最高"保证（`pc_f` 先判 `dnpc_flag`、
  `meta_v` 被 flush 清零 ⇒ 那拍读回来的响应 `push=0` 绝不会进队列），
  代价只是 flush 那拍多发一次注定被丢弃的 BRAM 读。
* `push` 原来也带 `~flush`，同理去掉（flush 分支在 always_ff 里优先级更高，CE 上不需要它）。

改完 `mem_en` 只依赖 `room`（队列有空位）与 `~reset`，不再依赖重定向链。
（这一处是**实测驱动**的修改，不是猜的：`project_src/timing_noila.default.rpt`。）

### 6.1 为什么这么改（依据是上一轮实测）

`project_src/timing_post_route.rpt` 里最差路径 15.897 ns 的构成：
**逻辑 3.365 ns（21.2%）+ 布线 12.532 ns（78.8%）**，15 级逻辑。
而全设计只用了 13006 LUT / 14765 FF（7z020 的 24% / 14%）—— **面积远远不是瓶颈，
布线延时才是**。所以策略重点是"减少拥塞 / 缩短线长"，而不是拼命优化逻辑级数：

| 手段 | 针对什么 |
|---|---|
| 综合 `-directive PerformanceOptimized` | 默认 `default` 偏面积，时序优先会做更多复制/重构 |
| 实现 `opt=Explore` / `place=AltSpreadLogic_high` / `route=AggressiveExplore` | 78.8% 是布线延时：要么把逻辑摊开减少拥塞，要么让布线器多迭代 |
| `phys_opt_design -directive AggressiveFanoutOpt`（place 后） | 针对实测 **fo=278 / fo=128** 两根高扇出广播网做**寄存器复制** |
| `phys_opt_design -directive ExploreWithHoldFix`（route 后） | 实测 **WHS 只有 +0.013 ns**，hold 极紧，route 后必须再修一次 |
| 可选 Pblock（`PB_ENABLE=1`） | 把 CPU 核心 / 存储器 / ILA 分到不同时钟区域，见 6.3 |

**踩到的坑（写在这里省下一次）**：`phys_opt_design -force_replication_on_nets` 的签名是
`-force_replication_on_nets <args>`，**必须给一串网表对象**；不带参数直接报
`ERROR: [Common 17-157] Error parsing command line options`（实测 strategy run 就倒在这）。
"让工具自己挑高扇出网去复制"应该用 directive `AggressiveFanoutOpt`，不是那个开关。

### 6.2 开关化（可复现对照组）

```tcl
set IMPL_MODE "strategy"   # "default" | "strategy"; 可用环境变量 IMPL_MODE 覆盖
set PB_ENABLE 1            # 只在 strategy 模式有效
set PROJ "${PROJ}_${IMPL_MODE}"   # 两种模式用**不同的工程目录**，可先后跑、直接比报告
```
`default` 模式 = 与改造前完全一致的流程（默认 directive、无 phys_opt），
用来做对照；`strategy` 模式才下发上面那些属性。
报告文件名也带 `$RUN_TAG` 后缀，两套结果不会互相覆盖。

### 6.3 Pblock（粗粒度）

由 scripts 在 `project_src/v10_pblocks.xdc` 现场生成（不入库、可开关）：

| Pblock | 装什么 | 区域 |
|---|---|---|
| `p_cpu` | `u_board_top/u_cpu` | 左半 `SLICE_X0Y0:X49Y299` + DSP/RAMB |
| `p_mem` | `irom_inst` / `dram_inst` 的 BRAM | 右下 `RAMB18_X1Y160:X1Y319` 等 |
| `p_ila` | `u_ila_0`（ILA 自身 ~24 个 BRAM + 大量 FF） | 右上 `SLICE_X50Y150:X99Y299` |

**刻意用"半个器件"这种粗粒度**：Pblock 收得太紧会反噬（工具无法合法化 → 局部拥塞），
粗粒度只调"邻居关系"。而且 `IMPL_MODE=default` 随时能跑对照组量化收益。

### 6.4 顺手修掉的构建脚本炸弹（很重要）

`build_project_ila.tcl` 原来有这么一段：
```tcl
set WSRC "E:/share doc/v9"      ;# 仓库正本
foreach f {board_top_ila.sv ...} { file copy -force "$WSRC/board/$f" "$WORK/board/$f" }
foreach f [glob "$WSRC/rtl/*.sv"] { file copy -force $f "$WORK/rtl/[file tail $f]" }
```
`E:/share doc/v9` 在本机**是存在的**。也就是说：**在这个目录里改完 RTL 一跑综合，
就会被正本覆盖回旧代码**，而日志的"源文件清单"只打文件名、不打时间戳，看不出来。
本轮 RTL 改造正好全部落在 `$WORK/rtl`，所以把它改成：
* `SYNC_FROM_WSRC = 0`（默认）：**只补缺失文件，绝不覆盖已存在的**；
* `SYNC_FROM_WSRC = 1`：显式要求时才用正本强制覆盖（并打印提示）。

另外两处环境适配（都写了原因，不写下次还会踩）：
* `set_property source_mgmt_mode None`：2025.2 在本机 **automatic hierarchy update 的
  层次扫描会静默失败**，报 `CRITICAL WARNING: [filemgmt 20-730] Could not find a top module`，
  随后 `launch_runs` 以 `Unable to launch Synthesis run. No Verilog or VHDL sources found`
  失败 —— 而文件都在 fileset 里、`FILE_TYPE` 都是 `SystemVerilog`、逐文件
  `read_verilog` 零报错。**用原始 RTL 也能复现**，证明与 RTL 无关。手工模式跳过层次扫描，
  综合按 fileset 清单跑，结果等价。
* `launch_runs` 会 fork `runme.bat`/`rundef.js`，子进程在本沙箱里被拒
  （`rundef.js(122,5) JavaScript runtime error: Access denied`），run 永远不动。
  因此测量改用 `_diag/vivado_inproc.tcl`：**同一个 Vivado 进程内**
  `synth_design → opt/place/phys_opt/route`，只写 `$WORK`。

### 6.5 实测结果

**先说清楚这次能量到什么、量不到什么**（本机是受限沙箱环境，不是完整桌面）：

* `launch_runs`（工程模式的正式流程）**跑不了**：它 fork `runme.bat`/`rundef.js`，
  子进程被文件沙箱拒绝（`rundef.js(122,5) JavaScript runtime error: Access denied`），
  run 永远 0%。
* 带 ILA 的 `opt_design` **也跑不了**：卡在
  `Phase 1.1.1 Generate And Synthesize Debug Cores` 的 `dbg_hub_CV` IP 生成（同一个
  fork 子进程问题），日志 15 分钟零增长。
* 所以时序/面积分两部分给：**综合（含 ILA）**用 `_diag/vivado_inproc.tcl` 拿到了；
  **实现（布局布线）**改用 `_diag/vivado_noila.tcl` —— 顶层换成 `board_top_ila`
  （MMCM + CPU + IROM/DRAM，**不含 ILA**），全程单进程，既避开 debug hub，又正好把
  上一轮评审点出的"调试基础设施占 37% LUT"从数据里摘掉，CPU 本身看得更清楚。

> ⚠ 因此下面 `noila` 的**绝对值不能**和 `project_src/timing_post_route.rpt`（含 ILA，
>   WNS +3.445 ns / Fmax 61 MHz）直接比。它只用于 **同口径的 default vs strategy 对照**。

（结果表见 §6.6）

**综合面积（含 ILA，同 flow 前后对照）**：见 §5.1 —— LUT +398、FF +587、**DSP 12→4**。
其中 DSP 的 −8 直接来自 MDU 乘法器合一（Vivado DSP 报告里 `MDU_pipelined` 只剩
4 个 DSP48E1，且映射为 `A*B` / `PCIN>>17+A*B` 各 2 个）。
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
