fshanhuan/Rsic-v-IM/sim/README_msim.md

# `sim/` 的 ModelSim 回归线（v9）

> 本文件说明**在 ModelSim 下怎么跑 v9**，以及踩过的 5 个坑。
> iverilog 那条线见 [`README_iverilog.md`](./README_iverilog.md)、[`run_all.sh`](./run_all.sh)。

## 1. 一条命令跑全量

```bat
cd /d "E:\share doc\v9"
sim\run_msim.bat
```

或直接调 PowerShell 驱动（内容一样）：

```powershell
powershell -NoProfile -ExecutionPolicy Bypass -File sim\run_msim.ps1
```

跑的是 **7 个程序 × {正常, 严格} = 14 项 + D-Cache 单元测试 = 15 项**，
日志落在 `msim/logs/`，汇总表在 `msim/logs/msim_summary.txt`，全过才返回 0。
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
