fshanhuan/Rsic-v-IM/figures/v17_bp_sweep.png

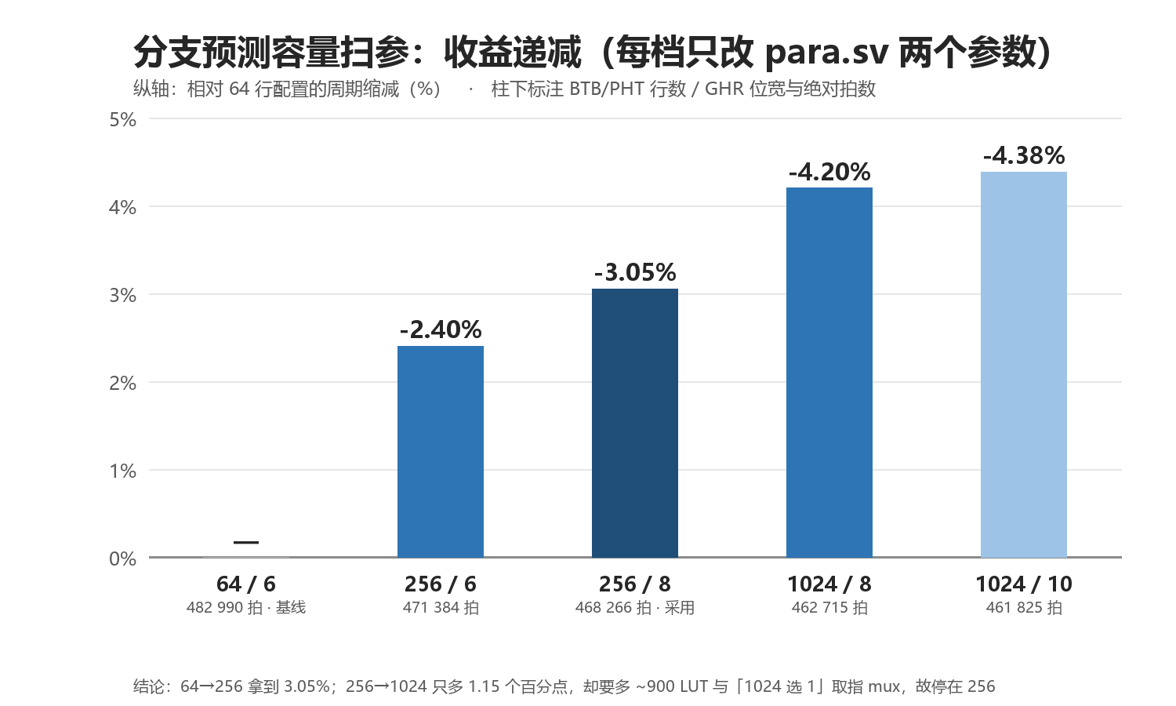
figures/v17_bp_sweep.png
