fshanhuan/Rsic-v-IM/figures/v17_coremark_trend.png

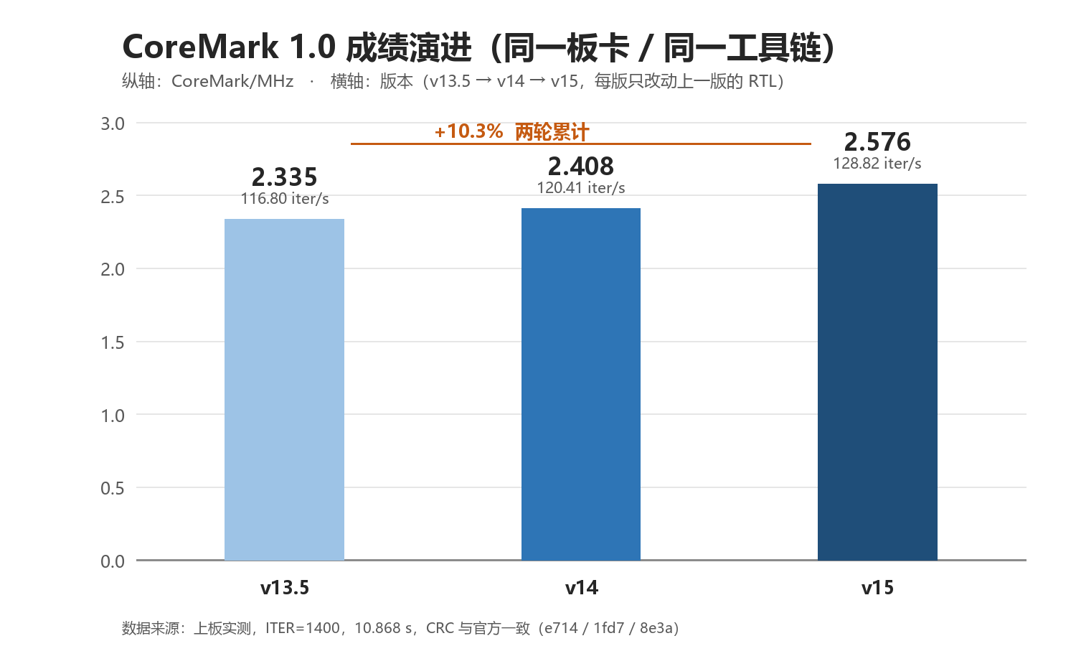
figures/v17_coremark_trend.png
