fshanhuan/Rsic-v-IM/figures/v17_stall_before_after.png

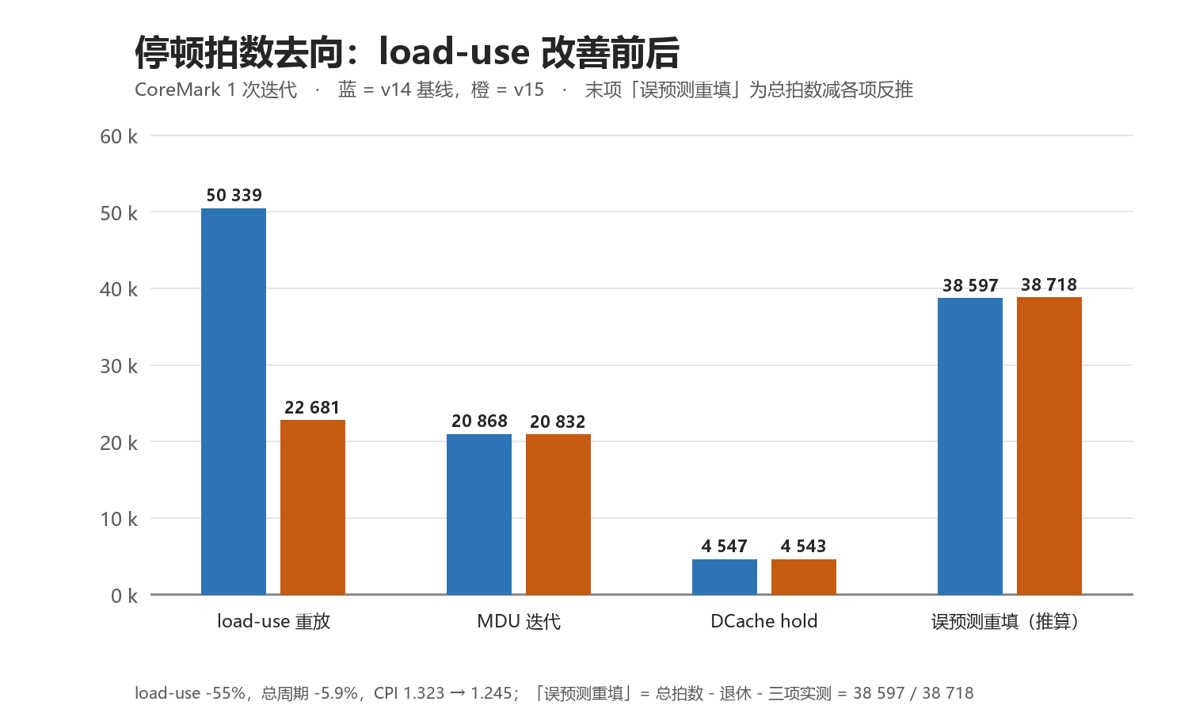
figures/v17_stall_before_after.png
