fshanhuan/Rsic-v-IM/v9/figures/v9_arch_overview.png

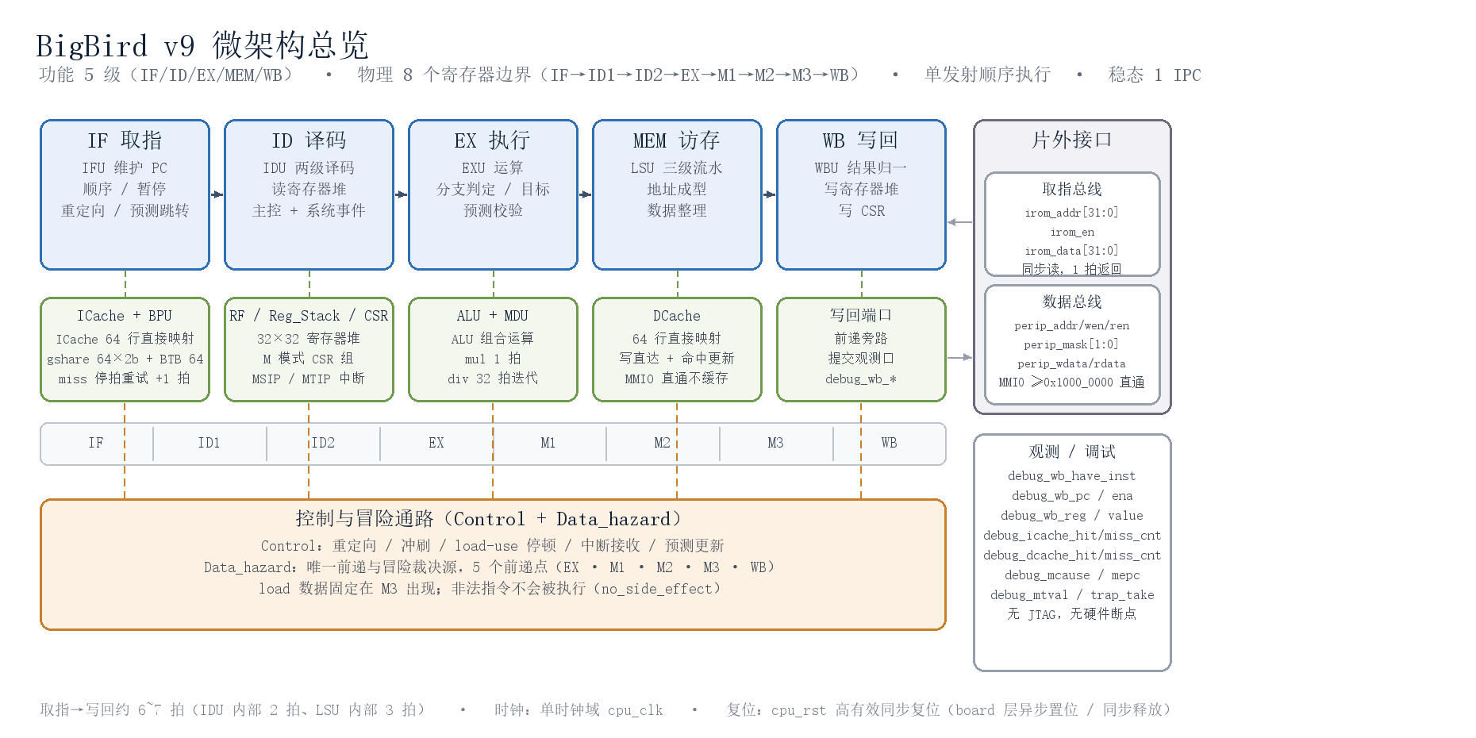
v9/figures/v9_arch_overview.png
