fshanhuan/Rsic-v-IM/v9/figures/v9_capacity.png

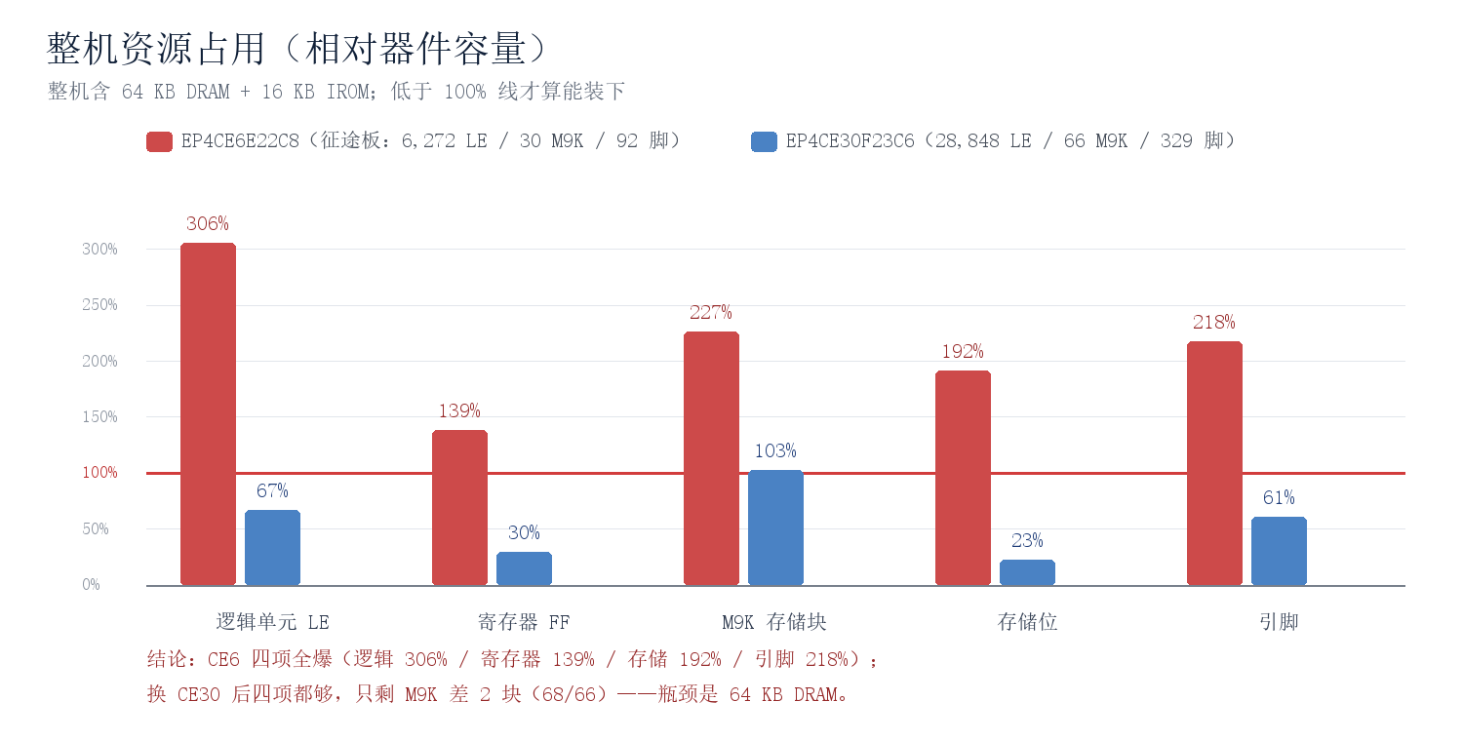
v9/figures/v9_capacity.png
