fshanhuan/Rsic-v-IM/sw/ps/app_image.h

/* =============================================================================
 * sw/ps/app_image.h — RISC-V 镜像（**自动生成，不要手改**）
 * -----------------------------------------------------------------------------
 * 来源：monitor.elf
 * 生成：python tools/gen_ps_image.py sw\build\monitor.elf sw\ps\app_image.h
 *
 * 装载约定（与 sw/ps/stub.S 一一对应）：
 *   DRAM[0xA000]      = RISC_IMG_WORDS
 *   DRAM[0xA004..]    = risc_img[]      (.text，由 stub 抄进 IMEM 代码窗口)
 *   DRAM[RODATA_ADDR] = risc_rodata[]   (.rodata，链接地址就是运行地址)
 *   DRAM[BSS_ADDR]    = 全 0          (.bss，必须显式清零)
 * ============================================================================= */
#ifndef PS_APP_IMAGE_APP_IMAGE_H_H
#define PS_APP_IMAGE_APP_IMAGE_H_H

#define RISC_ENTRY_WORD   0u
#define RISC_IMG_WORDS    5114u
#define RISC_IMG_DRAM     0x0000A000u
#define RISC_RODATA_ADDR  65536u
#define RISC_RODATA_WORDS 1063u
#define RISC_DATA_ADDR    69788u
#define RISC_DATA_WORDS   0u
#define RISC_BSS_ADDR     69788u
#define RISC_BSS_WORDS    188u

static const unsigned risc_img[5114] = {
    0x00012197u, 0x89c18193u, 0x00020117u, 0xff810113u, 0x00011297u, 0x08c28293u, 0xaf018313u, 0x0062f863u,
    0x0002a023u, 0x00428293u, 0xff5ff06fu, 0x031040efu, 0x100002b7u, 0x0f028293u, 0x5a5a6337u, 0xa5a30313u,
    0x0062a023u, 0x0000006fu, 0x00054683u, 0x02068663u, 0x10000737u, 0x10000637u, 0x00470713u, 0x00150513u,
    0x00072783u, 0x0017f793u, 0xfe079ce3u, 0x00d62023u, 0x00054683u, 0xfe0694e3u, 0x00008067u, 0xfd010113u,
    0x02612623u, 0x02a12423u, 0x02b12223u, 0x02c12023u, 0x00d12e23u, 0x00e12c23u, 0x00f12a23u, 0x01012823u,
    0x01112623u, 0x01c12423u, 0x34202773u, 0x341026f3u, 0x08074863u, 0x00300793u, 0x00468613u, 0x04f70a63u,
    0x000117b7u, 0x09c78793u, 0x04e7a823u, 0x04d7aa23u, 0x0587a703u, 0x00170713u, 0x04e7ac23u, 0x34161073u,
    0x02c12303u, 0x02812503u, 0x02412583u, 0x02012603u, 0x01c12683u, 0x01812703u, 0x01412783u, 0x01012803u,
    0x00c12883u, 0x00812e03u, 0x03010113u, 0x30200073u, 0x000117b7u, 0x09c78793u, 0x0487a583u, 0xfa0586e3u,
    0xfad594e3u, 0x04c7a703u, 0x000206b7u, 0x00d585b3u, 0x00e5a023u, 0x0407a423u, 0x34161073u, 0xfa5ff06fu,
    0x01f77713u, 0x00b00793u, 0xf8f71ce3u, 0x10000537u, 0x00c52703u, 0x000117b7u, 0x00c50513u, 0x00177713u,
    0x09c78793u, 0x04070c63u, 0x100008b7u, 0x10000837u, 0x00888893u, 0x03f00e13u, 0x01880813u, 0x00100313u,
    0x0008a603u, 0x0007a703u, 0x0047a683u, 0x0ff67593u, 0x03f77613u, 0x40d706b3u, 0x00c78633u, 0x00170713u,
    0x00de6663u, 0x00b60423u, 0x00e7a023u, 0x00682023u, 0x00052703u, 0x00177713u, 0xfc0714e3u, 0x100007b7u,
    0x00100713u, 0x02e7a023u, 0xf19ff06fu, 0x7c002673u, 0x100005b7u, 0x000117b7u, 0x09c78793u, 0x00c58593u,
    0x0047a703u, 0x0007a683u, 0x02d70063u, 0x00170693u, 0x03f77713u, 0x00d7a223u, 0x00e787b3u, 0x0087c503u,
    0x0ff57513u, 0x00008067u, 0x05c7a703u, 0x02071663u, 0x0005a703u, 0x00177713u, 0x02070063u, 0x10000737u,
    0x00872503u, 0x100007b7u, 0x00100713u, 0x0ff57513u, 0x00e7ac23u, 0x00008067u, 0x7c002773u, 0x40c70733u,
    0xfae570e3u, 0xfff00513u, 0x00008067u, 0x00010537u, 0xff010113u, 0x00050513u, 0x00112623u, 0x00000097u,
    0xdec080e7u, 0x00010537u, 0x03c50513u, 0x00000097u, 0xddc080e7u, 0x100007b7u, 0x00100713u, 0x00e7aa23u,
    0x0000006fu, 0x000116b7u, 0x09c68693u, 0x0606a703u, 0x535347b7u, 0x64278793u, 0x00072703u, 0x08f70c63u,
    0x00000793u, 0x10000613u, 0x0606a703u, 0x00f70733u, 0x00072023u, 0x00478793u, 0xfec798e3u, 0x0606a603u,
    0x535347b7u, 0x0606a703u, 0x64278793u, 0x00f62023u, 0x00072223u, 0x00000793u, 0x02000613u, 0x0606a703u,
    0x00f70733u, 0x40070023u, 0x00178793u, 0xfec798e3u, 0x00000793u, 0x30000613u, 0x0606a703u, 0x00f70733u,
    0x10070023u, 0x01878793u, 0xfec798e3u, 0x00000793u, 0x00100813u, 0x00500513u, 0x0606a603u, 0x00f815b3u,
    0x00178793u, 0x40064703u, 0x00b76733u, 0x40e60023u, 0xfea794e3u, 0x00100793u, 0x06f6a223u, 0x00008067u,
    0x00011e37u, 0x00100313u, 0x00000813u, 0x09ce0e13u, 0x40a30333u, 0x30000e93u, 0x00c0006fu, 0x01880813u,
    0x07d80463u, 0x060e2783u, 0x010787b3u, 0x1007c783u, 0xfe0786e3u, 0x060e2883u, 0x00050793u, 0x10088893u,
    0x010888b3u, 0x0008c683u, 0x00069663u, 0x0440006fu, 0x00058793u, 0x0007c603u, 0x01178733u, 0x00670733u,
    0x00178593u, 0xfad61ce3u, 0x00074683u, 0xfe0692e3u, 0x0017c783u, 0xfa0794e3u, 0x060e2503u, 0x10050513u,
    0x01050533u, 0x00008067u, 0x00000513u, 0x00008067u, 0x00054783u, 0xf80794e3u, 0xfe1ff06fu, 0x08050263u,
    0xff010113u, 0x00000793u, 0x00410613u, 0x00a00593u, 0x00900313u, 0x00b00e13u, 0x02b57733u, 0x00078693u,
    0x00178793u, 0x00f608b3u, 0x00050813u, 0x03070713u, 0xfee88fa3u, 0x02b55533u, 0x01037663u, 0xfdc79ee3u,
    0x00a00693u, 0x10000737u, 0x00d606b3u, 0x10000537u, 0x00470713u, 0x0006c583u, 0x00072783u, 0x0017f793u,
    0xfe079ce3u, 0x00b52023u, 0xfff68793u, 0x00d60663u, 0x00078693u, 0xfe1ff06fu, 0x01010113u, 0x00008067u,
    0x10000737u, 0x00470713u, 0x00072783u, 0x0017f793u, 0xfe079ce3u, 0x100007b7u, 0x03000713u, 0x00e7a023u,
    0x00008067u, 0x00052783u, 0x00050f13u, 0x02000693u, 0x00900613u, 0x0007c703u, 0x00d70463u, 0x00c71663u,
    0x00178793u, 0xff1ff06fu, 0x03000693u, 0x00000813u, 0x04d70e63u, 0x00000713u, 0x00900e93u, 0x00500e13u,
    0x0180006fu, 0xfc968613u, 0x00471713u, 0x00c76733u, 0x00178793u, 0x00100813u, 0x0007c683u, 0xfd068613u,
    0xf9f68893u, 0xfbf68313u, 0xfecef0e3u, 0xfa968613u, 0xfd1e7ce3u, 0xfc6e78e3u, 0x00080513u, 0x00050663u,
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
};

static const unsigned risc_rodata[1063] = {
    0x2d657220u, 0x696d7261u, 0x6220676eu, 0x20746f6fu, 0x64616f6cu, 0x202c7265u, 0x20555043u, 0x6c6c6977u,
    0x20656220u, 0x646c6568u, 0x206e6920u, 0x65736572u, 0x2e2e2074u, 0x00000a2eu, 0x00000000u, 0x6f682820u,
    0x203a7473u, 0x6169645fu, 0x6f625c67u, 0x5f647261u, 0x2e6e7572u, 0x20317370u, 0x696b532du, 0x6f725070u,
    0x6d617267u, 0x72502d20u, 0x646d4365u, 0x2e206220u, 0x0a292e2eu, 0x00000000u, 0x6d6f630au, 0x646e616du,
    0x6e282073u, 0x65626d75u, 0x203a7372u, 0x20786568u, 0x64207962u, 0x75616665u, 0x202c746cu, 0x683d7830u,
    0x202c7865u, 0x643d6430u, 0x3a296365u, 0x0000000au, 0x00002020u, 0x69746d20u, 0x003d656du, 0x203d2020u,
    0x00000000u, 0x000a7320u, 0x65726620u, 0x00002065u, 0x00202f20u, 0x6f6c6220u, 0x20736b63u, 0x0000203du,
    0x0a424b20u, 0x00000000u, 0x00202020u, 0x00004220u, 0x62402020u, 0x00206b6cu, 0x6c696620u, 0x29732865u,
    0x0000202cu, 0x65726620u, 0x6c622065u, 0x736b636fu, 0x35322820u, 0x20422036u, 0x68636165u, 0x00000a29u,
    0x6942200au, 0x72694267u, 0x56522064u, 0x28203233u, 0x29343176u, 0x56522020u, 0x4d493233u, 0x63695a2bu,
    0x5a2b7273u, 0x746e6369u, 0x73202072u, 0x6c676e69u, 0x73692d65u, 0x20657573u, 0x6f2d6e69u, 0x72656472u,
    0x0000000au, 0x6c632020u, 0x30353d6bu, 0x207a484du, 0x4f524920u, 0x34363d4du, 0x3040424bu, 0x28203078u,
    0x63746566u, 0x6e6f2068u, 0x202c796cu, 0x7461642bu, 0x69772061u, 0x776f646eu, 0x78304020u, 0x30303032u,
    0x000a2930u, 0x52442020u, 0x313d4d41u, 0x424b3832u, 0x30783040u, 0x742e2020u, 0x40747865u, 0x4d4f5249u,
    0x642e2020u, 0x2f617461u, 0x6174732eu, 0x30406b63u, 0x305f3178u, 0x0a303030u, 0x00000000u, 0x4d4d2020u,
    0x40204f49u, 0x30317830u, 0x305f3030u, 0x3a303030u, 0x2f787420u, 0x6c2f7872u, 0x622f6465u, 0x72746f6fu,
    0x722f7165u, 0x706f7078u, 0x0000000au, 0x2d442020u, 0x68636163u, 0x35322065u, 0x77317836u, 0x54422020u,
    0x48502f42u, 0x35322054u, 0x47202036u, 0x38205248u, 0x41522020u, 0x0a382053u, 0x00000000u, 0x78722020u,
    0x71726920u, 0x00000020u, 0x2866666fu, 0x6c6c6f70u, 0x00000029u, 0x00004e4fu, 0x65202020u, 0x6e206378u,
    0x0000003du, 0x73616c20u, 0x00003d74u, 0x78304020u, 0x00000000u, 0x206f6e20u, 0x61657262u, 0x696f706bu,
    0x000a746eu, 0x656c6320u, 0x64657261u, 0x00783020u, 0x00783020u, 0x726f2020u, 0x303d6769u, 0x00000078u,
    0x67617375u, 0x6c203a65u, 0x61763c20u, 0x000a3e6cu, 0x44454c20u, 0x202d3c20u, 0x00007830u, 0x736d200au,
    0x75746174u, 0x20202073u, 0x7830203du, 0x00000000u, 0x28202020u, 0x2045494du, 0x33746962u, 0x504d202cu,
    0x62204549u, 0x29377469u, 0x0000000au, 0x65696d20u, 0x20202020u, 0x3d202020u, 0x00783020u, 0x28202020u,
    0x4549544du, 0x74696220u, 0x000a2937u, 0x70696d20u, 0x20202020u, 0x3d202020u, 0x00783020u, 0x28202020u,
    0x5049544du, 0x74696220u, 0x000a2937u, 0x61636d20u, 0x20657375u, 0x3d202020u, 0x00783020u, 0x70656d20u,
    0x20202063u, 0x3d202020u, 0x00783020u, 0x76746d20u, 0x20206365u, 0x3d202020u, 0x00783020u, 0x79636d20u,
    0x20656c63u, 0x3d202020u, 0x00002020u, 0x6e696d20u, 0x65727473u, 0x3d202074u, 0x00002020u, 0x69746d20u,
    0x2020656du, 0x3d202020u, 0x00002020u, 0x35282020u, 0x6b203030u, 0x0a297a48u, 0x00000000u, 0x69746d20u,
    0x6d63656du, 0x3d202070u, 0x00002020u, 0x67617375u, 0x70203a65u, 0x64613c20u, 0x0a3e7264u, 0x00000000u,
    0x00005b20u, 0x203d205du, 0x00007830u, 0x67617375u, 0x72203a65u, 0x6e3c206du, 0x3e656d61u, 0x0000000au,
    0x6d657220u, 0x6465766fu, 0x0000000au, 0x206f6e20u, 0x68637573u, 0x6c696620u, 0x00000a65u, 0x67617375u,
    0x64203a65u, 0x64613c20u, 0x203e7264u, 0x0a5d6e5bu, 0x00000000u, 0x67617375u, 0x6b203a65u, 0x64613c20u,
    0x203e7264u, 0x0a5d6e5bu, 0x00000000u, 0x736b6320u, 0x30206d75u, 0x00000078u, 0x00282020u, 0x726f7720u,
    0x40207364u, 0x00007830u, 0x00000a29u, 0x67617375u, 0x77203a65u, 0x64613c20u, 0x203e7264u, 0x6c61763cu,
    0x00000a3eu, 0x2d3c205du, 0x00783020u, 0x72282020u, 0x62646165u, 0x206b6361u, 0x00007830u, 0x67617375u,
    0x72203a65u, 0x72693c20u, 0x775f6d6fu, 0x5f64726fu, 0x72646461u, 0x2020203eu, 0x672e6528u, 0x2072202eu,
    0x30303033u, 0x00000a29u, 0x67617375u, 0x72203a65u, 0x72693c20u, 0x775f6d6fu, 0x5f64726fu, 0x72646461u,
    0x00000a3eu, 0x6f726920u, 0x6461206du, 0x6d207264u, 0x20747375u, 0x77206562u, 0x2d64726fu, 0x67696c61u,
    0x0a64656eu, 0x00000000u, 0x66657220u, 0x3a657375u, 0x6c656220u, 0x7320776fu, 0x6c6c6568u, 0x78657420u,
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
};

#endif /* PS_APP_IMAGE_APP_IMAGE_H_H */
