fshanhuan/Rsic-v-IM/(commit log)

2026-10-06 chore: 初始导入 v9 处理器核（RV32IM + Cache + 中断 + 分支预测，上板改造版）
    把「v9 上板改造」交付版整理成一个可协作的公开仓库。
    源码（v9/）：
    - RV32IM 五级流水（物理 8 级）：IFU/IDU/EXU/LSU/WBU + Control/Data_hazard
    - ICache / DCache：直接映射，已改为同步存储握手（请求/响应两拍 + hold 停拍重试）
    - CSR.sv：机器模式中断/异常（mie/mip/mtime/mtimecmp、MSIP/MTIP、mret）
    - Branch_Predictor.sv：gshare + 64 项 BTB
    - experimental/MDU_pipelined.sv：时序化乘除单元，已接入 EXU（乘法 1 拍、除法 32 拍迭代）
    - board/：sync_mem（一拍读延迟 BRAM 模型）、reset_sync、board_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
    [改动diff_接管前快照_vs_上板改造后.txt]
2026-10-06 fix(rtl): 修复独立验证发现的 7 个功能缺陷（前递/握手/分支/除法）
    背景：交付时的"回归 103/103 全过"覆盖极窄（3 个程序合计只有 1 条 load、
    0 条字节/半字访存、0 个后向分支循环，且 mul/div 程序的操作数完全相同）。
    用自建 RV32IM 参考模型做差分测试后，在 RTL 里复现出 7 个缺陷，逐个修掉：
    1. lsu/wbu：lb/lh/lbu/lhu 完全丢弃地址低 2 位，永远读第 0 字节。
    两处抽取（LSU 用于前递观察、WBU 用于最终写回）都要按 addr[1:0] 选道
    （半字按 addr[1]），偏移随流水引到 WBU。
    2. dcache：读握手 off-by-one —— hold 在"刚发出读"那一拍就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
    [Control.sv, DCache.sv, Data_hazard.sv, EXU.sv, IFU.sv, LSU.sv, WBU.sv, board_top.sv]
2026-10-06 test(sim): 修正测试台掩盖问题，补 4 个回归程序覆盖已修缺陷
    问题（这三处基础设施缺陷正是上面那些 RTL 问题一直没被发现的原因）：
    1. sim/tb_iverilog.sv 的 DRAM 读口**没有读使能**（每拍无条件采样），
    与 board/sync_mem.sv 的同步 BRAM 语义不符，恰好把 DCache 读握手的
    off-by-one 掩盖掉（整机日志里 DCache hit/miss = 0/0，缓存从没真正参与）。
    → 改为按 perip_ren 门控；板级自检 tb_board_top.sv 用的是真实 BRAM 语义。
    2. sim/tb_dcache_unit.sv **没有 $fatal**：run_all.sh 按 vvp 退出码判定，
    正常结束恒为 0，于是这一项**永远不可能失败**（故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
    [tb_dcache_unit.sv, tb_iverilog.sv]
2026-10-06 docs(syn,docs): 同步文档声明与综合/约束文件的实测不符
    文档（把"已修"的结论写进仓库，并纠正与实测不符的声明）：
    - README.md：回归项数与检查数 7 项/103 → 15 项/239；上板件状态改为
    "板级自检 33/33 PASS（CI 里真正运行）"；新增第二轮修掉的 7 个缺陷对照表
    与 3 处验证基础设施缺陷说明。
    - v9/docs/模块阅读文档.md：新增 §9.2b（第二轮 7 个缺陷的机制要点：
    字节/半字选道口径、DCache 读握手契约、前递仲裁与暂停口径必须一致、
    误预测只能推后不能丢弃、多拍 MDU 握手、"一次发射"、EXU 级前递取 rd_value），
    §11 补上新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
2026-10-06 test(verify): 加入独立差分验证夹具与复核报告
    为什么需要：官方回归 7 项全过不能证明这颗核是对的 —— 它覆盖的是 3 个程序、
    共 1 条 load、0 条字节/半字访存、0 个后向分支循环，且 mul/div 的操作数完全相同，
    于是上面的 7 个缺陷全部落在盲区里。
    内容：
    - .verify/difftest/：自写 RV32IM 汇编器（用 v9/sim/prog.hex 逐条校准过编码）
    + 独立参考模型 + 随机程序生成器 + 自建测试台（以"magic store + 自跳停车"结束，
    避开 ecall 重定向重启程序带来的排空窗口问题）+ 逐寄存器/逐内存字比对；
    另有逐拍探针与"参考轨迹 vs [WB] 事件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
    [compare.py, crosscheck.py, dbg.py, gen.py, mkcases.py, reftrace.py, rv32.py, tb_difftest.sv]
2026-10-06 fix(rtl): 修掉 6 处隐式网络，使设计可在 ModelSim 等严格工具下编译
    问题（第三轮发现）：
    iverilog 对 Verilog 的隐式网络（implicit net）规则完全静默，于是"先用后声明"
    的标识符会被悄悄建成 1 位 wire。接上 ModelSim SE 10.5 后，vlog 当场报出
    5 处 vlog-2730 硬错误，且**不可压制**（-suppress 2730 返回
    "Cannot suppress or change severity level of message number 2730"）—— 也就是
    说：在修掉之前，这份 RTL 在商用工具下一行都跑不起来，而此前所有验证都没发现。
    file:line（首次使用 ← 声明处）：
    myCPU.sv:152 icache_hold / dcache_hold ← 183 / 196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
    [Control.sv, DCache.sv, EXU.sv, IDU.sv, myCPU.sv]
2026-10-06 fix(sim): 测试台 dram 写口改用 always，消除与 initial 的双重驱动
    ModelSim vlog 对 tb_iverilog.sv 与 tb_difftest.sv 报 vlog-7061：
    Variable 'dram' driven in an always_ff block, may not be driven by any
    other process.
    原因：dram 还要在 initial 里清零，而 SV LRM 禁止 always_ff 驱动过的变量再被
    其它进程驱动。
    这一条是 **Error 级**，而且 vlog 虽然打印了 "-- Compiling module tb_difftest"，
    却**拒绝把该模块写入 work 库**，随后 vsim 报：
    ** Error: (vopt-13130) Failed to find design unit tb_difftest.
    现象是"编译日志说编好了、仿真说找不到模块"，很容易被误判成环境或路径问题。
    正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
    [tb_difftest.sv, tb_iverilog.sv]
2026-10-06 test(verify): 新增严格网络检查门禁与 ModelSim 第二仿真器门禁
    1) .verify/netcheck.sh（**门禁 0**）
    把交付目录每个 .sv 顶上插入 `default_nettype none 再编译，把"隐式网络"
    从"静默生成 1 位 wire"变成硬错误。它抓两类问题：
    - 先用后声明：ModelSim 会报 vlog-2730，iverilog 静默放过；
    - 从未声明：被 assign 驱动在 Verilog 里合法，**连 ModelSim 都不报**
    （Control.sv 的 bp_mispredict_raw 就是这样被抓出来的）。
    iverilog 也支持这条指令，因此能进 CI，不依赖商用工具。
    实测 4 个编译集合（核心 RTL+官方回归台 / +差分台 / 板级顶层+自检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
2026-10-06 docs: 补充第三轮（ModelSim 严格性核查）验证记录
    验证报告_独立复核.md：
    - §1.1 更正"本机原本没有任何 EDA 工具"的表述：本机其实装有商用
    ModelSim SE-64 10.5（E:\FPGA\ModelSim_10.5se），前两轮只用了 iverilog；
    - §1.2 验证分层表新增 L4（第二仿真器交叉验证）；
    - 新增 §10「第三轮：接入 ModelSim —— 严格性核查与第二仿真器交叉验证」：
    10.1 动机（iverilog 宽容 vs 商用工具严格）
    10.2 C1-C8 缺陷表（含最需警惕的 EXU.sv 32 位 mdu_res；C8 是门禁 0 抓的、
    ModelSim 反而不报）
    10.3 修法（零逻辑改动）
    10.4 「vlog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
2026-10-06 fix(verify): syncheck.sh 改为活检查，并作为门禁 5 接入
    问题：
    原 syncheck.sh 的文件清单是**硬编码的修复前版本**（读 MDU.sv、不含
    board/*.sv），它实际上是个"复现旧缺陷"的脚本。syn/synth_core.ys 修好之后，
    它仍然照旧打印
    EXU.sv:342: error: Unknown module type: MDU_pipelined
    rc=2
    会让人误以为综合脚本还是坏的 —— 这是验证夹具本身在说反话：
    拿它当"当前状态检查"用会得出与事实相反的结论。
    改法：
    - 默认模式改为**活检查**：用 awk 从当前 syn/synth_core.ys 抽出 read_verilog
    的文件清单（含反斜杠续行），再做三件事：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
2026-10-11 fix(v9): C 系列结构修复 + Quartus/ModelSim 实测与验证材料
    - C2 前递/冒险判定收敛为 Data_hazard 单一裁决源（Control 不再自行判定）
    - C5 WB 前递补 WB_valid，五个前递源口径一致
    - C6 清理 5 个死信号（bp_redir_taken / bp_pend_taken / div_signed_r / store2_addr / store2_tag）
    - C7a mtime 改为带分频的计数器（默认 1MHz 时基），不再"每拍 +1"
    - C4 异常体系（非法指令 / 非对齐访存 / 目标非对齐）判定与 CSR 登记落地，
    由 Control #(.TRAP_ENABLE) 控制，默认关闭
    - B8/B9：board_top 层次化引用改顶层端口、sync_mem 初始化循环越 Quartus 上限
    - 新增 sim/tb_exc.sv、sim/gen_exc_pro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
2026-10-11 docs(v9): 新增客户版产品说明（Word / PDF / Markdown + 配图）
    - docs/产品说明_v9_客户版.md：产品定位、微架构、接口规格（端口/总线时序/地址空间/
    中断）、性能画像（Fmax 78.2MHz、取指 miss 约 20% 周期代价）、资源与器件选型、
    13 项已知缺陷（含影响与规避）、优化路线图、验证复现与测量条件
    - v9_处理器产品说明_客户版.docx（15 页）与 docs/v9_产品说明_预览.pdf
    - figures/v9_arch_overview.png、figures/v9_capacity.png 及生成脚本 docs/gen_product_figs.py
    - docs/md2docx.py：Markdown → Word 生成器
    - README 增加「产品说明（客户版）」章节索引
2026-10-14 feat(v9): ILA 上板工程 + Vivado 2025.2 实测（50MHz 时序收敛，出 bitstream）
    把「真实综合/时序未做」这条已知限制补上：在 Vivado 2025.2 / xc7z020clg484-1
    （依元素 EES-331 教学板）上把 v9 完整跑通综合 + 实现 + bitstream，并改用片内
    ILA 取代「调试信号引到引脚」的方案。
    实测（CPU 时钟 50MHz，工程模式 run 全部 100%）：
    WNS +4.162ns / WHS +0.011ns，失败端点 0 / 27564，TNS=THS=TPWS=0
    Fmax 约 63.14MHz（50MHz 余量约 26%）
    DRC 后布线 0 Error / 0 Critical Warning
    LUT 12677(23.8%) / FF 14190(13.3%) / RAMB36 36.5(26.1%) / DSP48E1 12 / IOB 3
    主要内容：
    - board/board_top_ila.sv（新）上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
2026-10-14 docs(readme): 根 README 补上 Vivado 实测章节，并把「真实综合/时序」从未做改为已完成
    README 原来把「真实综合/时序」和「板级实测」都标成 ⚠️ 未做、并把它列进 roadmap。
    本次已在 Vivado 2025.2 / xc7z020clg484-1（EES-331）上跑通综合 + 实现 + bitstream，
    因此同步更新结论、并新增一节实测数据。
    改动：
    - 开篇状态：补上「已在真实工具链上收敛」一行（50MHz WNS +4.162ns、0 失败端点、
    DRC 0 Error、已出含 ILA 的 bitstream）。
    - 能力与状态表：「真实综合/实现」从 ⚠️ 未做 改为 ✅ 并给出实数；「板级实测」
    保持未做，但注明 bitstream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
2026-10-14 chore: 把厂商文档 EES-331 用户手册移出仓库（仅保留本地参考）
    上一提交把 `v9/参考文献EES331_UserManual_v1.0_1220.pdf`（5.1MB）一并入库了。
    这份 PDF 是依元素科技的厂商资料，而本仓库尚未指定开源许可证（默认版权保留），
    不适合随仓库再分发；README 里本来也没有引用它。
    - 从索引移除该 PDF（本地文件保留，不影响任何脚本——引脚信息早已整理进
    v9/syn/ila_使用说明.md 的引脚表与 v9/vivado_project/v9_board_ila.xdc）。
    - .gitignore 增加该文件名，避免以后 `git add -A` 再把它带进来。
    说明：该文件仍存在于提交 8b99a03 的历史里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
2026-10-14 docs(v9): 清理已废弃方案的文档引用，并说明旧脚本现在跑不通
    上一提交删掉了本地旧产物目录后，文档里还有指向它们的引用。本提交把这些
    引用改成与现状一致的表述，并去掉一份重复文档。
    - 删除 v9/syn/v9_vivado工程README.md —— 它是 v9/vivado_project/README.md 的
    一份过期副本（内容只差目录树与版本沿革两段），保留两份会互相矛盾。
    - v9/vivado_project/README.md 升格为「两份工程目录的说明」：开头说明
    vivado_project/ 是当前方案、syn/ 放综合与时序文档，并列出两个已删除的早期方案。
    目录树补注「这些文件不入库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
2026-10-15 refactor(repo)!: 仓库内容整体替换为 v9 上板工作目录，README 重写
    BREAKING CHANGE: 目录结构变更 —— 原先 v9/ 子目录下的工程，现在就是仓库根目录本身。
    - RTL 由 v9/*.sv 平铺改为 rtl/*.sv（21 个文件，含 MDU_pipelined.sv）
    - v9/vivado_project/ 由根目录 build_project_ila.tcl + verify_project.tcl
    + dump_ila_{csv,prog,b9}.tcl + analyze_ila_*.py 取代
    - v9/syn/ 下的 Vivado 文档迁到 docs/vivado/（新增 ecall重定向故障、上板验证判据）
    - 新增 tools/：注释迭代与验收工具链（strip_sv_comments / check_* / acceptance_report / wsl 官方差分）
    - 新增 reports/，并把 msim/logs 的 ModelSim 验证日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
2026-10-20 feat(v17): 同步当前工作树（CoreMark 2.576、UART 引导 + shell、IROM 双读口）
    - rtl/: 16 个模块更新 —— 分支预测 BTB/PHT 256 + GHR 8、DCache M1 探测口
    （load-use 2 拍->1 拍）、IFU 取指队列、CSR/Zicntr、MDU radix-4 等
    - board/: 新增 sync_mem_dp.sv（2R1W 同 always_ff）、boot_loader.sv、
    uart_rx/uart_tx、reset_sync
    - sim/: 新增 47 个 hex 镜像与 45 个测试台/生成脚本（tb_cm、tb_monitor、
    tb_boot*、tb_sys、tb_exc 等）
    - sw/: 新增 C 工具链（rv32 gcc 13.2）、CoreMark 与 FreeRTOS 移植、
    16 命令交互 shell（monitor.c）、load-and-run（L/D/r）
    - docs/: 新增 v10~v17 检查点与实现说明、C 工具链/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
2026-10-20 refactor(docs)!: 文档合并归档，目录整理
    - docs/: 21 份 → 9 份当前 + 8 份历史归档 + 1 份报告
    - CHECKPOINT_v14 → 开发记录.md；模块阅读文档 → 模块说明.md；
    CPU优化评审_汇总 → CPU优化评审.md；EXECUTE_CONTROL_数据通路分析 → 数据通路分析.md
    - BOOT_UART + ZICNTR_UART + CONSOLE_GPIO → 串口与console.md（内容未删，只合并标题层级）
    - v9~v13 时代 8 份移入 docs/历史/，保留证据链
    - 产品报告统一为 docs/产品报告_v17.docx（旧名 BigBird_RV32_产品报告_v17.docx 退休）
    - docs/README.md 重写为索引：当前文档 / 归档 / 数字的权威来源
    - README：同步工作区版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
2026-11-11 feat(v18+PS): 总线化 A1-A4、软件段、AXI 桥、Zynq PS 接入与双核协同三步
    自 v17 以来的一整轮工作，全部有仿真证据 + 板上实测：
    总线化与地址表
    rtl/soc_map.sv（地址单一来源）、board/soc_bus.sv（译码/片选/回读/写分发）
    rtl/plic_lite.sv（8 源中断控制器）、rtl/clint.sv（标准定时器）
    tools/gen_soc_map.py 生成 sw/soc_map.h + docs/地址表.md，--check 进回归
    软件段
    sw/monitor.c：shell（内存/CSR/FS/断点/加载）、ramdisk 文件系统、run <file>
    sw/{fstest,runtest,snake,snake_play,irqtest,clinttest,pstest}.c
    P0/P1：CoreMark 复测 128.8 iter/s、容器化 run、FS 回收、增量重绘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
